MariusFauteux/EEG-PCB/README.md

# EEG acquisition PCB

Portable eight-channel EEG recorder built around the TI ADS1299, for long-term comparison of PEDOT:PSS and Ag/AgCl electrodes. It records to microSD whilst streaming over BLE to a Mac.

**Status (2026-11-09):** Rev C12: datasheet review of the signal path and REF/BIAS electrode impedance test links (JP9, JP10) added to Step 14: VBUS overvoltage protection drawn, and the 110 × 85 mm four-layer board placed with stack-up, rules, keep-outs and planes. The board is not routed (Step 15). It passes KiCad DRC apart from the expected unrouted connections and a short list of individually accepted warnings, and it matches the schematic exactly. There is no firmware and no physical test. The board is not released for fabrication or for connection to a person.

## Where to start

| If you want to… | Read |
|---|---|
| Understand the design and why it is built this way | [docs/project.md](docs/project.md) |
| See every decision, its status and what would reopen it | [docs/decision_log.md](docs/decision_log.md) |
| Check the detailed calculations and sources for one subsystem | [docs/reviews/](docs/reviews/) |
| Open the schematic or board | [hardware/EEG_RevC.kicad_pro](hardware/EEG_RevC.kicad_pro) in KiCad 10 or later, the SVGs in [hardware/preview/](hardware/preview/), or the placement plots [hardware/checks/pcb_placement_top.pdf](hardware/checks/pcb_placement_top.pdf) and [pcb_inner_planes.pdf](hardware/checks/pcb_inner_planes.pdf) |
| See the parts list and cost | [hardware/bom.csv](hardware/bom.csv), [hardware/bom_cost.csv](hardware/bom_cost.csv) and [hardware/checks/bom_cost.md](hardware/checks/bom_cost.md) |
| See the latest check results | [hardware/checks/validation.md](hardware/checks/validation.md) and [hardware/checks/pcb_report.md](hardware/checks/pcb_report.md) |

## Folder layout

```
README.md                    status, map and open items (this file)
requirements.txt             Python packages for the build and checks
docs/
  project.md                 design guide for the current revision
  decision_log.md            current register, next actions, chronological entries
  recording_format_v1.md     microSD record format specification
  reviews/                   one review per design step (historical records)
hardware/
  EEG_RevC.kicad_pro/.sch    KiCad project; all *.kicad_sch files are generated
  EEG_RevC.kicad_pcb/.kicad_dru  placed board and custom design rules (generated by scripts/pcb_place.py)
  EEG.kicad_sym, sym-lib-table   project symbol library (generated)
  EEG.pretty, fp-lib-table   project footprint library (generated from manufacturer drawings)
  bom.csv                    bill of materials with manufacturer, MPN and description (generated)
  bom_cost.csv               costed BOM for 5 prototype boards (generated)
  controller_pinmap.csv      NINA-B306 pin allocation (generated)
  rebuild.sh                 regenerate everything and run all checks
  scripts/                   schematic generator, part selection, footprint generator, sheet layout and grouping, netlist validation, footprint audit, corner review, BOM cost, input and reference, backfeed, BIAS loop, timing, power and OVP analysis, board placement and DRC summary
  baseline/                  inputs the generator imports, and earlier netlists it compares against
  checks/                    generated: netlist, ERC report, validation report, footprint audit, corner review, BOM cost, analysis output, DRC report, placement report and plots
  preview/                   generated: SVG render of every sheet
host/
  record_format.py           host-side reference codec and recovery scanner for the record format
  test_record_format.py      codec tests
  event_timing.py            EVENT schema validation, session clock fit, event-to-sample mapping
  test_event_timing.py       event timing tests
```

The schematic sheets are generated by `hardware/scripts/build.py`. Edits made by hand in the KiCad editor are overwritten on the next rebuild, so a schematic change belongs in the scripts. A final layout pass (`hardware/scripts/layout.py`) arranges every sheet into dashed frames, one per functional block, each with a title and a short purpose note, and points labels away from the parts. The groups and notes are defined in `hardware/scripts/layout_groups.py`; a new part must be added to a group there or the build fails.

## Rebuilding and checking

One-time setup from this folder:

```bash
python3 -m venv .venv && .venv/bin/pip install -r requirements.txt
```

Then regenerate the schematic, export the netlist, run ERC, render the previews, generate and check the board, and run every check:

```bash
hardware/rebuild.sh
```

The script finds `kicad-cli` on the PATH or in `/Applications/KiCad`; set `KICAD_CLI` to override. The board script needs KiCad's own Python with the `pcbnew` module; set `KICAD_PY` if it is not in the macOS application bundle. A full rebuild takes about four minutes, mostly the board DRC with its creepage check. The footprint audit uses the KiCad 10 stock footprint library (set `KICAD10_FOOTPRINT_DIR` if it is elsewhere). The current result is:

- 486 netlist assertions passing and zero ERC errors;
- the footprint audit passing for all 377 on-board parts;
- 17 of 17 OVP rules and 27 of 27 corner-review rules passing;
- all input, backfeed and power-analysis rules passing;
- 33 of 33 placement rules passing;
- board DRC with no errors, 0 schematic-parity differences, 499 unrouted connections and 30 accepted warnings;
- passing host tests. ERC reports no warnings once KiCad has a global footprint-library table. On a fresh KiCad installation without one, expect a few hundred "the current configuration does not include the footprint library …" warnings; KiCad offers to create the table on first launch of the GUI, and the warnings do not indicate a circuit fault.

## Design history

| Step | Revision | What changed | Review |
|---|---|---|---|
| 1–2 | Rev A, Rev B | Input network, ADS1299 core, battery regulators and supervision | [revB_engineering_review.md](docs/reviews/revB_engineering_review.md) |
| 1–3 (Rev C) | Architecture | Operating modes, NINA-B306 selection, USB-C charging architecture | [revC_architecture_steps1-3.md](docs/reviews/revC_architecture_steps1-3.md) |
| 4 | C1 | LT3045 analogue rail, TPS389001 supervisors, hardware reset gating | [step4_power_review.md](docs/reviews/step4_power_review.md) |
| 5 | C2 | Controller, SWD, USB-C data and CC detection, digital rail | [step5_controller_usb_review.md](docs/reviews/step5_controller_usb_review.md) |
| 6 | C3 | microSD, shutdown behaviour, recording format | [step6_storage_shutdown_review.md](docs/reviews/step6_storage_shutdown_review.md) |
| 7 | C4 | Electrode input protection and filtering | [step7_input_protection_review.md](docs/reviews/step7_input_protection_review.md) |
| 8 | C5 | BIAS loop compensation and output clamp | [step8_bias_review.md](docs/reviews/step8_bias_review.md) |
| 9 | C6 | External 2.048 MHz ADC clock, isolated trigger, photodiode front end, timestamp scheme | [step9_event_timing_review.md](docs/reviews/step9_event_timing_review.md) |
| 10 | C7 | Analogue rail 5.088 V (45.9 mV release margin), restart latch, Schmitt-input reset logic, power capacitor selection | [step10_power_review.md](docs/reviews/step10_power_review.md) |
| 11 | C8 | BQ25798 charger and power path, hardware input ceiling < 500 mA, ship FET soft-off and POWER button, pack connector with NTC, SYS hold-up | [step11_charger_review.md](docs/reviews/step11_charger_review.md) |
| 12 | C9 | OPA376 buffer for the shared REF electrode (coupling −37.3 dB → below −150 dB modelled; SRB1 rejected), self-biased clamp holding +5VA ≤ 1.3 V when off (was up to 6.9 V at 100 V between electrodes) | [step12_reference_backfeed_review.md](docs/reviews/step12_reference_backfeed_review.md) |
| 13 | C10 | Exact MPN for all 360 fitted parts (€188 per board in parts at 5 boards), five project footprints from manufacturer drawings and an automated pin-to-pad audit, shell pads fixed on USB-C and microSD, E96 values for RSET and two supervisor dividers, electrode harness connector J500, whole-netlist corner review | [step13_bom_footprint_review.md](docs/reviews/step13_bom_footprint_review.md) |
| 14 | C11 | VBUS overvoltage switch TPD1S514-1 (trips 5.90–5.99 V in 100 ns, 30 V rated) with a 5.0 V LDO for the module VBUS pad. Board 110 × 85 mm one-sided on the JLC04161H-3313 stack-up, JLCPCB rules and netclasses, antenna and 8 mm trigger keep-outs, planes. All 375 parts placed by a generated script; DRC clean apart from unrouted nets | [step14_ovp_placement_review.md](docs/reviews/step14_ovp_placement_review.md) |
| 14a | C12 | Pin-by-pin datasheet review of the ADS1299, OPA376 and TPD2E2U06 (all pass; LT3045 still unread). JP9 and JP10 let the REF and BIAS electrodes be measured by the ADS1299 lead-off sources through CH8−/CH7− | [revC12_datasheet_impedance_review.md](docs/reviews/revC12_datasheet_impedance_review.md) |
| 15 | (next) | Routing: freeze placement, 90 Ω USB pair, plane vias, converter loops, assembly outputs | |

The reviews are kept as written at each step. They refer to file names used at the time (for example `build_step7.py`, `EEG_RevC_Step7.kicad_sch` and the per-step zip packages). Those names now correspond to `build.py`, `EEG_RevC.kicad_sch` and this folder.

## Open items and release gates

Nothing below has been closed by measurement. The Rev B review findings R01–R12 remain formally open; most are now addressed in the schematic but await physical evidence.

| # | Item | Notes |
|---:|---|---|
| 1 | BIAS loop bench validation | Step 8 compensation is model-based (≥ 47° modelled margin); measure step response, mains rejection and saturation recovery with an electrode simulator. RB1/RB2 and the electrode resistors are ERJ-PB6B thick film (150 V element voltage, Step 13); ESD and surge capability still to be tested |
| 2 | Power and supervision bench validation | Step 10 closed the Step 4 review by calculation: confirm VOUT over temperature, supervisor thresholds, pack-disconnect sequence and the restart latch under battery rebound; DC-bias curves read in Step 13 (C203 + C204 26 µF worst case); capacitance over temperature still to measure |
| 3 | Charger and pack qualification | Step 11 drew the BQ25798 path; pack (2S, protected, 10k 103AT NTC) not chosen; VQFN-HR footprint drawn from TI's land pattern (Step 13, check 1:1 before release); check ship-mode leakage and charging thermals on the bench |
| 4 | Event timing bench validation | Step 9 is datasheet-based: calibrate ADC group delay (assumed 1.5 samples) and input latencies by loopback; confirm the proposed timing targets T1–T3; J600/J601 connectors chosen provisionally (Step 13); trigger isolation adequacy for participant use not assessed |
| 5 | Shared-REF channel coupling | Step 12 buffered REF (D46): modelled coupling below −150 dB. Measure crosstalk, buffer noise and REF lead-off behaviour with an electrode emulator |
| 6 | Powered-off backfeed | Step 12 clamp Q201 (D47): AVDD ≤ 1.3 V modelled up to 100 V between electrodes. Inject in ship mode and with the rail disabled; YJC footprint drawn (Step 13); re-read the LT3045 reverse-current data |
| 7 | Mechanical service interlock | Prevent USB insertion with the electrode harness attached; not designed |
| 8 | BOM and footprints | Closed at design level (Step 13, extended in Step 14): 393 references, 368 fitted with exact MPNs, 0 without footprint; 6 project footprints. Still needed: 1:1 or part comparison of the project footprints (including the 0.4 mm WCSP of U323), estimated heights, and the 4 % of the cost not yet confirmed; C324's MPN is on backorder at DigiKey (in-stock KEMET alternative named in the Step 14 review) |
| 9 | microSD shell pads in KiCad 10 | Closed (Step 13): symbol pin renamed `SH`; the same fault on the USB-C connector was found and fixed |
| 10 | Firmware | No MCU acquisition, BLE or SD firmware; host codec only. Firmware must set BIASREF_INT = 1 when enabling the BIAS amplifier (Step 8) and implement the TIMER3/GPIOTE/PPI capture scheme and EVENT records (Step 9). Restart needs a fresh RUN_REQUEST rising edge, and the last 5 samples before a supervisor stop are invalid (Step 10). Charger: raise IINDPM only after reading the TUSB320 advertisement, set charge and JEITA limits, handle the watchdog, enter ship mode for soft-off (Step 11). Fit JP 2–3 for referential channels with SRB1/SRB2 off, detect REF lead-off from all referential channels drifting together, and wait 1 s after an analogue stop before re-arming (Step 12). Impedance: AC lead-off at 7.8 or 31.2 Hz with 6 or 24 nA, excited channel removed from BIAS_SENS, series resistance subtracted (Rev C12). Run the power I²C bus at 100 kHz unless the layout keeps it below ≈ 70 pF (Step 13) |
| 11 | Routing, prototype and qualification | Board placed (Step 14); routing next (Step 15) under the rules in the Step 14 review, section 8. Then noise, leakage, ESD, endurance, power-loss and safety testing |
| 12 | VBUS overvoltage | Closed at design level (Step 14, D57): TPD1S514-1 limits USB_5V to 6.15 V worst case. Still needed: bench overvoltage and hot-plug test; WCSP assembly check; firmware keeps EN_OTG = 0 |
| 13 | Board area and pack position | Closed (Step 14, D56): 110 × 85 mm, one-sided, courtyards 51 %; pack beside the board on J401. Enclosure still to design |
