MariusFauteux/EEG-PCB/docs/decision_log.md

# EEG PCB decision log

Last updated: 2026-11-08 • Documentation revision 14 • Current schematic and board: Rev C11 (Step 14)

This is the engineering decision record: decisions, supporting rationale, tradeoffs, evidence and conditions for revisiting them. It is maintained alongside [project.md](project.md), which describes the design as it stands. The [README](../README.md) carries the current status and open release gates. Detailed calculations and sources for each step are in [reviews/](reviews/).

## How to maintain this record

At each design milestone, read this log and project.md before changing the project. Update both in the same revision as the affected schematic, firmware or analysis, and rerun `hardware/rebuild.sh`. Give every new decision the next free D number, add it to the current register below and append its detailed entry at the end of the chronological section. Preserve superseded decisions with a replacement reference rather than rewriting historical conclusions. Record measured results separately from calculations. A new component, battery architecture, channel count, safety boundary or acquisition format warrants a new decision entry.

Status meanings: **requirement** = agreed user target; **implemented** = drawn in the current schematic, not physically validated; **provisional** = working choice awaiting evidence; **planned** = selected but not drawn; **open** = undecided; **superseded** = replaced; **policy** = review or documentation rule.

## Current direction

Finish a reliable battery-operated eight-channel acquisition system for long-term electrode research. Rev C6 integrates the ADC with an external clock, protected electrode inputs, a compensated BIAS loop, isolated trigger and photodiode inputs, power and supervision, controller, USB-C, SWD and microSD at schematic level. The deferred Step 4 power review is closed at calculation level (Step 10) the BQ25798 charger, power path and soft-off are drawn (Step 11), the shared REF is buffered and the analogue rail clamped against powered-off backfeed (Step 12), every fitted part has an exact MPN and an audited footprint (Step 13), and VBUS has an overvoltage switch while the 110 × 85 mm four-layer board is placed but not routed (Step 14). Next route the board. Reliability and signal integrity take priority over size or cost.

## Current register

One line per decision, with its status in Rev C12. The detailed entry for each is in the chronological section below.

| ID | Status in Rev C12 | Decision | Superseded by / next evidence |
|---|---|---|---|
| D01 | Requirement | 8 differential channels, 24 bit, 1 kS/s, 0.1–100 Hz analysis band | Revisit only with changed experimental requirement |
| D02 | Implemented | ADS1299IPAGR as the ADC | Measured noise, offset and timing |
| D03 | Implemented, revised | Per-channel bipolar or shared-REF jumper; internal SRB switches off. Shared REF now buffered (D46) | Bench crosstalk test (D46) |
| D04 | Superseded | 2 × 47 kΩ per leg and 220 pF differential | D33 |
| D05 | Implemented | DC-coupled acquisition, digital high-pass, initial gain 12 | Measured electrode offsets and common-mode margin |
| D06 | Partly superseded | Internal 4.5 V reference and internal oscillator | Reference retained; clock replaced by D35 |
| D07 | Superseded (series resistors kept) | BIAS: 1 MΩ ∥ 1.5 nF feedback, 2 × 499 kΩ output | D34 |
| D08 | Superseded (pack kept) | Protected 2S pack, external charging | D23 onboard charging; 2S pack retained |
| D09 | Superseded | TPS7A4901 analogue LDO at 5.086 V | Step 4: LT3045 at 5.050 V |
| D10 | Implemented, revised | TPS62162 3.3 V digital buck | D28: fed from SYS; recheck around BQ25798 |
| D11 | Superseded | TPS3700 UVLO and power-good supervision | Step 4: TPS389001 supervisors |
| D12 | Refined | nRF52840 BLE plus microSD, 24 h simultaneous | D22/D24 module, D29 storage |
| D13 | Provisional | 232-byte BLE packet, 29 kB/s | Peripheral firmware and Mac throughput test |
| D14 | Implemented | Isolated trigger and photodiode timing | D36, D37 |
| D15 | Requirement, revised | 4-layer board, €500 budget, 30 mm height; size now 110 × 85 mm one-sided (D56) | Enclosure design; assembled cost |
| D16 | Requirement | Barebones software; documented binary data, BrainVision/CSV export | Host codec exists; exporters not written |
| D17 | Policy | Keep editable sources, renders, BOM, checks and rationale together | Implemented by `hardware/rebuild.sh` |
| D18 | Policy | Release gates: no fabrication or human use until gates close | See README open items |
| D19 | Implemented | SWD programming and recovery, USB updates after bootloader | Hardware via D24; firmware open |
| D20 | Superseded | Reopen charging scope | D23 |
| D21 | Implemented in part | Record on battery only; service with electrodes disconnected | Mechanical interlock not designed |
| D22 | Implemented | NINA-B306-00B; separate ADC and SD SPI | Land pattern drawn (D51); compare with a module or EVK Gerbers |
| D23 | Implemented | 5 V USB-C sink, TUSB320LAI, BQ25798, 0.5 A at 8.4 V | D42–D45; pack choice and bench charge tests |
| Step 4 | Implemented, review closed by calculation (D38–D41) | LT3045, TPS389001 supervisors, AND-gated reset | Bench validation of D38–D41 |
| D24 | Implemented | Integrate module, SWD and USB pins | Footprint audited (D51); firmware |
| D25 | Implemented | Gate ADC control outputs until power valid | Partial-power behaviour measurement |
| D26 | Implemented | USB-C connector and CC detection before charger | VBUS overvoltage switch added (D57) |
| D27 | Implemented | SERVICE_OK hardware inhibit | Not isolation; interlock unfinished |
| D28 | Superseded in part | 3.3 V from SYS kept; J400 bench input removed | D42 |
| D29 | Implemented | microSD on dedicated SPI (DM3AT socket) | Card MPN qualification; shell pads resolved (D51) |
| D30 | Implemented | Card on shared 3.3 V rail, no load switch | Standby and recovery measurement |
| D31 | Policy | Low-battery shutdown is best effort | Repeated real power cuts |
| D32 | Implemented (host side) | Recoverable 4096-byte records with CRC32 | MCU firmware; 24 h run |
| D33 | Implemented | Input protection: 94 kΩ → TPD2E2U06 → 4.7 kΩ; 220 pF C0G kept. Also used in front of the REF buffer (D46) | ERJ-PB6B parts chosen (D48); leakage, ESD and surge tests |
| D34 | Implemented, provisional | BIAS lead-lag compensation 1 MΩ ∥ (100 kΩ + 10 nF); TPD2E2U06 at RB1/RB2 midpoint; BIASREF_INT = 1 required | Bench step response and mains rejection; RB1/RB2 ERJ-PB6B (D48); rerun model for buffered REF (D46) |
| D35 | Implemented | External 2.048 MHz ±20 ppm ADC clock (SiT8008, Y340); CLKSEL low | 24 h rate log against a reference; ordering code confirmed active (Step 13) |
| D36 | Implemented, provisional | TLP2761 optically isolated trigger; TIA + comparator + I²C DAC photodiode front end | Loopback latency calibration; connector parts; isolation adequacy review |
| D37 | Requirement on firmware | One 16 MHz timer (TIMER3, extended by TIMER4) captures DRDY, trigger and photodiode via GPIOTE/PPI; EVENT schema `event/1` | Firmware implementation; group-delay calibration |
| D38 | Implemented, values revised | Analogue rail 5.088 V (RSET 50.5 kΩ + 383 Ω): 45.9 mV release margin, 47.6 mV below 5.25 V | D49: 49.9 kΩ + 1.00 kΩ, 5.090 V; VOUT over temperature |
| D39 | Implemented, provisional | Collapse: SYS_OK path resets ADC in regulation; ANALOG_OK backstop; last 5 samples invalid | SYS hold-up sized at charger step; pack-disconnect captures |
| D40 | Implemented | Persistent restart latch U226–U228; fault clears RUN_ARMED, restart needs new RUN_REQUEST edge | Rebound test with RUN_REQUEST held high |
| D41 | Implemented | Schmitt-input SN74AUP1G08 gates, 4.7 kΩ pull-ups; power capacitors selected (1210 25 V output, C0G delays) | DC-bias curves read (Step 13); node capacitance ≤ 30 pF in layout |
| D42 | Implemented | BQ25798 single-input (VBUS-only), 2S at 1.5 MHz, D+/D- unconnected, PACK_POS = charger BAT node | VQFN-HR footprint drawn (D51); bench charge cycle |
| D43 | Implemented | ILIM_HIZ hardware input ceiling 0.28–0.46 A; CE disabled unless MCU drives CHARGE_REQUEST | Input current on a 500 mA port |
| D44 | Implemented | CSD17571Q2 ship FET for soft-off; POWER button on QON with BAT54 sense to pad 37 | Ship-mode leakage, wake and 10 s reset |
| D45 | Implemented, provisional | SYS 5 × 22 µF + 100 µF OS-CON (≈ 124 µF effective est.); VBUS bulk now 2 × 10 µF behind the OVP soft start (D57) | DC bias read: 125 µF worst case (Step 13); pack-disconnect captures |
| D46 | Implemented | Buffered shared REF: REF electrode → 2 × 47 kΩ → TPD2E2U06 → 4.7 kΩ → OPA376 follower → JP pin 3; per-channel networks kept; SRB1 not used | Bench crosstalk, noise and REF lead-off tests |
| D47 | Implemented, provisional | +5VA backfeed clamp: CSD17381F4 self-biased from +5VA, 100 Ω drain, released by ANA_ENABLE; firmware waits 1 s before re-arming | YJC footprint drawn (D51); injection test in ship mode; LT3045 reverse data |
| D48 | Implemented | Exact BOM from a few series: Panasonic ERJ-3EKF/ERJ-8ENF (1 %), ERA-3ARB (0.1 %, 10 ppm/K), ERJ-PB6B (0.1 %, 150 V, electrode, REF and BIAS paths); Murata GCM and GRM 25 V; no NRND parts | Price and stock at order time; ESD and surge tests of ERJ-PB6B |
| D49 | Implemented | E96 values where E192 or non-standard values were not orderable: RSET 49.9 kΩ + 1.00 kΩ (5.090 V), ANALOG_OK 31.6 kΩ / 9.88 kΩ, PACK_OK 44.2 kΩ (6.233 V) | Same bench tests as D38 |
| D50 | Implemented | All 10 µF are 1206 25 V and all 22 µF 1210 25 V X7R; effective values from Murata DC-bias curves | Capacitance over temperature on the bench |
| D51 | Implemented | Generated project footprint library (BQ25798 RQM, TUSB320 RWB, CSD17381F4 YJC, CSD17571Q2 DQK, NINA-B306) and an automated pin-to-pad audit; shell pins renamed SH | 1:1 print or part comparison; NINA against a module |
| D52 | Implemented, provisional | Electrode harness connector J500 (keyed 2 × 10 box header, no GND or supply pins); electrode symbols off-board | Harness design; mechanical interlock (D21) |
| D53 | Implemented, provisional | J600 BNC (shell = isolated return), J301/J601 JST PH, J300 SMD SWD header, TL3342 buttons | Mechanical drawings; 8 mm isolation in layout |
| D54 | Closed by D57 | VBUS overvoltage protection: nothing but the charger stopped at > 5.5 V | D57 |
| D55 | Closed by D56 | Board area and pack position: courtyards filled 68 % of one 100 × 70 mm side; pack beside the board | D56 |
| D56 | Implemented | Board 110 × 85 mm, all parts on top, four layers JLC04161H-3313 1.6 mm (signal / GND / power / signal), ENIG, M3 holes at the corners; pack beside the board | Enclosure; 1:1 fit check |
| D57 | Implemented, provisional | VBUS OVP: TPD1S514-1 (5.90–5.99 V, 100 ns, 30 V) between J310 and USB_5V, EN tied low; VBUS_POWER feeds USB sense; TPS7A2050 5.0 V for module VBUS with BAT54 reverse bypass; second 10 µF on VBUS | Bench overvoltage and hot-plug test; WCSP assembly |
| D58 | Implemented, provisional | Floor plan: analogue left (J500 left edge), isolated trigger and microSD top edge, module centred on right edge, USB-C/charger/pack bottom right; In1 GND continuous, In2 +5VA/+3V3/SYS islands in GND | Routing (Step 15); noise and RF tests |
| D59 | Implemented | Design rules and netclasses from JLCPCB multilayer capabilities; 8 mm clearance and creepage rule for the trigger; 90 Ω USB pair (0.15/0.18 mm, estimate) | Confirm impedance with the JLCPCB calculator |
| D60 | Implemented, interim | Board generated by `pcb_place.py` from the netlist (placement, rules, zones), DRC and placement rules in `rebuild.sh`; schematic UUIDs stable | Freeze placement before routing |
| D61 | Implemented, provisional | Electrode impedance test links: JP9 puts the REF electrode on CH8−, JP10 the BIAS electrode on CH7−, each through that channel's own 94 kΩ network; normally open | Bench impedance procedure against an electrode simulator |

The Step 4 decisions were recorded without a D number and are listed by step name.

## Next actions

| Priority | Work | Evidence needed before closing |
|---:|---|---|
| 1 | Route the board (Step 15) | Placement frozen against regeneration (D60); 90 Ω width from the JLCPCB calculator; routing rules in the Step 14 review section 8; DRC with no unrouted nets; 1:1 footprint checks (D51), assembly outputs (Gerbers, drill, position, BOM) |
| 2 | Validate power, supervision and charging on the bench | VOUT over temperature, thresholds, pack-disconnect sequence, restart latch under rebound (D38–D41); charge cycle, input ceiling, ship mode (D42–D45); backfeed clamp and discharge (D47) |
| 2a | Choose the pack and connector | Protected 2S Li-ion with 10k 103AT NTC; charge temperature limits for JEITA settings |
| 3 | Design the mechanical service interlock | Prevent USB insertion with the electrode harness attached |
| 4 | Prototype | Order (`hardware/bom_cost.csv`, confirm estimated prices), assembly, bench bring-up |
| 5 | Qualify acquisition performance | Noise, offset and load tests; REF crosstalk, buffer noise and REF lead-off (D46); BIAS step response and mains rejection; event timing loopback calibration and 24 h clock log; 24 h local plus BLE endurance; power-loss recovery |

## Entry template

### Dxx: descriptive title

- Date and affected revision:
- Status and requirement addressed:
- Decision:
- Concise rationale and evidence:
- Alternatives and material tradeoffs:
- Assumptions and unresolved risks:
- Validation needed / result:
- Revisit trigger:
- Replaces / replaced by:

## Chronological entries

The entries below are preserved as written at each milestone. Where they describe the hardware as it was at that time (for example "drawn in Rev B"), the current register above takes precedence.

### Rev B decision register (D01–D17)

| ID | Status | Decision and rationale | Tradeoff / revisit condition |
|---|---|---|---|
| D01 | Requirement | Eight simultaneous differential channels, 24-bit acquisition at 1 kS/s; 0.1–100 Hz analysis band. Supports electrode comparisons and event-related recordings on a common timebase. | Data rate and energy exceed a slower, fewer-channel system. Revisit only with a changed experimental requirement. |
| D02 | Implemented | ADS1299IPAGR combines simultaneous conversion, programmable gain, reference and BIAS functions. | Integrated features still require correct routing, firmware and characterization. Revisit if measured noise, offsets or timing fail requirements. |
| D03 | Implemented | Independent physical bipolar/shared-REF selection for each negative input; internal SRB switches remain off. | Requires careful jumper configuration. This preserves mixed montages without relying on an all-channel reference switch. Revisit for electronically selectable montages. |
| D04 | Provisional | Two 47 kΩ resistors per input leg and a 220 pF differential capacitor. Provides series impedance and differential filtering. | Approximately 0.558 µV RMS resistor noise over 0.1–100 Hz; electrode impedance changes the filter. This is not finalized transient protection. Select final values after noise, leakage and fault analysis. |
| D05 | Implemented | DC-coupled acquisition; analysis high-pass performed digitally. Retains raw slow changes for research. Initial gain target 12. | Electrode DC offset can saturate the hardware before filtering. Validate offset/common-mode margins; lower gain if necessary. |
| D06 | Provisional | Internal 4.5 V ADC reference and internal oscillator for the first implementation. | Reduces parts but does not provide a calibrated sample clock. Measure drift and reference settling; consider an external clock if ERP timing requires it. |
| D07 | Provisional | BIAS feedback 1 MΩ parallel with 1.5 nF, with two 499 kΩ output resistors. | Electrode/cable loading affects loop stability. Verify on a simulator; resistor values alone do not establish participant safety. |
| D08 | Provisional, implemented | Removable protected 2S battery, external charging; analog LDO and separate digital buck converter. | This is a design assumption introduced in Rev B, not a separately confirmed battery purchase. It gives LDO headroom but adds pack size, diode loss and cutoff constraints. Revisit after energy/fit measurements. |
| D09 | Implemented | TPS7A4901 analog supply: 79.0 kΩ / 24.0 kΩ divider, approximately 5.086 V nominal. | Calculated static corners approximately 4.951–5.221 V; transient headroom still needs measurement. Revisit for overshoot, noise or monitor-threshold problems. |
| D10 | Implemented | TPS62162 fixed 3.3 V digital converter. Reserve a preliminary 500 mA peak board-load budget. | Buck switching and SD current bursts may contaminate EEG. Exact module/card load and compensation behavior remain unverified. |
| D11 | Implemented | TPS3700 supervision: UVLO with added hysteresis, early battery warning and separate analog-power-good. | Nominal thresholds are not qualified limits. Warning voltage does not guarantee enough time to commit a file. Test pack rebound and abrupt disconnects. |
| D12 | Requirement / planned | nRF52840 BLE module plus microSD; simultaneous local recording and streaming for 24 h. | Exact module, antenna clearance and SD device are open. Local recording must not depend on BLE keeping up. |
| D13 | Provisional | Packet proposal: 16-byte header plus eight 27-byte ADC frames = 232 bytes. At 1 kS/s, 29 kB/s. | Requires adequate negotiated notification size and sustained Mac throughput. Receiver parser tested; radio and matching peripheral firmware untested. |
| D14 | Requirement / planned | Isolated trigger input and photodiode timing, primarily for visual ERP. | A software stimulus timestamp does not identify actual screen onset. Barrier parts, latency calibration and event encoding remain open. |
| D15 | Requirement / planned | Four-layer KiCad board, approximate 100 × 70 × 30 mm enclosure; €500 includes VAT, assembly, enclosure and storage, excludes batteries/shipping. | Stack-up, fit, prices and full assembled BOM have not been validated. |
| D16 | Requirement | Barebones setup/test software first; documented binary data with BrainVision/CSV export. | Recording integrity, counters and recovery take precedence over a polished interface. Exporters remain unimplemented. |
| D17 | Implemented documentation policy | Preserve editable native schematics, PDF, BOM, checks and human-readable rationale together. | ERC is evidence of schematic consistency, not proof of correct electronics or safety. |

### Rev B corrections and superseded assumptions

- Rev A was an external analog network. Rev B connects it to the physical ADS1299 pins and battery regulators. Do not describe Rev B as an ADC-free circuit.
- Preliminary analog-rail arithmetic using a 1.194 V figure was replaced by the selected regulator's 1.185 V feedback value. The final divider is **79.0 kΩ / 24.0 kΩ** and nominal output **5.085625 V**. Earlier draft values are not the released Rev B BOM.
- The initial narrow-hysteresis UVLO candidate was replaced by external positive feedback. Current nominal VIN_SYS thresholds are **6.749 V on / 6.212 V off**. These are after the series diode, not battery-terminal thresholds.
- Raw divided battery monitoring at the host was replaced by a 3.3 V-pulled comparator output to avoid placing a battery-derived voltage on an unpowered host ADC input.
- Unused SRB1/2 pins are left open in Rev B, with their switches disabled. BIASIN and unused external BIASREF are grounded.

### Evidence at Rev B

Rev B reports zero KiCad 9.0.2 ERC errors/warnings without exclusions. Exported-netlist tests cover all 64 ADC pin identities and key input, BIAS, decoupling, host, regulator and supervisor connections. Assigned footprints exist; IC pad coverage was checked. The PDF was visually reviewed. BLE packet-parser tests pass.

There is no physical noise, stability, BLE throughput, power, endurance or safety measurement, and no circuit simulation. There is no PCB layout. These limits must remain visible when reporting progress.

### Next decisions at Rev B (historical; see Next actions above)

| Priority | Work | Evidence needed before closing |
|---:|---|---|
| 1 | Choose exact nRF52840 module and SD implementation | Pin allocation, antenna/layout requirements, supply peaks and supported data path |
| 2 | Exercise synthetic BLE traffic on the M2 Mac | Sustained throughput, counters, disconnect behavior; repeat with SD writes |
| 3 | Design isolated trigger and photodiode input | Barrier specification, timing path and measured/calibrated latency plan |
| 4 | Finalize electrode protection and connectors | Leakage/noise/capacitance assessment, fault paths, physical connector selection |
| 5 | Review complete schematic and procurement | Exact BOM, footprint dimensional audit, corner/transient review, cost and mechanical envelope |
| 6 | Layout and prototype | Return-current/antenna review, DRC, assembly outputs, bench bring-up results |
| 7 | Qualify acquisition performance | Noise/offset/load tests, event timing, 24h local+BLE endurance and power-loss recovery |

### Rev B change history

- 2026-11-08: Created the decision register from the delivered Rev A/Rev B design and agreed project targets. No hardware changes in this documentation update.

### Review update, 2026-11-08 (D18–D20)

The [Rev B engineering review](reviews/revB_engineering_review.md) supersedes any interpretation that ERC success establishes fabrication readiness. Hardware is unchanged. Findings R01–R12 remain open.

#### D18: Release gates after critical desk review

- Status: adopted review policy; Rev B remains a subsystem draft.
- Decision: hold fabrication pending complete system integration, analog-supply margin/reverse-discharge resolution, protection review and a complete BOM/footprint audit. Human-connected use additionally requires system safety qualification.
- Evidence: repeated ERC returned zero violations and existing netlist assertions passed; no physical validation exists. Approximate analog high corner is 5.2208 V versus the ADC's 5.25 V operating maximum. U2's OUT−IN absolute maximum is +0.3 V, not guaranteed by the generic D201 choice.
- Closure: address review R01–R12 with design evidence and measured results where required. Existing D17 remains applicable.

#### D19: Programming and USB service architecture

- Status: proposed next revision, not implemented.
- Direction: select the nRF52840 module; add SWD/reset/target-voltage access and a recovery mechanism. Initial programming uses SWD; USB updates require installed bootloader firmware. USB-C is also a candidate configuration interface.
- Rationale: native USB does not remove initial programming and recovery needs. J100 is ADC SPI/control, not USB or SWD.
- Boundary: service/USB/debug with electrodes disconnected unless a separately qualified isolation architecture is developed. Firmware acquisition disable is not galvanic isolation.

#### D20: Reopen charging scope

- Status: open; The existing external-charging baseline remains the drawn hardware.
- Direction: evaluate onboard USB-C charging for a protected 2S pack using a compatible buck-boost charger and source-current detection; PD is optional for higher-power operation. No charger IC or pack has been selected.
- Rationale: the user asked whether USB-C charging is supported. It is absent, and a 5 V connector cannot directly charge an 8.4 V pack. Add temperature sensing, charge control, power-path management and independent cell protection/balancing provisions.
- Tradeoff: more components, heat, switching noise and qualification; a 1S alternative would require redesign of the analog supply. Revisit connector, switch, enclosure, power budget and acquisition/charging operating modes together.

Change history addition: 2026-11-08 — recorded external-style review, release blockers and proposed programming/charging direction. No hardware revision or validation status was advanced.

### D21–D23: Rev C architecture selection, 2026-11-08

Status: selected for implementation; Rev B unchanged. See RevC_Architecture_Steps1-3.md and controller_pinmap.csv.

- D21: Battery recording with all conductive service cables absent; USB charging/configuration and SWD require all electrodes disconnected. Prefer a mechanical service/electrode interlock. Hardware acquisition inhibit is supplemental, not isolation.
- D22: Select NINA-B306-00B. Reserve separate ADC and SD SPI controllers, native USB, SWD recovery and hardware event capture. Manufacturer Table 7 checked for 33 unique GPIO assignments; fast clocks avoid radio-sensitive pads. This refines D12 and D19.
- D23: Select 5 V-only USB-C sink using TUSB320LAI plus BQ25798 and protected 2S pack. Initial charge target 0.5 A at 8.4 V subject to source, pack and temperature limits. No PD/OTG. SYS supplies board loads; charger remains available with recording off. This replaces D20's open architecture choice and D08's external-charging direction for future Rev C, not the existing Rev B circuit. Exact pack/connector and bootstrap/current-limit implementation remain open.
- Evidence: u-blox UBX-17052099 R15; TI SLUSDV2C and SLLSEQ8D retrieved online. Source links, power estimates and remaining implementation gates are in the architecture document.
- User requirement: confirm future component parameters using online manufacturer documentation whenever available; explicitly label unverified assumptions.
- Validation: pin allocation uniqueness checked; no new electrical test or schematic change. Review R01–R12 remains open.

### Step 4: power and supervision, 2026-11-08

A standalone C1 power/supervision replacement module is now drawn, not yet merged into Rev B. See Step4_Power_Review.md in EEG_RevC_Step4_Power.zip. Select LT3045IDD#PBF at 5.050 V and TPS389001DSET voltage supervisors, with hardware AND-gated ADC reset and analog enable. Calculated rail envelope 4.937–5.163 V; nominal pack warning 6.6125 V and analog inhibit 6.1985 V. These supersede D09/D11 for the proposed Rev C circuit, not the preserved Rev B files.

Online manufacturer limits were checked, including full-temperature accuracy and leakage. ERC and selected netlist/static checks pass. Narrow supervisor-release margin, dynamic collapse behavior, restart latching, capacitor/footprint selection, charger/MCU integration and bench testing remain open. D10 digital regulator integration must be revisited around charger SYS. BAT_WARN_OK polarity differs from the former BAT_OK_N; firmware must change. No finding is declared physically verified.

### D24–D28: Step 5 integration, 2026-11-08

Status: drawn and checked at schematic level. Earlier decisions remain historical unless superseded below. Step 4 revisions are deferred at the user's explicit request; acceptance for continuation is not electrical closure.

- **D24 — Integrate controller and debug.** Use NINA-B306-00B with VCC/VCC_IO at 3.3 V, dedicated USB pins and J300 SWD/reset access. Initial programming uses SWD; USB bootloader availability is not assumed. This implements the hardware portion of D19/D22. Manufacturer Table 7 was checked; 35 unique GPIO allocations now include SYS_OK/PACK_OK. The B306 land pattern and antenna keepout remain to be audited; EGP/EAGP are symbolic ground groups.
- **D25 — Gate outgoing ADC controls.** Five SN74LVC1G126 buffers require ANALOG_OK AND DIGITAL_OK AND ANA_ENABLE. ADC-side pulldowns establish low defaults when disabled. Series resistors are provisional damping values, not level shifting. This reduces unintended startup drive; partial-power behavior and timing still require measurement. DOUT/DRDY return directly through series resistors on the shared digital supply domain.
- **D26 — Implement USB connector and source detection before charger.** USB4105-GF-A, TUSB320LAI sink mode, 887 kΩ VBUS detection resistor, TPD2E2U06 ESD arrays and dedicated MCU USB wiring are drawn. CC sink terminations are internal; no duplicate external Rd. The arrays do not provide sustained DC overvoltage/current protection. D23 charger selection remains unchanged but unimplemented. USB VBUS has no connection to SYS or the pack.
- **D27 — Supplement the service boundary with hardware gating.** SERVICE_OK requires USB absent, compatible SWD adapter absent and interlock closed. This feeds the existing Step 4 inhibit. An unpowered USB cable or incompatible probe can escape detection, so physical electrode disconnection remains necessary. No galvanic isolation or persistent fault/restart latch is claimed. The mechanical interlock is unfinished.
- **D28 — Make the power boundary explicit.** Restore the fixed 3.3 V TPS62162 digital converter from SYS and expose a bench-only SYS/PACK-sense/GND header until BQ25798 integration. The converter is enabled from SYS; complete system shutdown is not implemented. USB alone cannot power the board VCC. This is an integration boundary, not a final battery connector or charge solution.

Evidence: KiCad 9.0.2 ERC has zero errors/warnings; 100 exported-netlist checks pass; new sheet renders inspected. The checks validate intended connections, not noise, USB compliance, firmware or safety. Online primary references and exact limitations are in Step5_Controller_USB_Review.md. No bench tests performed.

Release constraints: Step 4 static-release margin, dynamics, restart latching and capacitor qualification remain open. Complete charger/SD/event circuits, protection review, firmware and physical validation are still required. BOM has 256 references, 32 missing footprints and 224 missing exact MPNs; assigned footprints also need audit. Do not close R01–R12 solely from this milestone.

### D29–D32: Step 6 storage and shutdown, 2026-11-08

Status: schematic and requirements implemented; physical qualification and MCU firmware open. See Step6_Storage_Shutdown_Review.md and Recording_Format_v1.md. The original Step 6 scope is storage and shutdown; Step 7 remains input protection/filtering.

- **D29 — Add microSD on dedicated SPI.** Select DM3AT-SF-PEJM5 socket, four 33 Ω series resistors, five 10 kΩ CMD/DAT pull-ups, local bypassing, ESD and card detection. Verify the manufacturer's contact state visually: open absent, closed inserted. Keep the existing MCU pin allocation. Remove R305/R384–R387 placeholders so they cannot conflict with card defaults. A 16 GB Swissbit S-56u is a card qualification candidate, not an approved exact MPN.
- **D30 — Keep card and MCU on the shared digital rail.** No optional load switch in C3; SD_POWER_EN is reserved. This avoids an independently unpowered card I/O domain but costs standby current and software power-cycle capability. Card handling requires power off and electrodes disconnected. Revisit if measured standby power or recovery requirements justify adding an isolated/sequenced switch. Allocate card peak 350 mA and total digital peak 480 mA pending actual measurements/specification.
- **D31 — Treat low-battery shutdown as best effort.** Existing BAT_WARN_OK initiates capture stop and queue draining. No guaranteed minimum flush interval is available; arbitrary disconnect gives 0 ms. Shared digital power remains available after analog inhibit while its source remains valid. Do not mistake decoupling for energy reserve or POWER_HOLD for a connected power latch. Full soft-off and Step 4 hardware restart latching remain open.
- **D32 — Make records independently recoverable.** Use 4096-byte records, 148 frames per full DATA record, session UUID, sample indices, sequences and CRC32. Preallocate fixed-length 1 GiB FAT32 files before capture; recover without relying on a final END record. Reference codec/scanner and synthetic corruption tests are supplied. Filesystem/card mapping failures can still destroy earlier data, so no durability or finite loss bound is claimed. Preserve gap reports with recovered raw frames.

Evidence: online Hirose, Swissbit, TI, Espressif and FatFs author documentation checked; links and assumptions in the review. KiCad ERC zero errors/warnings, 147 assertions passed; all retained Step 5 pin-net assignments preserved. Eight format tests passed, including exhaustive byte-position corruption and record truncation checks. No physical write/current/power-cut/endurance tests or MCU firmware execution performed.

Revisit/closure: qualify exact card MPN/firmware/current and stall behavior; prove RAM scheduling with BLE; measure rail transients and EEG noise; perform repeated real power cuts and a 24 h run. Review experimental tolerance for missing data. Step 4 revisions are still deferred at the user's request. R01/R06/R09 gain implemented storage connections and explicit requirements but are not closed by this desk validation.

### D33: Step 7 input protection (Rev C4), 2026-11-08

**Decision:** retain two 47 kΩ per input leg; add TPD2E2U06DCKR after them and 4.7 kΩ between the clamp and ADC. Retain 220 pF differential capacitors, explicitly C0G 5% 50 V. Keep selectable local-negative/shared REF topology and unchanged BIAS network. Split input drawings into two four-channel sheets and a reference/BIAS sheet.

**Rationale and alternatives:** protection leakage matters at EEG amplitudes. TI specifies 10 nA maximum at 2.5 V; the considered Nexperia alternative's 1 nA headline is typical, with 100 nA maximum at a different 5 V test point. Neither should be treated as leakage-free or guaranteed at every operating bias. The extra resistor increases resistor noise by 2.47% but limits internal ADC clamp current. A 470 pF capacitor was evaluated and rejected because it worsens modeled shared-reference coupling; 220 pF remains provisional pending electrode/cable measurements.

**Evidence:** primary manufacturer datasheets linked in Step7_Input_Protection_Review.md. Reproducible linear estimates in analyze_inputs.py/input_analysis.json. Zero KiCad ERC violations; 276 exported-netlist assertions passed, including retention of other circuits and BIAS topology. Drawings inspected. No hardware tests.

**Open consequences:** leakage drift/noise, high-impedance reference coupling, powered-off backfeeding, pulse-rated resistor selection and assembled ESD qualification prevent release. REF paths sum under faults. No medical safety conformity is established. Step 8 must validate BIAS stability/protection; Step 4 remains deferred, not closed. Charger and final BOM/layout/firmware work remain open.

### Documentation and repository restructure, 2026-11-08

No hardware change. The working folder was reorganised into `docs/`, `hardware/` and `host/`; superseded top-level copies of project.md, decision_log.md and the pin map were removed (each was an earlier subset of the current file). The KiCad project was renamed from EEG_RevC_Step7 to EEG_RevC so that its name does not change with each step, and the build and validation scripts were renamed to `build.py`, `validate.py` and `validate_controller.py`. `validate_step6.py` was removed because `validate.py` contains all of its checks. `hardware/rebuild.sh` now regenerates every output; the rebuilt netlist is identical in connectivity, values and footprints to the Step 7 export, and the BOM and pin map are byte-identical. project.md was rewritten to describe Rev C4 directly rather than through dated updates appended to the Rev B text, and this log gained a current register. The Step 7 entry was numbered D33.

The validation report now states the ERC result actually produced rather than a fixed claim. Running under KiCad 10.0.8 exposed one new finding: the stock microSD footprint names its shell pads `SH`, whereas the schematic symbol uses pin 11, so the shield-to-GND connection would not transfer to a KiCad 10 layout. This is recorded as an open item and flagged by `validate.py`; the schematic is unchanged. The netlist assertion count is 275 rather than 276 because that shell-pad check is now reported as a warning.

### D34: Step 8 BIAS loop compensation and protection (Rev C5), 2026-11-08

- Date and affected revision: 2026-11-08, Rev C5 (`ref_bias` sheet).
- Status and requirement addressed: implemented at schematic level, provisional; closes the design part of D07 and Rev B finding R08, not its measurement.
- Decision: replace the 1 MΩ ∥ 1.5 nF BIAS feedback with 1 MΩ ∥ (100 kΩ + 10 nF C0G) (RFB1, RZB1, CFB1). Keep RB1/RB2 at 2 × 499 kΩ. Add D509 (TPD2E2U06DCKR) from the RB1/RB2 midpoint to GND. Keep BIASREF and BIASIN tied to AVSS and require firmware to set BIASREF_INT = 1 together with PD_BIAS = 1.
- Concise rationale and evidence: a linear model of the whole common-mode loop (`analyze_bias.py`) gives the old network ≈ 14° nominal phase margin and instability in some of 324 swept cases, because the 998 kΩ output resistance drives ≈ 340 pF of input-leg capacitance plus cable and body coupling. The selected network gives ≈ 84° nominal and ≥ 47° in every swept case, with closed-loop peaking ≤ 3.3 dB. TI marks the old values as examples only (SBAS499C Figures 33, 34, 38); §10.1.1 permits BIASREF tied to AVSS.
- Alternatives and material tradeoffs: larger C_F alone (10 nF, 22 nF) left 240–303 cases below 45°. 15 nF or 22 nF with 100 kΩ give more margin but less mains rejection. The chosen network reduces nominal 50 Hz common-mode attenuation from ≈ 32 dB to ≈ 22 dB, and to ≈ 7 dB in the worst swept case. Lowering RB1/RB2 would improve both but raise the fault current limit, so it was not adopted.
- Assumptions and unresolved risks: ADC pin capacitance 20 pF, internal summing resistance 220 or 330 kΩ, amplifier DC gain 100 dB, resistive and equal electrodes, assumed cable and body coupling. Saturation, slew and transient behaviour not modelled. Currents (5.18 µA normal, 10.36 µA one resistor short) not yet assessed against the applicable standard.
- Validation needed / result: bench step response and mains rejection with an electrode simulator; disconnect and recovery; firmware CONFIG3 sequence; ESD qualification of D509, RB1 and RB2. 287 netlist assertions pass; pin-membership comparison confirms no change outside the BIAS network.
- Revisit trigger: measured ringing or instability, inadequate mains rejection with real electrodes, a change in N, cable type or electrode count, or a safety review result.
- Replaces / replaced by: replaces the D07 feedback values.

### D35–D37: Step 9 event timing, ADC clock and event inputs (Rev C6), 2026-11-08

Status: implemented at schematic level; firmware and measurement open. Details, sources and acceptance tests are in [reviews/step9_event_timing_review.md](reviews/step9_event_timing_review.md). Proposed timing targets (to be confirmed against the protocol): T1 event-to-sample alignment ≤ 100 µs; T2 ≤ 100 µs accumulated error over a 1 s epoch at the nominal rate; T3 ≤ 10 s drift per 24 h without external synchronisation.

- **D35: external ADC clock.** Fit Y340, SiTime SIT8008BIF11-33E-2.048000 (±20 ppm including tolerance, first-year ageing and temperature), powered and enabled from +3V3_ADC, driving CLK through 33 Ω; pull CLKSEL to DGND. Rationale: the internal oscillator (±0.5 % at 25 °C, ±2.5 % over temperature, SBAS499C §7.5) gives 5–25 ms error over a 1 s epoch and fails T2 by 50–250 times; the external clock gives ≈ 20 µs and ≈ 1.7 s per 24 h. Correcting the internal clock from DRDY timestamps in every analysis was rejected as fragile. Cost: one part and a few milliamperes on the digital rail (4.5 mA maximum specified at 20 MHz; less at 2.048 MHz, not quantified). Replaces the clock part of D06; addresses Rev B finding R10 at design level.
- **D36: event input circuits.** Trigger: 3.0–5.0 V logic drives a TLP2761 optocoupler LED through 620 Ω with a reverse clamp, so the source needs no isolated supply; 5000 Vrms, 8 mm creepage and clearance, 80 ns maximum delay. Photodiode: passive sensor, TLV9061 transimpedance stage (33 kΩ ∥ 15 pF, ≈ 320 kHz), TLV7011 comparator with ≈ 33 mV hysteresis, threshold from an MCP4725 DAC on the existing power I²C bus (0x60), TIA output also to SAADC AIN2 for calibration. A digital isolator would need an isolated supply on the trigger side; an MCU COMP-based photodiode threshold was not adopted because an external comparator keeps the capture path identical to the trigger and DRDY paths. Risks: isolation adequacy for participant use not assessed, connector parts open, light levels estimated, backlight PWM can create edge bursts.
- **D37: timestamp and synchronisation scheme.** Firmware runs TIMER3 at 16 MHz from the HFXO, extended to 64 bits by TIMER4 counting wrap events through PPI, and captures DRDY, TRIGGER_ISO and PHOTO_EDGE edges through GPIOTE IN channels and PPI. The DRDY count defines the sample index. EVENT records (schema `event/1`) carry the event tick and the surrounding DRDY ticks; `clock_sync` records every 1000 samples allow a session fit of the ADC rate. Analysis maps events with x = k + (t_e − L − t_k)/T + D, where D ≈ 1.5 samples is the derived ADC group delay and L the calibrated input latency. Reference code and seven tests are in `host/event_timing.py`. Replaces the TIMER2 reservation in the Rev C architecture document, because TIMER0–2 have only four capture registers.

Evidence: 310 netlist assertions pass, including a check that no trigger input-side net touches any other net and a pin-membership comparison showing that only the 29 Step 9 parts were added and only R340 changed connection since Step 8. Zero ERC errors. Manufacturer data sheets checked online for ADS1299, SiT8008, TLP2761, BPW34, TLV9061, TLV7011, MCP4725 and NINA-B3. No firmware and no measurements.

### D38–D41: Step 10 power and supervision review closure (Rev C7), 2026-11-08

Status: implemented at schematic level and checked by calculation; nothing measured. Details, tables and sources are in [reviews/step10_power_review.md](reviews/step10_power_review.md). This closes the deferral recorded at Step 4 and repeated in Steps 5–6, but does not close any review finding by measurement.

- **D38: rebalance the analogue rail.** RSET becomes R201 50.5 kΩ + R207 383 Ω (0.1 %, ≤ 10 ppm/K), giving 5.088 V. Rationale: tolerance stacking leaves ≈ 110 mV of the ADS1299's 4.75–5.25 V window for three margins. At 5.050 V the startup margin was 8.5 mV (counting CSET leakage), the fault-detection margin 14 mV and the ceiling margin 87 mV. Equalising startup and ceiling margins gives 45.9 mV and 47.6 mV. Alternatives: a tighter supervisor or regulator (not pursued in this step; the ±2 % SET current dominates the spread); 51.1 kΩ alone (26 mV ceiling margin). Revisit if ADC load, regulator or ADC supply limits change.
- **D39: collapse handling.** The SYS_OK path is intended to remove analogue power and reset the ADC while AVDD is still regulated; this needs SYS to fall at ≤ 3.0 mV/µs, i.e. ≥ 24 µF effective at average load and ≈ 127 µF at peak digital load. The ANALOG_OK path is the backstop and can let AVDD reach 4.5–4.74 V for tens of µs before reset. Accepted with a data rule: the last 5 samples before a supervisor stop are invalid. The SYS capacitance requirement passes to the charger step.
- **D40: persistent restart latch.** U227 SN74LVC1G74 (D and PRE̅ high, CLK = RUN_REQUEST, CLR̅ = RUN_PERMIT = POWER_OK · SERVICE_OK) and U228 make ANA_ENABLE = SYS_OK · PACK_OK · SERVICE_OK · RUN_REQUEST · RUN_ARMED. Rationale: 0.6 % supervisor hysteresis (≈ 36 mV at the pack threshold) cannot ride through battery rebound, and a firmware-only latch fails if the MCU misbehaves. USB insertion or interlock opening now also needs explicit re-arming. RUN_REQUEST must be driven directly (≤ 10 ns/V edges).
- **D41: reset-logic edges and power capacitors.** New finding: 100 kΩ open-drain pull-ups gave 0.8–2.5 µs/V edges into gates specified for ≤ 10 ns/V. All 2-input gates become SN74AUP1G08 (Schmitt inputs, ≤ 200 ns/V, pin-compatible). Supervisor pull-ups and the SWD/interlock defaults become 4.7 kΩ (≤ 118 ns/V at 30 pF, costing 0.70 mA per asserted monitor). Capacitors: C203/C204 GRM32ER71E226KE15L (22 µF 25 V X7R 1210, replacing 16 V 0805), C201 GRM21BR71C475KE51L, C0G release-delay capacitors (GRM31C5C1H104JA01L, GRM1885C1H103JA01D). Effective capacitance still to be read from DC-bias curves.

Evidence: 348 netlist assertions pass, zero ERC errors. A pin-membership comparison with the Step 9 netlist shows that only the eight Step 10 parts were added and only R201 pin 2 and U221 pin 1 changed connection. `analyze_power.py` passes all five rules. The LT3045 limits are those recorded at Step 4; the data sheet could not be re-downloaded during this step.

### Schematic readability pass, 2026-11-08

No circuit change. A layout pass (`hardware/scripts/layout.py`, groups in `layout_groups.py`) now runs at the end of every build. It places each sheet's parts in dashed frames, one per functional block, each with a title and a purpose note; replaces the free-floating sheet texts with a curated heading and a "Sheet notes" frame, removing statements made stale by Step 10; points labels away from parts so they no longer overlap pins or bodies; and moves capacitor values beside their symbols instead of across them. The root sheet groups the 15 sub-sheets into acquisition, power and controller columns. Parts move only as rigid connected units on the 1.27 mm grid. The exported netlist was compared before and after the pass: all 230 nets have identical pin membership and names. The ADC core and both input sheets use A2 paper; all other sheets stay on A3.

### D42–D45: Step 11 charger, power path and soft-off (Rev C8), 2026-11-08

Status: implemented at schematic level and checked by calculation; nothing measured. Details and sources are in [reviews/step11_charger_review.md](reviews/step11_charger_review.md). Implements D23 and retires the J400 bench input from D28.

- **D42: charger configuration.** BQ25798RQMR in the TI "VBUS input only" configuration (VAC1/VAC2 to VBUS, ACDRV1/2 to GND), PROG 6.04 kΩ (2S, 1.5 MHz, 1.0 µH), D+/D- unconnected because USB data belongs to the MCU, I²C on the power bus at 0x6B, INT to CHARGER_INT_N, STAT to a charge LED powered from REGN. SYS feeds the existing regulators; PACK_POS is now the charger BAT node behind the ship FET. Rationale: on battery the converter is idle and the pack reaches SYS through the 11 mΩ battery FET, so charger switching coincides only with USB service, when electrodes are already disconnected (D21). Alternatives: 750 kHz/2.2 µH (more efficient; not needed for 0.5 A charging).
- **D43: safe defaults without firmware.** ILIM_HIZ = REGN × 10/37 gives an input ceiling of 0.37 A nominal, 0.28–0.46 A over REGN and resistor corners, below the 500 mA USB default; firmware lifts it (EN_EXTILIM = 0) only after reading the TUSB320 advertisement, and any register reset restores it. CE is pulled to REGN and pulled low only by Q401 while the MCU drives CHARGE_REQUEST. Rationale: without D+/D- the charger's own detection could select 3 A; the architecture requires charging to stay off until checks pass.
- **D44: soft-off.** CSD17571Q2 ship FET between BAT and the pack, source on the charger side, gate on SDRV; firmware enters ship mode (SDRV_CTRL = 10). POWER button on QON (1 s wake, 10 s system reset), sensed by the MCU through a BAT54 on pad 37 (POWER_HOLD repurposed as POWER_BUTTON_N; R381 removed). Pack drain in ship mode ≤ 17 µA; supervisor dividers are behind the FET. Rationale: D28 recorded that complete shutdown was not implemented; ship mode provides it with two parts.
- **D45: capacitance.** SYS: 5 × 22 µF 25 V X7R 1210 + 100 µF 16 V OS-CON + 100 nF, about 124 µF effective (assumed 40 % ceramic retention), meeting D39's average-load requirement five times over and ≈ 98 % of the peak-load target. VBUS: one 10 µF + 100 nF instead of TI's two, so total VBUS bulk with C321 stays near the USB Type-C 10 µF sink limit (TI minimum 2 µF effective). PMID 3 × 10 µF, BAT 2 × 10 µF per TI.

Evidence: 387 netlist assertions pass, zero ERC errors or warnings. A pin-membership comparison with the Step 10 netlist shows that only the 35 charger, pack and button parts were added, only J400 and R381 were removed, and every other connection is unchanged. `analyze_power.py` passes all nine rules, including four new charger rules. Assumptions to replace with data: ceramic DC-bias retention, OS-CON leakage, Q400 gate enhancement from the 100 nA SDRV pump, BQ25798 footprint, pack and connector.

### D46–D47: Step 12 reference distribution and powered-off backfeed (Rev C9), 2026-11-08

Status: implemented at schematic level and checked by calculation; nothing measured. Details, tables and sources are in [reviews/step12_reference_backfeed_review.md](reviews/step12_reference_backfeed_review.md). Closes README open items 5 and 6 at design level.

- **D46: buffered shared REF.** The REF electrode drives only U500, an OPA376 unity follower on +5VA, through its own 2 × 47 kΩ, TPD2E2U06 (D510) and 4.7 kΩ. The output REF_BUF feeds pin 3 of JP1–JP8, and each channel keeps its own 94 kΩ / clamp / 4.7 kΩ after the jumper. Rationale: with a passive shared REF, eight channels on a 100 kΩ electrode couple at −37.3 dB at 100 Hz (−20.7 dB at 1 MΩ), which biases cross-channel comparisons between electrode types and grows with the REF impedance being studied. The buffer removes the shared impedance (modelled −157 dB, limited by assumed copper resistance), cuts the DC current through the REF electrode from up to 82 nA to 10 nA, and lowers 50 Hz common-mode conversion by about 17 dB with eight channels on REF. Cost: 0.44 µV rms more common noise on a 100 kΩ REF (mostly the protection resistors), about 0.95 mA maximum and the loss of ADC lead-off detection on REF, which firmware must replace. Alternatives: the ADS1299 SRB1 route (−31.5 dB, worse than passive, and all channels switch together); bipolar only (kept as a per-channel option, but loses the referential montage); removing C_diff (rejected: depends on an unvalidated pin model and removes the RF filter); OPA388 zero-drift (rejected: 35× the bias current, 50× the current noise, chopper artefacts). Revises D03.
- **D47: +5VA backfeed clamp.** Q201 (CSD17381F4) sinks +5VA through R208 100 Ω; its gate is pulled to +5VA by R209 1 MΩ and grounded by Q202 while ANA_ENABLE is high. Rationale: with the rail off, half-cell potentials, offsets and current-limited instruments raise AVDD by at most 0.14 V, but a stimulator-class source of 30 V between electrodes lifts it to 4.4 V in Rev C8, and 100 V to 6.9 V, beyond the ADS1299's 5.5 V absolute maximum. With the clamp, AVDD stays ≤ 1.31 V in every modelled case, and IC pin currents stay ≤ 0.54 mA. The clamp needs no supply, so it works in ship mode, and it also discharges +5VA to 0.3 V in 0.33 s after a stop. Cost: 5 µA while running, four parts and a FemtoFET footprint to draw. Alternatives: a lower bleeder (5 mA continuous), series diodes (leakage and noise in every leg), a Zener on the rail (does not stop partial powering), a load switch with discharge (inactive when unpowered). The isolated trigger has no galvanic path to +5VA (0.4 pF, ≥ 10¹² Ω). Firmware must wait 1 s after a stop before re-arming.

Evidence: 408 netlist assertions pass, zero ERC errors or warnings. A pin-membership comparison with the Step 11 netlist shows that only the 11 Step 12 parts were added, nothing was removed and only JP1–JP8 pin 3 and JREF1 changed connection. `analyze_inputs.py` (six rules) and the new `analyze_backfeed.py` (six rules) pass. Assumptions to replace with data: LT3045 reverse behaviour (data sheet not re-read), input clamp-diode characteristics (not specified), OPA376 open-loop output resistance, CSD17381F4 subthreshold slope and cold threshold, and the illustrative stimulator and instrument source values.

### D48–D55: Step 13 pre-layout review, exact BOM and footprint audit (Rev C10), 2026-11-08

Status: implemented at schematic level and checked by script; nothing built or measured. Details, findings F01–F20 and sources are in [reviews/step13_bom_footprint_review.md](reviews/step13_bom_footprint_review.md). Closes README open items 8 and 9 and the footprint parts of items 3 and 6 at design level.

- **D48: part families.** Every fitted part has a manufacturer, MPN and description in `hardware/bom.csv`, set by `scripts/bom_parts.py`. Resistors: Panasonic ERJ-3EKF (0603, 1 %), ERJ-8ENF (1206), ERA-3ARB (0603, 0.1 %, ±10 ppm/K, E24/E96 1 k–100 k), ERJ-PB6B (0805, 0.1 %, thick film, 150 V element voltage) for every electrode, REF and BIAS series resistor and the BIAS feedback. Capacitors: Murata GCM for the small parts and GRM 1206/1210 25 V for bulk. Rationale: few lines and shared price breaks; thick film for pulse-exposed resistors where thin film has a lower element voltage; Murata marks several previous GRM choices as "to be discontinued" or NRND. Price for 5 boards: €937.64 parts only (88 % from prices read for the exact MPN). TLV7011IDCKR (not orderable) became TLV7011DCKR; XFL4020 codes became -MEC.
- **D49: orderable precision values.** 50.5 kΩ and 32.0 kΩ are E192 and 43.9 kΩ is in no series; ERA-3ARB offers E192 only on request. RSET becomes 49.9 kΩ + 1.00 kΩ (5.090 V), ANALOG_OK 31.6 kΩ / 9.88 kΩ, PACK_OK 44.2 kΩ. Release margin 49.6 mV (was 45.9), ceiling margin 45.8 mV (47.6), ANALOG_OK assertion 12.2 mV above 4.75 V (14.0); all `analyze_power.py` rules pass. Alternative: series pairs for exact values (more parts, new nets); special-order E192 (minimum orders far above 5 boards). Revises the D38 values, not its rationale.
- **D50: bulk capacitors.** C202, C240, C300 (10 µF) and C241, C420 (22 µF) join the 1206 and 1210 25 V parts already used on SYS and +5VA. Murata curves give C203 + C204 26 µF worst case at 5.25 V (≥ 10 µF needed), C121 14 µF at 4.5 V, SYS 125 µF worst case (Step 11 estimate 124 µF on an assumed 40 % retention; measured curve 53 %), VBUS bulk 8.7 µF (≤ 10 µF). Generic 100 nF move from 0805 to 0603.
- **D51: footprints.** `scripts/footprints.py` generates `hardware/EEG.pretty` from the manufacturer drawings; `scripts/check_footprints.py` requires every symbol pin to have a pad and every numbered pad a pin, for all 367 on-board parts. This found two further shell-pad mismatches (USB-C `S1`/`SH`, microSD `11`/`SH`) and the stock DQK footprint leaving Q400's exposed drain and source unconnected. Shell pins are now named `SH`; Q400 uses a project footprint with the exposed pads numbered 1 and 4. KiCad 10 or later is required.
- **D52: electrode connector.** One keyed 2 × 10 box header (Würth 61202021621): pins 1–16 CH1+ to CH8−, 17 REF, 18 BIAS, 19–20 unconnected. The electrode symbols remain as off-board leads, so no existing connection changed. Rationale: 18 touch-proof sockets do not fit a 100 mm edge, and a single harness plug suits the mechanical interlock (D21). Provisional until the harness and enclosure are designed.
- **D53: remaining connectors and switches.** J600 Amphenol 031-6575 with a 4-pin symbol so all shell pads join the isolated return; J301 and J601 JST S2B-PH-K-S; J300 CNC Tech 3220-10-0300-00 (SMD); SW300–SW302 TL3342F160QG as SW400. Provisional.
- **D54: VBUS overvoltage (open).** The BQ25798 stops at 26 V by default, but D312 (breakdown 6.5–8.5 V), the USB-sense inverter (absolute maximum reached at 7.15 V) and the module VBUS pad see the source directly. Add an OVP switch at J310 before layout.
- **D55: mechanical fit (open).** Courtyards sum to 4743 mm², 68 % of one side; with routing, isolation and antenna margins one side of 100 × 70 mm is not enough. Options: passives on the bottom side or ≈ 110 × 85 mm. Tallest parts ≈ 12.5 mm (BNC, estimated); a cylindrical 2S pack must sit beside the board to stay within 30 mm.

Evidence: 441 netlist assertions pass (408 at Step 12), zero ERC errors or warnings. A pin-membership comparison with the Step 12 netlist shows that only J500 was added and only J600 pins 3–4 are new; the shell pins compare unchanged under their new names; all 1082 retained pin connections are unchanged. The footprint audit and 26 corner rules pass. Assumptions to replace with data: estimated heights and prices, LT3045 footprint against a current ADI drawing, ERJ-PB6B pulse capability, capacitance over temperature.

### D56–D60: Step 14 VBUS overvoltage protection, floor plan and placement (Rev C11), 2026-11-08

Status: drawn, placed and checked by script; not routed, built or measured. Details, calculations and sources are in [reviews/step14_ovp_placement_review.md](reviews/step14_ovp_placement_review.md). Closes D54 and D55; revises D15.

- **D56: board size and stack-up.** At the user's decision the board grows to 110 × 85 mm with every part on the top side; courtyards fill 51 % of one side (68 % of 100 × 70 at Step 13), leaving room for the 8 mm trigger barrier, the antenna clearance and routing. The pack sits beside the board on J401 (bottom edge). Stack-up JLCPCB JLC04161H-3313, 1.6 mm: F.Cu, 0.0994 mm 3313 prepreg, In1 GND, 1.265 mm core, In2 power, 0.0994 mm prepreg, B.Cu; ENIG because the WCSP lands are 0.225 mm. The thin prepreg keeps return loops short and makes a 90 Ω pair 0.15/0.18 mm. Alternatives: passives on the bottom of 100 × 70 mm (two-sided assembly, harder rework and probing); 7628 prepreg (wider USB pair, looser coupling). D15's four layers, €500 budget and 30 mm height stand; its 100 × 70 mm is superseded.
- **D57: VBUS overvoltage protection.** TPD1S514-1 between the USB-C VBUS contacts (new net VBUS_CON) and USB_5V: trip 5.90–5.99 V, off within 100 ns, 30 V DC and 100 V surge on the connector side, 39/50 mΩ, 20 ms delay and 3.5 ms soft start at plug-in, EN tied low. USB_5V peaks at 6.15 V in the worst modelled step (L ≥ 100 nH assumed), under every downstream limit. The USB-sense divider now runs from the TPD1S514 VBUS_POWER output, so USB_ABSENT falls even while the switch blocks a faulty source; the TUSB320 detect resistor moves to the connector side. Because the nRF52840 VBUS pin is rated 5.5 V (5.8 V absolute) and the OVP ceiling is 5.99 V, module pad 31 gets its own TPS7A2050 (5.0 V ±1.5 %), with a BAT54 carrying its reverse discharge after unplug. With the bulk behind the soft start, VBUS gets TI's recommended 2 × 10 µF (C401 added); the source sees only C324 (1 µF) at attach, and inrush is 69 mA. The TPD4S014 was rejected (6.45 V maximum trip, 11 µs typical response). Firmware: keep EN_OTG = 0, optionally VAC_OVP = 7 V, cap IINDPM at the 1.5 A level.
- **D58: floor plan.** Analogue zone on the left: J500 on the left edge, eight channel bands in CH1-at-bottom order matching J500 and the ADS1299 pins, JP pin 3 as a vertical REF_BUF bus, REF buffer and BIAS above, LT3045 below the ADC facing the power zone. Isolated trigger BNC on the top edge with an 8 mm U-shaped barrier rule area and a 1.2 mm slot under U600; photodiode top-left. Digital logic, microSD and buttons on the top half; module centred on the right edge with its antenna outwards (u-blox 3.3.3); USB-C, OVP, charger, SYS hold-up and pack bottom right, with the charger hot loop ≥ 15 mm from the ADC and the BQ25798 rotated so its switch-node row faces L400. In1 is continuous GND; In2 carries +5VA, +3V3 and SYS islands in a GND fill.
- **D59: rules.** Netclasses Power (0.8 mm), Supply (0.4 mm), USB_90R, Analog_in (0.3 mm to other classes) and Trigger_iso (8 mm clearance and creepage to every other net); minima from JLCPCB's multilayer capabilities (0.10 mm track and space, 0.25/0.5 mm vias, 0.3 mm to edges). Two land-pattern exceptions are written as named rules: 0.09 mm pad spacing inside footprints and 0.19 mm peg clearance on the GCT USB-C pattern. Designators sit on F.Fab; the silkscreen carries outlines and connector labels.
- **D60: generated board.** `scripts/pcb_place.py` builds the board from the netlist under KiCad's Python, with footprint paths from the schematic so "Update PCB from Schematic" matches every part; schematic sheet and symbol UUIDs are now derived from names so the paths are stable. `rebuild.sh` runs placement, DRC (zones refilled with the project rules) and `check_pcb.py`, and plots the top side and the inner planes. Interim: before routing, the script must stop overwriting the board.

Evidence: 477 netlist assertions (441 at Step 13); the Step 13 comparison shows only the eight new parts added and eight pins moved off USB_5V, with 1096 other pin connections unchanged. ERC 0/0; footprint audit pass (375 parts); 17 OVP rules, 27 corner rules and 33 placement rules pass; KiCad DRC has no errors, 499 unrouted connections and 30 individually accepted warnings (isolated In2/plane copper before vias, silk at edge connectors and the isolation slot). Assumptions to replace with data: OVP threshold drift and hot on-resistance, soft-start minimum, cable inductance, 90 Ω width, BNC body position.

### D61: Rev C12 datasheet review and electrode impedance test links, 2026-11-09

Status: drawn, placed and checked by script; nothing measured. Details, the pin-by-pin datasheet tables and the measurement procedure are in [reviews/revC12_datasheet_impedance_review.md](reviews/revC12_datasheet_impedance_review.md).

- **Review.** The ADS1299 (TI SBAS499C), OPA376 (SBOS406G) and TPD2E2U06 (SLLSEG9C) connections were checked pin by pin: every pin and every bypass value meets the data sheets. The LT3045 data sheet could not be downloaded again; its DFN-10 pinout remains to be confirmed. The series protection resistors set the board's own noise floor (≈ 0.57 µV rms against ≈ 0.2 µV for the ADC over 0.1–100 Hz); kept as the fault-current trade.
- **D61: impedance test links.** The ADS1299 lead-off sources act only on INxP/INxN, so the REF electrode (on the OPA376 only) and the BIAS electrode (on RB2 only) could not be measured. JP9 (REF_RAW to E8N) and JP10 (BIAS_ELEC to E7N) are normally open 1 × 2 headers on the electrode side of JP8/JP7: with the channel jumper at 1–2 and no CH− electrode fitted, the REF or BIAS electrode is measured through that channel's own 94 kΩ / clamp / 4.7 kΩ. No shunt combination joins REF_RAW to REF_BUF or bypasses a 94 kΩ network. BIASIN was considered and rejected: it can be digitised but not excited. Rationale: REF and BIAS contact quality affects every channel and the electrode comparison, and the cost is two headers.

Evidence: 486 netlist assertions (477 at Step 14), including a Step 14 netlist comparison showing only JP9 and JP10 added and every existing net unchanged apart from the four link pins; ERC 0/0; footprint audit pass (377 parts); DRC parity 0 differences, 0 items not accepted, 33 of 33 placement rules.
