MariusFauteux/EEG-PCB/hardware/bom.csv

Ref | Value | Footprint | Manufacturer | MPN | Description | DNP | Population
C1 | 220p C0G 5% 50V | Capacitor_SMD:C_0603_1608Metric | Murata | GCM1885C1H221JA16D | Capacitor 220 pF 5 % 50 V C0G 0603 | no | FIT
C2 | 220p C0G 5% 50V | Capacitor_SMD:C_0603_1608Metric | Murata | GCM1885C1H221JA16D | Capacitor 220 pF 5 % 50 V C0G 0603 | no | FIT
C3 | 220p C0G 5% 50V | Capacitor_SMD:C_0603_1608Metric | Murata | GCM1885C1H221JA16D | Capacitor 220 pF 5 % 50 V C0G 0603 | no | FIT
C4 | 220p C0G 5% 50V | Capacitor_SMD:C_0603_1608Metric | Murata | GCM1885C1H221JA16D | Capacitor 220 pF 5 % 50 V C0G 0603 | no | FIT
C5 | 220p C0G 5% 50V | Capacitor_SMD:C_0603_1608Metric | Murata | GCM1885C1H221JA16D | Capacitor 220 pF 5 % 50 V C0G 0603 | no | FIT
C6 | 220p C0G 5% 50V | Capacitor_SMD:C_0603_1608Metric | Murata | GCM1885C1H221JA16D | Capacitor 220 pF 5 % 50 V C0G 0603 | no | FIT
C7 | 220p C0G 5% 50V | Capacitor_SMD:C_0603_1608Metric | Murata | GCM1885C1H221JA16D | Capacitor 220 pF 5 % 50 V C0G 0603 | no | FIT
C8 | 220p C0G 5% 50V | Capacitor_SMD:C_0603_1608Metric | Murata | GCM1885C1H221JA16D | Capacitor 220 pF 5 % 50 V C0G 0603 | no | FIT
C100 | 1u 10V X7R | Capacitor_SMD:C_0805_2012Metric | Murata | GCM21BR71E105KA56L | Capacitor 1 uF 10 % 25 V X7R 0805 | no | FIT
C101 | 100n 16V X7R | Capacitor_SMD:C_0603_1608Metric | Murata | GCM188R71H104KA57D | Capacitor 100 nF 10 % 50 V X7R 0603 | no | FIT
C102 | 1u 10V X7R | Capacitor_SMD:C_0805_2012Metric | Murata | GCM21BR71E105KA56L | Capacitor 1 uF 10 % 25 V X7R 0805 | no | FIT
C103 | 100n 16V X7R | Capacitor_SMD:C_0603_1608Metric | Murata | GCM188R71H104KA57D | Capacitor 100 nF 10 % 50 V X7R 0603 | no | FIT
C104 | 1u 10V X7R | Capacitor_SMD:C_0805_2012Metric | Murata | GCM21BR71E105KA56L | Capacitor 1 uF 10 % 25 V X7R 0805 | no | FIT
C105 | 100n 16V X7R | Capacitor_SMD:C_0603_1608Metric | Murata | GCM188R71H104KA57D | Capacitor 100 nF 10 % 50 V X7R 0603 | no | FIT
C106 | 1u 10V X7R | Capacitor_SMD:C_0805_2012Metric | Murata | GCM21BR71E105KA56L | Capacitor 1 uF 10 % 25 V X7R 0805 | no | FIT
C107 | 100n 16V X7R | Capacitor_SMD:C_0603_1608Metric | Murata | GCM188R71H104KA57D | Capacitor 100 nF 10 % 50 V X7R 0603 | no | FIT
C108 | 1u 10V X7R | Capacitor_SMD:C_0805_2012Metric | Murata | GCM21BR71E105KA56L | Capacitor 1 uF 10 % 25 V X7R 0805 | no | FIT
C109 | 100n 16V X7R | Capacitor_SMD:C_0603_1608Metric | Murata | GCM188R71H104KA57D | Capacitor 100 nF 10 % 50 V X7R 0603 | no | FIT
C110 | 1u 10V X7R | Capacitor_SMD:C_0805_2012Metric | Murata | GCM21BR71E105KA56L | Capacitor 1 uF 10 % 25 V X7R 0805 | no | FIT
C111 | 100n 16V X7R | Capacitor_SMD:C_0603_1608Metric | Murata | GCM188R71H104KA57D | Capacitor 100 nF 10 % 50 V X7R 0603 | no | FIT
C112 | 1u 10V X7R | Capacitor_SMD:C_0805_2012Metric | Murata | GCM21BR71E105KA56L | Capacitor 1 uF 10 % 25 V X7R 0805 | no | FIT
C113 | 100n 16V X7R | Capacitor_SMD:C_0603_1608Metric | Murata | GCM188R71H104KA57D | Capacitor 100 nF 10 % 50 V X7R 0603 | no | FIT
C114 | 1u 10V X7R | Capacitor_SMD:C_0805_2012Metric | Murata | GCM21BR71E105KA56L | Capacitor 1 uF 10 % 25 V X7R 0805 | no | FIT
C115 | 100n 16V X7R | Capacitor_SMD:C_0603_1608Metric | Murata | GCM188R71H104KA57D | Capacitor 100 nF 10 % 50 V X7R 0603 | no | FIT
C116 | 100u 10V tantalum | Capacitor_Tantalum_SMD:CP_EIA-7343-31_Kemet-D | KEMET | T491D107K010AT | Capacitor tantalum 100 uF 10 V 10 % case D 7343-31 | no | FIT
C117 | 1u 10V X7R | Capacitor_SMD:C_0805_2012Metric | Murata | GCM21BR71E105KA56L | Capacitor 1 uF 10 % 25 V X7R 0805 | no | FIT
C118 | 1u 10V X7R | Capacitor_SMD:C_0805_2012Metric | Murata | GCM21BR71E105KA56L | Capacitor 1 uF 10 % 25 V X7R 0805 | no | FIT
C119 | 100n 16V | Capacitor_SMD:C_0603_1608Metric | Murata | GCM188R71H104KA57D | Capacitor 100 nF 10 % 50 V X7R 0603 | no | FIT
C120 | 1u 10V X7R | Capacitor_SMD:C_0805_2012Metric | Murata | GCM21BR71E105KA56L | Capacitor 1 uF 10 % 25 V X7R 0805 | no | FIT
C121 | 22u 10V X7R | Capacitor_SMD:C_1210_3225Metric | Murata | GRM32ER71E226KE15L | Capacitor 22 uF 10 % 25 V X7R 1210 | no | FIT
C122 | 100n 16V | Capacitor_SMD:C_0603_1608Metric | Murata | GCM188R71H104KA57D | Capacitor 100 nF 10 % 50 V X7R 0603 | no | FIT
C123 | 10u 10V X7R | Capacitor_SMD:C_1206_3216Metric | Murata | GRM31CR71E106KA12L | Capacitor 10 uF 10 % 25 V X7R 1206 | no | FIT
C124 | 10u 10V X7R | Capacitor_SMD:C_1206_3216Metric | Murata | GRM31CR71E106KA12L | Capacitor 10 uF 10 % 25 V X7R 1206 | no | FIT
C125 | 10u 10V X7R | Capacitor_SMD:C_1206_3216Metric | Murata | GRM31CR71E106KA12L | Capacitor 10 uF 10 % 25 V X7R 1206 | no | FIT
C201 | 4.7u 16V X7R 0805 (CSET) | Capacitor_SMD:C_0805_2012Metric | Murata | GRM21BR71C475KE51L | Capacitor 4.7 uF 10 % 16 V X7R 0805 | no | FIT
C202 | 10u 25V X7R 1206 (SYS) | Capacitor_SMD:C_1206_3216Metric | Murata | GRM31CR71E106KA12L | Capacitor 10 uF 10 % 25 V X7R 1206 | no | FIT
C203 | 22u 25V X7R 1210 | Capacitor_SMD:C_1210_3225Metric | Murata | GRM32ER71E226KE15L | Capacitor 22 uF 10 % 25 V X7R 1210 | no | FIT
C204 | 22u 25V X7R 1210 | Capacitor_SMD:C_1210_3225Metric | Murata | GRM32ER71E226KE15L | Capacitor 22 uF 10 % 25 V X7R 1210 | no | FIT
C210 | 100n bypass | Capacitor_SMD:C_0603_1608Metric | Murata | GCM188R71H104KA57D | Capacitor 100 nF 10 % 50 V X7R 0603 | no | FIT
C211 | 100n C0G 5% 50V delay | Capacitor_SMD:C_1206_3216Metric | Murata | GRM31C5C1H104JA01L | Capacitor 100 nF 5 % 50 V C0G 1206 | no | FIT
C212 | 100n bypass | Capacitor_SMD:C_0603_1608Metric | Murata | GCM188R71H104KA57D | Capacitor 100 nF 10 % 50 V X7R 0603 | no | FIT
C213 | 100n C0G 5% 50V delay | Capacitor_SMD:C_1206_3216Metric | Murata | GRM31C5C1H104JA01L | Capacitor 100 nF 5 % 50 V C0G 1206 | no | FIT
C214 | 100n bypass | Capacitor_SMD:C_0603_1608Metric | Murata | GCM188R71H104KA57D | Capacitor 100 nF 10 % 50 V X7R 0603 | no | FIT
C215 | 10n C0G 5% 50V delay | Capacitor_SMD:C_0603_1608Metric | Murata | GCM1885C1H103JA16D | Capacitor 10 nF 5 % 50 V C0G 0603 | no | FIT
C216 | 100n bypass | Capacitor_SMD:C_0603_1608Metric | Murata | GCM188R71H104KA57D | Capacitor 100 nF 10 % 50 V X7R 0603 | no | FIT
C217 | 10n C0G 5% 50V delay | Capacitor_SMD:C_0603_1608Metric | Murata | GCM1885C1H103JA16D | Capacitor 10 nF 5 % 50 V C0G 0603 | no | FIT
C218 | 100n bypass | Capacitor_SMD:C_0603_1608Metric | Murata | GCM188R71H104KA57D | Capacitor 100 nF 10 % 50 V X7R 0603 | no | FIT
C219 | 10n C0G 5% 50V delay | Capacitor_SMD:C_0603_1608Metric | Murata | GCM1885C1H103JA16D | Capacitor 10 nF 5 % 50 V C0G 0603 | no | FIT
C226 | 100n | Capacitor_SMD:C_0603_1608Metric | Murata | GCM188R71H104KA57D | Capacitor 100 nF 10 % 50 V X7R 0603 | no | FIT
C227 | 100n | Capacitor_SMD:C_0603_1608Metric | Murata | GCM188R71H104KA57D | Capacitor 100 nF 10 % 50 V X7R 0603 | no | FIT
C228 | 100n | Capacitor_SMD:C_0603_1608Metric | Murata | GCM188R71H104KA57D | Capacitor 100 nF 10 % 50 V X7R 0603 | no | FIT
C230 | 100n | Capacitor_SMD:C_0603_1608Metric | Murata | GCM188R71H104KA57D | Capacitor 100 nF 10 % 50 V X7R 0603 | no | FIT
C231 | 100n | Capacitor_SMD:C_0603_1608Metric | Murata | GCM188R71H104KA57D | Capacitor 100 nF 10 % 50 V X7R 0603 | no | FIT
C232 | 100n | Capacitor_SMD:C_0603_1608Metric | Murata | GCM188R71H104KA57D | Capacitor 100 nF 10 % 50 V X7R 0603 | no | FIT
C233 | 100n | Capacitor_SMD:C_0603_1608Metric | Murata | GCM188R71H104KA57D | Capacitor 100 nF 10 % 50 V X7R 0603 | no | FIT
C234 | 100n | Capacitor_SMD:C_0603_1608Metric | Murata | GCM188R71H104KA57D | Capacitor 100 nF 10 % 50 V X7R 0603 | no | FIT
C235 | 100n | Capacitor_SMD:C_0603_1608Metric | Murata | GCM188R71H104KA57D | Capacitor 100 nF 10 % 50 V X7R 0603 | no | FIT
C240 | 10u 25V X7R 1206 (SYS) | Capacitor_SMD:C_1206_3216Metric | Murata | GRM31CR71E106KA12L | Capacitor 10 uF 10 % 25 V X7R 1206 | no | FIT
C241 | 22u 25V X7R 1210 | Capacitor_SMD:C_1210_3225Metric | Murata | GRM32ER71E226KE15L | Capacitor 22 uF 10 % 25 V X7R 1210 | no | FIT
C242 | 100n | Capacitor_SMD:C_0603_1608Metric | Murata | GCM188R71H104KA57D | Capacitor 100 nF 10 % 50 V X7R 0603 | no | FIT
C300 | 10u 25V X7R 1206 | Capacitor_SMD:C_1206_3216Metric | Murata | GRM31CR71E106KA12L | Capacitor 10 uF 10 % 25 V X7R 1206 | no | FIT
C301 | 100n | Capacitor_SMD:C_0603_1608Metric | Murata | GCM188R71H104KA57D | Capacitor 100 nF 10 % 50 V X7R 0603 | no | FIT
C302 | 100n | Capacitor_SMD:C_0603_1608Metric | Murata | GCM188R71H104KA57D | Capacitor 100 nF 10 % 50 V X7R 0603 | no | FIT
C303 | 100n 10V | Capacitor_SMD:C_0603_1608Metric | Murata | GCM188R71H104KA57D | Capacitor 100 nF 10 % 50 V X7R 0603 | no | FIT
C310 | 100n | Capacitor_SMD:C_0603_1608Metric | Murata | GCM188R71H104KA57D | Capacitor 100 nF 10 % 50 V X7R 0603 | no | FIT
C311 | 100n | Capacitor_SMD:C_0603_1608Metric | Murata | GCM188R71H104KA57D | Capacitor 100 nF 10 % 50 V X7R 0603 | no | FIT
C312 | 100n | Capacitor_SMD:C_0603_1608Metric | Murata | GCM188R71H104KA57D | Capacitor 100 nF 10 % 50 V X7R 0603 | no | FIT
C313 | 100n | Capacitor_SMD:C_0603_1608Metric | Murata | GCM188R71H104KA57D | Capacitor 100 nF 10 % 50 V X7R 0603 | no | FIT
C314 | 100n | Capacitor_SMD:C_0603_1608Metric | Murata | GCM188R71H104KA57D | Capacitor 100 nF 10 % 50 V X7R 0603 | no | FIT
C320 | 100n | Capacitor_SMD:C_0603_1608Metric | Murata | GCM188R71H104KA57D | Capacitor 100 nF 10 % 50 V X7R 0603 | no | FIT
C321 | 1u 10V X7R | Capacitor_SMD:C_0805_2012Metric | Murata | GCM21BR71E105KA56L | Capacitor 1 uF 10 % 25 V X7R 0805 | no | FIT
C322 | 100n | Capacitor_SMD:C_0603_1608Metric | Murata | GCM188R71H104KA57D | Capacitor 100 nF 10 % 50 V X7R 0603 | no | FIT
C323 | 100n | Capacitor_SMD:C_0603_1608Metric | Murata | GCM188R71H104KA57D | Capacitor 100 nF 10 % 50 V X7R 0603 | no | FIT
C324 | 1u 50V X7R 0805 (VBUS_CON, at U323) | Capacitor_SMD:C_0805_2012Metric | Murata | GCM21BR71H105KA03L | Capacitor 1 uF 10 % 50 V X7R 0805 | no | FIT
C325 | 1u 25V X7R 0805 (VBUS_POWER LDO) | Capacitor_SMD:C_0805_2012Metric | Murata | GCM21BR71E105KA56L | Capacitor 1 uF 10 % 25 V X7R 0805 | no | FIT
C326 | 1u 25V X7R 0805 (LDO IN) | Capacitor_SMD:C_0805_2012Metric | Murata | GCM21BR71E105KA56L | Capacitor 1 uF 10 % 25 V X7R 0805 | no | FIT
C327 | 1u 25V X7R 0805 (LDO OUT, module VBUS) | Capacitor_SMD:C_0805_2012Metric | Murata | GCM21BR71E105KA56L | Capacitor 1 uF 10 % 25 V X7R 0805 | no | FIT
C330 | 100n | Capacitor_SMD:C_0603_1608Metric | Murata | GCM188R71H104KA57D | Capacitor 100 nF 10 % 50 V X7R 0603 | no | FIT
C331 | 100n | Capacitor_SMD:C_0603_1608Metric | Murata | GCM188R71H104KA57D | Capacitor 100 nF 10 % 50 V X7R 0603 | no | FIT
C332 | 100n | Capacitor_SMD:C_0603_1608Metric | Murata | GCM188R71H104KA57D | Capacitor 100 nF 10 % 50 V X7R 0603 | no | FIT
C333 | 100n | Capacitor_SMD:C_0603_1608Metric | Murata | GCM188R71H104KA57D | Capacitor 100 nF 10 % 50 V X7R 0603 | no | FIT
C340 | 100n 10V X7R | Capacitor_SMD:C_0603_1608Metric | Murata | GCM188R71H104KA57D | Capacitor 100 nF 10 % 50 V X7R 0603 | no | FIT
C400 | 10u 25V X7R 1206 (VBUS) | Capacitor_SMD:C_1206_3216Metric | Murata | GRM31CR71E106KA12L | Capacitor 10 uF 10 % 25 V X7R 1206 | no | FIT
C401 | 10u 25V X7R 1206 (VBUS, behind OVP soft start) | Capacitor_SMD:C_1206_3216Metric | Murata | GRM31CR71E106KA12L | Capacitor 10 uF 10 % 25 V X7R 1206 | no | FIT
C402 | 100n 50V X7R (VBUS, at pin) | Capacitor_SMD:C_0603_1608Metric | Murata | GCM188R71H104KA57D | Capacitor 100 nF 10 % 50 V X7R 0603 | no | FIT
C403 | 10u 25V X7R 1206 (PMID) | Capacitor_SMD:C_1206_3216Metric | Murata | GRM31CR71E106KA12L | Capacitor 10 uF 10 % 25 V X7R 1206 | no | FIT
C404 | 10u 25V X7R 1206 (PMID) | Capacitor_SMD:C_1206_3216Metric | Murata | GRM31CR71E106KA12L | Capacitor 10 uF 10 % 25 V X7R 1206 | no | FIT
C405 | 10u 25V X7R 1206 (PMID) | Capacitor_SMD:C_1206_3216Metric | Murata | GRM31CR71E106KA12L | Capacitor 10 uF 10 % 25 V X7R 1206 | no | FIT
C406 | 100n 50V X7R (PMID, at pin) | Capacitor_SMD:C_0603_1608Metric | Murata | GCM188R71H104KA57D | Capacitor 100 nF 10 % 50 V X7R 0603 | no | FIT
C407 | 47n 25V X7R (BTST1) | Capacitor_SMD:C_0603_1608Metric | Murata | GCM188R71H473KA55D | Capacitor 47 nF 10 % 50 V X7R 0603 | no | FIT
C408 | 47n 25V X7R (BTST2) | Capacitor_SMD:C_0603_1608Metric | Murata | GCM188R71H473KA55D | Capacitor 47 nF 10 % 50 V X7R 0603 | no | FIT
C409 | 4.7u 10V X7R (REGN) | Capacitor_SMD:C_0805_2012Metric | Murata | GRM21BR71C475KE51L | Capacitor 4.7 uF 10 % 16 V X7R 0805 | no | FIT
C410 | 22u 25V X7R 1210 (SYS) | Capacitor_SMD:C_1210_3225Metric | Murata | GRM32ER71E226KE15L | Capacitor 22 uF 10 % 25 V X7R 1210 | no | FIT
C411 | 22u 25V X7R 1210 (SYS) | Capacitor_SMD:C_1210_3225Metric | Murata | GRM32ER71E226KE15L | Capacitor 22 uF 10 % 25 V X7R 1210 | no | FIT
C412 | 22u 25V X7R 1210 (SYS) | Capacitor_SMD:C_1210_3225Metric | Murata | GRM32ER71E226KE15L | Capacitor 22 uF 10 % 25 V X7R 1210 | no | FIT
C413 | 22u 25V X7R 1210 (SYS) | Capacitor_SMD:C_1210_3225Metric | Murata | GRM32ER71E226KE15L | Capacitor 22 uF 10 % 25 V X7R 1210 | no | FIT
C414 | 22u 25V X7R 1210 (SYS) | Capacitor_SMD:C_1210_3225Metric | Murata | GRM32ER71E226KE15L | Capacitor 22 uF 10 % 25 V X7R 1210 | no | FIT
C415 | 100n 50V X7R (SYS, at pin) | Capacitor_SMD:C_0603_1608Metric | Murata | GCM188R71H104KA57D | Capacitor 100 nF 10 % 50 V X7R 0603 | no | FIT
C416 | 100u 16V OS-CON polymer (SYS hold-up) | Capacitor_SMD:CP_Elec_10x7.9 | Panasonic | 16SVP100M | Capacitor aluminium polymer OS-CON 100 uF 16 V | no | FIT
C417 | 10u 25V X7R 1206 (BAT) | Capacitor_SMD:C_1206_3216Metric | Murata | GRM31CR71E106KA12L | Capacitor 10 uF 10 % 25 V X7R 1206 | no | FIT
C418 | 10u 25V X7R 1206 (BAT) | Capacitor_SMD:C_1206_3216Metric | Murata | GRM31CR71E106KA12L | Capacitor 10 uF 10 % 25 V X7R 1206 | no | FIT
C420 | 22u 25V X7R 1210 | Capacitor_SMD:C_1210_3225Metric | Murata | GRM32ER71E226KE15L | Capacitor 22 uF 10 % 25 V X7R 1210 | no | FIT
C421 | 100n 10V X7R | Capacitor_SMD:C_0603_1608Metric | Murata | GCM188R71H104KA57D | Capacitor 100 nF 10 % 50 V X7R 0603 | no | FIT
C422 | 10n | Capacitor_SMD:C_0603_1608Metric | Murata | GCM1885C1H103JA16D | Capacitor 10 nF 5 % 50 V C0G 0603 | no | FIT
C500 | 100n 16V X7R (at U500 V+) | Capacitor_SMD:C_0603_1608Metric | Murata | GCM188R71H104KA57D | Capacitor 100 nF 10 % 50 V X7R 0603 | no | FIT
C501 | 1u 10V X7R | Capacitor_SMD:C_0805_2012Metric | Murata | GCM21BR71E105KA56L | Capacitor 1 uF 10 % 25 V X7R 0805 | no | FIT
C600 | 100n 10V X7R (within 1 cm of U600 pins 4/6) | Capacitor_SMD:C_0603_1608Metric | Murata | GCM188R71H104KA57D | Capacitor 100 nF 10 % 50 V X7R 0603 | no | FIT
C610 | 15p C0G 5% 50V 0402 | Capacitor_SMD:C_0402_1005Metric | Murata | GCM1555C1H150JA16D | Capacitor 15 pF 5 % 50 V C0G 0402 | no | FIT
C611 | 100n | Capacitor_SMD:C_0603_1608Metric | Murata | GCM188R71H104KA57D | Capacitor 100 nF 10 % 50 V X7R 0603 | no | FIT
C612 | 100n 10V X7R | Capacitor_SMD:C_0603_1608Metric | Murata | GCM188R71H104KA57D | Capacitor 100 nF 10 % 50 V X7R 0603 | no | FIT
C613 | 100n 10V X7R | Capacitor_SMD:C_0603_1608Metric | Murata | GCM188R71H104KA57D | Capacitor 100 nF 10 % 50 V X7R 0603 | no | FIT
C614 | 100n | Capacitor_SMD:C_0603_1608Metric | Murata | GCM188R71H104KA57D | Capacitor 100 nF 10 % 50 V X7R 0603 | no | FIT
C615 | 100n 10V X7R | Capacitor_SMD:C_0603_1608Metric | Murata | GCM188R71H104KA57D | Capacitor 100 nF 10 % 50 V X7R 0603 | no | FIT
CFB1 | 10n C0G 5% 50V | Capacitor_SMD:C_0603_1608Metric | Murata | GCM1885C1H103JA16D | Capacitor 10 nF 5 % 50 V C0G 0603 | no | FIT
D310 | TPD2E2U06DCKR | Package_TO_SOT_SMD:SOT-323_SC-70 | Texas Instruments | TPD2E2U06DCKR | ESD array 2-ch 5.5 V SC-70 | no | FIT
D311 | TPD2E2U06DCKR | Package_TO_SOT_SMD:SOT-323_SC-70 | Texas Instruments | TPD2E2U06DCKR | ESD array 2-ch 5.5 V SC-70 | no | FIT
D312 | TPD2E2U06DCKR | Package_TO_SOT_SMD:SOT-323_SC-70 | Texas Instruments | TPD2E2U06DCKR | ESD array 2-ch 5.5 V SC-70 | no | FIT
D324 | BAT54 (U324 reverse-current bypass) | Package_TO_SOT_SMD:SOT-23 | Nexperia | BAT54,215 | Diode Schottky 30 V 0.2 A SOT-23 | no | FIT
D401 | CHARGE LED green (LTST-C190GKT) | LED_SMD:LED_0603_1608Metric | Lite-On | LTST-C190GKT | LED green 0603 | no | FIT
D402 | BAT54 (button sense, blocks QON back-feed) | Package_TO_SOT_SMD:SOT-23 | Nexperia | BAT54,215 | Diode Schottky 30 V 0.2 A SOT-23 | no | FIT
D420 | TPD2E2U06DCKR | Package_TO_SOT_SMD:SOT-323_SC-70 | Texas Instruments | TPD2E2U06DCKR | ESD array 2-ch 5.5 V SC-70 | no | FIT
D421 | TPD2E2U06DCKR | Package_TO_SOT_SMD:SOT-323_SC-70 | Texas Instruments | TPD2E2U06DCKR | ESD array 2-ch 5.5 V SC-70 | no | FIT
D422 | TPD2E2U06DCKR | Package_TO_SOT_SMD:SOT-323_SC-70 | Texas Instruments | TPD2E2U06DCKR | ESD array 2-ch 5.5 V SC-70 | no | FIT
D423 | TPD2E2U06DCKR | Package_TO_SOT_SMD:SOT-323_SC-70 | Texas Instruments | TPD2E2U06DCKR | ESD array 2-ch 5.5 V SC-70 | no | FIT
D501 | TPD2E2U06DCKR | Package_TO_SOT_SMD:SOT-323_SC-70 | Texas Instruments | TPD2E2U06DCKR | ESD array 2-ch 5.5 V SC-70 | no | FIT
D502 | TPD2E2U06DCKR | Package_TO_SOT_SMD:SOT-323_SC-70 | Texas Instruments | TPD2E2U06DCKR | ESD array 2-ch 5.5 V SC-70 | no | FIT
D503 | TPD2E2U06DCKR | Package_TO_SOT_SMD:SOT-323_SC-70 | Texas Instruments | TPD2E2U06DCKR | ESD array 2-ch 5.5 V SC-70 | no | FIT
D504 | TPD2E2U06DCKR | Package_TO_SOT_SMD:SOT-323_SC-70 | Texas Instruments | TPD2E2U06DCKR | ESD array 2-ch 5.5 V SC-70 | no | FIT
D505 | TPD2E2U06DCKR | Package_TO_SOT_SMD:SOT-323_SC-70 | Texas Instruments | TPD2E2U06DCKR | ESD array 2-ch 5.5 V SC-70 | no | FIT
D506 | TPD2E2U06DCKR | Package_TO_SOT_SMD:SOT-323_SC-70 | Texas Instruments | TPD2E2U06DCKR | ESD array 2-ch 5.5 V SC-70 | no | FIT
D507 | TPD2E2U06DCKR | Package_TO_SOT_SMD:SOT-323_SC-70 | Texas Instruments | TPD2E2U06DCKR | ESD array 2-ch 5.5 V SC-70 | no | FIT
D508 | TPD2E2U06DCKR | Package_TO_SOT_SMD:SOT-323_SC-70 | Texas Instruments | TPD2E2U06DCKR | ESD array 2-ch 5.5 V SC-70 | no | FIT
D509 | TPD2E2U06DCKR | Package_TO_SOT_SMD:SOT-323_SC-70 | Texas Instruments | TPD2E2U06DCKR | ESD array 2-ch 5.5 V SC-70 | no | FIT
D510 | TPD2E2U06DCKR | Package_TO_SOT_SMD:SOT-323_SC-70 | Texas Instruments | TPD2E2U06DCKR | ESD array 2-ch 5.5 V SC-70 | no | FIT
D600 | 1N4148WS (LED reverse clamp) | Diode_SMD:D_SOD-323 | Diodes Inc. | 1N4148WS-7-F | Diode switching 75 V 150 mA SOD-323 | no | FIT
D601 | TPD2E2U06DCKR | Package_TO_SOT_SMD:SOT-323_SC-70 | Texas Instruments | TPD2E2U06DCKR | ESD array 2-ch 5.5 V SC-70 | no | FIT
J1 | CH1+ |  |  |  | Electrode lead (off board; reaches the PCB through J500) | yes | OFF-BOARD
J2 | CH1- |  |  |  | Electrode lead (off board; reaches the PCB through J500) | yes | OFF-BOARD
J3 | CH2+ |  |  |  | Electrode lead (off board; reaches the PCB through J500) | yes | OFF-BOARD
J4 | CH2- |  |  |  | Electrode lead (off board; reaches the PCB through J500) | yes | OFF-BOARD
J5 | CH3+ |  |  |  | Electrode lead (off board; reaches the PCB through J500) | yes | OFF-BOARD
J6 | CH3- |  |  |  | Electrode lead (off board; reaches the PCB through J500) | yes | OFF-BOARD
J7 | CH4+ |  |  |  | Electrode lead (off board; reaches the PCB through J500) | yes | OFF-BOARD
J8 | CH4- |  |  |  | Electrode lead (off board; reaches the PCB through J500) | yes | OFF-BOARD
J9 | CH5+ |  |  |  | Electrode lead (off board; reaches the PCB through J500) | yes | OFF-BOARD
J10 | CH5- |  |  |  | Electrode lead (off board; reaches the PCB through J500) | yes | OFF-BOARD
J11 | CH6+ |  |  |  | Electrode lead (off board; reaches the PCB through J500) | yes | OFF-BOARD
J12 | CH6- |  |  |  | Electrode lead (off board; reaches the PCB through J500) | yes | OFF-BOARD
J13 | CH7+ |  |  |  | Electrode lead (off board; reaches the PCB through J500) | yes | OFF-BOARD
J14 | CH7- |  |  |  | Electrode lead (off board; reaches the PCB through J500) | yes | OFF-BOARD
J15 | CH8+ |  |  |  | Electrode lead (off board; reaches the PCB through J500) | yes | OFF-BOARD
J16 | CH8- |  |  |  | Electrode lead (off board; reaches the PCB through J500) | yes | OFF-BOARD
J300 | Cortex SWD 2x5 1.27mm | Connector_PinHeader_1.27mm:PinHeader_2x05_P1.27mm_Vertical_SMD | CNC Tech | 3220-10-0300-00 | Connector header 2x5 1.27 mm shrouded SWD | no | FIT
J301 | INTERLOCK: closed only in recording position | Connector_JST:JST_PH_S2B-PH-K_1x02_P2.00mm_Horizontal | JST | S2B-PH-K-S | Connector JST PH 2-pin right-angle | no | FIT
J310 | USB4105-GF-A | Connector_USB:USB_C_Receptacle_GCT_USB4105-xx-A_16P_TopMnt_Horizontal | GCT | USB4105-GF-A | Connector USB-C receptacle 16-pin USB 2.0 | no | FIT
J401 | PACK: + / - / NTC 103AT (JST PH, keyed) | Connector_JST:JST_PH_S3B-PH-K_1x03_P2.00mm_Horizontal | JST | S3B-PH-K-S | Connector JST PH 3-pin right-angle | no | FIT
J420 | DM3AT-SF-PEJM5 | Connector_Card:microSD_HC_Hirose_DM3AT-SF-PEJM5 | Hirose | DM3AT-SF-PEJM5 | Connector microSD push-pull right-angle | no | FIT
J500 | ELECTRODE HARNESS 2x10 (keyed box header) | Connector_IDC:IDC-Header_2x10_P2.54mm_Vertical | Wurth Elektronik | 61202021621 | Connector box header 2x10 2.54 mm vertical THT (electrode harness) | no | FIT
J600 | TRIGGER IN (BNC, shell = isolated return) | Connector_Coaxial:BNC_Amphenol_031-6575_Horizontal | Amphenol RF | 031-6575 | Connector BNC jack right-angle PCB (isolated trigger) | no | FIT
J601 | PHOTODIODE (K, A; part TBD) | Connector_JST:JST_PH_S2B-PH-K_1x02_P2.00mm_Horizontal | JST | S2B-PH-K-S | Connector JST PH 2-pin right-angle | no | FIT
JBIAS1 | BIAS electrode |  |  |  | Electrode lead (off board; reaches the PCB through J500) | yes | OFF-BOARD
JP1 | 1-2 bipolar / 2-3 REF | Connector_PinHeader_2.54mm:PinHeader_1x03_P2.54mm_Vertical | Wurth Elektronik | 61300311121 | Connector header 1x3 2.54 mm vertical THT | no | FIT
JP2 | 1-2 bipolar / 2-3 REF | Connector_PinHeader_2.54mm:PinHeader_1x03_P2.54mm_Vertical | Wurth Elektronik | 61300311121 | Connector header 1x3 2.54 mm vertical THT | no | FIT
JP3 | 1-2 bipolar / 2-3 REF | Connector_PinHeader_2.54mm:PinHeader_1x03_P2.54mm_Vertical | Wurth Elektronik | 61300311121 | Connector header 1x3 2.54 mm vertical THT | no | FIT
JP4 | 1-2 bipolar / 2-3 REF | Connector_PinHeader_2.54mm:PinHeader_1x03_P2.54mm_Vertical | Wurth Elektronik | 61300311121 | Connector header 1x3 2.54 mm vertical THT | no | FIT
JP5 | 1-2 bipolar / 2-3 REF | Connector_PinHeader_2.54mm:PinHeader_1x03_P2.54mm_Vertical | Wurth Elektronik | 61300311121 | Connector header 1x3 2.54 mm vertical THT | no | FIT
JP6 | 1-2 bipolar / 2-3 REF | Connector_PinHeader_2.54mm:PinHeader_1x03_P2.54mm_Vertical | Wurth Elektronik | 61300311121 | Connector header 1x3 2.54 mm vertical THT | no | FIT
JP7 | 1-2 bipolar / 2-3 REF | Connector_PinHeader_2.54mm:PinHeader_1x03_P2.54mm_Vertical | Wurth Elektronik | 61300311121 | Connector header 1x3 2.54 mm vertical THT | no | FIT
JP8 | 1-2 bipolar / 2-3 REF | Connector_PinHeader_2.54mm:PinHeader_1x03_P2.54mm_Vertical | Wurth Elektronik | 61300311121 | Connector header 1x3 2.54 mm vertical THT | no | FIT
JP9 | REF test: REF electrode -> CH8- (JP8 1-2) | Connector_PinHeader_2.54mm:PinHeader_1x02_P2.54mm_Vertical | Wurth Elektronik | 61300211121 | Connector header 1x2 2.54 mm vertical THT (impedance test link) | no | FIT
JP10 | BIAS test: BIAS electrode -> CH7- (JP7 1-2) | Connector_PinHeader_2.54mm:PinHeader_1x02_P2.54mm_Vertical | Wurth Elektronik | 61300211121 | Connector header 1x2 2.54 mm vertical THT (impedance test link) | no | FIT
JREF1 | REF electrode |  |  |  | Electrode lead (off board; reaches the PCB through J500) | yes | OFF-BOARD
L240 | 2.2uH XFL4020-222MEC | Inductor_SMD:L_Coilcraft_XxL4020 | Coilcraft | XFL4020-222MEC | Inductor 2.2 uH 20 % Isat 3.1 A 4x4x2.1 mm | no | FIT
L400 | 1.0uH XFL4020-102ME (Isat >= 3 A) | Inductor_SMD:L_Coilcraft_XxL4020 | Coilcraft | XFL4020-102MEC | Inductor 1.0 uH 20 % Isat 4.5 A 4x4x2.1 mm | no | FIT
Q201 | CSD17381F4 (AVDD backfeed clamp) | EEG:Texas_YJC0003A_FemtoFET-3_1.0x0.6mm | Texas Instruments | CSD17381F4 | MOSFET N 30 V 3.1 A FemtoFET 1.0x0.6 | no | FIT
Q202 | CSD17381F4 (clamp release) | EEG:Texas_YJC0003A_FemtoFET-3_1.0x0.6mm | Texas Instruments | CSD17381F4 | MOSFET N 30 V 3.1 A FemtoFET 1.0x0.6 | no | FIT
Q400 | CSD17571Q2 (ship FET) | EEG:Texas_DQK_SON-6_2x2mm_CSD17571Q2 | Texas Instruments | CSD17571Q2 | MOSFET N 30 V 22 A SON 2x2 | no | FIT
Q401 | BSS138 (CE pull-down) | Package_TO_SOT_SMD:SOT-23 | onsemi | BSS138 | MOSFET N 50 V 0.2 A SOT-23 | no | FIT
R11 | 47k 0.1% | Resistor_SMD:R_0805_2012Metric | Panasonic | ERJ-PB6B4702V | Resistor 47k 0.1 % 50 ppm/K 0.25 W 150 V 0805 thick film | no | FIT
R12 | 47k 0.1% | Resistor_SMD:R_0805_2012Metric | Panasonic | ERJ-PB6B4702V | Resistor 47k 0.1 % 50 ppm/K 0.25 W 150 V 0805 thick film | no | FIT
R13 | 47k 0.1% | Resistor_SMD:R_0805_2012Metric | Panasonic | ERJ-PB6B4702V | Resistor 47k 0.1 % 50 ppm/K 0.25 W 150 V 0805 thick film | no | FIT
R14 | 47k 0.1% | Resistor_SMD:R_0805_2012Metric | Panasonic | ERJ-PB6B4702V | Resistor 47k 0.1 % 50 ppm/K 0.25 W 150 V 0805 thick film | no | FIT
R21 | 47k 0.1% | Resistor_SMD:R_0805_2012Metric | Panasonic | ERJ-PB6B4702V | Resistor 47k 0.1 % 50 ppm/K 0.25 W 150 V 0805 thick film | no | FIT
R22 | 47k 0.1% | Resistor_SMD:R_0805_2012Metric | Panasonic | ERJ-PB6B4702V | Resistor 47k 0.1 % 50 ppm/K 0.25 W 150 V 0805 thick film | no | FIT
R23 | 47k 0.1% | Resistor_SMD:R_0805_2012Metric | Panasonic | ERJ-PB6B4702V | Resistor 47k 0.1 % 50 ppm/K 0.25 W 150 V 0805 thick film | no | FIT
R24 | 47k 0.1% | Resistor_SMD:R_0805_2012Metric | Panasonic | ERJ-PB6B4702V | Resistor 47k 0.1 % 50 ppm/K 0.25 W 150 V 0805 thick film | no | FIT
R31 | 47k 0.1% | Resistor_SMD:R_0805_2012Metric | Panasonic | ERJ-PB6B4702V | Resistor 47k 0.1 % 50 ppm/K 0.25 W 150 V 0805 thick film | no | FIT
R32 | 47k 0.1% | Resistor_SMD:R_0805_2012Metric | Panasonic | ERJ-PB6B4702V | Resistor 47k 0.1 % 50 ppm/K 0.25 W 150 V 0805 thick film | no | FIT
R33 | 47k 0.1% | Resistor_SMD:R_0805_2012Metric | Panasonic | ERJ-PB6B4702V | Resistor 47k 0.1 % 50 ppm/K 0.25 W 150 V 0805 thick film | no | FIT
R34 | 47k 0.1% | Resistor_SMD:R_0805_2012Metric | Panasonic | ERJ-PB6B4702V | Resistor 47k 0.1 % 50 ppm/K 0.25 W 150 V 0805 thick film | no | FIT
R41 | 47k 0.1% | Resistor_SMD:R_0805_2012Metric | Panasonic | ERJ-PB6B4702V | Resistor 47k 0.1 % 50 ppm/K 0.25 W 150 V 0805 thick film | no | FIT
R42 | 47k 0.1% | Resistor_SMD:R_0805_2012Metric | Panasonic | ERJ-PB6B4702V | Resistor 47k 0.1 % 50 ppm/K 0.25 W 150 V 0805 thick film | no | FIT
R43 | 47k 0.1% | Resistor_SMD:R_0805_2012Metric | Panasonic | ERJ-PB6B4702V | Resistor 47k 0.1 % 50 ppm/K 0.25 W 150 V 0805 thick film | no | FIT
R44 | 47k 0.1% | Resistor_SMD:R_0805_2012Metric | Panasonic | ERJ-PB6B4702V | Resistor 47k 0.1 % 50 ppm/K 0.25 W 150 V 0805 thick film | no | FIT
R51 | 47k 0.1% | Resistor_SMD:R_0805_2012Metric | Panasonic | ERJ-PB6B4702V | Resistor 47k 0.1 % 50 ppm/K 0.25 W 150 V 0805 thick film | no | FIT
R52 | 47k 0.1% | Resistor_SMD:R_0805_2012Metric | Panasonic | ERJ-PB6B4702V | Resistor 47k 0.1 % 50 ppm/K 0.25 W 150 V 0805 thick film | no | FIT
R53 | 47k 0.1% | Resistor_SMD:R_0805_2012Metric | Panasonic | ERJ-PB6B4702V | Resistor 47k 0.1 % 50 ppm/K 0.25 W 150 V 0805 thick film | no | FIT
R54 | 47k 0.1% | Resistor_SMD:R_0805_2012Metric | Panasonic | ERJ-PB6B4702V | Resistor 47k 0.1 % 50 ppm/K 0.25 W 150 V 0805 thick film | no | FIT
R61 | 47k 0.1% | Resistor_SMD:R_0805_2012Metric | Panasonic | ERJ-PB6B4702V | Resistor 47k 0.1 % 50 ppm/K 0.25 W 150 V 0805 thick film | no | FIT
R62 | 47k 0.1% | Resistor_SMD:R_0805_2012Metric | Panasonic | ERJ-PB6B4702V | Resistor 47k 0.1 % 50 ppm/K 0.25 W 150 V 0805 thick film | no | FIT
R63 | 47k 0.1% | Resistor_SMD:R_0805_2012Metric | Panasonic | ERJ-PB6B4702V | Resistor 47k 0.1 % 50 ppm/K 0.25 W 150 V 0805 thick film | no | FIT
R64 | 47k 0.1% | Resistor_SMD:R_0805_2012Metric | Panasonic | ERJ-PB6B4702V | Resistor 47k 0.1 % 50 ppm/K 0.25 W 150 V 0805 thick film | no | FIT
R71 | 47k 0.1% | Resistor_SMD:R_0805_2012Metric | Panasonic | ERJ-PB6B4702V | Resistor 47k 0.1 % 50 ppm/K 0.25 W 150 V 0805 thick film | no | FIT
R72 | 47k 0.1% | Resistor_SMD:R_0805_2012Metric | Panasonic | ERJ-PB6B4702V | Resistor 47k 0.1 % 50 ppm/K 0.25 W 150 V 0805 thick film | no | FIT
R73 | 47k 0.1% | Resistor_SMD:R_0805_2012Metric | Panasonic | ERJ-PB6B4702V | Resistor 47k 0.1 % 50 ppm/K 0.25 W 150 V 0805 thick film | no | FIT
R74 | 47k 0.1% | Resistor_SMD:R_0805_2012Metric | Panasonic | ERJ-PB6B4702V | Resistor 47k 0.1 % 50 ppm/K 0.25 W 150 V 0805 thick film | no | FIT
R81 | 47k 0.1% | Resistor_SMD:R_0805_2012Metric | Panasonic | ERJ-PB6B4702V | Resistor 47k 0.1 % 50 ppm/K 0.25 W 150 V 0805 thick film | no | FIT
R82 | 47k 0.1% | Resistor_SMD:R_0805_2012Metric | Panasonic | ERJ-PB6B4702V | Resistor 47k 0.1 % 50 ppm/K 0.25 W 150 V 0805 thick film | no | FIT
R83 | 47k 0.1% | Resistor_SMD:R_0805_2012Metric | Panasonic | ERJ-PB6B4702V | Resistor 47k 0.1 % 50 ppm/K 0.25 W 150 V 0805 thick film | no | FIT
R84 | 47k 0.1% | Resistor_SMD:R_0805_2012Metric | Panasonic | ERJ-PB6B4702V | Resistor 47k 0.1 % 50 ppm/K 0.25 W 150 V 0805 thick film | no | FIT
R100 | 0R / AVDD1 star feed | Resistor_SMD:R_0603_1608Metric | Panasonic | ERJ-3GEY0R00V | Resistor 0 ohm jumper 0603 | no | FIT
R101 | 0R / DVDD feed | Resistor_SMD:R_0603_1608Metric | Panasonic | ERJ-3GEY0R00V | Resistor 0 ohm jumper 0603 | no | FIT
R201 | 49.9k 0.1% <=10ppm/K (RSET, + R207) | Resistor_SMD:R_0603_1608Metric | Panasonic | ERA-3ARB4992V | Resistor 49.9k 0.1 % 10 ppm/K 0.1 W 0603 thin film | no | FIT
R202 | 1.50k 1% | Resistor_SMD:R_0603_1608Metric | Panasonic | ERJ-3EKF1501V | Resistor 1.50k 1 % 100 ppm/K 0.1 W 0603 | no | FIT
R203 | 140k 0.1% | Resistor_SMD:R_0603_1608Metric | Panasonic | ERA-3AEB1403V | Resistor 140k 0.1 % 25 ppm/K 0.1 W 0603 thin film | no | FIT
R204 | 10k 0.1% | Resistor_SMD:R_0603_1608Metric | Panasonic | ERA-3ARB103V | Resistor 10k 0.1 % 10 ppm/K 0.1 W 0603 thin film | no | FIT
R205 | 4.7k bleeder >=1mA | Resistor_SMD:R_0603_1608Metric | Panasonic | ERJ-3EKF4701V | Resistor 4.7k 1 % 100 ppm/K 0.1 W 0603 | no | FIT
R206 | 100k | Resistor_SMD:R_0603_1608Metric | Panasonic | ERJ-3EKF1003V | Resistor 100k 1 % 100 ppm/K 0.1 W 0603 | no | FIT
R207 | 1.00k 0.1% <=10ppm/K (RSET trim) | Resistor_SMD:R_0603_1608Metric | Panasonic | ERA-3ARB102V | Resistor 1.00k 0.1 % 10 ppm/K 0.1 W 0603 thin film | no | FIT
R208 | 100R 1% 0.25W (clamp drain) | Resistor_SMD:R_1206_3216Metric | Panasonic | ERJ-8ENF1000V | Resistor 100R 1 % 100 ppm/K 0.25 W 1206 | no | FIT
R209 | 1M (clamp gate from +5VA) | Resistor_SMD:R_0603_1608Metric | Panasonic | ERJ-3EKF1004V | Resistor 1M 1 % 100 ppm/K 0.1 W 0603 | no | FIT
R210 | 31.6k 0.1% <=10ppm/K | Resistor_SMD:R_0603_1608Metric | Panasonic | ERA-3ARB3162V | Resistor 31.6k 0.1 % 10 ppm/K 0.1 W 0603 thin film | no | FIT
R211 | 9.88k 0.1% <=10ppm/K | Resistor_SMD:R_0603_1608Metric | Panasonic | ERA-3ARB9881V | Resistor 9.88k 0.1 % 10 ppm/K 0.1 W 0603 thin film | no | FIT
R212 | 4.7k | Resistor_SMD:R_0603_1608Metric | Panasonic | ERJ-3EKF4701V | Resistor 4.7k 1 % 100 ppm/K 0.1 W 0603 | no | FIT
R213 | 17.4k 0.1% <=10ppm/K | Resistor_SMD:R_0603_1608Metric | Panasonic | ERA-3ARB1742V | Resistor 17.4k 0.1 % 10 ppm/K 0.1 W 0603 thin film | no | FIT
R214 | 10k 0.1% <=10ppm/K | Resistor_SMD:R_0603_1608Metric | Panasonic | ERA-3ARB103V | Resistor 10k 0.1 % 10 ppm/K 0.1 W 0603 thin film | no | FIT
R215 | 4.7k | Resistor_SMD:R_0603_1608Metric | Panasonic | ERJ-3EKF4701V | Resistor 4.7k 1 % 100 ppm/K 0.1 W 0603 | no | FIT
R216 | 40.2k 0.1% <=10ppm/K | Resistor_SMD:R_0603_1608Metric | Panasonic | ERA-3ARB4022V | Resistor 40.2k 0.1 % 10 ppm/K 0.1 W 0603 thin film | no | FIT
R217 | 10k 0.1% <=10ppm/K | Resistor_SMD:R_0603_1608Metric | Panasonic | ERA-3ARB103V | Resistor 10k 0.1 % 10 ppm/K 0.1 W 0603 thin film | no | FIT
R218 | 4.7k | Resistor_SMD:R_0603_1608Metric | Panasonic | ERJ-3EKF4701V | Resistor 4.7k 1 % 100 ppm/K 0.1 W 0603 | no | FIT
R219 | 44.2k 0.1% <=10ppm/K | Resistor_SMD:R_0603_1608Metric | Panasonic | ERA-3ARB4422V | Resistor 44.2k 0.1 % 10 ppm/K 0.1 W 0603 thin film | no | FIT
R220 | 10k 0.1% <=10ppm/K | Resistor_SMD:R_0603_1608Metric | Panasonic | ERA-3ARB103V | Resistor 10k 0.1 % 10 ppm/K 0.1 W 0603 thin film | no | FIT
R221 | 4.7k | Resistor_SMD:R_0603_1608Metric | Panasonic | ERJ-3EKF4701V | Resistor 4.7k 1 % 100 ppm/K 0.1 W 0603 | no | FIT
R222 | 47.5k 0.1% <=10ppm/K | Resistor_SMD:R_0603_1608Metric | Panasonic | ERA-3ARB4752V | Resistor 47.5k 0.1 % 10 ppm/K 0.1 W 0603 thin film | no | FIT
R223 | 10k 0.1% <=10ppm/K | Resistor_SMD:R_0603_1608Metric | Panasonic | ERA-3ARB103V | Resistor 10k 0.1 % 10 ppm/K 0.1 W 0603 thin film | no | FIT
R224 | 4.7k | Resistor_SMD:R_0603_1608Metric | Panasonic | ERJ-3EKF4701V | Resistor 4.7k 1 % 100 ppm/K 0.1 W 0603 | no | FIT
R230 | 100k | Resistor_SMD:R_0603_1608Metric | Panasonic | ERJ-3EKF1003V | Resistor 100k 1 % 100 ppm/K 0.1 W 0603 | no | FIT
R231 | 100k | Resistor_SMD:R_0603_1608Metric | Panasonic | ERJ-3EKF1003V | Resistor 100k 1 % 100 ppm/K 0.1 W 0603 | no | FIT
R232 | 100k | Resistor_SMD:R_0603_1608Metric | Panasonic | ERJ-3EKF1003V | Resistor 100k 1 % 100 ppm/K 0.1 W 0603 | no | FIT
R233 | 100k | Resistor_SMD:R_0603_1608Metric | Panasonic | ERJ-3EKF1003V | Resistor 100k 1 % 100 ppm/K 0.1 W 0603 | no | FIT
R240 | 100k | Resistor_SMD:R_0603_1608Metric | Panasonic | ERJ-3EKF1003V | Resistor 100k 1 % 100 ppm/K 0.1 W 0603 | no | FIT
R300 | 4.7k | Resistor_SMD:R_0603_1608Metric | Panasonic | ERJ-3EKF4701V | Resistor 4.7k 1 % 100 ppm/K 0.1 W 0603 | no | FIT
R301 | 4.7k | Resistor_SMD:R_0603_1608Metric | Panasonic | ERJ-3EKF4701V | Resistor 4.7k 1 % 100 ppm/K 0.1 W 0603 | no | FIT
R302 | 100k provisional | Resistor_SMD:R_0603_1608Metric | Panasonic | ERJ-3EKF1003V | Resistor 100k 1 % 100 ppm/K 0.1 W 0603 | no | FIT
R303 | 100k provisional | Resistor_SMD:R_0603_1608Metric | Panasonic | ERJ-3EKF1003V | Resistor 100k 1 % 100 ppm/K 0.1 W 0603 | no | FIT
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
R353 | 100R | Resistor_SMD:R_0603_1608Metric | Panasonic | ERJ-3EKF1000V | Resistor 100R 1 % 100 ppm/K 0.1 W 0603 | no | FIT
R354 | 4.7k | Resistor_SMD:R_0603_1608Metric | Panasonic | ERJ-3EKF4701V | Resistor 4.7k 1 % 100 ppm/K 0.1 W 0603 | no | FIT
R356 | 10k | Resistor_SMD:R_0603_1608Metric | Panasonic | ERJ-3EKF1002V | Resistor 10k 1 % 100 ppm/K 0.1 W 0603 | no | FIT
R357 | 10k | Resistor_SMD:R_0603_1608Metric | Panasonic | ERJ-3EKF1002V | Resistor 10k 1 % 100 ppm/K 0.1 W 0603 | no | FIT
R358 | 4.7k | Resistor_SMD:R_0603_1608Metric | Panasonic | ERJ-3EKF4701V | Resistor 4.7k 1 % 100 ppm/K 0.1 W 0603 | no | FIT
R360 | 887k 1% | Resistor_SMD:R_0603_1608Metric | Panasonic | ERJ-3EKF8873V | Resistor 887k 1 % 100 ppm/K 0.1 W 0603 | no | FIT
R361 | 10k | Resistor_SMD:R_0603_1608Metric | Panasonic | ERJ-3EKF1002V | Resistor 10k 1 % 100 ppm/K 0.1 W 0603 | no | FIT
R362 | 10k 1% | Resistor_SMD:R_0603_1608Metric | Panasonic | ERJ-3EKF1002V | Resistor 10k 1 % 100 ppm/K 0.1 W 0603 | no | FIT
R363 | 100k 1% | Resistor_SMD:R_0603_1608Metric | Panasonic | ERJ-3EKF1003V | Resistor 100k 1 % 100 ppm/K 0.1 W 0603 | no | FIT
R380 | 100k reserved default | Resistor_SMD:R_0603_1608Metric | Panasonic | ERJ-3EKF1003V | Resistor 100k 1 % 100 ppm/K 0.1 W 0603 | no | FIT
R382 | 100k reserved default | Resistor_SMD:R_0603_1608Metric | Panasonic | ERJ-3EKF1003V | Resistor 100k 1 % 100 ppm/K 0.1 W 0603 | no | FIT
R383 | 100k reserved default | Resistor_SMD:R_0603_1608Metric | Panasonic | ERJ-3EKF1003V | Resistor 100k 1 % 100 ppm/K 0.1 W 0603 | no | FIT
R400 | 100R 1% (BATP sense) | Resistor_SMD:R_0603_1608Metric | Panasonic | ERJ-3EKF1000V | Resistor 100R 1 % 100 ppm/K 0.1 W 0603 | no | FIT
R401 | 6.04k 1% (PROG: 2S, 1.5 MHz) | Resistor_SMD:R_0603_1608Metric | Panasonic | ERJ-3EKF6041V | Resistor 6.04k 1 % 100 ppm/K 0.1 W 0603 | no | FIT
R402 | 27.0k 1% | Resistor_SMD:R_0603_1608Metric | Panasonic | ERJ-3EKF2702V | Resistor 27.0k 1 % 100 ppm/K 0.1 W 0603 | no | FIT
R403 | 10.0k 1% | Resistor_SMD:R_0603_1608Metric | Panasonic | ERJ-3EKF1002V | Resistor 10.0k 1 % 100 ppm/K 0.1 W 0603 | no | FIT
R404 | 5.23k 1% | Resistor_SMD:R_0603_1608Metric | Panasonic | ERJ-3EKF5231V | Resistor 5.23k 1 % 100 ppm/K 0.1 W 0603 | no | FIT
R405 | 30.1k 1% | Resistor_SMD:R_0603_1608Metric | Panasonic | ERJ-3EKF3012V | Resistor 30.1k 1 % 100 ppm/K 0.1 W 0603 | no | FIT
R406 | 100k | Resistor_SMD:R_0603_1608Metric | Panasonic | ERJ-3EKF1003V | Resistor 100k 1 % 100 ppm/K 0.1 W 0603 | no | FIT
R407 | 2.2k | Resistor_SMD:R_0603_1608Metric | Panasonic | ERJ-3EKF2201V | Resistor 2.2k 1 % 100 ppm/K 0.1 W 0603 | no | FIT
R408 | 10k | Resistor_SMD:R_0603_1608Metric | Panasonic | ERJ-3EKF1002V | Resistor 10k 1 % 100 ppm/K 0.1 W 0603 | no | FIT
R420 | 33R | Resistor_SMD:R_0603_1608Metric | Panasonic | ERJ-3EKF33R0V | Resistor 33R 1 % 100 ppm/K 0.1 W 0603 | no | FIT
R421 | 33R | Resistor_SMD:R_0603_1608Metric | Panasonic | ERJ-3EKF33R0V | Resistor 33R 1 % 100 ppm/K 0.1 W 0603 | no | FIT
R422 | 33R | Resistor_SMD:R_0603_1608Metric | Panasonic | ERJ-3EKF33R0V | Resistor 33R 1 % 100 ppm/K 0.1 W 0603 | no | FIT
R423 | 33R | Resistor_SMD:R_0603_1608Metric | Panasonic | ERJ-3EKF33R0V | Resistor 33R 1 % 100 ppm/K 0.1 W 0603 | no | FIT
R424 | 10k 1% | Resistor_SMD:R_0603_1608Metric | Panasonic | ERJ-3EKF1002V | Resistor 10k 1 % 100 ppm/K 0.1 W 0603 | no | FIT
R425 | 10k 1% | Resistor_SMD:R_0603_1608Metric | Panasonic | ERJ-3EKF1002V | Resistor 10k 1 % 100 ppm/K 0.1 W 0603 | no | FIT
R426 | 10k 1% | Resistor_SMD:R_0603_1608Metric | Panasonic | ERJ-3EKF1002V | Resistor 10k 1 % 100 ppm/K 0.1 W 0603 | no | FIT
R427 | 10k 1% | Resistor_SMD:R_0603_1608Metric | Panasonic | ERJ-3EKF1002V | Resistor 10k 1 % 100 ppm/K 0.1 W 0603 | no | FIT
R428 | 10k 1% | Resistor_SMD:R_0603_1608Metric | Panasonic | ERJ-3EKF1002V | Resistor 10k 1 % 100 ppm/K 0.1 W 0603 | no | FIT
R429 | 100k | Resistor_SMD:R_0603_1608Metric | Panasonic | ERJ-3EKF1003V | Resistor 100k 1 % 100 ppm/K 0.1 W 0603 | no | FIT
R430 | 10k 1% | Resistor_SMD:R_0603_1608Metric | Panasonic | ERJ-3EKF1002V | Resistor 10k 1 % 100 ppm/K 0.1 W 0603 | no | FIT
R431 | 100R | Resistor_SMD:R_0603_1608Metric | Panasonic | ERJ-3EKF1000V | Resistor 100R 1 % 100 ppm/K 0.1 W 0603 | no | FIT
R501 | 4.7k 0.1% | Resistor_SMD:R_0805_2012Metric | Panasonic | ERJ-PB6B4701V | Resistor 4.7k 0.1 % 50 ppm/K 0.25 W 150 V 0805 thick film | no | FIT
R502 | 4.7k 0.1% | Resistor_SMD:R_0805_2012Metric | Panasonic | ERJ-PB6B4701V | Resistor 4.7k 0.1 % 50 ppm/K 0.25 W 150 V 0805 thick film | no | FIT
R503 | 4.7k 0.1% | Resistor_SMD:R_0805_2012Metric | Panasonic | ERJ-PB6B4701V | Resistor 4.7k 0.1 % 50 ppm/K 0.25 W 150 V 0805 thick film | no | FIT
R504 | 4.7k 0.1% | Resistor_SMD:R_0805_2012Metric | Panasonic | ERJ-PB6B4701V | Resistor 4.7k 0.1 % 50 ppm/K 0.25 W 150 V 0805 thick film | no | FIT
R505 | 4.7k 0.1% | Resistor_SMD:R_0805_2012Metric | Panasonic | ERJ-PB6B4701V | Resistor 4.7k 0.1 % 50 ppm/K 0.25 W 150 V 0805 thick film | no | FIT
R506 | 4.7k 0.1% | Resistor_SMD:R_0805_2012Metric | Panasonic | ERJ-PB6B4701V | Resistor 4.7k 0.1 % 50 ppm/K 0.25 W 150 V 0805 thick film | no | FIT
R507 | 4.7k 0.1% | Resistor_SMD:R_0805_2012Metric | Panasonic | ERJ-PB6B4701V | Resistor 4.7k 0.1 % 50 ppm/K 0.25 W 150 V 0805 thick film | no | FIT
R508 | 4.7k 0.1% | Resistor_SMD:R_0805_2012Metric | Panasonic | ERJ-PB6B4701V | Resistor 4.7k 0.1 % 50 ppm/K 0.25 W 150 V 0805 thick film | no | FIT
R509 | 4.7k 0.1% | Resistor_SMD:R_0805_2012Metric | Panasonic | ERJ-PB6B4701V | Resistor 4.7k 0.1 % 50 ppm/K 0.25 W 150 V 0805 thick film | no | FIT
R510 | 4.7k 0.1% | Resistor_SMD:R_0805_2012Metric | Panasonic | ERJ-PB6B4701V | Resistor 4.7k 0.1 % 50 ppm/K 0.25 W 150 V 0805 thick film | no | FIT
R511 | 4.7k 0.1% | Resistor_SMD:R_0805_2012Metric | Panasonic | ERJ-PB6B4701V | Resistor 4.7k 0.1 % 50 ppm/K 0.25 W 150 V 0805 thick film | no | FIT
R512 | 4.7k 0.1% | Resistor_SMD:R_0805_2012Metric | Panasonic | ERJ-PB6B4701V | Resistor 4.7k 0.1 % 50 ppm/K 0.25 W 150 V 0805 thick film | no | FIT
R513 | 4.7k 0.1% | Resistor_SMD:R_0805_2012Metric | Panasonic | ERJ-PB6B4701V | Resistor 4.7k 0.1 % 50 ppm/K 0.25 W 150 V 0805 thick film | no | FIT
R514 | 4.7k 0.1% | Resistor_SMD:R_0805_2012Metric | Panasonic | ERJ-PB6B4701V | Resistor 4.7k 0.1 % 50 ppm/K 0.25 W 150 V 0805 thick film | no | FIT
R515 | 4.7k 0.1% | Resistor_SMD:R_0805_2012Metric | Panasonic | ERJ-PB6B4701V | Resistor 4.7k 0.1 % 50 ppm/K 0.25 W 150 V 0805 thick film | no | FIT
R516 | 4.7k 0.1% | Resistor_SMD:R_0805_2012Metric | Panasonic | ERJ-PB6B4701V | Resistor 4.7k 0.1 % 50 ppm/K 0.25 W 150 V 0805 thick film | no | FIT
R517 | 47k 0.1% | Resistor_SMD:R_0805_2012Metric | Panasonic | ERJ-PB6B4702V | Resistor 47k 0.1 % 50 ppm/K 0.25 W 150 V 0805 thick film | no | FIT
R518 | 47k 0.1% | Resistor_SMD:R_0805_2012Metric | Panasonic | ERJ-PB6B4702V | Resistor 47k 0.1 % 50 ppm/K 0.25 W 150 V 0805 thick film | no | FIT
R519 | 4.7k 0.1% | Resistor_SMD:R_0805_2012Metric | Panasonic | ERJ-PB6B4701V | Resistor 4.7k 0.1 % 50 ppm/K 0.25 W 150 V 0805 thick film | no | FIT
R600 | 620R 1% 0.25W | Resistor_SMD:R_1206_3216Metric | Panasonic | ERJ-8ENF6200V | Resistor 620R 1 % 100 ppm/K 0.25 W 1206 | no | FIT
R601 | 100R | Resistor_SMD:R_0603_1608Metric | Panasonic | ERJ-3EKF1000V | Resistor 100R 1 % 100 ppm/K 0.1 W 0603 | no | FIT
R610 | 1k | Resistor_SMD:R_0603_1608Metric | Panasonic | ERJ-3EKF1001V | Resistor 1k 1 % 100 ppm/K 0.1 W 0603 | no | FIT
R611 | 33k 0.1% | Resistor_SMD:R_0603_1608Metric | Panasonic | ERA-3ARB333V | Resistor 33k 0.1 % 10 ppm/K 0.1 W 0603 thin film | no | FIT
R612 | 64.9k 1% | Resistor_SMD:R_0603_1608Metric | Panasonic | ERJ-3EKF6492V | Resistor 64.9k 1 % 100 ppm/K 0.1 W 0603 | no | FIT
R613 | 1k 1% | Resistor_SMD:R_0603_1608Metric | Panasonic | ERJ-3EKF1001V | Resistor 1k 1 % 100 ppm/K 0.1 W 0603 | no | FIT
R614 | 10k | Resistor_SMD:R_0603_1608Metric | Panasonic | ERJ-3EKF1002V | Resistor 10k 1 % 100 ppm/K 0.1 W 0603 | no | FIT
R615 | 1M | Resistor_SMD:R_0603_1608Metric | Panasonic | ERJ-3EKF1004V | Resistor 1M 1 % 100 ppm/K 0.1 W 0603 | no | FIT
R616 | 100R | Resistor_SMD:R_0603_1608Metric | Panasonic | ERJ-3EKF1000V | Resistor 100R 1 % 100 ppm/K 0.1 W 0603 | no | FIT
R617 | 1k | Resistor_SMD:R_0603_1608Metric | Panasonic | ERJ-3EKF1001V | Resistor 1k 1 % 100 ppm/K 0.1 W 0603 | no | FIT
RB1 | 499k 0.1% | Resistor_SMD:R_0805_2012Metric | Panasonic | ERJ-PB6B4993V | Resistor 499k 0.1 % 50 ppm/K 0.25 W 150 V 0805 thick film | no | FIT
RB2 | 499k 0.1% | Resistor_SMD:R_0805_2012Metric | Panasonic | ERJ-PB6B4993V | Resistor 499k 0.1 % 50 ppm/K 0.25 W 150 V 0805 thick film | no | FIT
RFB1 | 1M | Resistor_SMD:R_0805_2012Metric | Panasonic | ERJ-PB6B1004V | Resistor 1M 0.1 % 50 ppm/K 0.25 W 150 V 0805 thick film | no | FIT
RZB1 | 100k 0.1% | Resistor_SMD:R_0805_2012Metric | Panasonic | ERJ-PB6B1003V | Resistor 100k 0.1 % 50 ppm/K 0.25 W 150 V 0805 thick film | no | FIT
SW300 | RESET | Button_Switch_SMD:SW_SPST_TL3342 | E-Switch | TL3342F160QG | Switch tactile SPST 6.2x5.2 mm SMD | no | FIT
SW301 | RECOVERY | Button_Switch_SMD:SW_SPST_TL3342 | E-Switch | TL3342F160QG | Switch tactile SPST 6.2x5.2 mm SMD | no | FIT
SW302 | RECORD | Button_Switch_SMD:SW_SPST_TL3342 | E-Switch | TL3342F160QG | Switch tactile SPST 6.2x5.2 mm SMD | no | FIT
SW400 | POWER (hold 1 s: on; 10 s: system reset) | Button_Switch_SMD:SW_SPST_TL3342 | E-Switch | TL3342F160QG | Switch tactile SPST 6.2x5.2 mm SMD | no | FIT
TP230 | RUN_ARMED | TestPoint:TestPoint_Pad_D1.0mm |  |  | Test pad (copper only, no part) | yes | PAD
TP420 | +3V3 | TestPoint:TestPoint_Pad_D1.0mm |  |  | Test pad (copper only, no part) | yes | PAD
TP421 | GND | TestPoint:TestPoint_Pad_D1.0mm |  |  | Test pad (copper only, no part) | yes | PAD
TP422 | BAT_WARN_OK | TestPoint:TestPoint_Pad_D1.0mm |  |  | Test pad (copper only, no part) | yes | PAD
TP423 | SYS_OK | TestPoint:TestPoint_Pad_D1.0mm |  |  | Test pad (copper only, no part) | yes | PAD
TP424 | PACK_OK | TestPoint:TestPoint_Pad_D1.0mm |  |  | Test pad (copper only, no part) | yes | PAD
TP425 | DIGITAL_OK | TestPoint:TestPoint_Pad_D1.0mm |  |  | Test pad (copper only, no part) | yes | PAD
U1 | ADS1299IPAGR | Package_QFP:TQFP-64_10x10mm_P0.5mm | Texas Instruments | ADS1299IPAGR | IC ADC 24-bit 8-ch biopotential AFE TQFP-64 | no | FIT
U201 | LT3045IDD#PBF | Package_DFN_QFN:DFN-10-1EP_3x3mm_P0.5mm_EP1.65x2.38mm | Analog Devices | LT3045IDD#PBF | IC LDO 500 mA ultralow noise DFN-10 3x3 | no | FIT
U210 | TPS389001DSET | Package_SON:WSON-6_1.5x1.5mm_P0.5mm | Texas Instruments | TPS389001DSET | IC voltage supervisor adj., open drain, WSON-6 1.5x1.5 | no | FIT
U211 | TPS389001DSET | Package_SON:WSON-6_1.5x1.5mm_P0.5mm | Texas Instruments | TPS389001DSET | IC voltage supervisor adj., open drain, WSON-6 1.5x1.5 | no | FIT
U212 | TPS389001DSET | Package_SON:WSON-6_1.5x1.5mm_P0.5mm | Texas Instruments | TPS389001DSET | IC voltage supervisor adj., open drain, WSON-6 1.5x1.5 | no | FIT
U213 | TPS389001DSET | Package_SON:WSON-6_1.5x1.5mm_P0.5mm | Texas Instruments | TPS389001DSET | IC voltage supervisor adj., open drain, WSON-6 1.5x1.5 | no | FIT
U214 | TPS389001DSET | Package_SON:WSON-6_1.5x1.5mm_P0.5mm | Texas Instruments | TPS389001DSET | IC voltage supervisor adj., open drain, WSON-6 1.5x1.5 | no | FIT
U220 | SN74AUP1G08DBVR | Package_TO_SOT_SMD:SOT-23-5 | Texas Instruments | SN74AUP1G08DBVR | IC AND gate 1-ch Schmitt SOT-23-5 | no | FIT
U221 | SN74AUP1G08DBVR | Package_TO_SOT_SMD:SOT-23-5 | Texas Instruments | SN74AUP1G08DBVR | IC AND gate 1-ch Schmitt SOT-23-5 | no | FIT
U222 | SN74AUP1G08DBVR | Package_TO_SOT_SMD:SOT-23-5 | Texas Instruments | SN74AUP1G08DBVR | IC AND gate 1-ch Schmitt SOT-23-5 | no | FIT
U223 | SN74AUP1G08DBVR | Package_TO_SOT_SMD:SOT-23-5 | Texas Instruments | SN74AUP1G08DBVR | IC AND gate 1-ch Schmitt SOT-23-5 | no | FIT
U224 | SN74AUP1G08DBVR | Package_TO_SOT_SMD:SOT-23-5 | Texas Instruments | SN74AUP1G08DBVR | IC AND gate 1-ch Schmitt SOT-23-5 | no | FIT
U225 | SN74AUP1G08DBVR | Package_TO_SOT_SMD:SOT-23-5 | Texas Instruments | SN74AUP1G08DBVR | IC AND gate 1-ch Schmitt SOT-23-5 | no | FIT
U226 | SN74AUP1G08DBVR | Package_TO_SOT_SMD:SOT-23-5 | Texas Instruments | SN74AUP1G08DBVR | IC AND gate 1-ch Schmitt SOT-23-5 | no | FIT
U227 | SN74LVC1G74DCUR | Package_SO:VSSOP-8_2.3x2mm_P0.5mm | Texas Instruments | SN74LVC1G74DCUR | IC D flip-flop VSSOP-8 | no | FIT
U228 | SN74AUP1G08DBVR | Package_TO_SOT_SMD:SOT-23-5 | Texas Instruments | SN74AUP1G08DBVR | IC AND gate 1-ch Schmitt SOT-23-5 | no | FIT
U240 | TPS62162DSGR | Package_SON:Texas_DSG0008A_WSON-8-1EP_2x2mm_P0.5mm_EP0.9x1.6mm | Texas Instruments | TPS62162DSGR | IC buck 3.3 V 1 A WSON-8 2x2 | no | FIT
U300 | NINA-B306-00B | EEG:u-blox_NINA-B306 | u-blox | NINA-B306-00B | Module BLE 5 nRF52840 internal antenna | no | FIT
U310 | SN74LVC1G126DBVR | Package_TO_SOT_SMD:SOT-23-5 | Texas Instruments | SN74LVC1G126DBVR | IC buffer 3-state SOT-23-5 | no | FIT
U311 | SN74LVC1G126DBVR | Package_TO_SOT_SMD:SOT-23-5 | Texas Instruments | SN74LVC1G126DBVR | IC buffer 3-state SOT-23-5 | no | FIT
U312 | SN74LVC1G126DBVR | Package_TO_SOT_SMD:SOT-23-5 | Texas Instruments | SN74LVC1G126DBVR | IC buffer 3-state SOT-23-5 | no | FIT
U313 | SN74LVC1G126DBVR | Package_TO_SOT_SMD:SOT-23-5 | Texas Instruments | SN74LVC1G126DBVR | IC buffer 3-state SOT-23-5 | no | FIT
U314 | SN74LVC1G126DBVR | Package_TO_SOT_SMD:SOT-23-5 | Texas Instruments | SN74LVC1G126DBVR | IC buffer 3-state SOT-23-5 | no | FIT
U320 | TUSB320LAIRWBR | EEG:Texas_RWB0012A_X2QFN-12_1.6x1.6mm_P0.4mm | Texas Instruments | TUSB320LAIRWBR | IC USB-C CC controller X2QFN-12 | no | FIT
U321 | SN74LVC1G14DBVR | Package_TO_SOT_SMD:SOT-23-5 | Texas Instruments | SN74LVC1G14DBVR | IC inverter Schmitt SOT-23-5 | no | FIT
U322 | SN74LVC1G14DBVR | Package_TO_SOT_SMD:SOT-23-5 | Texas Instruments | SN74LVC1G14DBVR | IC inverter Schmitt SOT-23-5 | no | FIT
U323 | TPD1S514-1YZR (VBUS OVP 5.9-5.99 V) | EEG:Texas_YZ0012_DSBGA-12_P0.4mm | Texas Instruments | TPD1S514-1YZR | IC USB VBUS overvoltage switch 30 V, OVP 5.95 V, 39 mOhm, WCSP-12 | no | FIT
U324 | TPS7A2050PDBVR (module VBUS 5.0 V) | Package_TO_SOT_SMD:SOT-23-5 | Texas Instruments | TPS7A2050PDBVR | IC LDO 5.0 V 300 mA low noise SOT-23-5 | no | FIT
U330 | SN74AUP1G08DBVR | Package_TO_SOT_SMD:SOT-23-5 | Texas Instruments | SN74AUP1G08DBVR | IC AND gate 1-ch Schmitt SOT-23-5 | no | FIT
U331 | SN74AUP1G08DBVR | Package_TO_SOT_SMD:SOT-23-5 | Texas Instruments | SN74AUP1G08DBVR | IC AND gate 1-ch Schmitt SOT-23-5 | no | FIT
U332 | SN74AUP1G08DBVR | Package_TO_SOT_SMD:SOT-23-5 | Texas Instruments | SN74AUP1G08DBVR | IC AND gate 1-ch Schmitt SOT-23-5 | no | FIT
U333 | SN74AUP1G08DBVR | Package_TO_SOT_SMD:SOT-23-5 | Texas Instruments | SN74AUP1G08DBVR | IC AND gate 1-ch Schmitt SOT-23-5 | no | FIT
U400 | BQ25798RQMR (I2C 0x6B) | EEG:Texas_RQM0029A_VQFN-HR-29_4x4mm | Texas Instruments | BQ25798RQMR | IC buck-boost charger 1-4S VQFN-HR-29 | no | FIT
U500 | OPA376AIDBVR | Package_TO_SOT_SMD:SOT-23-5 | Texas Instruments | OPA376AIDBVR | IC op-amp low noise RRIO SOT-23-5 | no | FIT
U600 | TLP2761(TP,E) | Package_SO:SO-6L_10x3.84mm_P1.27mm | Toshiba | TLP2761(TP,E) | Optocoupler logic out 5 kVrms SO6L | no | FIT
U610 | TLV9061IDBVR | Package_TO_SOT_SMD:SOT-23-5 | Texas Instruments | TLV9061IDBVR | IC op-amp 10 MHz RRIO SOT-23-5 | no | FIT
U611 | TLV7011DCKR | Package_TO_SOT_SMD:SOT-353_SC-70-5 | Texas Instruments | TLV7011DCKR | IC comparator push-pull SC-70-5 | no | FIT
U612 | MCP4725A0T-E/CH (I2C 0x60) | Package_TO_SOT_SMD:SOT-23-6 | Microchip | MCP4725A0T-E/CH | IC DAC 12-bit I2C SOT-23-6 | no | FIT
Y340 | SiT8008BIF11-33E-2.048000 (2.048 MHz +/-20 ppm) | Oscillator:Oscillator_SMD_SiT_PQFN-4Pin_2.5x2.0mm | SiTime | SIT8008BIF11-33E-2.048000 | Oscillator 2.048 MHz +/-20 ppm 3.3 V 2.5x2.0 | no | FIT
