MariusFauteux/EEG-PCB/hardware/checks/bom_cost.md

# Costed BOM, 5 prototype boards (Rev C12)

Parts only, EUR excluding VAT, prices read on 2026-11-08. 86 lines, 1900 parts.

- Total for 5 boards: **€952.39** (≈ €190.48 per board; with 19 % VAT ≈ €226.67)
- confirmed: €834.76 (87.6 %)
- family: €76.62 (8.0 %)
- estimate: €41.00 (4.3 %)

Not included: PCB fabrication, assembly, enclosure, microSD card, battery pack, harness and cables, shipping.

| MPN | Manufacturer | Per board | Qty | Unit € | Total € | Status |
|---|---|---:|---:|---:|---:|---|
| ADS1299IPAGR | Texas Instruments | 1 | 5 | 78.630 | 393.15 | confirmed |
| 031-6575 | Amphenol RF | 1 | 5 | 11.180 | 55.90 | confirmed |
| LT3045IDD#PBF | Analog Devices | 1 | 5 | 10.090 | 50.45 | confirmed |
| NINA-B306-00B | u-blox | 1 | 5 | 8.810 | 44.05 | confirmed |
| TPS389001DSET | Texas Instruments | 5 | 25 | 1.330 | 33.26 | confirmed |
| BQ25798RQMR | Texas Instruments | 1 | 5 | 5.240 | 26.20 | confirmed |
| TPD2E2U06DCKR | Texas Instruments | 18 | 90 | 0.264 | 23.80 | confirmed |
| SN74AUP1G08DBVR | Texas Instruments | 12 | 60 | 0.330 | 19.80 | confirmed |
| GRM32ER71E226KE15L | Murata | 10 | 50 | 0.339 | 16.96 | confirmed |
| GCM188R71H104KA57D | Murata | 52 | 260 | 0.063 | 16.38 | confirmed |
| DM3AT-SF-PEJM5 | Hirose | 1 | 5 | 3.150 | 15.75 | confirmed |
| ERJ-PB6B4702V | Panasonic | 34 | 170 | 0.087 | 14.76 | confirmed |
| GRM31CR71E106KA12L | Murata | 13 | 65 | 0.220 | 14.30 | estimate |
| SIT8008BIF11-33E-2.048000 | SiTime | 1 | 5 | 2.260 | 11.30 | confirmed |
| XFL4020-222MEC | Coilcraft | 1 | 5 | 2.200 | 11.00 | family |
| XFL4020-102MEC | Coilcraft | 1 | 5 | 2.200 | 11.00 | family |
| OPA376AIDBVR | Texas Instruments | 1 | 5 | 1.800 | 9.00 | confirmed |
| TL3342F160QG | E-Switch | 4 | 20 | 0.449 | 8.98 | confirmed |
| TPS62162DSGR | Texas Instruments | 1 | 5 | 1.770 | 8.85 | confirmed |
| ERJ-PB6B4701V | Panasonic | 17 | 85 | 0.099 | 8.43 | family |
| 16SVP100M | Panasonic | 1 | 5 | 1.680 | 8.40 | confirmed |
| TUSB320LAIRWBR | Texas Instruments | 1 | 5 | 1.620 | 8.10 | confirmed |
| GCM21BR71E105KA56L | Murata | 16 | 80 | 0.100 | 8.00 | estimate |
| 60900213421 | Wurth Elektronik | 10 | 50 | 0.150 | 7.50 | estimate |
| ERA-3ARB103V | Panasonic | 5 | 25 | 0.295 | 7.38 | family |
| T491D107K010AT | KEMET | 1 | 5 | 1.460 | 7.30 | confirmed |
| TPD1S514-1YZR | Texas Instruments | 1 | 5 | 1.290 | 6.45 | confirmed |
| TLP2761(TP,E) | Toshiba | 1 | 5 | 1.190 | 5.95 | confirmed |
| MCP4725A0T-E/CH | Microchip | 1 | 5 | 1.130 | 5.65 | confirmed |
| GRM31C5C1H104JA01L | Murata | 2 | 10 | 0.450 | 4.50 | estimate |
| CSD17381F4 | Texas Instruments | 2 | 10 | 0.420 | 4.20 | confirmed |
| GCM1885C1H221JA16D | Murata | 8 | 40 | 0.101 | 4.04 | family |
| 61202021621 | Wurth Elektronik | 1 | 5 | 0.800 | 4.00 | confirmed |
| USB4105-GF-A | GCT | 1 | 5 | 0.710 | 3.55 | confirmed |
| 3220-10-0300-00 | CNC Tech | 1 | 5 | 0.670 | 3.35 | confirmed |
| CSD17571Q2 | Texas Instruments | 1 | 5 | 0.670 | 3.35 | confirmed |
| 61300311121 | Wurth Elektronik | 8 | 40 | 0.079 | 3.17 | confirmed |
| TLV9061IDBVR | Texas Instruments | 1 | 5 | 0.630 | 3.15 | confirmed |
| SN74LVC1G126DBVR | Texas Instruments | 5 | 25 | 0.120 | 3.00 | confirmed |
| TLV7011DCKR | Texas Instruments | 1 | 5 | 0.600 | 3.00 | estimate |
| SN74LVC1G74DCUR | Texas Instruments | 1 | 5 | 0.560 | 2.80 | confirmed |
| GCM1885C1H103JA16D | Murata | 5 | 25 | 0.101 | 2.53 | family |
| ERJ-3EKF1002V | Panasonic | 25 | 125 | 0.017 | 2.16 | confirmed |
| ERJ-3EKF1003V | Panasonic | 24 | 120 | 0.017 | 2.08 | family |
| ERA-3ARB4992V | Panasonic | 1 | 5 | 0.360 | 1.80 | confirmed |
| ERA-3AEB1403V | Panasonic | 1 | 5 | 0.360 | 1.80 | family |
| ERA-3ARB102V | Panasonic | 1 | 5 | 0.360 | 1.80 | family |
| ERA-3ARB3162V | Panasonic | 1 | 5 | 0.360 | 1.80 | family |
| ERA-3ARB9881V | Panasonic | 1 | 5 | 0.360 | 1.80 | family |
| ERA-3ARB1742V | Panasonic | 1 | 5 | 0.360 | 1.80 | family |
| ERA-3ARB4022V | Panasonic | 1 | 5 | 0.360 | 1.80 | family |
| ERA-3ARB4422V | Panasonic | 1 | 5 | 0.360 | 1.80 | family |
| ERA-3ARB4752V | Panasonic | 1 | 5 | 0.360 | 1.80 | family |
| ERA-3ARB333V | Panasonic | 1 | 5 | 0.360 | 1.80 | family |
| TPS7A2050PDBVR | Texas Instruments | 1 | 5 | 0.350 | 1.75 | confirmed |
| GRM21BR71C475KE51L | Murata | 2 | 10 | 0.160 | 1.60 | estimate |
| BSS138 | onsemi | 1 | 5 | 0.290 | 1.45 | confirmed |
| ERJ-PB6B4993V | Panasonic | 2 | 10 | 0.143 | 1.43 | family |
| ERJ-PB6B1004V | Panasonic | 1 | 5 | 0.270 | 1.35 | family |
| ERJ-PB6B1003V | Panasonic | 1 | 5 | 0.270 | 1.35 | family |
| ERJ-3EKF33R0V | Panasonic | 12 | 60 | 0.021 | 1.26 | family |
| BAT54,215 | Nexperia | 2 | 10 | 0.120 | 1.20 | confirmed |
| SN74LVC1G14DBVR | Texas Instruments | 2 | 10 | 0.120 | 1.20 | confirmed |
| ERJ-3EKF1000V | Panasonic | 9 | 45 | 0.026 | 1.15 | family |
| S2B-PH-K-S | JST | 2 | 10 | 0.110 | 1.10 | confirmed |
| GCM21BR71H105KA03L | Murata | 1 | 5 | 0.210 | 1.05 | confirmed |
| ERJ-3EKF4701V | Panasonic | 10 | 50 | 0.021 | 1.05 | family |
| GCM188R71H473KA55D | Murata | 2 | 10 | 0.101 | 1.01 | family |
| GCM1555C1H150JA16D | Murata | 1 | 5 | 0.180 | 0.90 | family |
| 1N4148WS-7-F | Diodes Inc. | 1 | 5 | 0.160 | 0.80 | confirmed |
| 61300211121 | Wurth Elektronik | 2 | 10 | 0.080 | 0.80 | estimate |
| S3B-PH-K-S | JST | 1 | 5 | 0.130 | 0.65 | confirmed |
| LTST-C190GKT | Lite-On | 1 | 5 | 0.120 | 0.60 | confirmed |
| ERJ-3EKF1001V | Panasonic | 3 | 15 | 0.035 | 0.53 | family |
| ERJ-8ENF1000V | Panasonic | 1 | 5 | 0.100 | 0.50 | estimate |
| ERJ-8ENF6200V | Panasonic | 1 | 5 | 0.100 | 0.50 | estimate |
| ERJ-3EKF1501V | Panasonic | 1 | 5 | 0.090 | 0.45 | family |
| ERJ-3EKF8873V | Panasonic | 1 | 5 | 0.090 | 0.45 | family |
| ERJ-3EKF6041V | Panasonic | 1 | 5 | 0.090 | 0.45 | family |
| ERJ-3EKF2702V | Panasonic | 1 | 5 | 0.090 | 0.45 | family |
| ERJ-3EKF5231V | Panasonic | 1 | 5 | 0.090 | 0.45 | family |
| ERJ-3EKF3012V | Panasonic | 1 | 5 | 0.090 | 0.45 | family |
| ERJ-3EKF2201V | Panasonic | 1 | 5 | 0.090 | 0.45 | family |
| ERJ-3EKF6492V | Panasonic | 1 | 5 | 0.090 | 0.45 | family |
| ERJ-3EKF1004V | Panasonic | 2 | 10 | 0.035 | 0.35 | family |
| ERJ-3GEY0R00V | Panasonic | 2 | 10 | 0.030 | 0.30 | estimate |
