MariusFauteux/EEG-PCB/hardware/checks/validation.md

# Rev C validation (C12, Step 14)

486 netlist assertions passed. KiCad ERC: 0 errors, 0 warnings. Linear calculations are estimates; no physical testing performed. Visual sheet inspection is a separate manual step.

- PASS: Module pad 1: MCU_SCLK
- PASS: Module pad 2: MCU_MOSI
- PASS: Module pad 3: HOST_MISO
- PASS: Module pad 4: MCU_CS_N
- PASS: Module pad 5: HOST_DRDY_N
- PASS: Module pad 7: MCU_START
- PASS: Module pad 32: TRIGGER_ISO
- PASS: Module pad 33: PHOTO_EDGE
- PASS: Module pad 34: ADC_RESET_REQUEST
- PASS: Module pad 42: POWER_SDA
- PASS: Module pad 44: POWER_SCL
- PASS: Module pad 43: USB_CC_INT_N
- PASS: Module pad 45: CHARGER_INT_N
- PASS: Module pad 46: RECOVERY_BUTTON
- PASS: Module pad 52: SD_SCLK
- PASS: Module pad 50: SD_MOSI
- PASS: Module pad 48: SD_MISO
- PASS: Module pad 51: SD_CS_N
- PASS: Module pad 47: SD_DETECT_N
- PASS: Module pad 49: SD_POWER_EN
- PASS: Module pad 16: MCU_PWDN_N
- PASS: Module pad 17: ANALOG_OK
- PASS: Module pad 18: DIGITAL_OK
- PASS: Module pad 20: BAT_WARN_OK
- PASS: Module pad 21: CHARGE_REQUEST
- PASS: Module pad 22: RUN_REQUEST
- PASS: Module pad 23: STATUS_LED
- PASS: Module pad 24: RECORD_BUTTON
- PASS: Module pad 25: PHOTO_MONITOR
- PASS: Module pad 27: PACK_MONITOR
- PASS: Module pad 35: USB_PRESENT
- PASS: Module pad 36: INTERLOCK_CLOSED
- PASS: Module pad 37: POWER_BUTTON_N
- PASS: Module pad 38: SYS_OK
- PASS: Module pad 39: PACK_OK
- PASS: Module pad 6: GND
- PASS: Module pad 9: +3V3
- PASS: Module pad 10: +3V3
- PASS: Module pad 11: SWCLK_MCU
- PASS: Module pad 12: GND
- PASS: Module pad 13: NC
- PASS: Module pad 14: GND
- PASS: Module pad 15: SWDIO_MCU
- PASS: Module pad 19: DIGITAL_OK
- PASS: Module pad 26: GND
- PASS: Module pad 28: NC
- PASS: Module pad 29: NC
- PASS: Module pad 30: GND
- PASS: Module pad 31: MCU_VBUS
- PASS: Module pad 53: GND
- PASS: Module pad 54: USB_DP
- PASS: Module pad 55: USB_DM
- PASS: Module pad 8: SWO_MCU
- PASS: Module pad 40: NC
- PASS: Module pad 41: NC
- PASS: Module pad EGP: GND
- PASS: Module pad EAGP: GND
- PASS: 35 distinct module GPIO allocations
- PASS: U310 input from correct MCU pad
- PASS: U310 buffered series path to ADC pin 40
- PASS: U310 startup pulldown and enable
- PASS: U311 input from correct MCU pad
- PASS: U311 buffered series path to ADC pin 34
- PASS: U311 startup pulldown and enable
- PASS: U312 input from correct MCU pad
- PASS: U312 buffered series path to ADC pin 39
- PASS: U312 startup pulldown and enable
- PASS: U313 input from correct MCU pad
- PASS: U313 buffered series path to ADC pin 38
- PASS: U313 startup pulldown and enable
- PASS: U314 input from correct MCU pad
- PASS: U314 buffered series path to ADC pin 35
- PASS: U314 startup pulldown and enable
- PASS: ADC DOUT return path
- PASS: ADC DRDY return path
- PASS: ADC reset uses hardware-gated reset through series resistor
- PASS: U330 hardware gate connections
- PASS: U331 hardware gate connections
- PASS: U332 hardware gate connections
- PASS: U333 hardware gate connections
- PASS: Service gates cascaded
- PASS: USB-C A6: USB_DP
- PASS: USB-C B6: USB_DP
- PASS: USB-C A7: USB_DM
- PASS: USB-C B7: USB_DM
- PASS: USB-C A5: CC1
- PASS: USB-C B5: CC2
- PASS: CC controller sink mode / I2C address strap
- PASS: VBUS detector through 887k resistor
- PASS: D310 DCK ESD pin mapping
- PASS: D311 DCK ESD pin mapping
- PASS: D312 DCK ESD pin mapping
- PASS: VBUS / 3V3 / SYS / PACK_POS / PACK_IN / GND are distinct nets
- PASS: Supervisor, reset button and SWD reset converge on MCU reset
- PASS: SWD presence input and default pullup
- PASS: SWDIO access
- PASS: SWCLK access
- PASS: Obsolete host header, regulator and reset stage removed
- PASS: All 64 ADC pads represented, including explicit NCs
- PASS: KiCad ERC: zero errors; no warnings other than local footprint-library configuration
- PASS: microSD pad 1 = CARD_DAT2
- PASS: microSD pad 2 = CARD_CS_N
- PASS: microSD pad 3 = CARD_DI
- PASS: microSD pad 5 = CARD_CLK
- PASS: microSD pad 7 = CARD_DO
- PASS: microSD pad 8 = CARD_DAT1
- PASS: microSD supply/shield pad 4
- PASS: microSD supply/shield pad 6
- PASS: microSD supply/shield pad 10
- PASS: microSD supply/shield pad SH
- PASS: R420: correct host-to-card series path
- PASS: R421: correct host-to-card series path
- PASS: R422: correct host-to-card series path
- PASS: R423: correct host-to-card series path
- PASS: R424: required CMD/DAT pullup
- PASS: R425: required CMD/DAT pullup
- PASS: R426: required CMD/DAT pullup
- PASS: R427: required CMD/DAT pullup
- PASS: R428: required CMD/DAT pullup
- PASS: Card detect contact reaches MCU through RC network
- PASS: Card detect default absent high
- PASS: D420: ESD I/O and ground mapping
- PASS: D421: ESD I/O and ground mapping
- PASS: D422: ESD I/O and ground mapping
- PASS: D423 card detect / VDD ESD mapping
- PASS: C420: local card bypass
- PASS: C421: local card bypass
- PASS: Test access: +3V3
- PASS: Test access: GND
- PASS: Test access: BAT_WARN_OK
- PASS: Test access: SYS_OK
- PASS: Test access: PACK_OK
- PASS: Test access: DIGITAL_OK
- PASS: Superseded SD placeholder resistors removed
- PASS: SD_POWER_EN reserved only, no switched card domain
- PASS: microSD footprint: pads 1-10 plus four SH shell pads, all reached by symbol pin SH on GND
- PASS: R424 value 10k 1%
- PASS: R425 value 10k 1%
- PASS: R426 value 10k 1%
- PASS: R427 value 10k 1%
- PASS: R428 value 10k 1%
- PASS: R420 value 33R
- PASS: R421 value 33R
- PASS: R422 value 33R
- PASS: R423 value 33R
- PASS: 1P: two 47k series resistors
- PASS: 1P: clamp between 94k and 4.7k
- PASS: 1P: post-clamp resistor to ADC
- PASS: R11 value
- PASS: R12 value
- PASS: R501 value
- PASS: 1N: two 47k series resistors
- PASS: 1N: clamp between 94k and 4.7k
- PASS: 1N: post-clamp resistor to ADC
- PASS: R13 value
- PASS: R14 value
- PASS: R502 value
- PASS: CH1 TVS ground
- PASS: CH1 capacitor value
- PASS: CH1 differential capacitor
- PASS: CH1 reference selection (JP pin 3 on buffered REF_BUF)
- PASS: 2P: two 47k series resistors
- PASS: 2P: clamp between 94k and 4.7k
- PASS: 2P: post-clamp resistor to ADC
- PASS: R21 value
- PASS: R22 value
- PASS: R503 value
- PASS: 2N: two 47k series resistors
- PASS: 2N: clamp between 94k and 4.7k
- PASS: 2N: post-clamp resistor to ADC
- PASS: R23 value
- PASS: R24 value
- PASS: R504 value
- PASS: CH2 TVS ground
- PASS: CH2 capacitor value
- PASS: CH2 differential capacitor
- PASS: CH2 reference selection (JP pin 3 on buffered REF_BUF)
- PASS: 3P: two 47k series resistors
- PASS: 3P: clamp between 94k and 4.7k
- PASS: 3P: post-clamp resistor to ADC
- PASS: R31 value
- PASS: R32 value
- PASS: R505 value
- PASS: 3N: two 47k series resistors
- PASS: 3N: clamp between 94k and 4.7k
- PASS: 3N: post-clamp resistor to ADC
- PASS: R33 value
- PASS: R34 value
- PASS: R506 value
- PASS: CH3 TVS ground
- PASS: CH3 capacitor value
- PASS: CH3 differential capacitor
- PASS: CH3 reference selection (JP pin 3 on buffered REF_BUF)
- PASS: 4P: two 47k series resistors
- PASS: 4P: clamp between 94k and 4.7k
- PASS: 4P: post-clamp resistor to ADC
- PASS: R41 value
- PASS: R42 value
- PASS: R507 value
- PASS: 4N: two 47k series resistors
- PASS: 4N: clamp between 94k and 4.7k
- PASS: 4N: post-clamp resistor to ADC
- PASS: R43 value
- PASS: R44 value
- PASS: R508 value
- PASS: CH4 TVS ground
- PASS: CH4 capacitor value
- PASS: CH4 differential capacitor
- PASS: CH4 reference selection (JP pin 3 on buffered REF_BUF)
- PASS: 5P: two 47k series resistors
- PASS: 5P: clamp between 94k and 4.7k
- PASS: 5P: post-clamp resistor to ADC
- PASS: R51 value
- PASS: R52 value
- PASS: R509 value
- PASS: 5N: two 47k series resistors
- PASS: 5N: clamp between 94k and 4.7k
- PASS: 5N: post-clamp resistor to ADC
- PASS: R53 value
- PASS: R54 value
- PASS: R510 value
- PASS: CH5 TVS ground
- PASS: CH5 capacitor value
- PASS: CH5 differential capacitor
- PASS: CH5 reference selection (JP pin 3 on buffered REF_BUF)
- PASS: 6P: two 47k series resistors
- PASS: 6P: clamp between 94k and 4.7k
- PASS: 6P: post-clamp resistor to ADC
- PASS: R61 value
- PASS: R62 value
- PASS: R511 value
- PASS: 6N: two 47k series resistors
- PASS: 6N: clamp between 94k and 4.7k
- PASS: 6N: post-clamp resistor to ADC
- PASS: R63 value
- PASS: R64 value
- PASS: R512 value
- PASS: CH6 TVS ground
- PASS: CH6 capacitor value
- PASS: CH6 differential capacitor
- PASS: CH6 reference selection (JP pin 3 on buffered REF_BUF)
- PASS: 7P: two 47k series resistors
- PASS: 7P: clamp between 94k and 4.7k
- PASS: 7P: post-clamp resistor to ADC
- PASS: R71 value
- PASS: R72 value
- PASS: R513 value
- PASS: 7N: two 47k series resistors
- PASS: 7N: clamp between 94k and 4.7k
- PASS: 7N: post-clamp resistor to ADC
- PASS: R73 value
- PASS: R74 value
- PASS: R514 value
- PASS: CH7 TVS ground
- PASS: CH7 capacitor value
- PASS: CH7 differential capacitor
- PASS: CH7 reference selection (JP pin 3 on buffered REF_BUF)
- PASS: 8P: two 47k series resistors
- PASS: 8P: clamp between 94k and 4.7k
- PASS: 8P: post-clamp resistor to ADC
- PASS: R81 value
- PASS: R82 value
- PASS: R515 value
- PASS: 8N: two 47k series resistors
- PASS: 8N: clamp between 94k and 4.7k
- PASS: 8N: post-clamp resistor to ADC
- PASS: R83 value
- PASS: R84 value
- PASS: R516 value
- PASS: CH8 TVS ground
- PASS: CH8 capacitor value
- PASS: CH8 differential capacitor
- PASS: CH8 reference selection (JP pin 3 on buffered REF_BUF)
- PASS: RFB1 value 1M
- PASS: CFB1 value 10n C0G 5% 50V
- PASS: RZB1 value 100k 0.1%
- PASS: RB1 value 499k 0.1%
- PASS: RB2 value 499k 0.1%
- PASS: BIASOUT drives RFB1, CFB1 and RB1
- PASS: BIASINV joins RFB1 and RZB1
- PASS: CFB1-RZB1 series node has no other connection
- PASS: D509 clamps the RB1/RB2 midpoint to GND
- PASS: BIAS electrode (J500 pin 18) reached only through RB2 and the normally open test link JP10
- PASS: BIASREF and BIASIN tied to AVSS (firmware must set BIASREF_INT=1)
- PASS: CLKSEL pulled to DGND through R340: external clock selected
- PASS: Y340 output reaches ADC CLK through R349; R341 default pulldown
- PASS: Y340 powered from ADC DVDD rail
- PASS: Y340 OE pulled up (output enabled)
- PASS: R341 value 100k
- PASS: R349 value 33R near Y340
- PASS: Trigger isolated side (J600, R600, D600, U600 pins 1/3) has no connection to any other net
- PASS: Trigger: R600 to LED anode; D600 reverse clamp across LED
- PASS: TLP2761 output to TRIGGER_ISO (pad 32) through R601
- PASS: Trigger part values
- PASS: Photodiode cathode clamped and fed through R610; anode GND
- PASS: TIA feedback 33k || 15p; output to PHOTO_MONITOR (pad 25, AIN2)
- PASS: TIA reference divider
- PASS: Comparator with hysteresis drives PHOTO_EDGE (pad 33)
- PASS: DAC threshold filtered into comparator IN-
- PASS: DAC on POWER I2C bus, A0 low (address 0x60)
- PASS: R611 value 33k 0.1%
- PASS: C610 value 15p C0G 5% 50V 0402
- PASS: R615 value 1M
- PASS: R614 value 10k
- PASS: U610 supply
- PASS: U611 supply
- PASS: U612 supply
- PASS: RSET = R201 + R207 in series from SET to GND
- PASS: RSET midpoint has no other connection
- PASS: R201 value 49.9k 0.1% <=10ppm/K (RSET, + R207)
- PASS: R207 value 1.00k 0.1% <=10ppm/K (RSET trim)
- PASS: RUN_PERMIT = POWER_OK . SERVICE_OK drives latch CLR
- PASS: POWER_OK (SYS_OK . PACK_OK) shared by ANA_ENABLE gate and latch permit
- PASS: U227 clocked by RUN_REQUEST, D and PRE high
- PASS: U227 Q-bar unused
- PASS: RUN_ARMED and RUN_REQUEST gate RUN_LATCHED
- PASS: RUN_LATCHED replaces RUN_REQUEST in the ANA_ENABLE chain
- PASS: RUN_REQUEST default pulldown and MCU pad 22 retained
- PASS: U220: Schmitt-input SN74AUP1G08 on +3V3
- PASS: U221: Schmitt-input SN74AUP1G08 on +3V3
- PASS: U222: Schmitt-input SN74AUP1G08 on +3V3
- PASS: U223: Schmitt-input SN74AUP1G08 on +3V3
- PASS: U224: Schmitt-input SN74AUP1G08 on +3V3
- PASS: U225: Schmitt-input SN74AUP1G08 on +3V3
- PASS: U226: Schmitt-input SN74AUP1G08 on +3V3
- PASS: U228: Schmitt-input SN74AUP1G08 on +3V3
- PASS: U330: Schmitt-input SN74AUP1G08 on +3V3
- PASS: U331: Schmitt-input SN74AUP1G08 on +3V3
- PASS: U332: Schmitt-input SN74AUP1G08 on +3V3
- PASS: U333: Schmitt-input SN74AUP1G08 on +3V3
- PASS: R212: 4.7k pull-up on ANALOG_OK
- PASS: R215: 4.7k pull-up on DIGITAL_OK
- PASS: R218: 4.7k pull-up on SYS_OK
- PASS: R221: 4.7k pull-up on PACK_OK
- PASS: R224: 4.7k pull-up on BAT_WARN_OK
- PASS: SWD_ABSENT and INTERLOCK_CLOSED defaults 4.7k
- PASS: C203 MPN GRM32ER71E226KE15L
- PASS: C204 MPN GRM32ER71E226KE15L
- PASS: C201 MPN GRM21BR71C475KE51L
- PASS: C211 MPN GRM31C5C1H104JA01L
- PASS: C213 MPN GRM31C5C1H104JA01L
- PASS: C215 MPN GCM1885C1H103JA16D
- PASS: C217 MPN GCM1885C1H103JA16D
- PASS: C219 MPN GCM1885C1H103JA16D
- PASS: Output capacitors on +5VA at OUT/OUTS
- PASS: U400 pin 2 on USB_5V
- PASS: U400 pin 3 on USB_5V
- PASS: U400 pin 9 on USB_5V
- PASS: U400 pin 8 on USB_5V
- PASS: U400 pin 11 on GND
- PASS: U400 pin 10 on GND
- PASS: U400 pin 25 on SYS
- PASS: U400 pin 22 on PACK_POS
- PASS: U400 pin 23 on PACK_POS
- PASS: U400 pin 27 on GND
- PASS: U400 pin 14 on POWER_SCL
- PASS: U400 pin 15 on POWER_SDA
- PASS: U400 pin 21 on CHARGER_INT_N
- PASS: BQ25798 D+/D- left unconnected (USB data stays with the MCU)
- PASS: Inductor between SW1 and SW2; bootstrap capacitors SW1-BTST1 and SW2-BTST2
- PASS: REGN decoupled and biases ILIM_HIZ, TS, CE pull-up and charge LED only
- PASS: PROG 6.04k to GND: 2S, 1.5 MHz
- PASS: ILIM_HIZ divider from REGN
- PASS: TS divider with pack NTC on J401 pin 3
- PASS: Ship FET: gate on SDRV, source on BAT (PACK_POS), drain on pack +
- PASS: BATP senses the pack side of the ship FET through 100R
- PASS: CE pulled high from REGN; Q401 enables charging only on CHARGE_REQUEST
- PASS: CHARGE_REQUEST default low keeps charging disabled
- PASS: STAT drives the charge LED cathode
- PASS: POWER button pulls QON low
- PASS: BAT54 anode on POWER_BUTTON_N (module pad 37) with 10k pull-up
- PASS: PMID has its own 3 x 10 uF + 100 nF
- PASS: Seven SYS hold-up capacitors on SYS
- PASS: Connector-side VBUS bulk is C324 alone (USB Type-C sink limit; Step 14 moved the charger bulk behind the OVP soft start)
- PASS: BAT capacitors on the charger side of the ship FET
- PASS: R216 monitor divider fed from SYS
- PASS: R219 monitor divider fed from PACK_POS
- PASS: R222 monitor divider fed from PACK_POS
- PASS: Pack monitors behind the ship FET: no divider drain in ship mode
- PASS: U400 MPN BQ25798RQMR
- PASS: Q400 MPN CSD17571Q2
- PASS: Q401 MPN BSS138
- PASS: C416 MPN 16SVP100M
- PASS: D402 MPN BAT54,215
- PASS: REF electrode (J500 pin 17) reaches only R517 and the normally open test link JP9 (no direct path to REF_BUF or any ADC pin)
- PASS: JP9 links the REF electrode to the CH8- harness net (JP8 pin 1)
- PASS: JP10 links the BIAS electrode to the CH7- harness net (JP7 pin 1)
- PASS: Test links touch no REF_BUF, buffer input or ADC pin net
- PASS: JP9 is a 1x2 2.54 mm header (Wurth 61300211121)
- PASS: JP10 is a 1x2 2.54 mm header (Wurth 61300211121)
- PASS: REF front end: two 47k in series
- PASS: D510 clamps the REF node between the 94k and the 4.7k
- PASS: 4.7k from the REF clamp node to OPA376 +IN only
- PASS: U500 wired as a unity follower driving REF_BUF
- PASS: REF_BUF reaches only the follower and pin 3 of JP1-JP8
- PASS: U500 powered from +5VA and AVSS/GND, so it is off whenever the analogue rail is off
- PASS: U500 supply decoupling
- PASS: R517 value 47k 0.1%
- PASS: R518 value 47k 0.1%
- PASS: R519 value 4.7k 0.1%
- PASS: Q201 drain sinks +5VA through R208 100R; source on GND
- PASS: Q201 gate pulled to +5VA by R209 and released only by Q202
- PASS: Q202 grounds the clamp gate while ANA_ENABLE is high
- PASS: R208 value
- PASS: R209 value
- PASS: U500 MPN OPA376AIDBVR
- PASS: D510 MPN TPD2E2U06DCKR
- PASS: Q201 MPN CSD17381F4
- PASS: Q202 MPN CSD17381F4
- PASS: Added since Step 13: U323 TPD1S514-1, U324 TPS7A2050, D324 BAT54, C324-C327 and C401 only
- PASS: No parts removed since Step 13
- PASS: No pins added to or removed from existing parts
- PASS: Changed: J310 pin A4 moved from USB_5V to VBUS_CON
- PASS: Changed: J310 pin A9 moved from USB_5V to VBUS_CON
- PASS: Changed: J310 pin B4 moved from USB_5V to VBUS_CON
- PASS: Changed: J310 pin B9 moved from USB_5V to VBUS_CON
- PASS: Changed: R360 pin 1 moved from USB_5V to VBUS_CON
- PASS: Changed: R362 pin 1 moved from USB_5V to USB_VPWR
- PASS: Changed: U300 pin 31 moved from USB_5V to MCU_VBUS
- PASS: Changed: C303 pin 1 moved from USB_5V to MCU_VBUS
- PASS: Retained: 1096 pin connections keep the same net partners as in Step 13
- PASS: Retained: no value changed on an existing part
- PASS: U323 ball B3 on VBUS_CON
- PASS: U323 ball C2 on VBUS_CON
- PASS: U323 ball C3 on VBUS_CON
- PASS: U323 ball A2 on USB_5V
- PASS: U323 ball A3 on USB_5V
- PASS: U323 ball B2 on USB_5V
- PASS: U323 ball B1 on USB_VPWR
- PASS: U323 ball A1 on GND
- PASS: U323 ball A4 on GND
- PASS: U323 ball B4 on GND
- PASS: U323 ball C1 on GND
- PASS: U323 ball C4 on GND
- PASS: VBUS_CON reaches only the J310 VBUS contacts, U323, C324 and the TUSB320 detect resistor R360
- PASS: C324 1 uF 50 V on VBUS_CON (connector side may see 30 V)
- PASS: No USB-C contact on USB_5V: every USB_5V load sits behind U323
- PASS: USB_VPWR (U323 VBUS_POWER) carries only its 1 uF and the USB-sense divider
- PASS: USB-sense divider from USB_VPWR into U321, so USB_ABSENT also falls while U323 blocks
- PASS: U324 IN and EN on USB_5V, NC pin open
- PASS: MCU_VBUS: U324 OUT to module pad 31 with C303, C327 and the D324 anode only
- PASS: D324 BAT54 cathode on USB_5V: LDO reverse-current bypass
- PASS: U324 input and output capacitors to GND
- PASS: USB_5V bulk behind the soft start: C400 + C401 (TI 2 x 10 uF), C321, C326, C402
- PASS: C401 on the charger VBUS pin net
- PASS: U323 MPN TPD1S514-1YZR
- PASS: U324 MPN TPS7A2050PDBVR
- PASS: C324 MPN GCM21BR71H105KA03L
- PASS: C401 MPN GRM31CR71E106KA12L
- PASS: U323 on project footprint Texas_YZ0012_DSBGA-12_P0.4mm (TI land pattern 4221703/A)
- PASS: J600 shell pins 2-4 all on the isolated return TRIG_ISO_RTN
- PASS: J500 pins 1/2 carry CH1+ and CH1-
- PASS: J500 pins 3/4 carry CH2+ and CH2-
- PASS: J500 pins 5/6 carry CH3+ and CH3-
- PASS: J500 pins 7/8 carry CH4+ and CH4-
- PASS: J500 pins 9/10 carry CH5+ and CH5-
- PASS: J500 pins 11/12 carry CH6+ and CH6-
- PASS: J500 pins 13/14 carry CH7+ and CH7-
- PASS: J500 pins 15/16 carry CH8+ and CH8-
- PASS: J500 pins 19-20 unused: no GND or supply on the electrode connector
- PASS: Only the 18 electrode leads are excluded from the board
- PASS: Only the seven bare test pads are on the board but not in the BOM
- PASS: Every on-board part has a footprint
- PASS: Every fitted part (370) has manufacturer, MPN and description
- PASS: R210 value 31.6k 0.1% <=10ppm/K
- PASS: R211 value 9.88k 0.1% <=10ppm/K
- PASS: R219 value 44.2k 0.1% <=10ppm/K
- PASS: R201 MPN ERA-3ARB4992V
- PASS: R207 MPN ERA-3ARB102V
- PASS: R210 MPN ERA-3ARB3162V
- PASS: R211 MPN ERA-3ARB9881V
- PASS: R219 MPN ERA-3ARB4422V
- PASS: L400 MPN XFL4020-102MEC
- PASS: L240 MPN XFL4020-222MEC
- PASS: All electrode, REF and BIAS series resistors are ERJ-PB6B (0.1 %, 150 V element voltage, thick film)
- PASS: No Murata part marked NRND or to be discontinued
- PASS: U300 on project footprint u-blox_NINA-B306
- PASS: U400 on project footprint Texas_RQM0029A_VQFN-HR-29_4x4mm
- PASS: U320 on project footprint Texas_RWB0012A_X2QFN-12_1.6x1.6mm_P0.4mm
- PASS: Q400 on project footprint Texas_DQK_SON-6_2x2mm_CSD17571Q2
- PASS: Q201 on project footprint Texas_YJC0003A_FemtoFET-3_1.0x0.6mm
- PASS: Q202 on project footprint Texas_YJC0003A_FemtoFET-3_1.0x0.6mm
- PASS: Added since Step 14: JP9 and JP10 only; nothing removed
- PASS: No pins added to or removed from Step 14 parts
- PASS: Every Step 14 net keeps exactly its members; only the JP9/JP10 pins join REF_RAW, E8N, BIAS_ELEC and E7N
- PASS: The test links join no other net
