MariusFauteux/EEG-PCB/hardware/checks/pcb_inner_planes.pdf

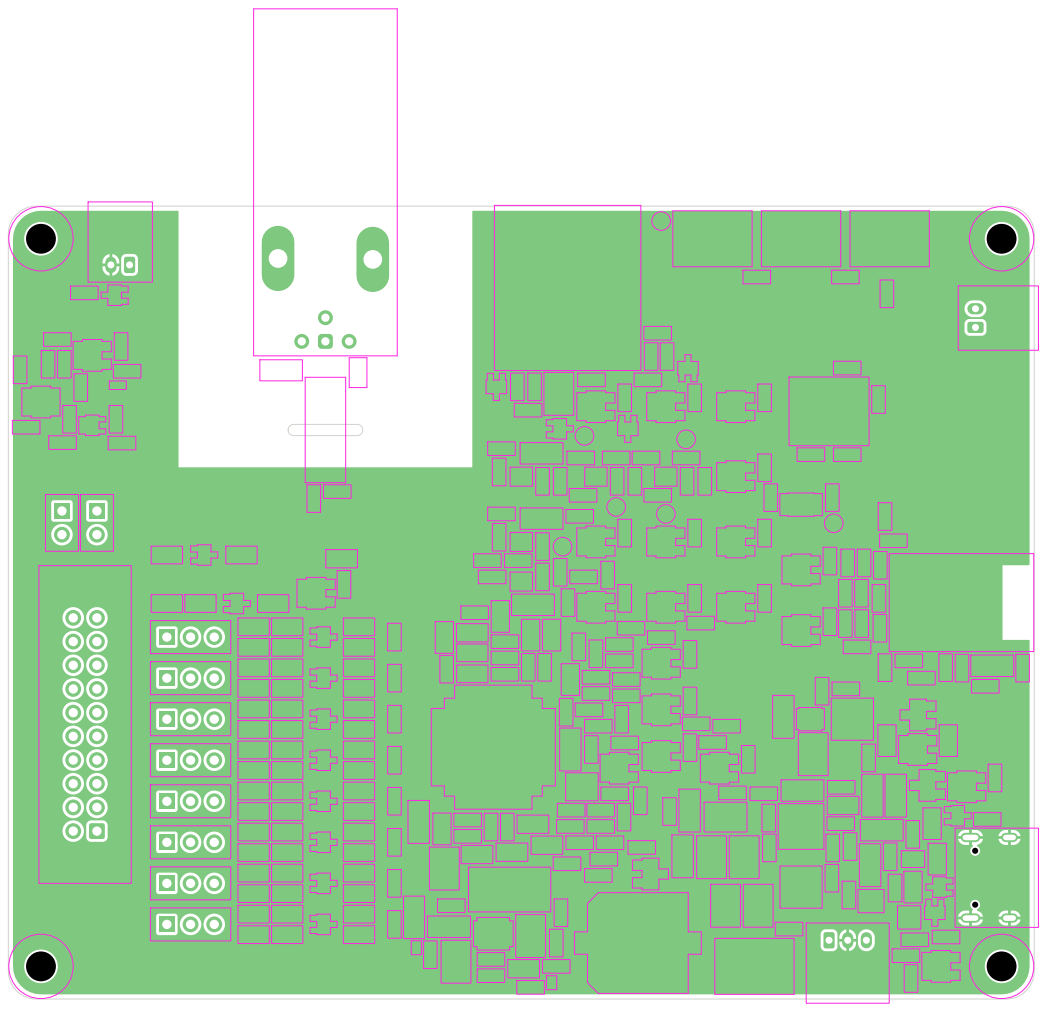
[picture p1: page 1]

Placed, not routed. Generated by scripts/pcb_place.py.
8-channel ADS1299, NINA-B306, microSD, USB-C charging. Bench draft, no human connection.

Sheet:
File: EEG_RevC.kicad_pcb
Title: EEG recorder Rev C12 - placement (Step 14)

Size: A4 | Rev: C12
KiCad E.D.A. 10.0.8 | Id: 1/2

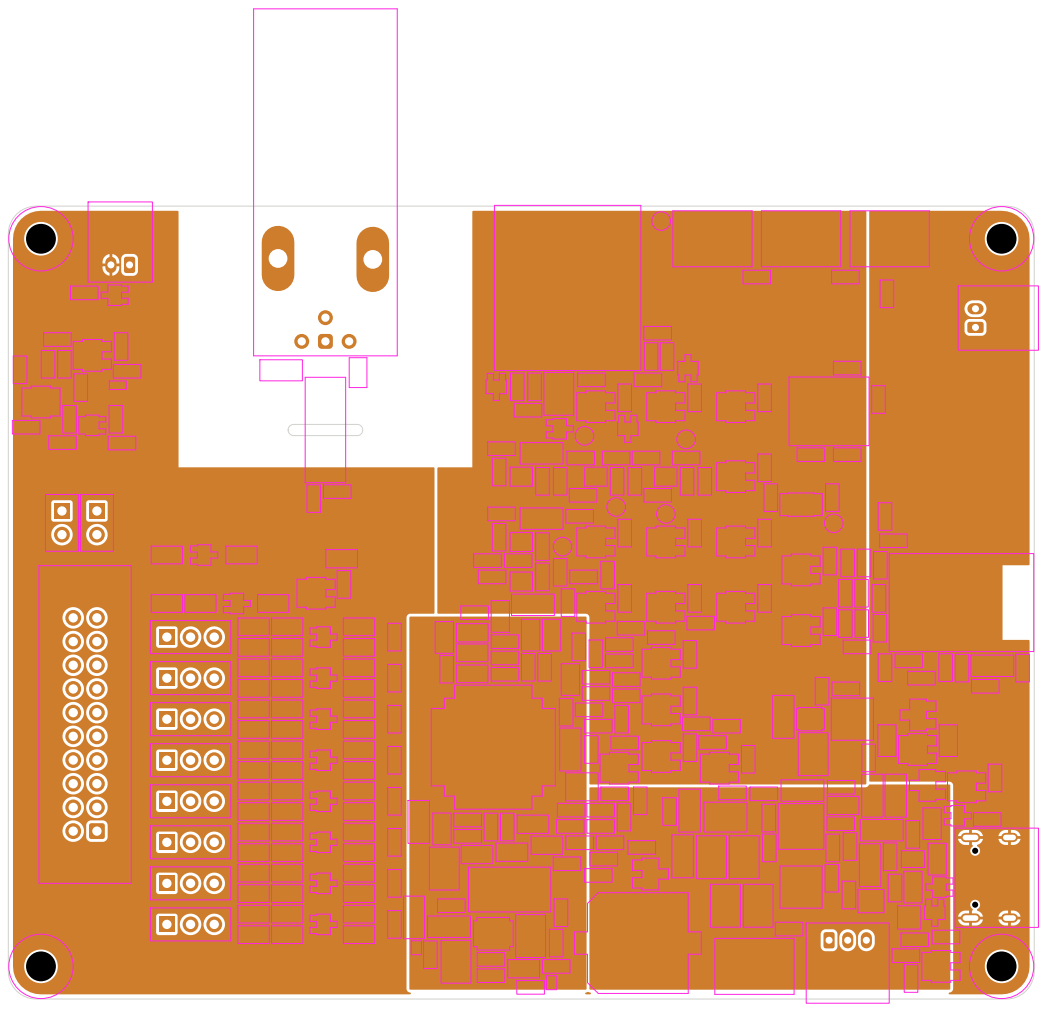
[picture p2: page 2]
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

Sheet:
File: EEG_RevC.kicad_pcb
Title: EEG recorder Rev C12 - placement (Step 14)

Size: A4 | Rev: C12
KiCad E.D.A. 10.0.8 | Id: 2/2
