MariusFauteux/EEG-PCB/hardware/EEG_RevC.kicad_pcb

## KiCad design hardware/EEG_RevC.kicad_pcb (2026-11-09)

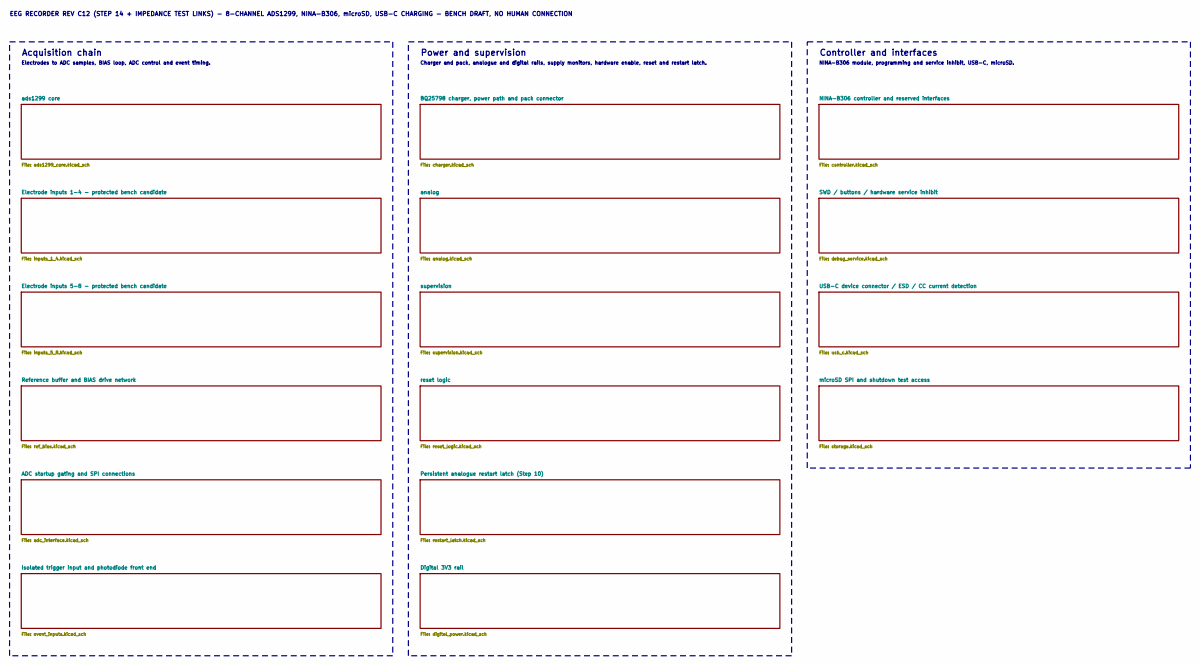
[picture p3: schematic EEG_RevC.kicad_sch]

Notes on the sheet:
Acquisition chain
Electrodes to ADC samples, BIAS loop, ADC control and event timing.
Power and supervision
Charger and pack, analogue and digital rails, supply monitors, hardware enable, reset and restart latch.
Controller and interfaces
NINA-B306 module, programming and service inhibit, USB-C, microSD.
EEG RECORDER REV C12 (STEP 14 + IMPEDANCE TEST LINKS) - 8-CHANNEL ADS1299, NINA-B306, microSD, USB-C CHARGING - BENCH DRAFT, NO HUMAN CONNECTION

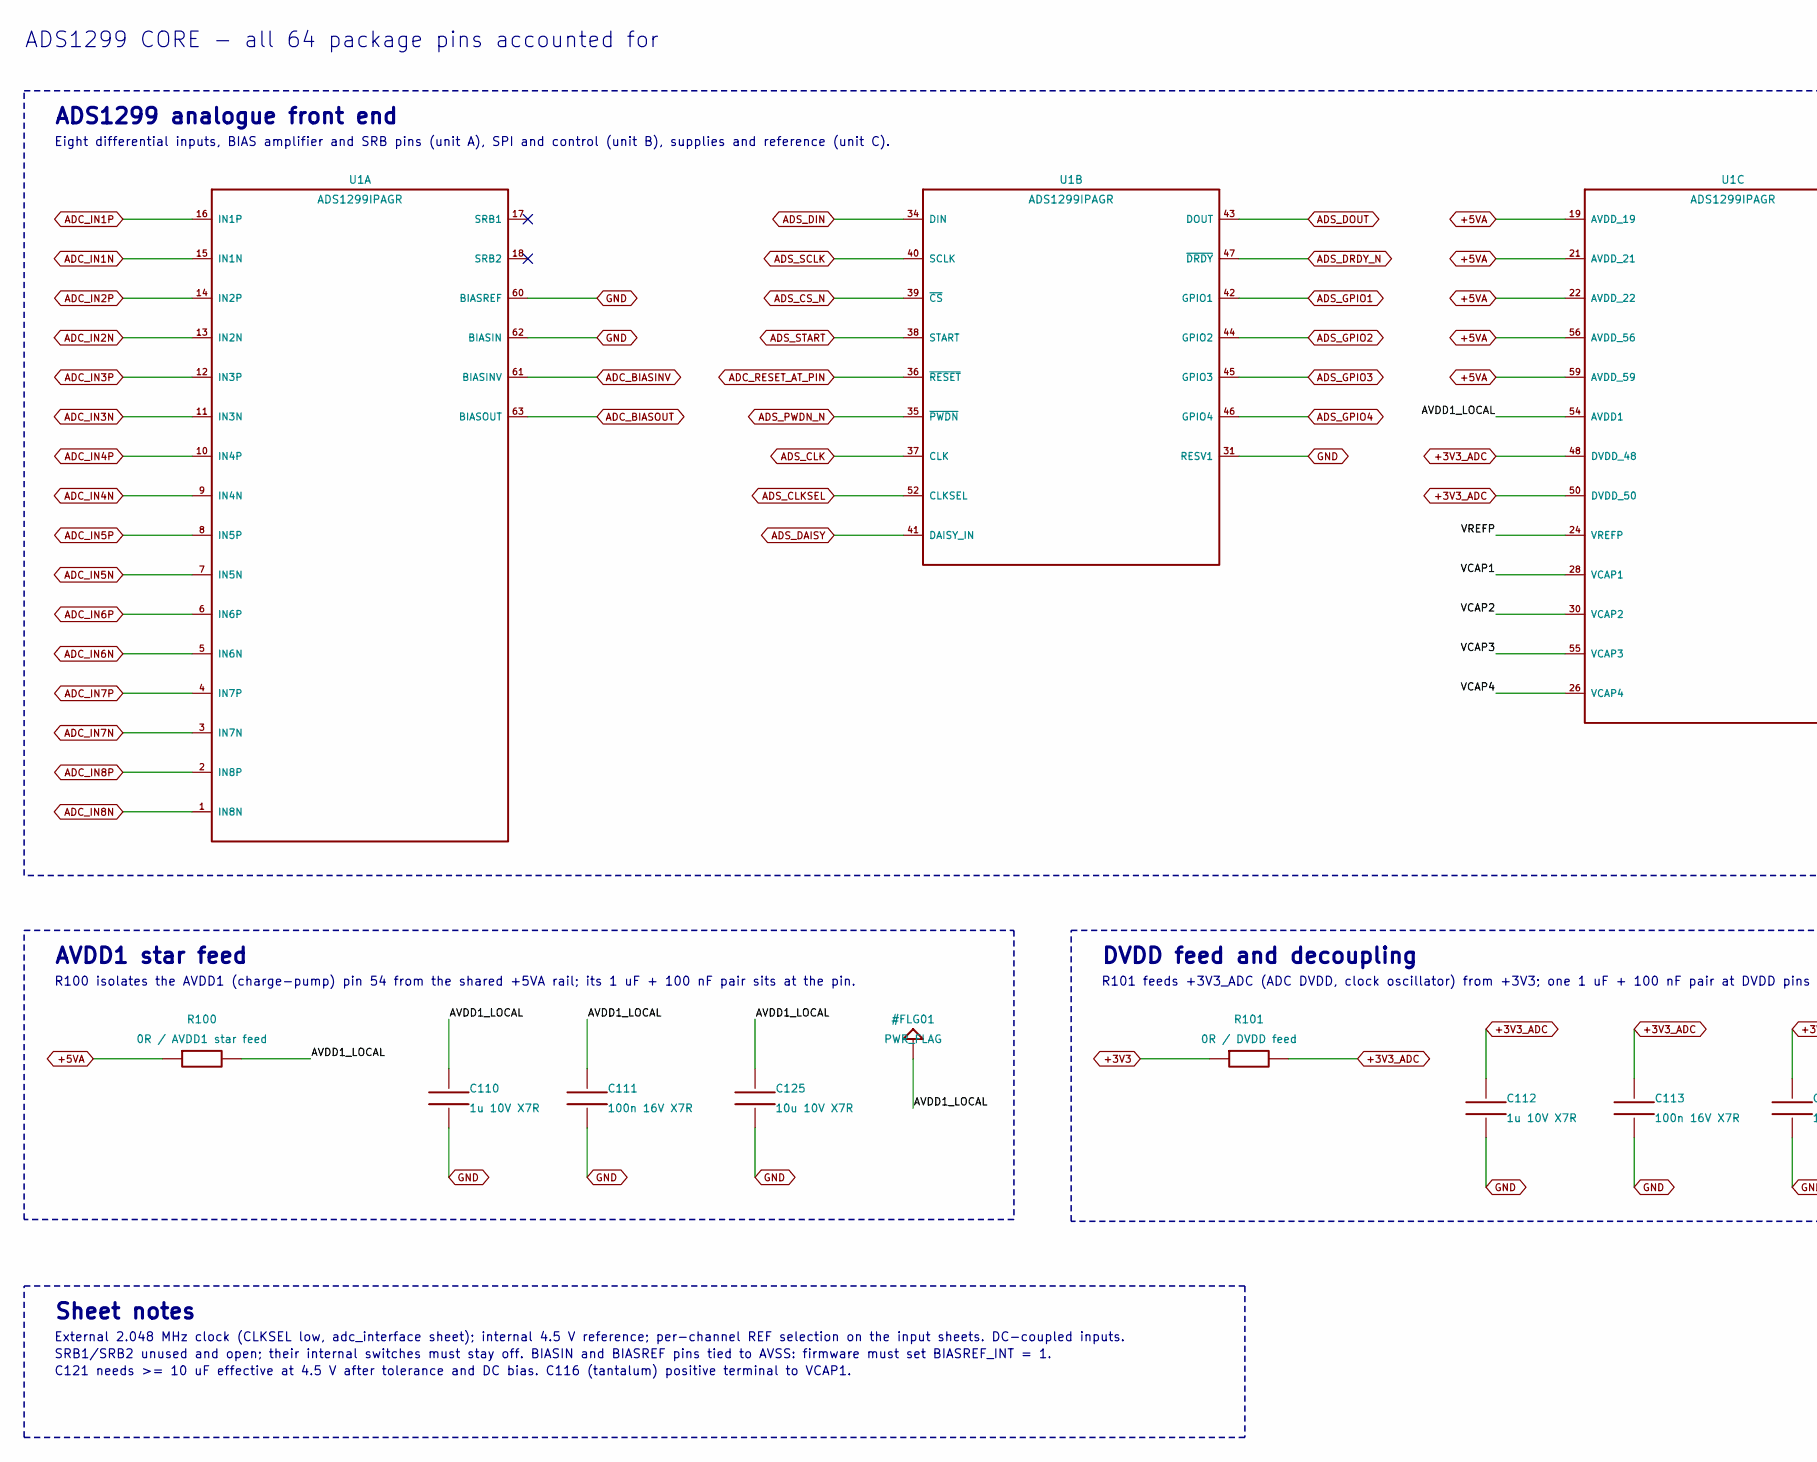
[picture p4: schematic ads1299_core.kicad_sch, ADS1299 core, reference and decoupling, part in row 1, column 1]

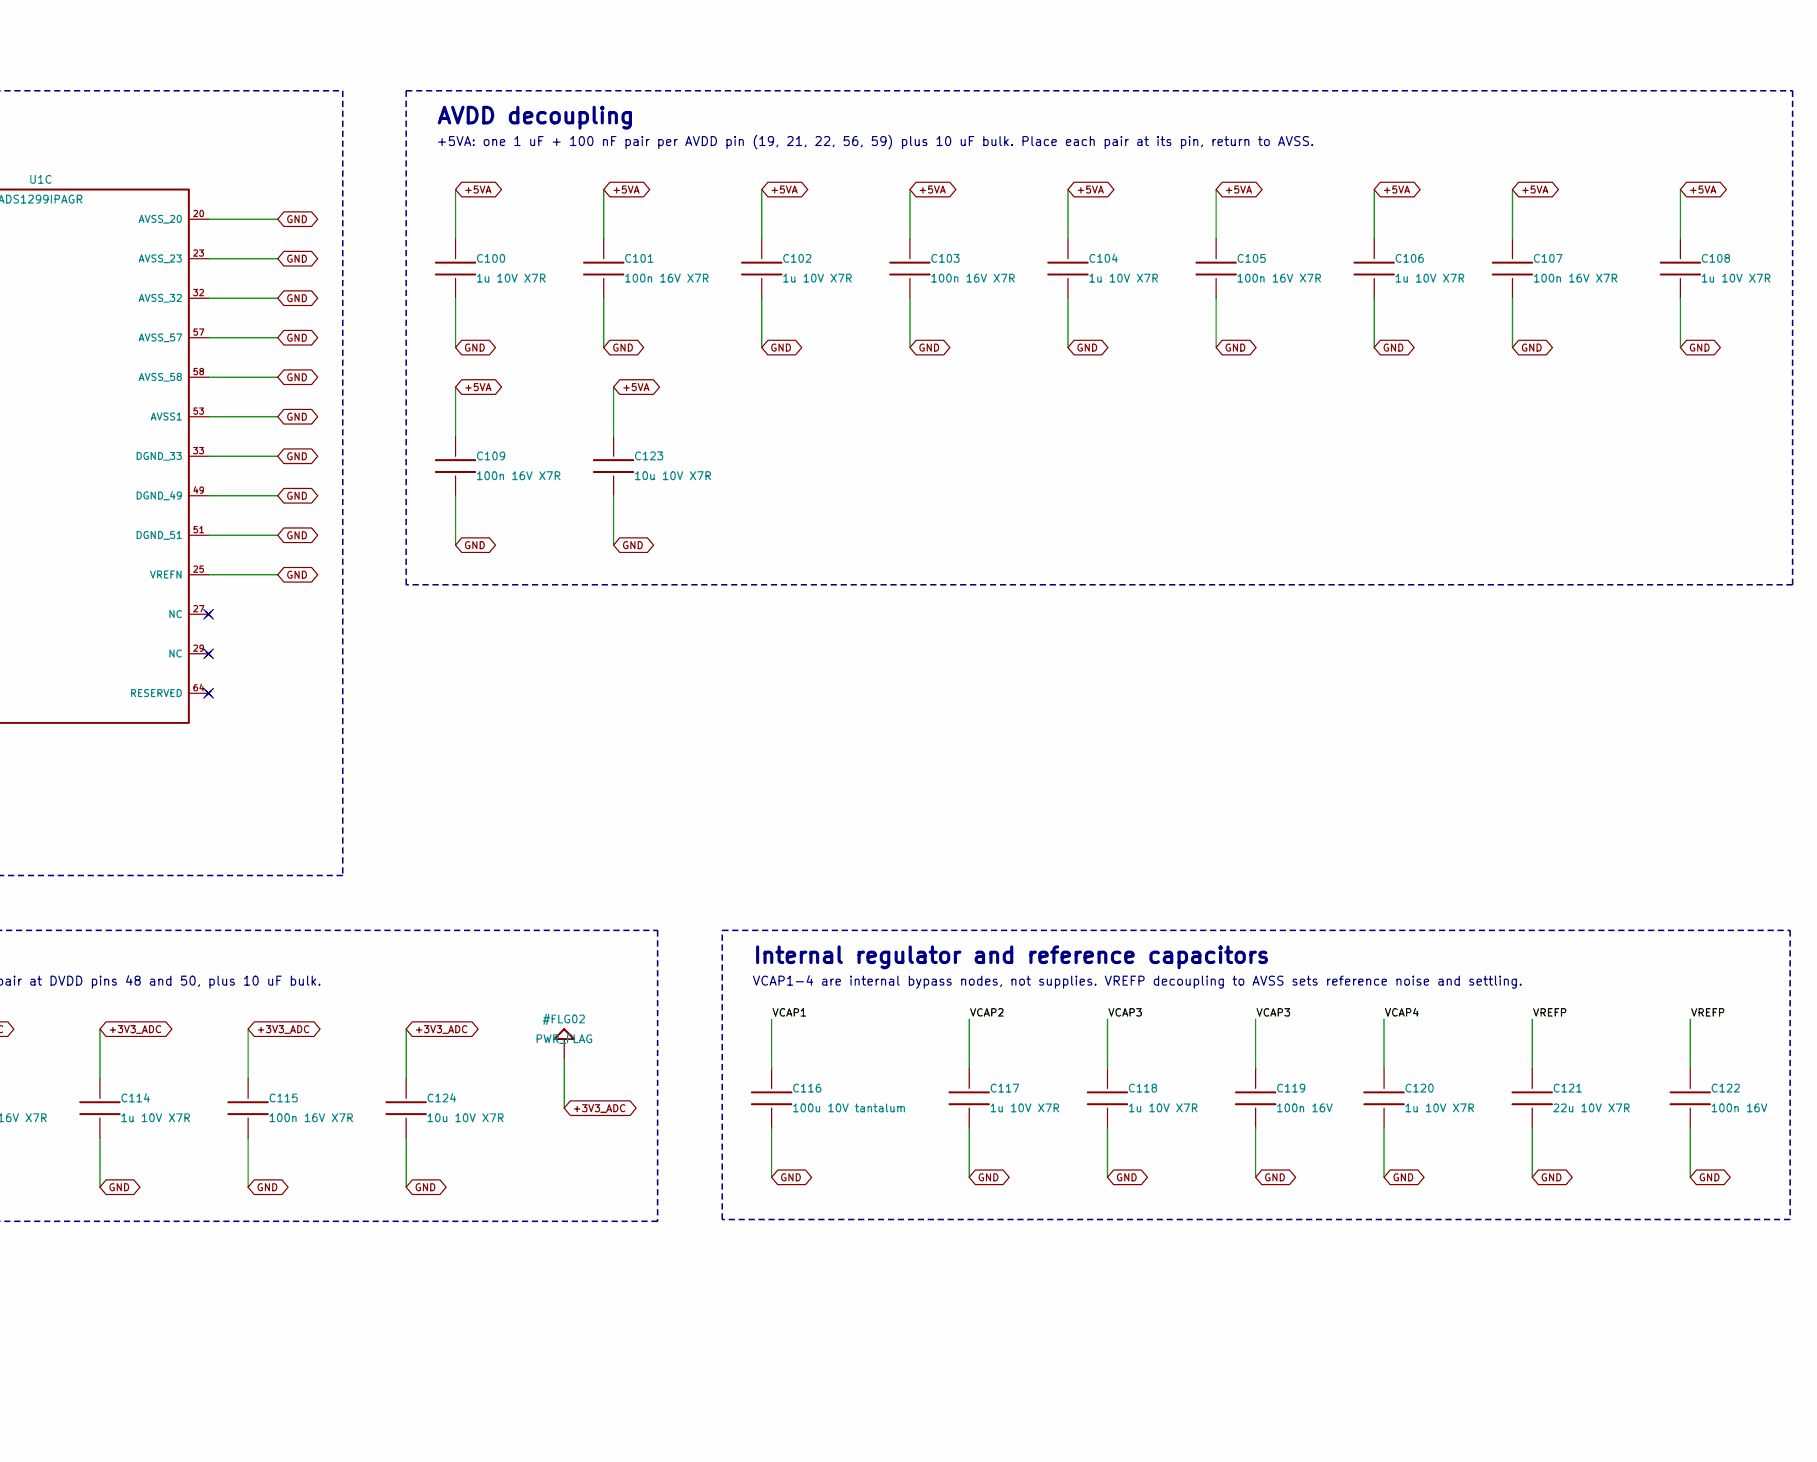
[picture p5: schematic ads1299_core.kicad_sch, ADS1299 core, reference and decoupling, part in row 1, column 2]

Parts:
C100, C102, C104, C106, C108, C110, C112, C114, C117, C118, C120: 1u 10V X7R; C_0805_2012Metric; MPN GCM21BR71E105KA56L
C101, C103, C105, C107, C109, C111, C113, C115: 100n 16V X7R; C_0603_1608Metric; MPN GCM188R71H104KA57D
C116: 100u 10V tantalum; CP_EIA-7343-31_Kemet-D; MPN T491D107K010AT
C119, C122: 100n 16V; C_0603_1608Metric; MPN GCM188R71H104KA57D
C121: 22u 10V X7R; C_1210_3225Metric; MPN GRM32ER71E226KE15L
C123, C124, C125: 10u 10V X7R; C_1206_3216Metric; MPN GRM31CR71E106KA12L
R100: 0R / AVDD1 star feed; R_0603_1608Metric; MPN ERJ-3GEY0R00V
R101: 0R / DVDD feed; R_0603_1608Metric; MPN ERJ-3GEY0R00V
U1: ADS1299IPAGR; TQFP-64_10x10mm_P0.5mm; MPN ADS1299IPAGR

Connections:
+3V3: R101.1; also elsewhere on the board
+3V3_ADC: C112.1, C113.1, C114.1, C115.1, C124.1, R101.2, U1.48 (DVDD_48), U1.50 (DVDD_50); also elsewhere on the board
+5VA: C100.1, C101.1, C102.1, C103.1, C104.1, C105.1, C106.1, C107.1, C108.1, C109.1, C123.1, R100.1, U1.19 (AVDD_19), U1.21 (AVDD_21), U1.22 (AVDD_22), U1.56 (AVDD_56), U1.59 (AVDD_59); also elsewhere on the board
/ads1299 core/AVDD1_LOCAL: C110.1, C111.1, C125.1, R100.2, U1.54 (AVDD1)
/ads1299 core/VCAP1: C116.1, U1.28 (VCAP1)
/ads1299 core/VCAP2: C117.1, U1.30 (VCAP2)
/ads1299 core/VCAP3: C118.1, C119.1, U1.55 (VCAP3)
/ads1299 core/VCAP4: C120.1, U1.26 (VCAP4)
/ads1299 core/VREFP: C121.1, C122.1, U1.24 (VREFP)
ADC_BIASINV: U1.61 (BIASINV); also elsewhere on the board
ADC_BIASOUT: U1.63 (BIASOUT); also elsewhere on the board
ADC_IN1N: U1.15 (IN1N); also elsewhere on the board
ADC_IN1P: U1.16 (IN1P); also elsewhere on the board
ADC_IN2N: U1.13 (IN2N); also elsewhere on the board
ADC_IN2P: U1.14 (IN2P); also elsewhere on the board
ADC_IN3N: U1.11 (IN3N); also elsewhere on the board
ADC_IN3P: U1.12 (IN3P); also elsewhere on the board
ADC_IN4N: U1.9 (IN4N); also elsewhere on the board
ADC_IN4P: U1.10 (IN4P); also elsewhere on the board
ADC_IN5N: U1.7 (IN5N); also elsewhere on the board
ADC_IN5P: U1.8 (IN5P); also elsewhere on the board
ADC_IN6N: U1.5 (IN6N); also elsewhere on the board
ADC_IN6P: U1.6 (IN6P); also elsewhere on the board
ADC_IN7N: U1.3 (IN7N); also elsewhere on the board
ADC_IN7P: U1.4 (IN7P); also elsewhere on the board
ADC_IN8N: U1.1 (IN8N); also elsewhere on the board
ADC_IN8P: U1.2 (IN8P); also elsewhere on the board
ADC_RESET_AT_PIN: U1.36 (~RESET); also elsewhere on the board
ADS_CLK: U1.37 (CLK); also elsewhere on the board
ADS_CLKSEL: U1.52 (CLKSEL); also elsewhere on the board
ADS_CS_N: U1.39 (~CS); also elsewhere on the board
ADS_DAISY: U1.41 (DAISY_IN); also elsewhere on the board
ADS_DIN: U1.34 (DIN); also elsewhere on the board
ADS_DOUT: U1.43 (DOUT); also elsewhere on the board
ADS_DRDY_N: U1.47 (~DRDY); also elsewhere on the board
ADS_GPIO1: U1.42 (GPIO1); also elsewhere on the board
ADS_GPIO2: U1.44 (GPIO2); also elsewhere on the board
ADS_GPIO3: U1.45 (GPIO3); also elsewhere on the board
ADS_GPIO4: U1.46 (GPIO4); also elsewhere on the board
ADS_PWDN_N: U1.35 (~PWDN); also elsewhere on the board
ADS_SCLK: U1.40 (SCLK); also elsewhere on the board
ADS_START: U1.38 (START); also elsewhere on the board
GND: C100.2, C101.2, C102.2, C103.2, C104.2, C105.2, C106.2, C107.2, C108.2, C109.2, C110.2, C111.2, C112.2, C113.2, C114.2, C115.2, C116.2, C117.2, C118.2, C119.2, C120.2, C121.2, C122.2, C123.2, C124.2, C125.2, U1.20 (AVSS_20), U1.23 (AVSS_23), U1.25 (VREFN), U1.31 (RESV1), U1.32 (AVSS_32), U1.33 (DGND_33), U1.49 (DGND_49), U1.51 (DGND_51), U1.53 (AVSS1), U1.57 (AVSS_57), U1.58 (AVSS_58), U1.60 (BIASREF), U1.62 (BIASIN); also elsewhere on the board

Notes on the sheet:
ADS1299 CORE - all 64 package pins accounted for
ADS1299 analogue front end
Eight differential inputs, BIAS amplifier and SRB pins (unit A), SPI and control (unit B), supplies and reference (unit C).
AVDD decoupling
+5VA: one 1 uF + 100 nF pair per AVDD pin (19, 21, 22, 56, 59) plus 10 uF bulk. Place each pair at its pin, return to AVSS.
AVDD1 star feed
R100 isolates the AVDD1 (charge-pump) pin 54 from the shared +5VA rail; its 1 uF + 100 nF pair sits at the pin.
DVDD feed and decoupling
R101 feeds +3V3_ADC (ADC DVDD, clock oscillator) from +3V3; one 1 uF + 100 nF pair at DVDD pins 48 and 50, plus 10 uF bulk.
Internal regulator and reference capacitors
VCAP1-4 are internal bypass nodes, not supplies. VREFP decoupling to AVSS sets reference noise and settling.
Sheet notes
External 2.048 MHz clock (CLKSEL low, adc_interface sheet); internal 4.5 V reference; per-channel REF selection on the input sheets. DC-coupled inputs.
SRB1/SRB2 unused and open; their internal switches must stay off. BIASIN and BIASREF pins tied to AVSS: firmware must set BIASREF_INT = 1.
C121 needs >= 10 uF effective at 4.5 V after tolerance and DC bias. C116 (tantalum) positive terminal to VCAP1.

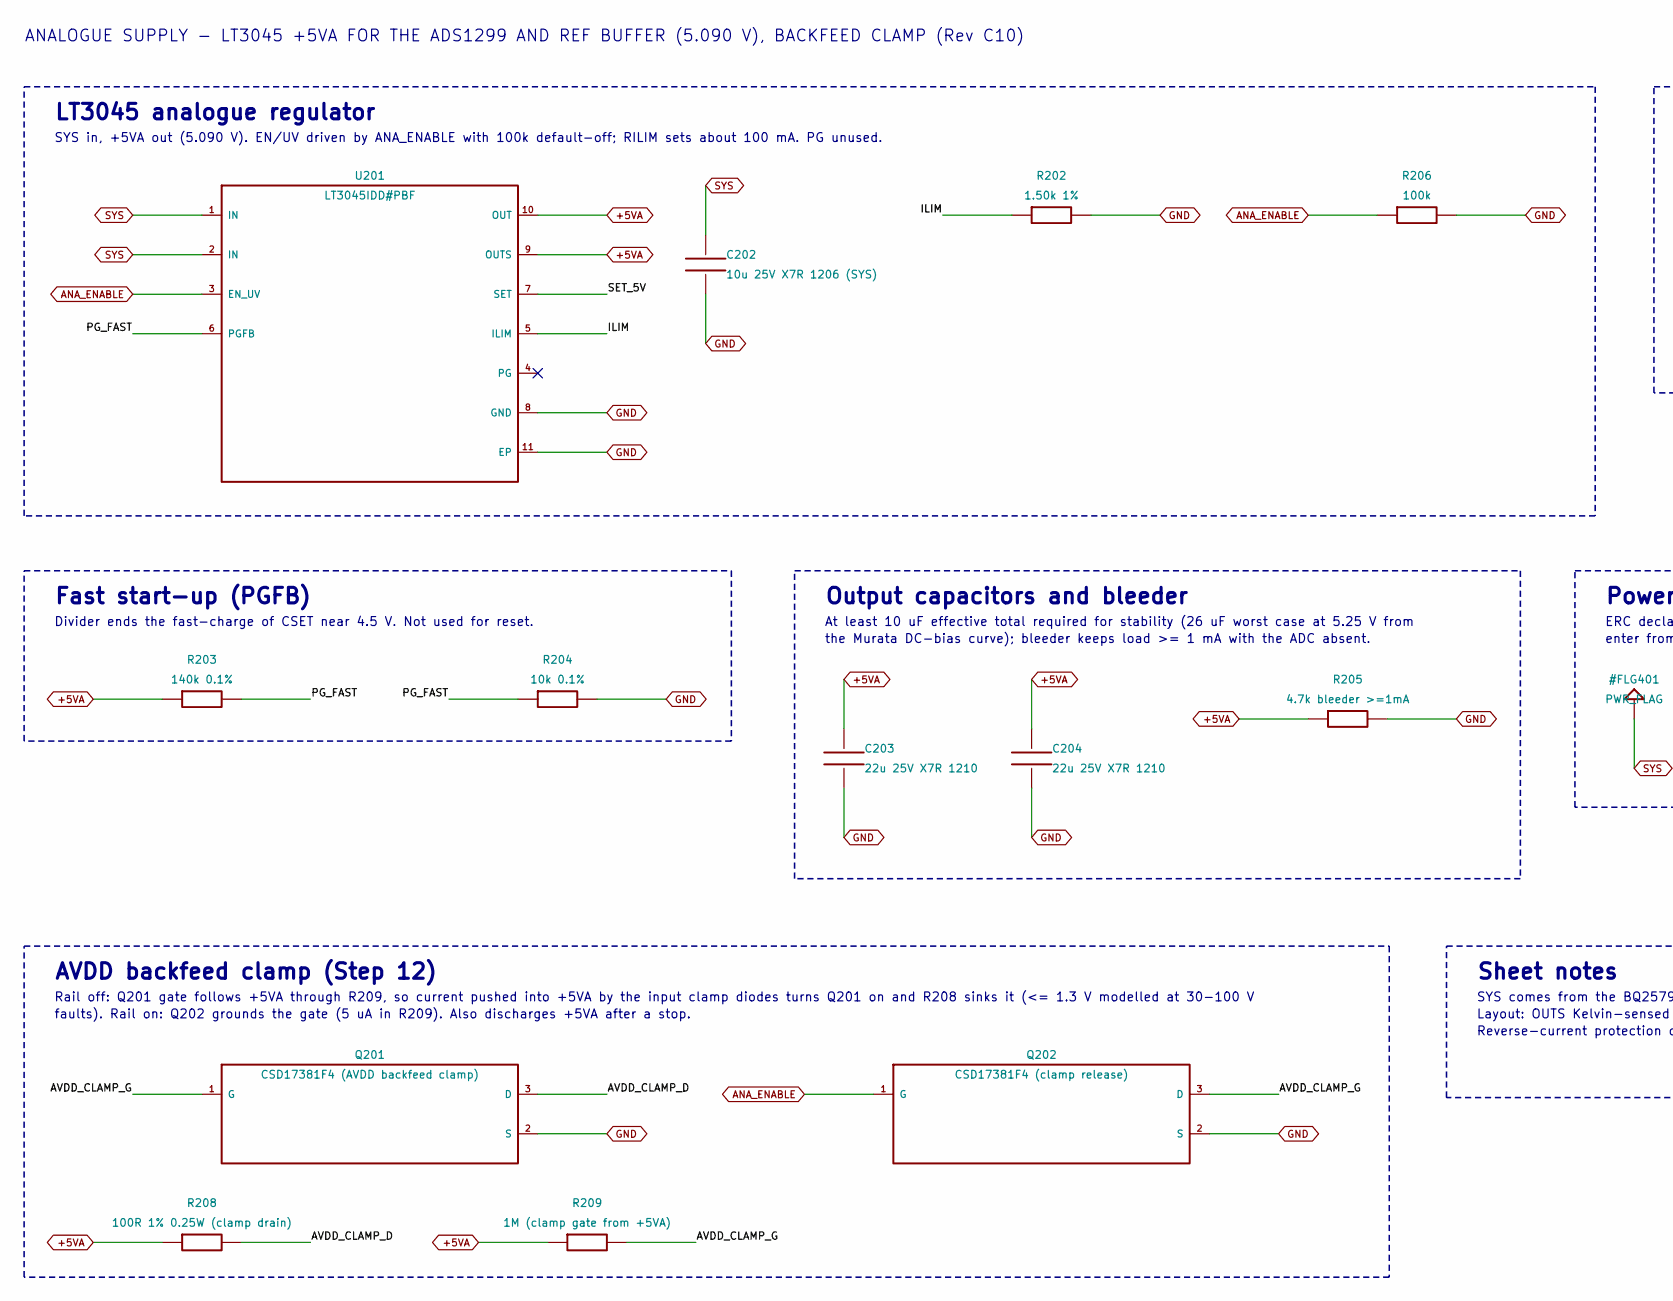
[picture p6: schematic analog.kicad_sch, Rev C step 4 - analog regulator, part in row 1, column 1]

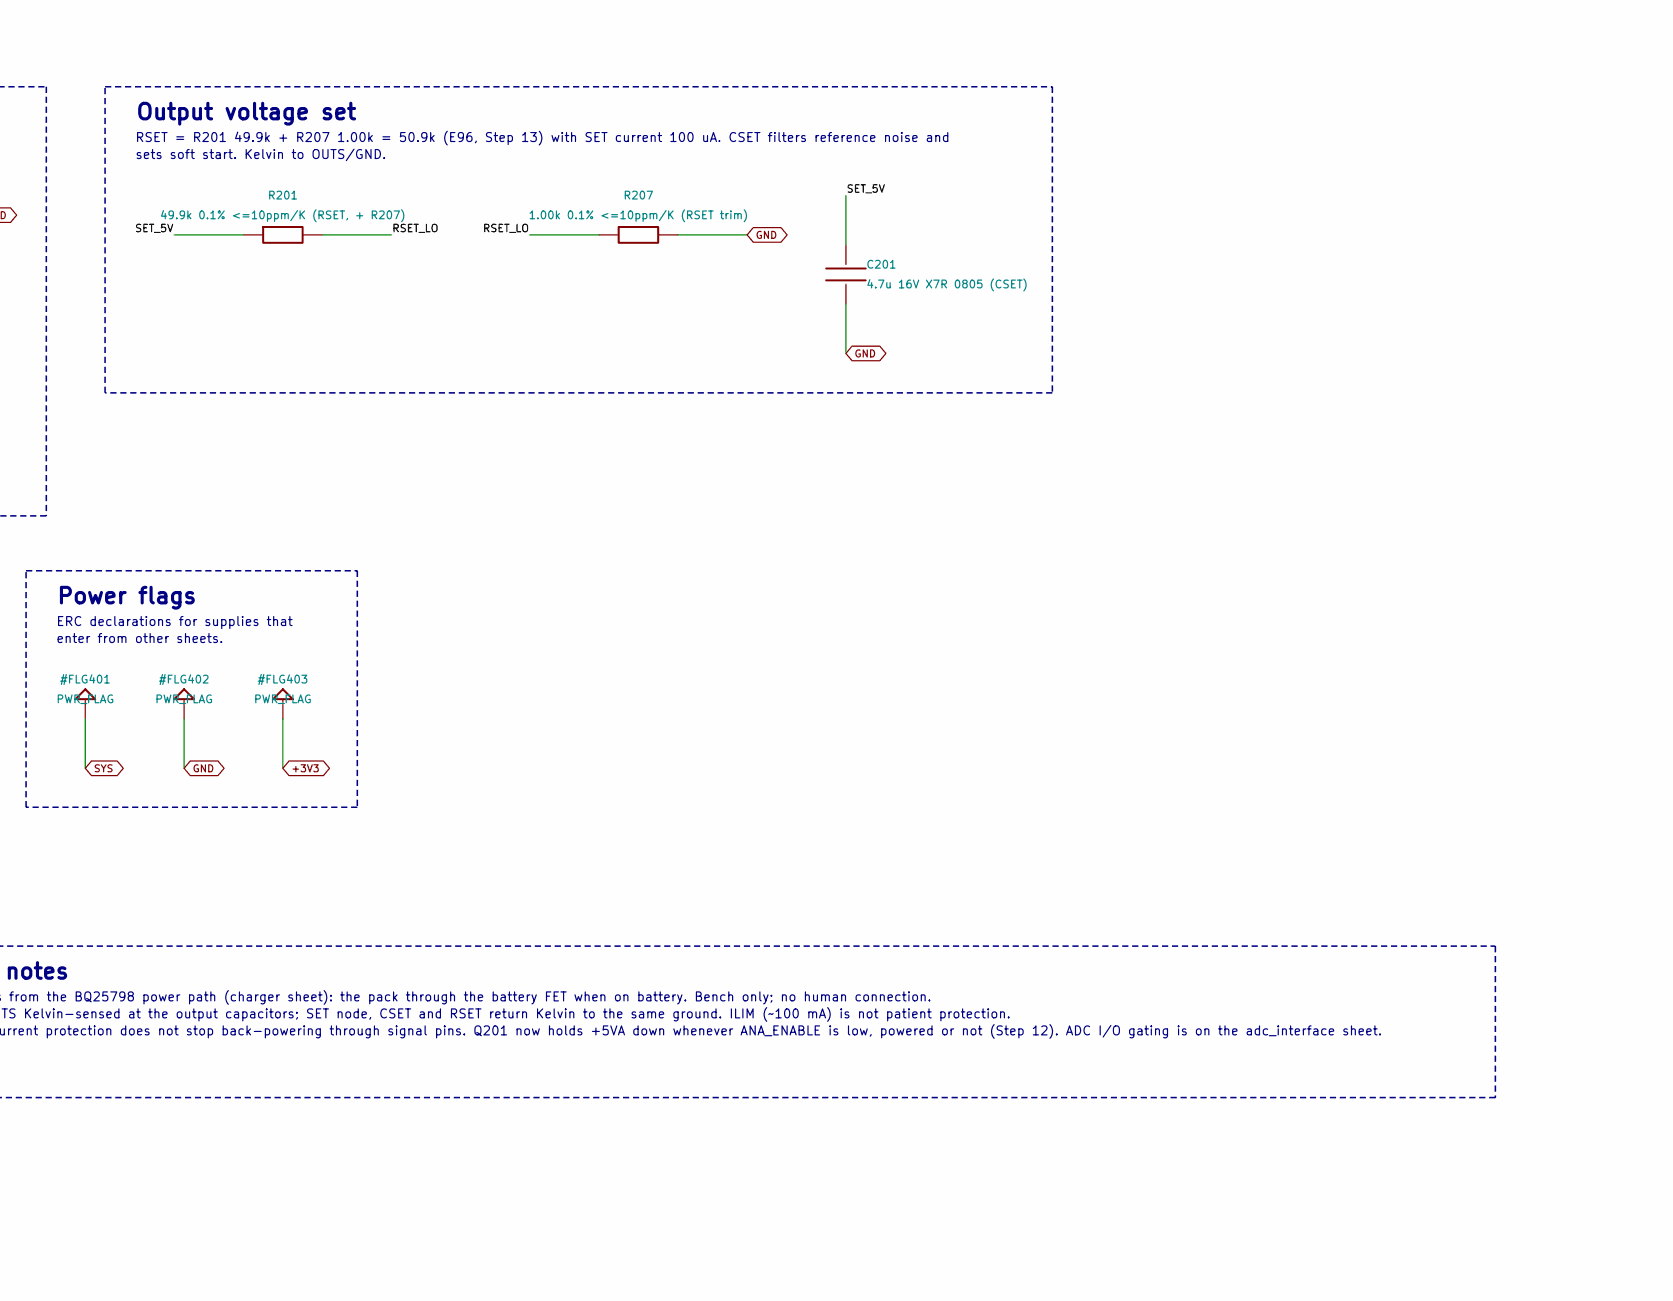
[picture p7: schematic analog.kicad_sch, Rev C step 4 - analog regulator, part in row 1, column 2]

Parts:
C201: 4.7u 16V X7R 0805 (CSET); C_0805_2012Metric; MPN GRM21BR71C475KE51L
C202: 10u 25V X7R 1206 (SYS); C_1206_3216Metric; MPN GRM31CR71E106KA12L
C203, C204: 22u 25V X7R 1210; C_1210_3225Metric; MPN GRM32ER71E226KE15L
Q201: CSD17381F4 (AVDD backfeed clamp); Texas_YJC0003A_FemtoFET-3_1.0x0.6mm; MPN CSD17381F4
Q202: CSD17381F4 (clamp release); Texas_YJC0003A_FemtoFET-3_1.0x0.6mm; MPN CSD17381F4
R201: 49.9k 0.1% <=10ppm/K (RSET, + R207); R_0603_1608Metric; MPN ERA-3ARB4992V
R202: 1.50k 1%; R_0603_1608Metric; MPN ERJ-3EKF1501V
R203: 140k 0.1%; R_0603_1608Metric; MPN ERA-3AEB1403V
R204: 10k 0.1%; R_0603_1608Metric; MPN ERA-3ARB103V
R205: 4.7k bleeder >=1mA; R_0603_1608Metric; MPN ERJ-3EKF4701V
R206: 100k; R_0603_1608Metric; MPN ERJ-3EKF1003V
R207: 1.00k 0.1% <=10ppm/K (RSET trim); R_0603_1608Metric; MPN ERA-3ARB102V
R208: 100R 1% 0.25W (clamp drain); R_1206_3216Metric; MPN ERJ-8ENF1000V
R209: 1M (clamp gate from +5VA); R_0603_1608Metric; MPN ERJ-3EKF1004V
U201: LT3045IDD#PBF; DFN-10-1EP_3x3mm_P0.5mm_EP1.65x2.38mm; MPN LT3045IDD#PBF

Connections:
+5VA: C203.1, C204.1, R203.1, R205.1, R208.1, R209.1, U201.9 (OUTS), U201.10 (OUT); also elsewhere on the board
/analog/AVDD_CLAMP_D: Q201.3 (D), R208.2
/analog/AVDD_CLAMP_G: Q201.1 (G), Q202.3 (D), R209.2
/analog/ILIM: R202.1, U201.5 (ILIM)
/analog/PG_FAST: R203.2, R204.1, U201.6 (PGFB)
/analog/RSET_LO: R201.2, R207.1
/analog/SET_5V: C201.1, R201.1, U201.7 (SET)
ANA_ENABLE: Q202.1 (G), R206.1, U201.3 (EN_UV); also elsewhere on the board
GND: C201.2, C202.2, C203.2, C204.2, Q201.2 (S), Q202.2 (S), R202.2, R204.2, R205.2, R206.2, R207.2, U201.8 (GND), U201.11 (EP); also elsewhere on the board
SYS: C202.1, U201.1 (IN), U201.2 (IN); also elsewhere on the board

Notes on the sheet:
ANALOGUE SUPPLY - LT3045 +5VA FOR THE ADS1299 AND REF BUFFER (5.090 V), BACKFEED CLAMP (Rev C10)
LT3045 analogue regulator
SYS in, +5VA out (5.090 V). EN/UV driven by ANA_ENABLE with 100k default-off; RILIM sets about 100 mA. PG unused.
Output voltage set
RSET = R201 49.9k + R207 1.00k = 50.9k (E96, Step 13) with SET current 100 uA. CSET filters reference noise and
sets soft start. Kelvin to OUTS/GND.
Fast start-up (PGFB)
Divider ends the fast-charge of CSET near 4.5 V. Not used for reset.
Output capacitors and bleeder
At least 10 uF effective total required for stability (26 uF worst case at 5.25 V from
the Murata DC-bias curve); bleeder keeps load >= 1 mA with the ADC absent.
Power flags
ERC declarations for supplies that
enter from other sheets.
AVDD backfeed clamp (Step 12)
Rail off: Q201 gate follows +5VA through R209, so current pushed into +5VA by the input clamp diodes turns Q201 on and R208 sinks it (<= 1.3 V modelled at 30-100 V
faults). Rail on: Q202 grounds the gate (5 uA in R209). Also discharges +5VA after a stop.
Sheet notes
SYS comes from the BQ25798 power path (charger sheet): the pack through the battery FET when on battery. Bench only; no human connection.
Layout: OUTS Kelvin-sensed at the output capacitors; SET node, CSET and RSET return Kelvin to the same ground. ILIM (~100 mA) is not patient protection.
Reverse-current protection does not stop back-powering through signal pins. Q201 now holds +5VA down whenever ANA_ENABLE is low, powered or not (Step 12). ADC I/O gating is on the adc_interface sheet.

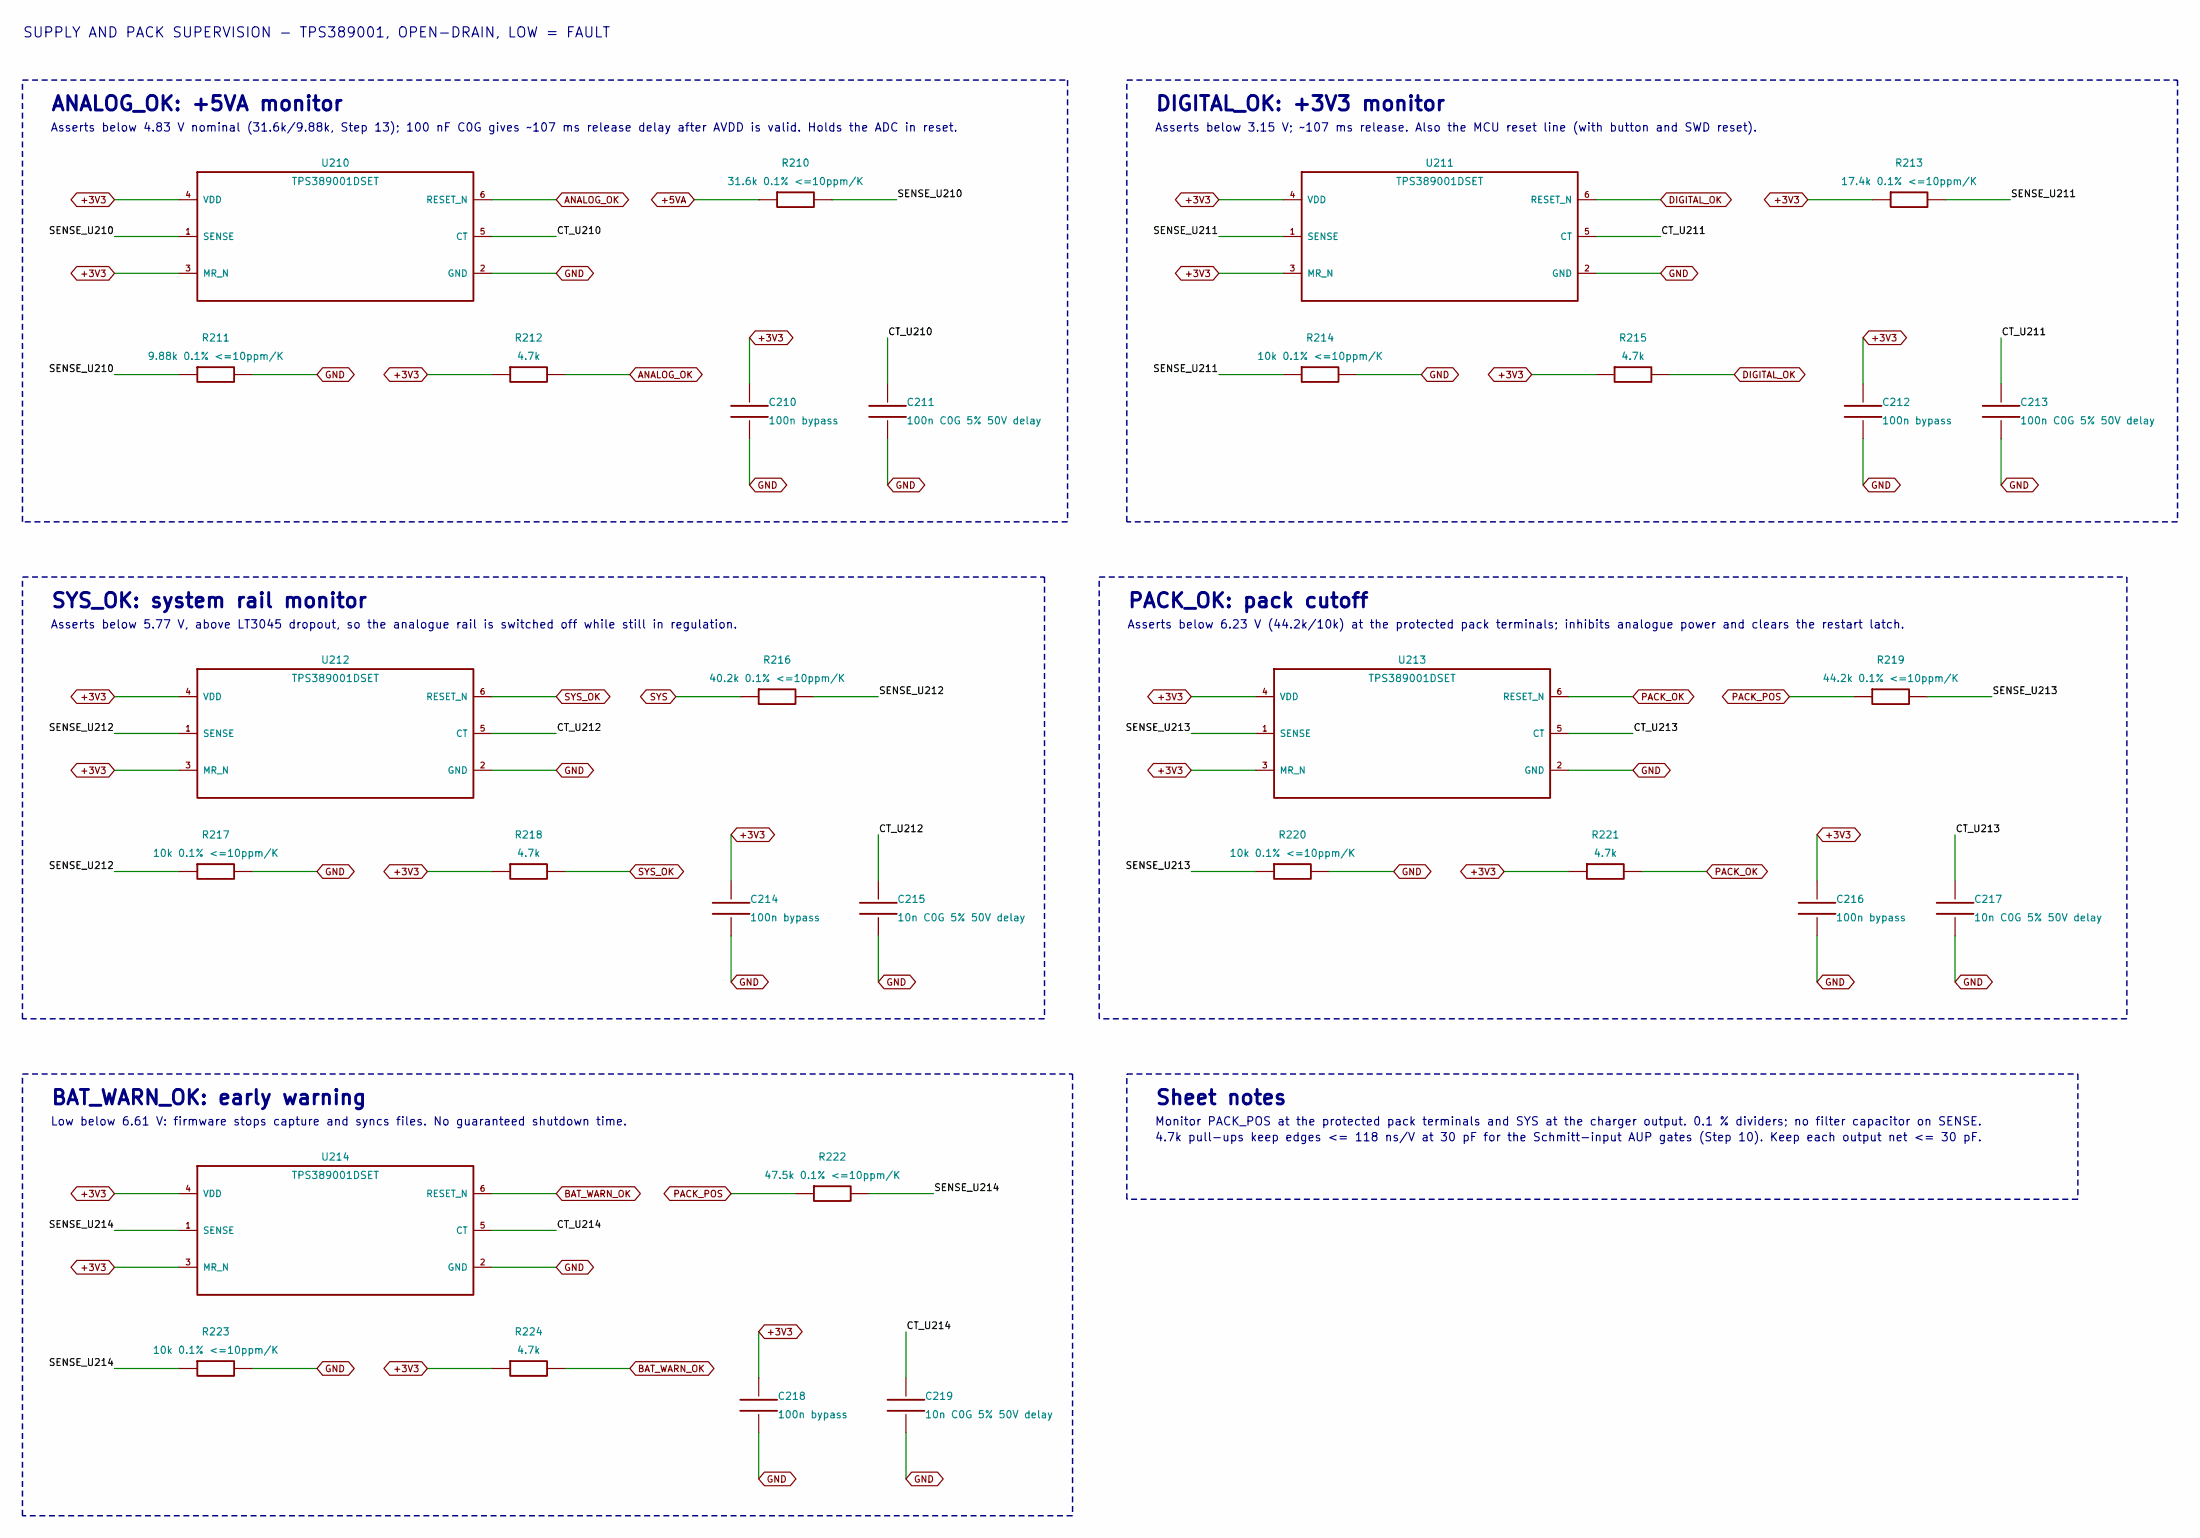
[picture p8: schematic supervision.kicad_sch, Rev C step 4 - precision supply and pack monitoring]

Parts:
C210, C212, C214, C216, C218: 100n bypass; C_0603_1608Metric; MPN GCM188R71H104KA57D
C211, C213: 100n C0G 5% 50V delay; C_1206_3216Metric; MPN GRM31C5C1H104JA01L
C215, C217, C219: 10n C0G 5% 50V delay; C_0603_1608Metric; MPN GCM1885C1H103JA16D
R210: 31.6k 0.1% <=10ppm/K; R_0603_1608Metric; MPN ERA-3ARB3162V
R211: 9.88k 0.1% <=10ppm/K; R_0603_1608Metric; MPN ERA-3ARB9881V
R212, R215, R218, R221, R224: 4.7k; R_0603_1608Metric; MPN ERJ-3EKF4701V
R213: 17.4k 0.1% <=10ppm/K; R_0603_1608Metric; MPN ERA-3ARB1742V
R214, R217, R220, R223: 10k 0.1% <=10ppm/K; R_0603_1608Metric; MPN ERA-3ARB103V
R216: 40.2k 0.1% <=10ppm/K; R_0603_1608Metric; MPN ERA-3ARB4022V
R219: 44.2k 0.1% <=10ppm/K; R_0603_1608Metric; MPN ERA-3ARB4422V
R222: 47.5k 0.1% <=10ppm/K; R_0603_1608Metric; MPN ERA-3ARB4752V
U210, U211, U212, U213, U214: TPS389001DSET; WSON-6_1.5x1.5mm_P0.5mm; MPN TPS389001DSET

Connections:
+3V3: C210.1, C212.1, C214.1, C216.1, C218.1, R212.1, R213.1, R215.1, R218.1, R221.1, R224.1, U210.3 (MR_N), U210.4 (VDD), U211.3 (MR_N), U211.4 (VDD), U212.3 (MR_N), U212.4 (VDD), U213.3 (MR_N), U213.4 (VDD), U214.3 (MR_N), U214.4 (VDD); also elsewhere on the board
+5VA: R210.1; also elsewhere on the board
/supervision/CT_U210: C211.1, U210.5 (CT)
/supervision/CT_U211: C213.1, U211.5 (CT)
/supervision/CT_U212: C215.1, U212.5 (CT)
/supervision/CT_U213: C217.1, U213.5 (CT)
/supervision/CT_U214: C219.1, U214.5 (CT)
/supervision/SENSE_U210: R210.2, R211.1, U210.1 (SENSE)
/supervision/SENSE_U211: R213.2, R214.1, U211.1 (SENSE)
/supervision/SENSE_U212: R216.2, R217.1, U212.1 (SENSE)
/supervision/SENSE_U213: R219.2, R220.1, U213.1 (SENSE)
/supervision/SENSE_U214: R222.2, R223.1, U214.1 (SENSE)
ANALOG_OK: R212.2, U210.6 (RESET_N); also elsewhere on the board
BAT_WARN_OK: R224.2, U214.6 (RESET_N); also elsewhere on the board
DIGITAL_OK: R215.2, U211.6 (RESET_N); also elsewhere on the board
GND: C210.2, C211.2, C212.2, C213.2, C214.2, C215.2, C216.2, C217.2, C218.2, C219.2, R211.2, R214.2, R217.2, R220.2, R223.2, U210.2 (GND), U211.2 (GND), U212.2 (GND), U213.2 (GND), U214.2 (GND); also elsewhere on the board
PACK_OK: R221.2, U213.6 (RESET_N); also elsewhere on the board
PACK_POS: R219.1, R222.1; also elsewhere on the board
SYS: R216.1; also elsewhere on the board
SYS_OK: R218.2, U212.6 (RESET_N); also elsewhere on the board

Notes on the sheet:
SUPPLY AND PACK SUPERVISION - TPS389001, OPEN-DRAIN, LOW = FAULT
ANALOG_OK: +5VA monitor
Asserts below 4.83 V nominal (31.6k/9.88k, Step 13); 100 nF C0G gives ~107 ms release delay after AVDD is valid. Holds the ADC in reset.
DIGITAL_OK: +3V3 monitor
Asserts below 3.15 V; ~107 ms release. Also the MCU reset line (with button and SWD reset).
SYS_OK: system rail monitor
Asserts below 5.77 V, above LT3045 dropout, so the analogue rail is switched off while still in regulation.
PACK_OK: pack cutoff
Asserts below 6.23 V (44.2k/10k) at the protected pack terminals; inhibits analogue power and clears the restart latch.
BAT_WARN_OK: early warning
Low below 6.61 V: firmware stops capture and syncs files. No guaranteed shutdown time.
Sheet notes
Monitor PACK_POS at the protected pack terminals and SYS at the charger output. 0.1 % dividers; no filter capacitor on SENSE.
4.7k pull-ups keep edges <= 118 ns/V at 30 pF for the Schmitt-input AUP gates (Step 10). Keep each output net <= 30 pF.
