MariusFauteux/EEG-PCB/hardware/EEG_RevC.kicad_pcb

## KiCad design hardware/EEG_RevC.kicad_pcb (continued)

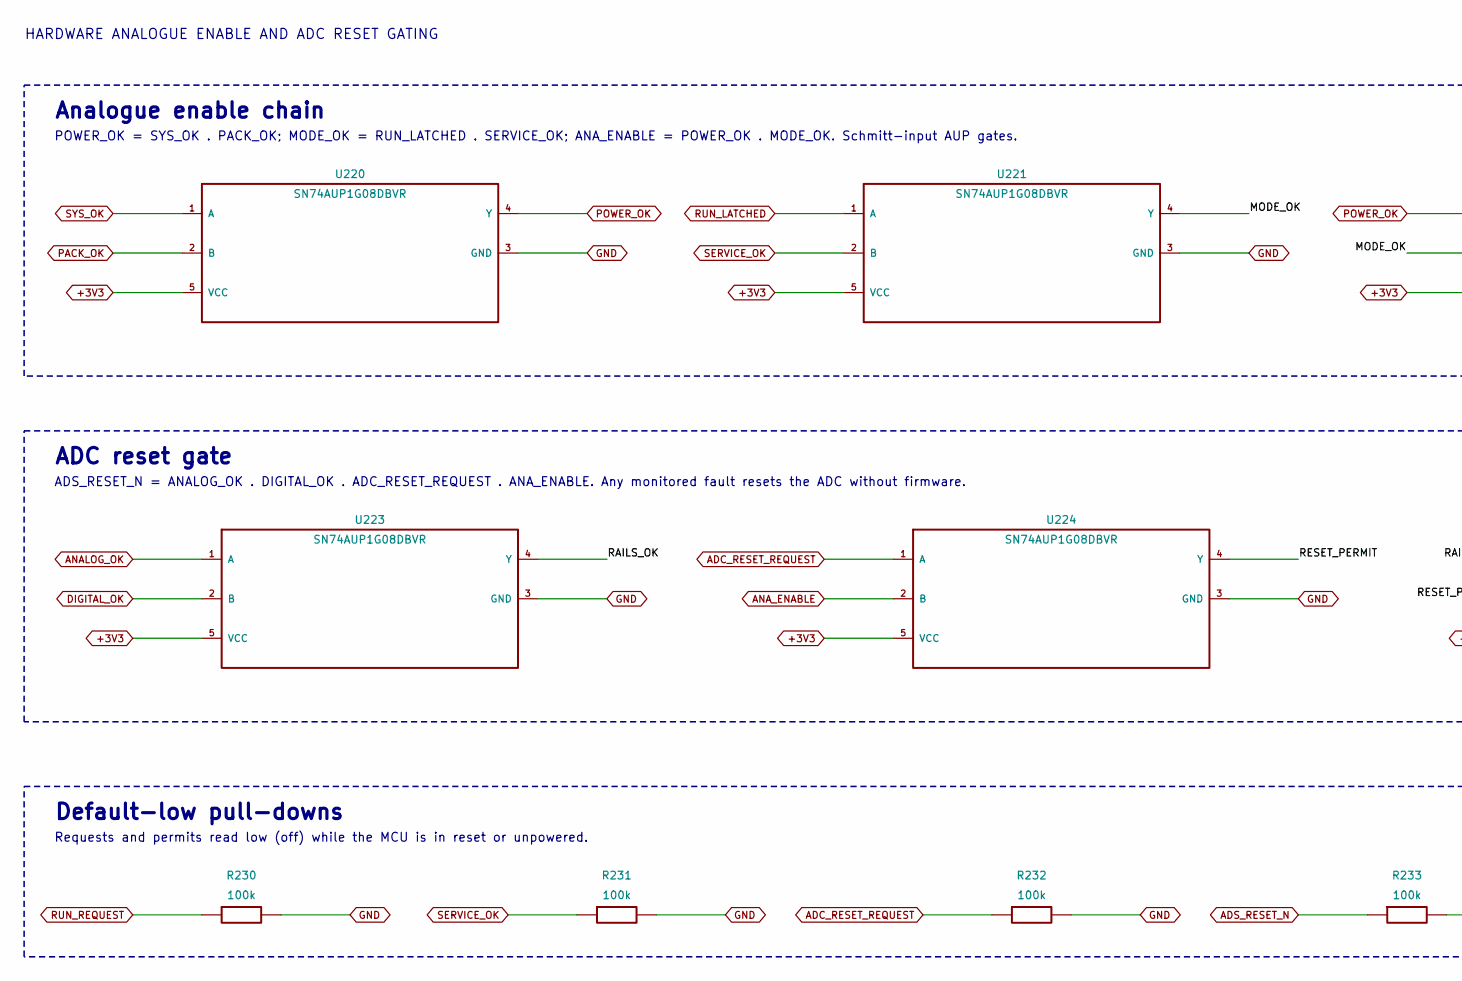
[picture p9: schematic reset_logic.kicad_sch, Rev C step 4 - hardware enable and reset gating, part in row 1, column 1]

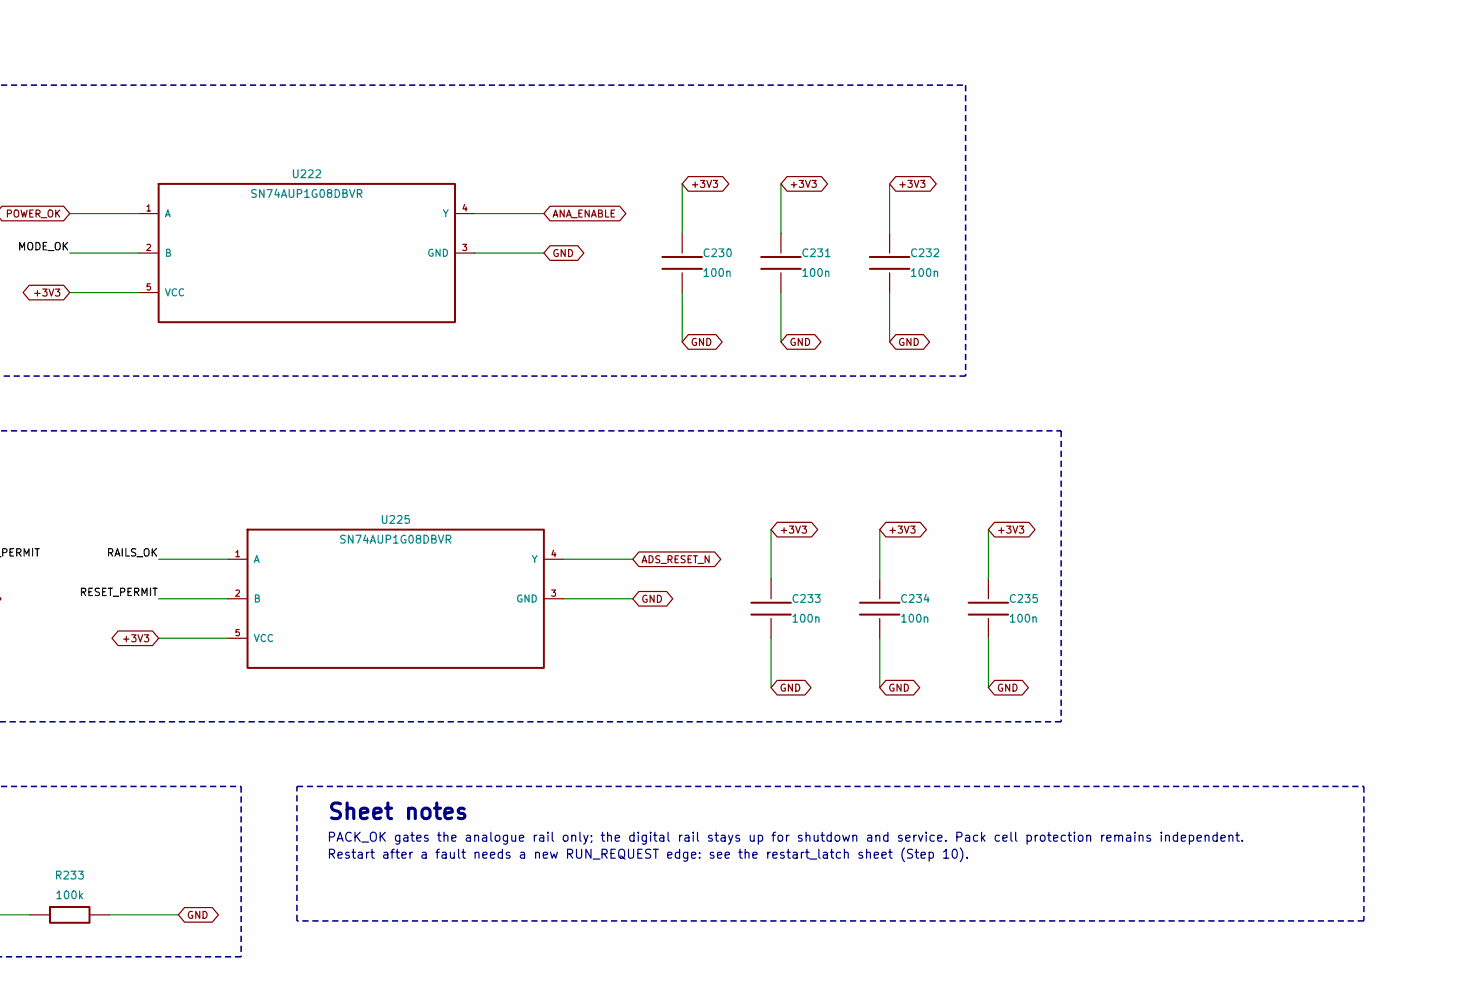
[picture p10: schematic reset_logic.kicad_sch, Rev C step 4 - hardware enable and reset gating, part in row 1, column 2]

Parts:
C230, C231, C232, C233, C234, C235: 100n; C_0603_1608Metric; MPN GCM188R71H104KA57D
R230, R231, R232, R233: 100k; R_0603_1608Metric; MPN ERJ-3EKF1003V
U220, U221, U222, U223, U224, U225: SN74AUP1G08DBVR; SOT-23-5; MPN SN74AUP1G08DBVR

Connections:
+3V3: C230.1, C231.1, C232.1, C233.1, C234.1, C235.1, U220.5 (VCC), U221.5 (VCC), U222.5 (VCC), U223.5 (VCC), U224.5 (VCC), U225.5 (VCC); also elsewhere on the board
/reset logic/MODE_OK: U221.4 (Y), U222.2 (B)
/reset logic/RAILS_OK: U223.4 (Y), U225.1 (A)
/reset logic/RESET_PERMIT: U224.4 (Y), U225.2 (B)
ADC_RESET_REQUEST: R232.1, U224.1 (A); also elsewhere on the board
ADS_RESET_N: R233.1, U225.4 (Y); also elsewhere on the board
ANALOG_OK: U223.1 (A); also elsewhere on the board
ANA_ENABLE: U222.4 (Y), U224.2 (B); also elsewhere on the board
DIGITAL_OK: U223.2 (B); also elsewhere on the board
GND: C230.2, C231.2, C232.2, C233.2, C234.2, C235.2, R230.2, R231.2, R232.2, R233.2, U220.3 (GND), U221.3 (GND), U222.3 (GND), U223.3 (GND), U224.3 (GND), U225.3 (GND); also elsewhere on the board
PACK_OK: U220.2 (B); also elsewhere on the board
POWER_OK: U220.4 (Y), U222.1 (A); also elsewhere on the board
RUN_LATCHED: U221.1 (A); also elsewhere on the board
RUN_REQUEST: R230.1; also elsewhere on the board
SERVICE_OK: R231.1, U221.2 (B); also elsewhere on the board
SYS_OK: U220.1 (A); also elsewhere on the board

Notes on the sheet:
HARDWARE ANALOGUE ENABLE AND ADC RESET GATING
Analogue enable chain
POWER_OK = SYS_OK . PACK_OK; MODE_OK = RUN_LATCHED . SERVICE_OK; ANA_ENABLE = POWER_OK . MODE_OK. Schmitt-input AUP gates.
ADC reset gate
ADS_RESET_N = ANALOG_OK . DIGITAL_OK . ADC_RESET_REQUEST . ANA_ENABLE. Any monitored fault resets the ADC without firmware.
Default-low pull-downs
Requests and permits read low (off) while the MCU is in reset or unpowered.
Sheet notes
PACK_OK gates the analogue rail only; the digital rail stays up for shutdown and service. Pack cell protection remains independent.
Restart after a fault needs a new RUN_REQUEST edge: see the restart_latch sheet (Step 10).

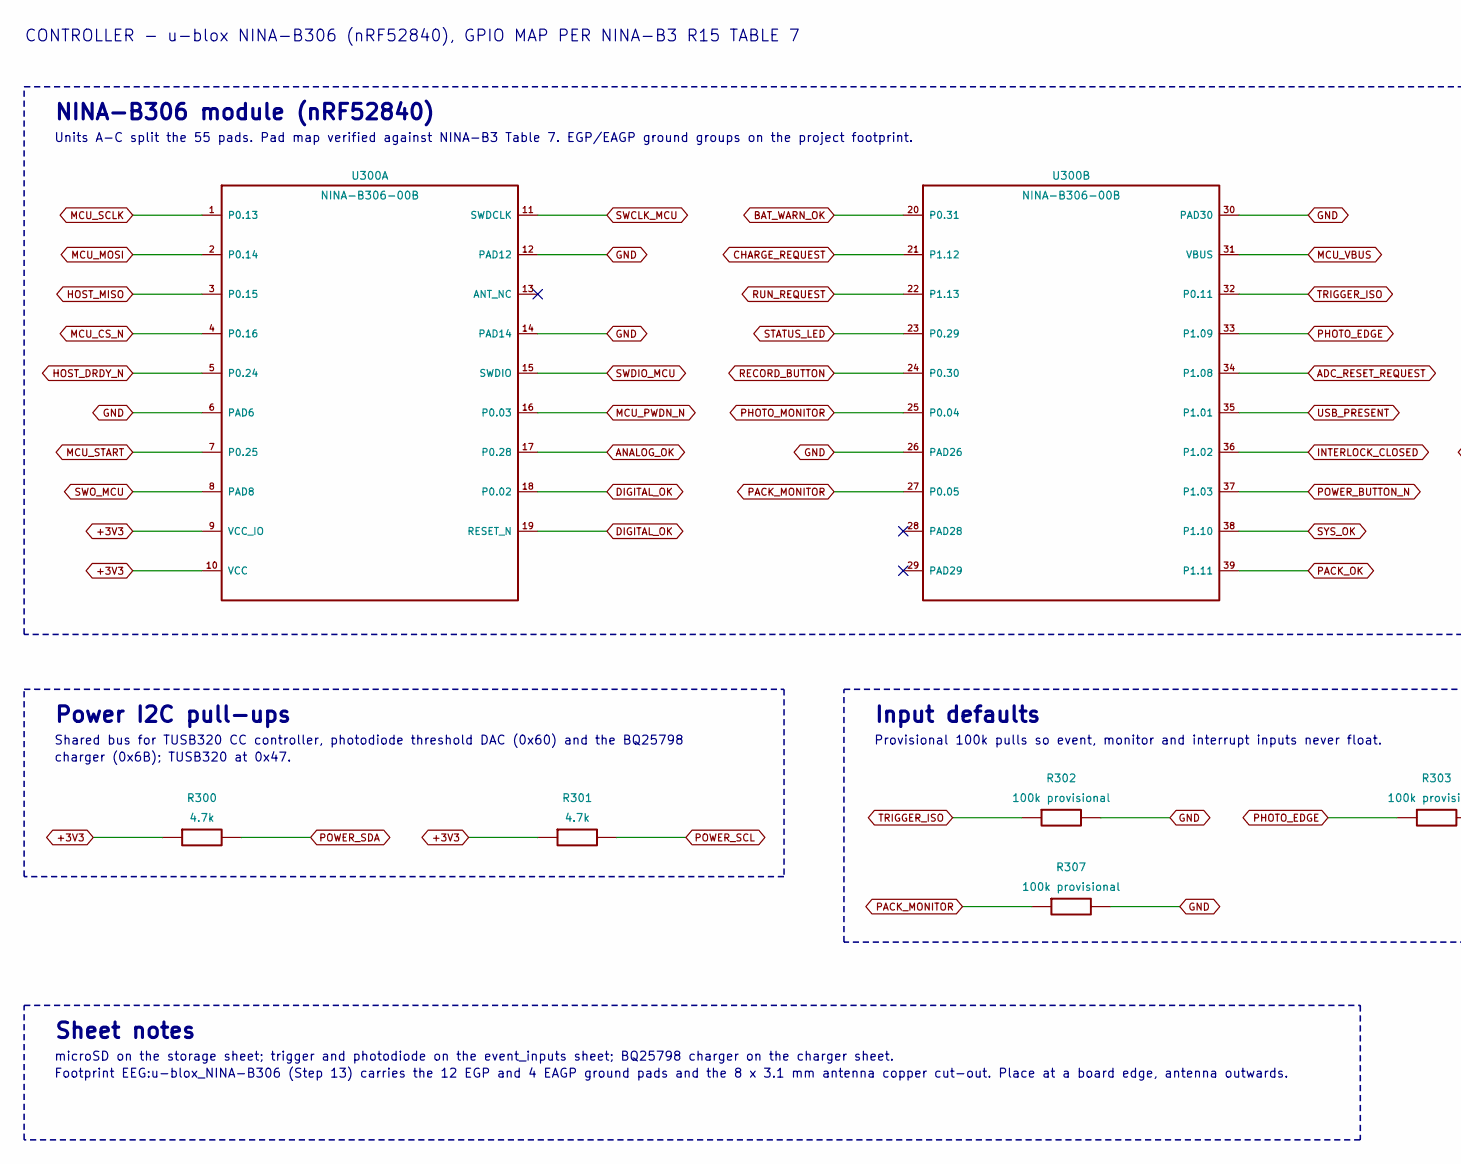
[picture p11: schematic controller.kicad_sch, NINA-B306 controller and reserved interfaces, part in row 1, column 1]

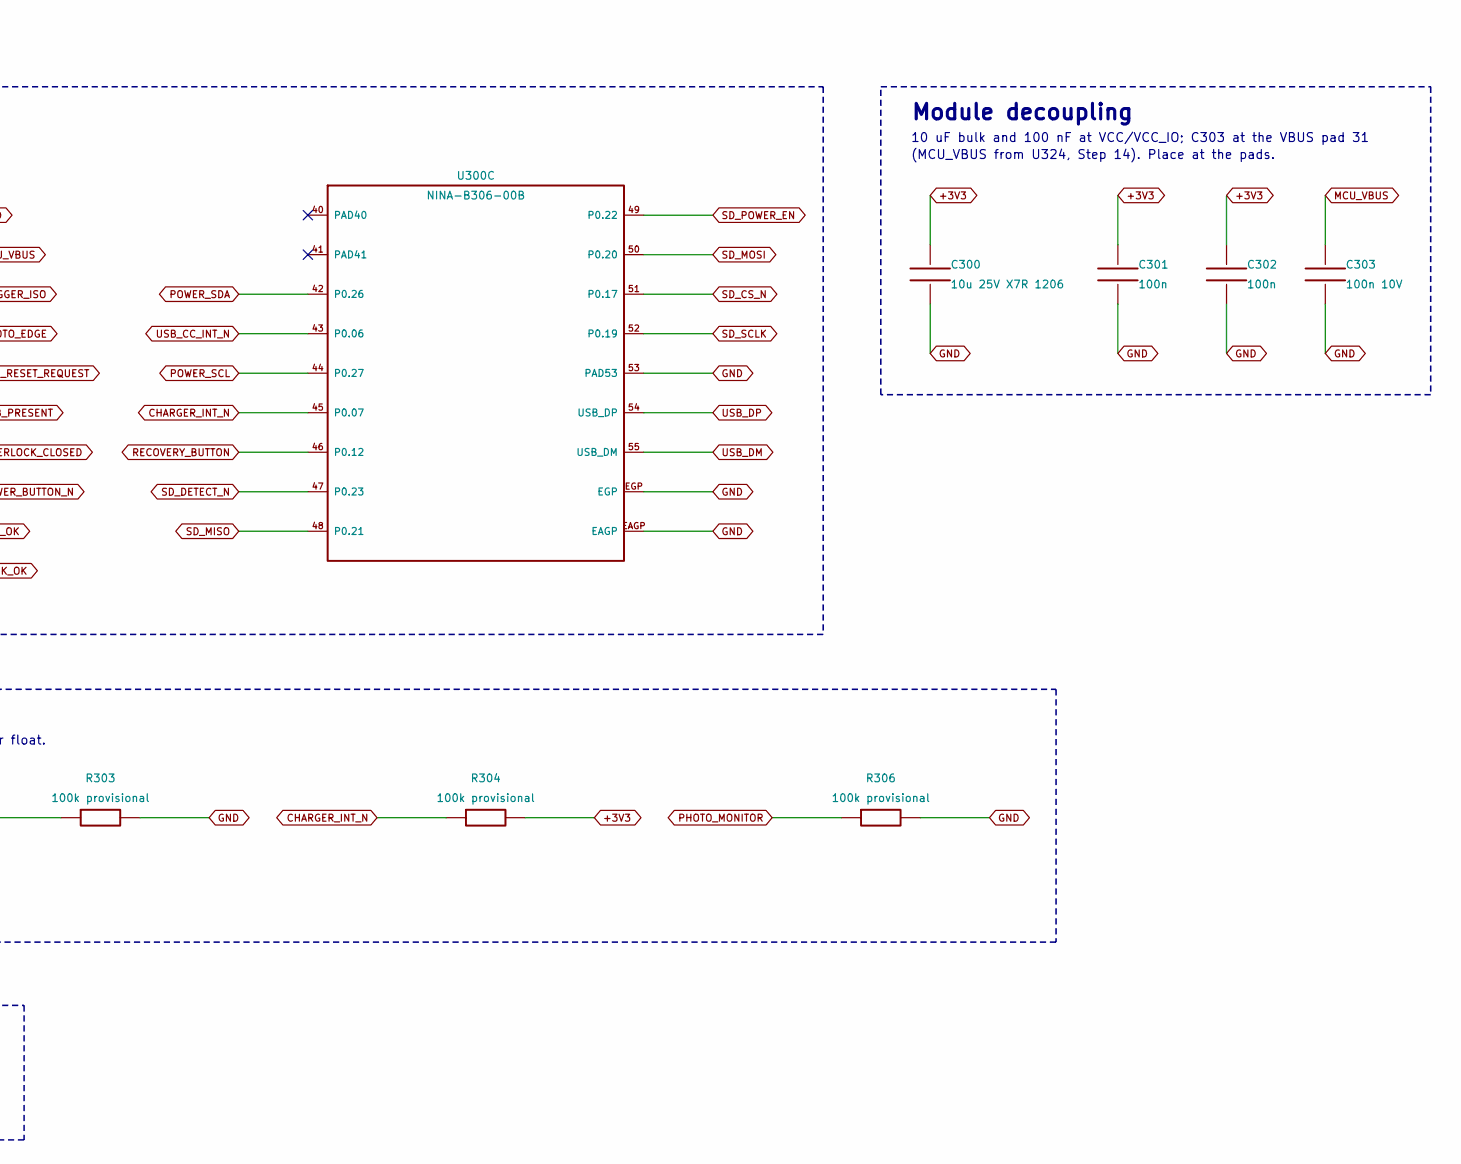
[picture p12: schematic controller.kicad_sch, NINA-B306 controller and reserved interfaces, part in row 1, column 2]

Parts:
C300: 10u 25V X7R 1206; C_1206_3216Metric; MPN GRM31CR71E106KA12L
C301, C302: 100n; C_0603_1608Metric; MPN GCM188R71H104KA57D
C303: 100n 10V; C_0603_1608Metric; MPN GCM188R71H104KA57D
R300, R301: 4.7k; R_0603_1608Metric; MPN ERJ-3EKF4701V
R302, R303, R304, R306, R307: 100k provisional; R_0603_1608Metric; MPN ERJ-3EKF1003V
U300: NINA-B306-00B; u-blox_NINA-B306; MPN NINA-B306-00B

Connections:
+3V3: C300.1, C301.1, C302.1, R300.1, R301.1, R304.2, U300.9 (VCC_IO), U300.10 (VCC); also elsewhere on the board
ADC_RESET_REQUEST: U300.34 (P1.08); also elsewhere on the board
ANALOG_OK: U300.17 (P0.28); also elsewhere on the board
BAT_WARN_OK: U300.20 (P0.31); also elsewhere on the board
CHARGER_INT_N: R304.1, U300.45 (P0.07); also elsewhere on the board
CHARGE_REQUEST: U300.21 (P1.12); also elsewhere on the board
DIGITAL_OK: U300.18 (P0.02), U300.19 (RESET_N); also elsewhere on the board
GND: C300.2, C301.2, C302.2, C303.2, R302.2, R303.2, R306.2, R307.2, U300.6, U300.12, U300.14, U300.26, U300.30, U300.53, U300.EAGP, U300.EGP; also elsewhere on the board
HOST_DRDY_N: U300.5 (P0.24); also elsewhere on the board
HOST_MISO: U300.3 (P0.15); also elsewhere on the board
INTERLOCK_CLOSED: U300.36 (P1.02); also elsewhere on the board
MCU_CS_N: U300.4 (P0.16); also elsewhere on the board
MCU_MOSI: U300.2 (P0.14); also elsewhere on the board
MCU_PWDN_N: U300.16 (P0.03); also elsewhere on the board
MCU_SCLK: U300.1 (P0.13); also elsewhere on the board
MCU_START: U300.7 (P0.25); also elsewhere on the board
MCU_VBUS: C303.1, U300.31 (VBUS); also elsewhere on the board
PACK_MONITOR: R307.1, U300.27 (P0.05)
PACK_OK: U300.39 (P1.11); also elsewhere on the board
PHOTO_EDGE: R303.1, U300.33 (P1.09); also elsewhere on the board
PHOTO_MONITOR: R306.1, U300.25 (P0.04); also elsewhere on the board
POWER_BUTTON_N: U300.37 (P1.03); also elsewhere on the board
POWER_SCL: R301.2, U300.44 (P0.27); also elsewhere on the board
POWER_SDA: R300.2, U300.42 (P0.26); also elsewhere on the board
RECORD_BUTTON: U300.24 (P0.30); also elsewhere on the board
RECOVERY_BUTTON: U300.46 (P0.12); also elsewhere on the board
RUN_REQUEST: U300.22 (P1.13); also elsewhere on the board
SD_CS_N: U300.51 (P0.17); also elsewhere on the board
SD_DETECT_N: U300.47 (P0.23); also elsewhere on the board
SD_MISO: U300.48 (P0.21); also elsewhere on the board
SD_MOSI: U300.50 (P0.20); also elsewhere on the board
SD_POWER_EN: U300.49 (P0.22); also elsewhere on the board
SD_SCLK: U300.52 (P0.19); also elsewhere on the board
STATUS_LED: U300.23 (P0.29); also elsewhere on the board
SWCLK_MCU: U300.11 (SWDCLK); also elsewhere on the board
SWDIO_MCU: U300.15 (SWDIO); also elsewhere on the board
SWO_MCU: U300.8; also elsewhere on the board
SYS_OK: U300.38 (P1.10); also elsewhere on the board
TRIGGER_ISO: R302.1, U300.32 (P0.11); also elsewhere on the board
USB_CC_INT_N: U300.43 (P0.06); also elsewhere on the board
USB_DM: U300.55 (USB_DM); also elsewhere on the board
USB_DP: U300.54 (USB_DP); also elsewhere on the board
USB_PRESENT: U300.35 (P1.01); also elsewhere on the board

Notes on the sheet:
CONTROLLER - u-blox NINA-B306 (nRF52840), GPIO MAP PER NINA-B3 R15 TABLE 7
NINA-B306 module (nRF52840)
Units A-C split the 55 pads. Pad map verified against NINA-B3 Table 7. EGP/EAGP ground groups on the project footprint.
Module decoupling
10 uF bulk and 100 nF at VCC/VCC_IO; C303 at the VBUS pad 31
(MCU_VBUS from U324, Step 14). Place at the pads.
Power I2C pull-ups
Shared bus for TUSB320 CC controller, photodiode threshold DAC (0x60) and the BQ25798
charger (0x6B); TUSB320 at 0x47.
Input defaults
Provisional 100k pulls so event, monitor and interrupt inputs never float.
Sheet notes
microSD on the storage sheet; trigger and photodiode on the event_inputs sheet; BQ25798 charger on the charger sheet.
Footprint EEG:u-blox_NINA-B306 (Step 13) carries the 12 EGP and 4 EAGP ground pads and the 8 x 3.1 mm antenna copper cut-out. Place at a board edge, antenna outwards.

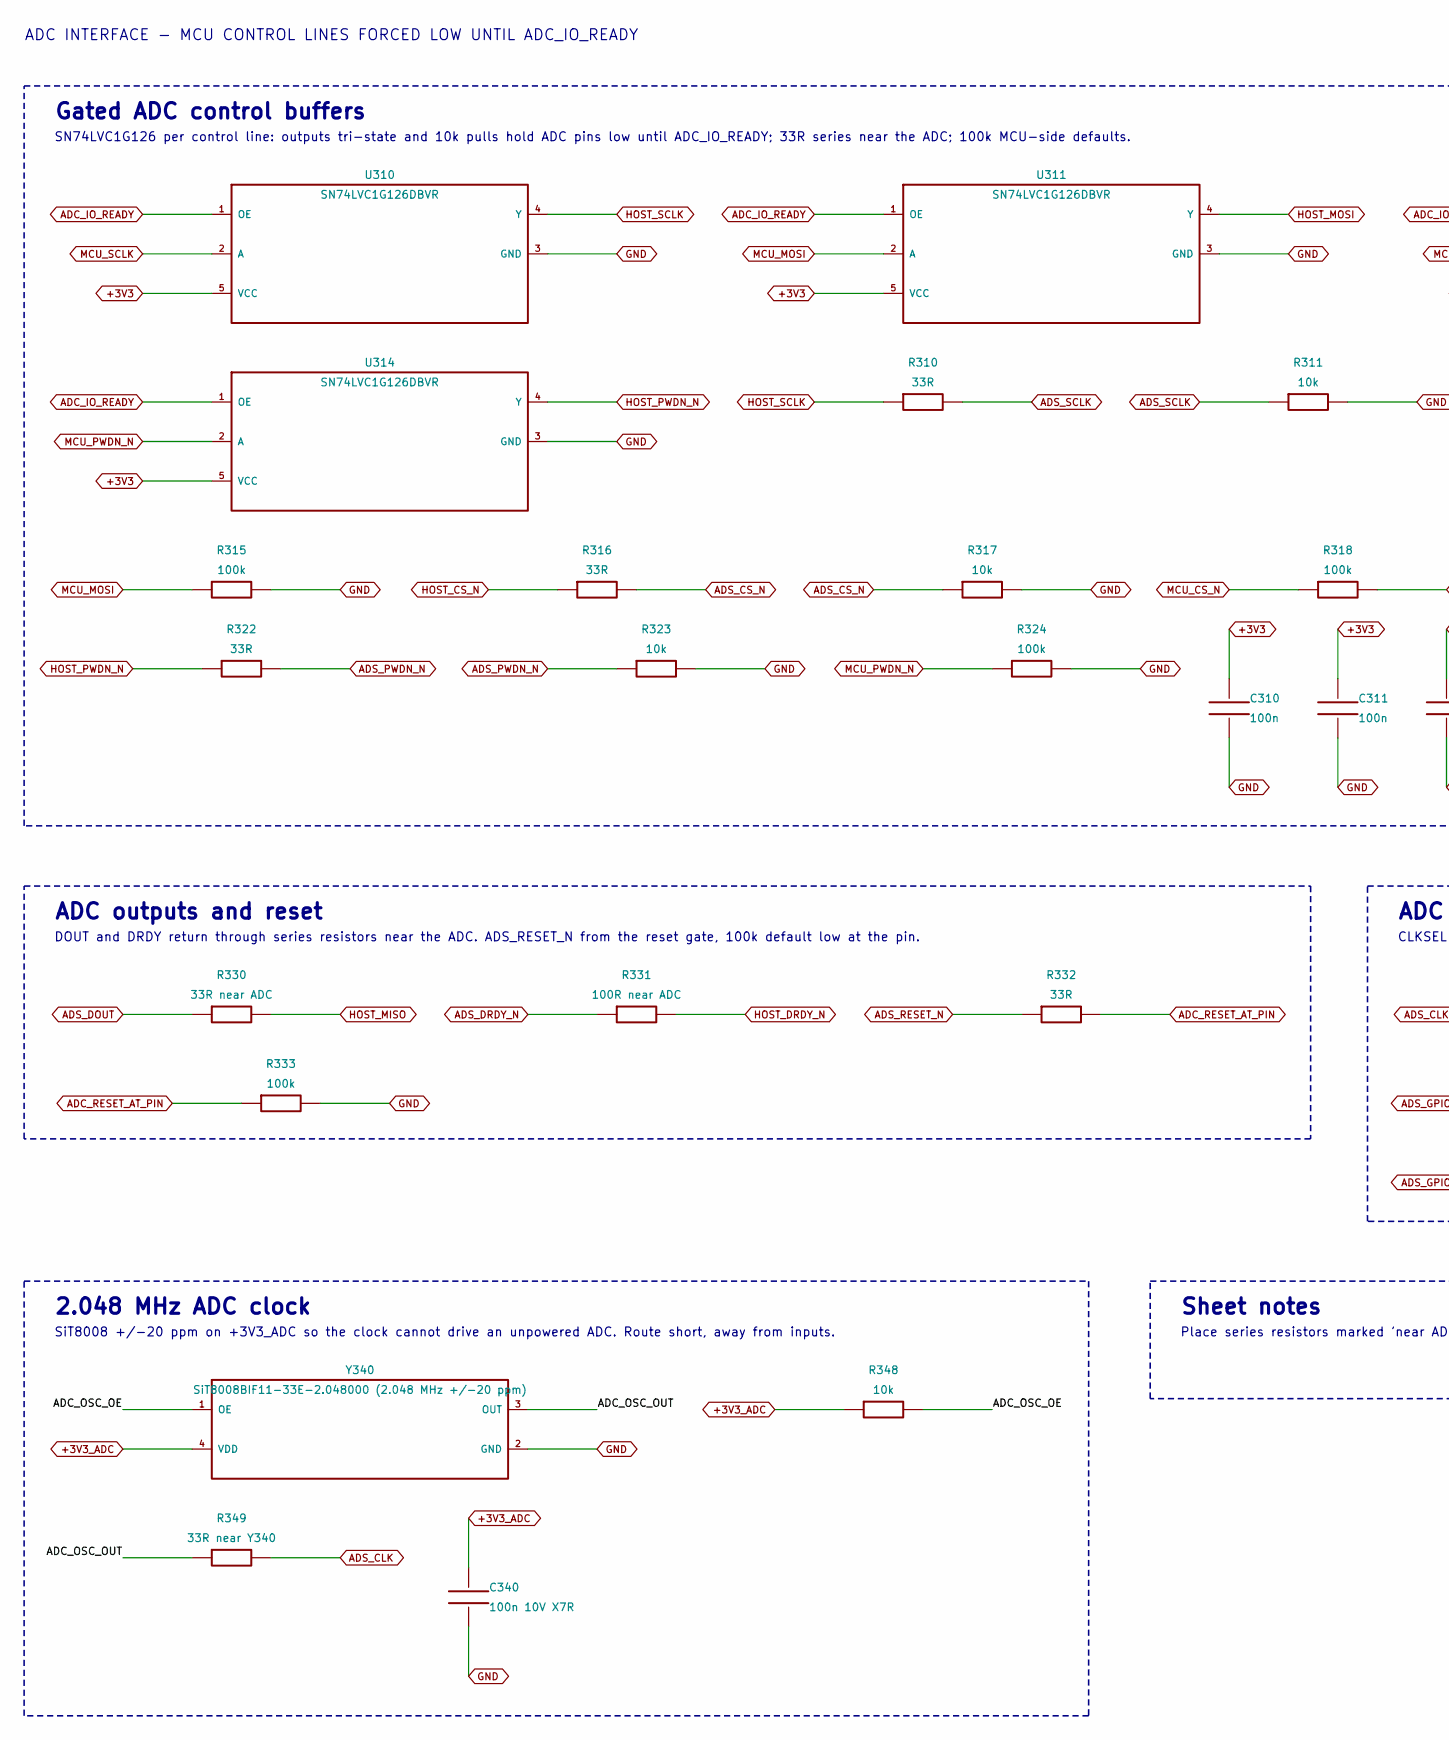
[picture p13: schematic adc_interface.kicad_sch, ADC startup gating and SPI connections, part in row 1, column 1]

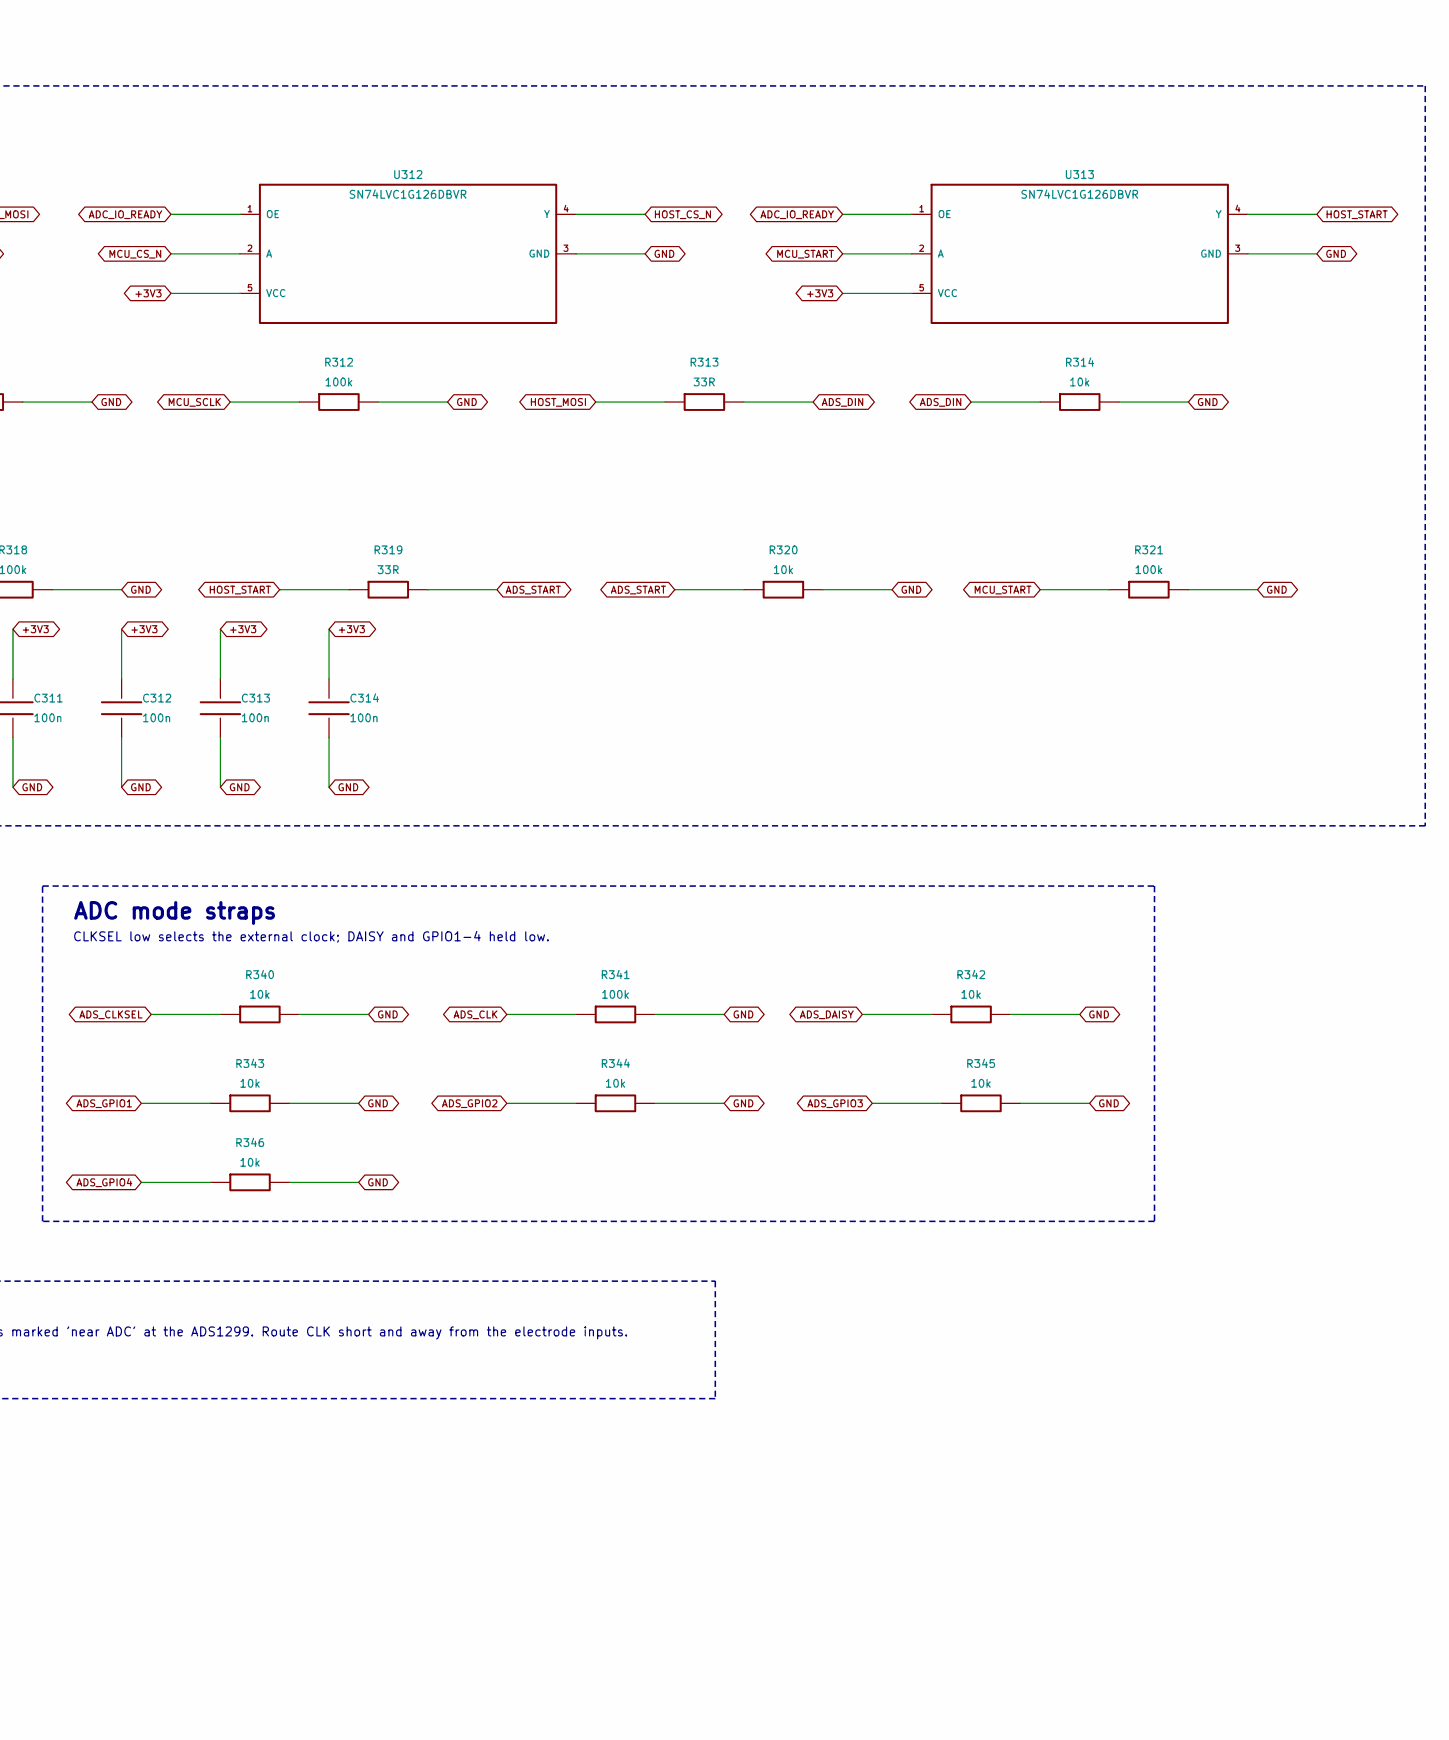
[picture p14: schematic adc_interface.kicad_sch, ADC startup gating and SPI connections, part in row 1, column 2]

Parts:
C310, C311, C312, C313, C314: 100n; C_0603_1608Metric; MPN GCM188R71H104KA57D
C340: 100n 10V X7R; C_0603_1608Metric; MPN GCM188R71H104KA57D
R310, R313, R316, R319, R322, R332: 33R; R_0603_1608Metric; MPN ERJ-3EKF33R0V
R311, R314, R317, R320, R323, R340, R342, R343, R344, R345, R346, R348: 10k; R_0603_1608Metric; MPN ERJ-3EKF1002V
R312, R315, R318, R321, R324, R333, R341: 100k; R_0603_1608Metric; MPN ERJ-3EKF1003V
R330: 33R near ADC; R_0603_1608Metric; MPN ERJ-3EKF33R0V
R331: 100R near ADC; R_0603_1608Metric; MPN ERJ-3EKF1000V
R349: 33R near Y340; R_0603_1608Metric; MPN ERJ-3EKF33R0V
U310, U311, U312, U313, U314: SN74LVC1G126DBVR; SOT-23-5; MPN SN74LVC1G126DBVR
Y340: SiT8008BIF11-33E-2.048000 (2.048 MHz +/-20 ppm); Oscillator_SMD_SiT_PQFN-4Pin_2.5x2.0mm; MPN SIT8008BIF11-33E-2.048000

Connections:
+3V3: C310.1, C311.1, C312.1, C313.1, C314.1, U310.5 (VCC), U311.5 (VCC), U312.5 (VCC), U313.5 (VCC), U314.5 (VCC); also elsewhere on the board
+3V3_ADC: C340.1, R348.1, Y340.4 (VDD); also elsewhere on the board
/ADC startup gating and SPI connections/ADC_OSC_OE: R348.2, Y340.1 (OE)
/ADC startup gating and SPI connections/ADC_OSC_OUT: R349.1, Y340.3 (OUT)
ADC_IO_READY: U310.1 (OE), U311.1 (OE), U312.1 (OE), U313.1 (OE), U314.1 (OE); also elsewhere on the board
ADC_RESET_AT_PIN: R332.2, R333.1; also elsewhere on the board
ADS_CLK: R341.1, R349.2; also elsewhere on the board
ADS_CLKSEL: R340.1; also elsewhere on the board
ADS_CS_N: R316.2, R317.1; also elsewhere on the board
ADS_DAISY: R342.1; also elsewhere on the board
ADS_DIN: R313.2, R314.1; also elsewhere on the board
ADS_DOUT: R330.1; also elsewhere on the board
ADS_DRDY_N: R331.1; also elsewhere on the board
ADS_GPIO1: R343.1; also elsewhere on the board
ADS_GPIO2: R344.1; also elsewhere on the board
ADS_GPIO3: R345.1; also elsewhere on the board
ADS_GPIO4: R346.1; also elsewhere on the board
ADS_PWDN_N: R322.2, R323.1; also elsewhere on the board
ADS_RESET_N: R332.1; also elsewhere on the board
ADS_SCLK: R310.2, R311.1; also elsewhere on the board
ADS_START: R319.2, R320.1; also elsewhere on the board
GND: C310.2, C311.2, C312.2, C313.2, C314.2, C340.2, R311.2, R312.2, R314.2, R315.2, R317.2, R318.2, R320.2, R321.2, R323.2, R324.2, R333.2, R340.2, R341.2, R342.2, R343.2, R344.2, R345.2, R346.2, U310.3 (GND), U311.3 (GND), U312.3 (GND), U313.3 (GND), U314.3 (GND), Y340.2 (GND); also elsewhere on the board
HOST_CS_N: R316.1, U312.4 (Y)
HOST_DRDY_N: R331.2; also elsewhere on the board
HOST_MISO: R330.2; also elsewhere on the board
HOST_MOSI: R313.1, U311.4 (Y)
HOST_PWDN_N: R322.1, U314.4 (Y)
HOST_SCLK: R310.1, U310.4 (Y)
HOST_START: R319.1, U313.4 (Y)
MCU_CS_N: R318.1, U312.2 (A); also elsewhere on the board
MCU_MOSI: R315.1, U311.2 (A); also elsewhere on the board
MCU_PWDN_N: R324.1, U314.2 (A); also elsewhere on the board
MCU_SCLK: R312.1, U310.2 (A); also elsewhere on the board
MCU_START: R321.1, U313.2 (A); also elsewhere on the board

Notes on the sheet:
ADC INTERFACE - MCU CONTROL LINES FORCED LOW UNTIL ADC_IO_READY
Gated ADC control buffers
SN74LVC1G126 per control line: outputs tri-state and 10k pulls hold ADC pins low until ADC_IO_READY; 33R series near the ADC; 100k MCU-side defaults.
ADC outputs and reset
DOUT and DRDY return through series resistors near the ADC. ADS_RESET_N from the reset gate, 100k default low at the pin.
ADC mode straps
CLKSEL low selects the external clock; DAISY and GPIO1-4 held low.
2.048 MHz ADC clock
SiT8008 +/-20 ppm on +3V3_ADC so the clock cannot drive an unpowered ADC. Route short, away from inputs.
Sheet notes
Place series resistors marked 'near ADC' at the ADS1299. Route CLK short and away from the electrode inputs.

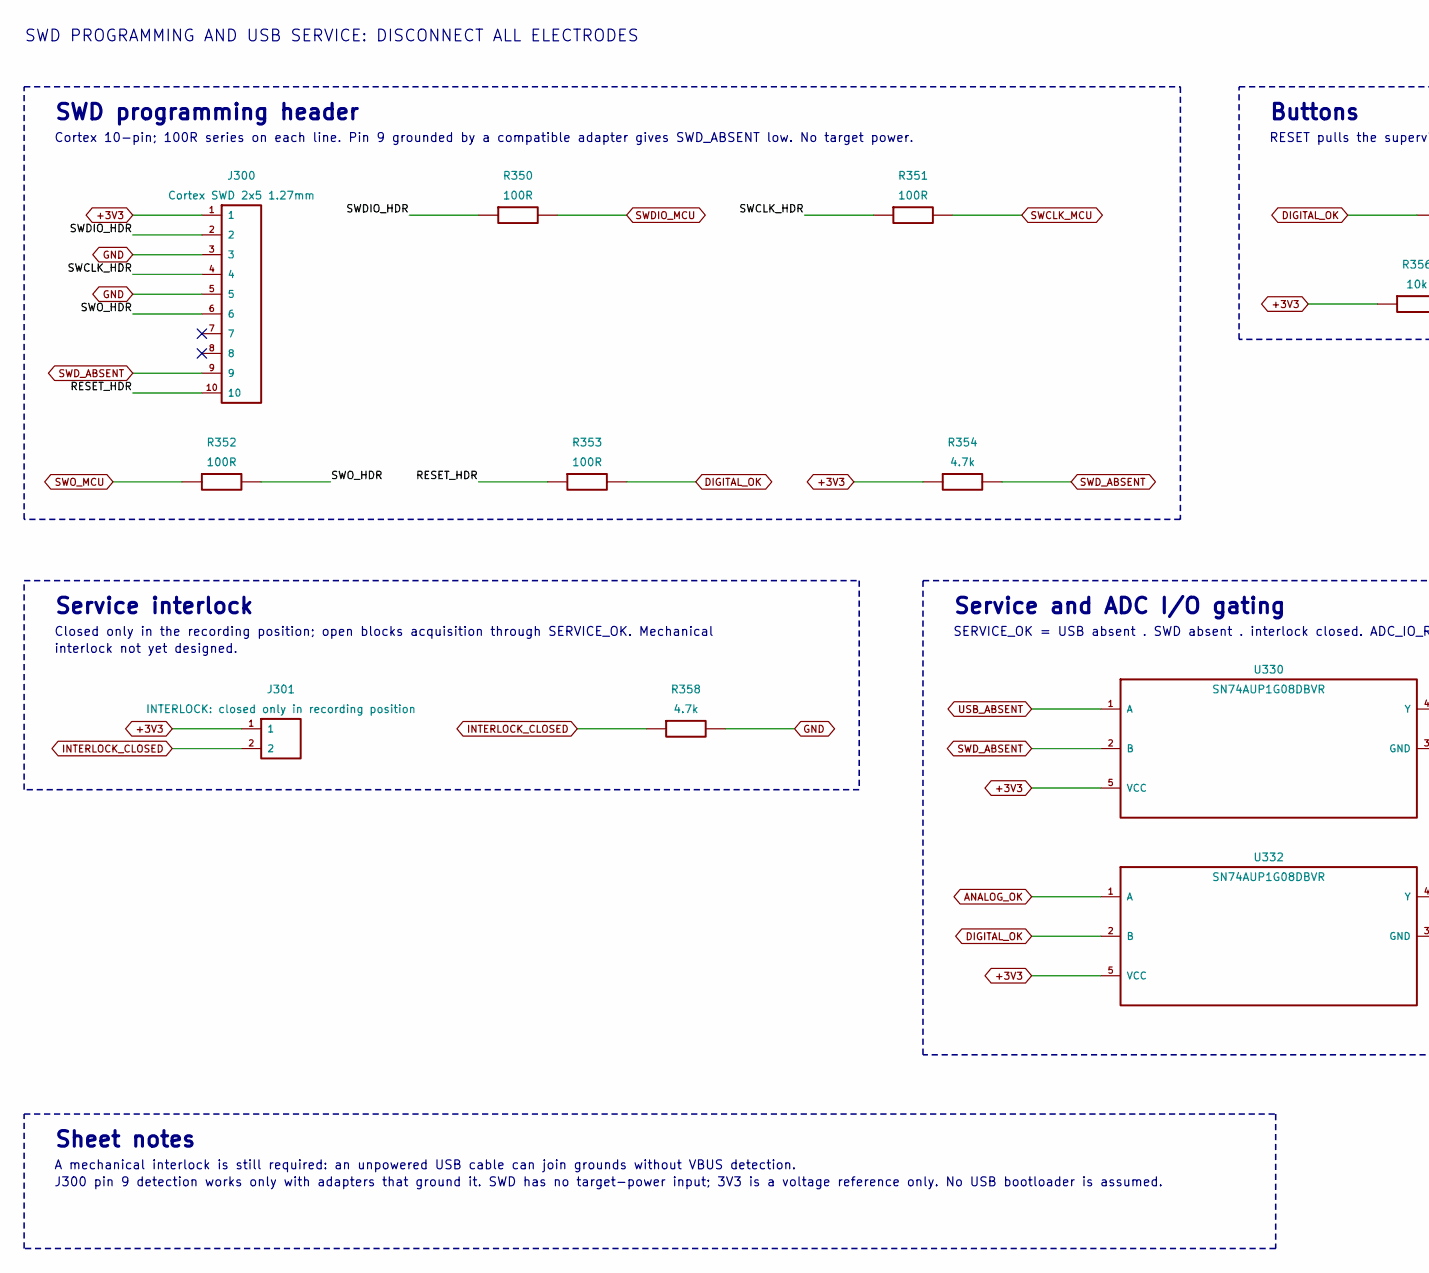
[picture p15: schematic debug_service.kicad_sch, SWD / buttons / hardware service inhibit, part in row 1, column 1]

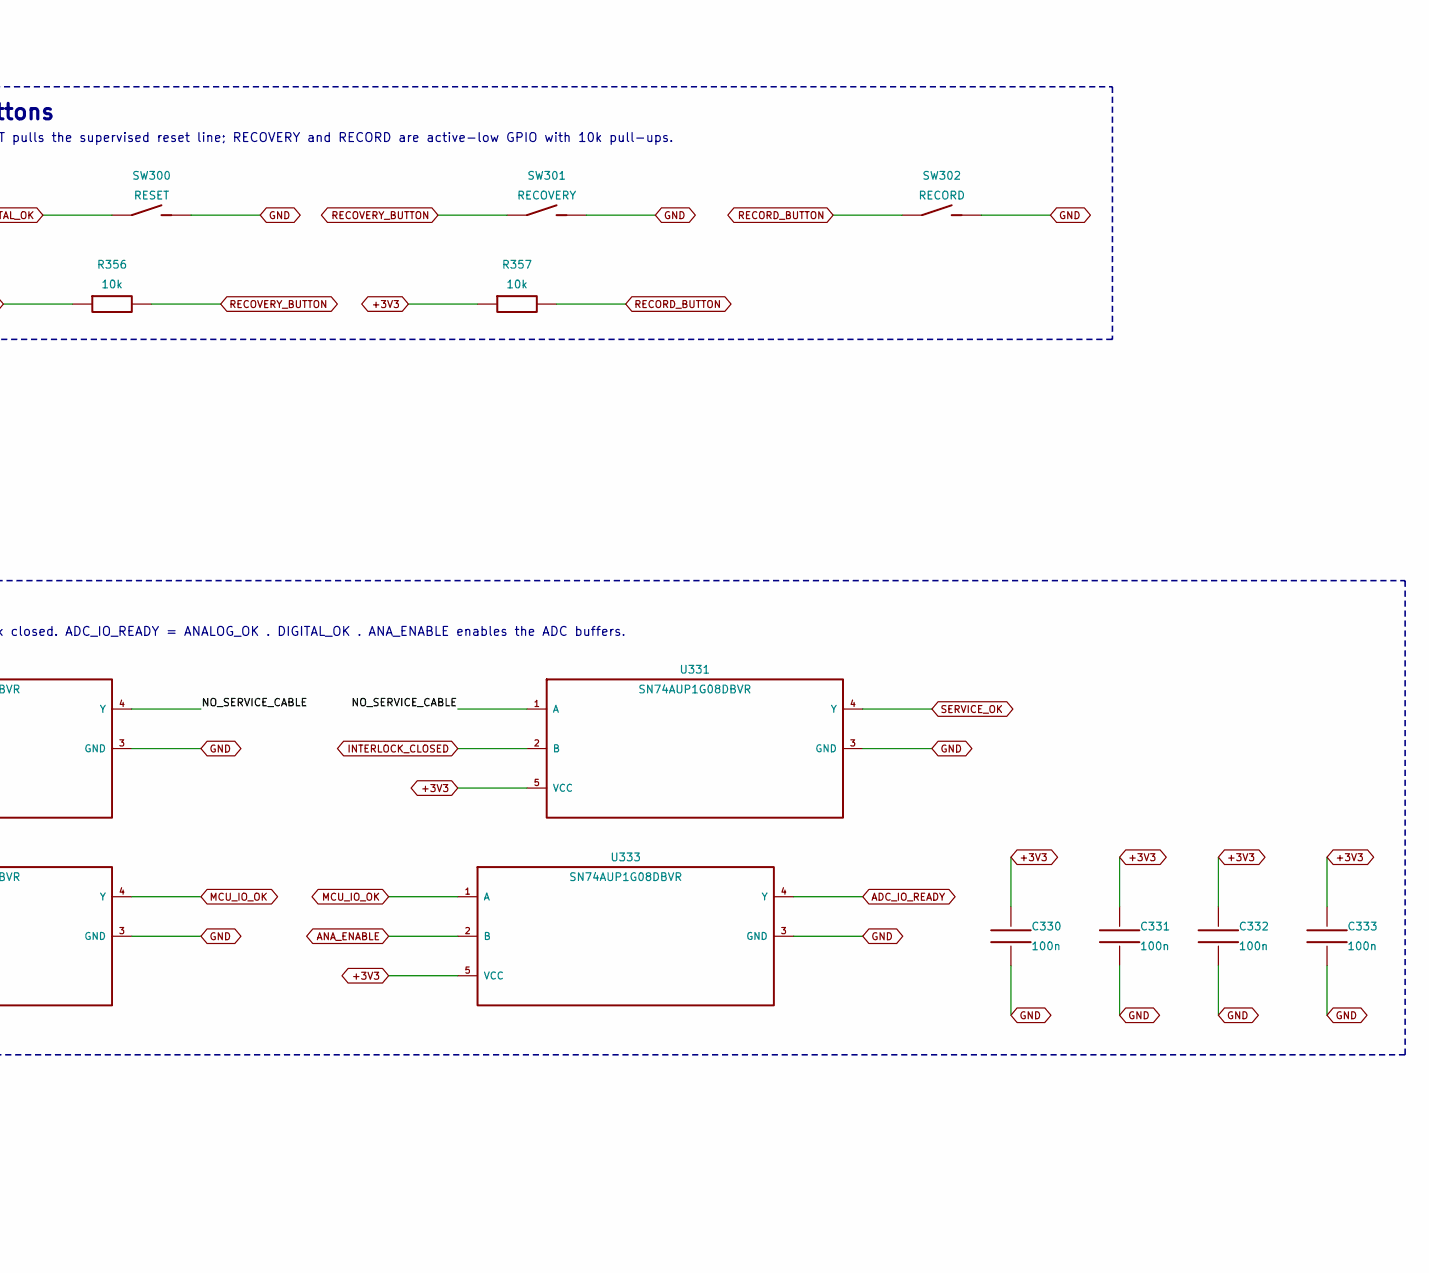
[picture p16: schematic debug_service.kicad_sch, SWD / buttons / hardware service inhibit, part in row 1, column 2]

Parts:
C330, C331, C332, C333: 100n; C_0603_1608Metric; MPN GCM188R71H104KA57D
J300: Cortex SWD 2x5 1.27mm; PinHeader_2x05_P1.27mm_Vertical_SMD; MPN 3220-10-0300-00
J301: INTERLOCK: closed only in recording position; JST_PH_S2B-PH-K_1x02_P2.00mm_Horizontal; MPN S2B-PH-K-S
R350, R351, R352, R353: 100R; R_0603_1608Metric; MPN ERJ-3EKF1000V
R354, R358: 4.7k; R_0603_1608Metric; MPN ERJ-3EKF4701V
R356, R357: 10k; R_0603_1608Metric; MPN ERJ-3EKF1002V
SW300: RESET; SW_SPST_TL3342; MPN TL3342F160QG
SW301: RECOVERY; SW_SPST_TL3342; MPN TL3342F160QG
SW302: RECORD; SW_SPST_TL3342; MPN TL3342F160QG
U330, U331, U332, U333: SN74AUP1G08DBVR; SOT-23-5; MPN SN74AUP1G08DBVR

Connections:
+3V3: C330.1, C331.1, C332.1, C333.1, J300.1, J301.1, R354.1, R356.1, R357.1, U330.5 (VCC), U331.5 (VCC), U332.5 (VCC), U333.5 (VCC); also elsewhere on the board
/SWD / buttons / hardware service inhibit/NO_SERVICE_CABLE: U330.4 (Y), U331.1 (A)
/SWD / buttons / hardware service inhibit/RESET_HDR: J300.10, R353.1
/SWD / buttons / hardware service inhibit/SWCLK_HDR: J300.4, R351.1
/SWD / buttons / hardware service inhibit/SWDIO_HDR: J300.2, R350.1
/SWD / buttons / hardware service inhibit/SWO_HDR: J300.6, R352.2
ADC_IO_READY: U333.4 (Y); also elsewhere on the board
ANALOG_OK: U332.1 (A); also elsewhere on the board
ANA_ENABLE: U333.2 (B); also elsewhere on the board
DIGITAL_OK: R353.2, SW300.1, U332.2 (B); also elsewhere on the board
GND: C330.2, C331.2, C332.2, C333.2, J300.3, J300.5, R358.2, SW300.2, SW301.2, SW302.2, U330.3 (GND), U331.3 (GND), U332.3 (GND), U333.3 (GND); also elsewhere on the board
INTERLOCK_CLOSED: J301.2, R358.1, U331.2 (B); also elsewhere on the board
MCU_IO_OK: U332.4 (Y), U333.1 (A)
RECORD_BUTTON: R357.2, SW302.1; also elsewhere on the board
RECOVERY_BUTTON: R356.2, SW301.1; also elsewhere on the board
SERVICE_OK: U331.4 (Y); also elsewhere on the board
SWCLK_MCU: R351.2; also elsewhere on the board
SWDIO_MCU: R350.2; also elsewhere on the board
SWD_ABSENT: J300.9, R354.2, U330.2 (B)
SWO_MCU: R352.1; also elsewhere on the board
USB_ABSENT: U330.1 (A); also elsewhere on the board

Notes on the sheet:
SWD PROGRAMMING AND USB SERVICE: DISCONNECT ALL ELECTRODES
SWD programming header
Cortex 10-pin; 100R series on each line. Pin 9 grounded by a compatible adapter gives SWD_ABSENT low. No target power.
Buttons
RESET pulls the supervised reset line; RECOVERY and RECORD are active-low GPIO with 10k pull-ups.
Service interlock
Closed only in the recording position; open blocks acquisition through SERVICE_OK. Mechanical
interlock not yet designed.
Service and ADC I/O gating
SERVICE_OK = USB absent . SWD absent . interlock closed. ADC_IO_READY = ANALOG_OK . DIGITAL_OK . ANA_ENABLE enables the ADC buffers.
Sheet notes
A mechanical interlock is still required: an unpowered USB cable can join grounds without VBUS detection.
J300 pin 9 detection works only with adapters that ground it. SWD has no target-power input; 3V3 is a voltage reference only. No USB bootloader is assumed.
