MariusFauteux/EEG-PCB/hardware/EEG_RevC.kicad_pcb

## KiCad design hardware/EEG_RevC.kicad_pcb (continued)

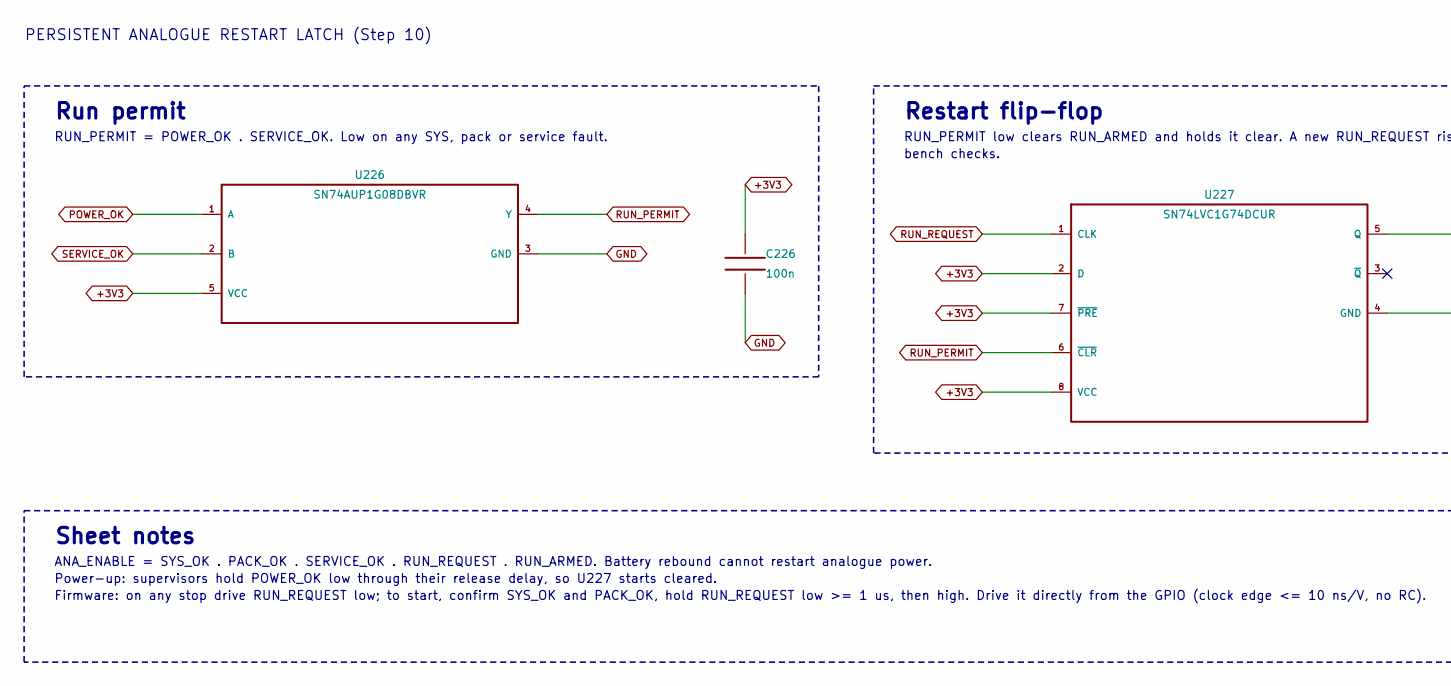
[picture p17: schematic restart_latch.kicad_sch, Persistent analogue restart latch (Step 10), part in row 1, column 1]

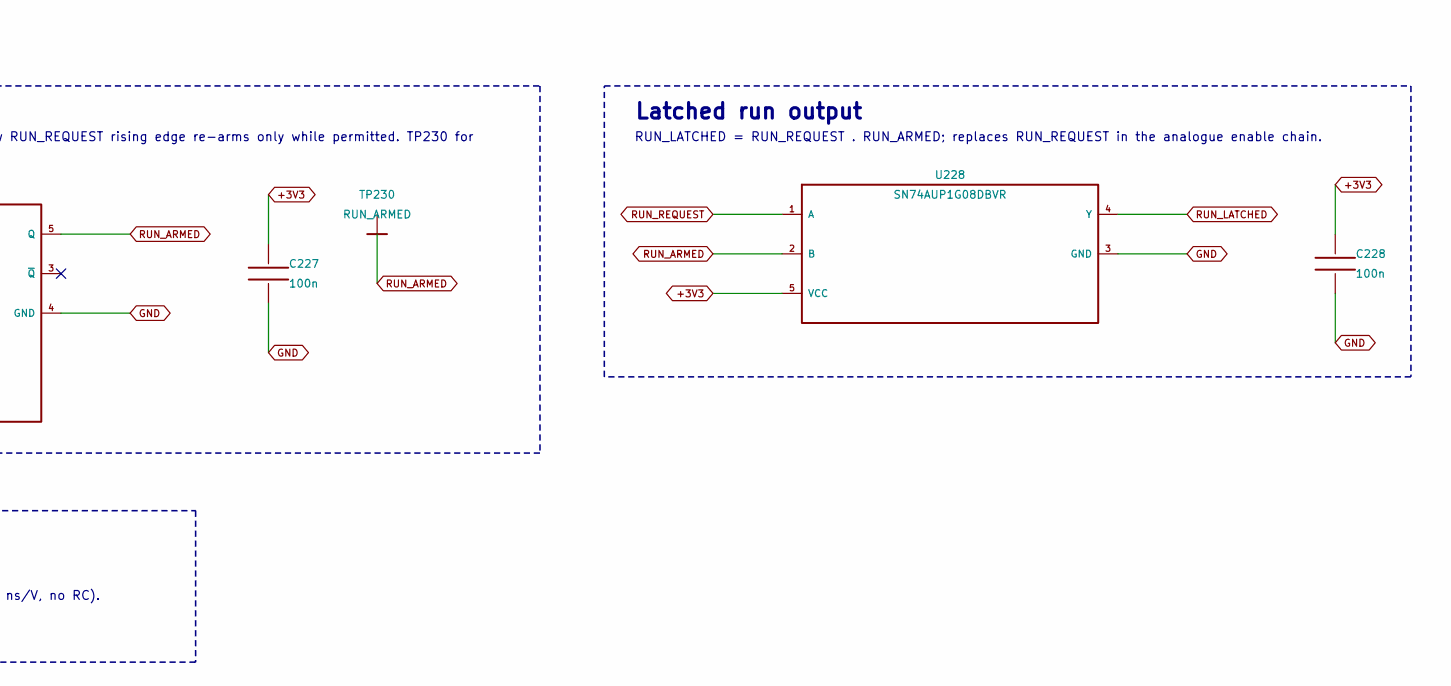
[picture p18: schematic restart_latch.kicad_sch, Persistent analogue restart latch (Step 10), part in row 1, column 2]

Parts:
C226, C227, C228: 100n; C_0603_1608Metric; MPN GCM188R71H104KA57D
TP230: RUN_ARMED; TestPoint_Pad_D1.0mm
U226, U228: SN74AUP1G08DBVR; SOT-23-5; MPN SN74AUP1G08DBVR
U227: SN74LVC1G74DCUR; VSSOP-8_2.3x2mm_P0.5mm; MPN SN74LVC1G74DCUR

Connections:
+3V3: C226.1, C227.1, C228.1, U226.5 (VCC), U227.2 (D), U227.7 (~PRE), U227.8 (VCC), U228.5 (VCC); also elsewhere on the board
GND: C226.2, C227.2, C228.2, U226.3 (GND), U227.4 (GND), U228.3 (GND); also elsewhere on the board
POWER_OK: U226.1 (A); also elsewhere on the board
RUN_ARMED: TP230.1, U227.5 (Q), U228.2 (B)
RUN_LATCHED: U228.4 (Y); also elsewhere on the board
RUN_PERMIT: U226.4 (Y), U227.6 (~CLR)
RUN_REQUEST: U227.1 (CLK), U228.1 (A); also elsewhere on the board
SERVICE_OK: U226.2 (B); also elsewhere on the board

Notes on the sheet:
PERSISTENT ANALOGUE RESTART LATCH (Step 10)
Run permit
RUN_PERMIT = POWER_OK . SERVICE_OK. Low on any SYS, pack or service fault.
Restart flip-flop
RUN_PERMIT low clears RUN_ARMED and holds it clear. A new RUN_REQUEST rising edge re-arms only while permitted. TP230 for
bench checks.
Latched run output
RUN_LATCHED = RUN_REQUEST . RUN_ARMED; replaces RUN_REQUEST in the analogue enable chain.
Sheet notes
ANA_ENABLE = SYS_OK . PACK_OK . SERVICE_OK . RUN_REQUEST . RUN_ARMED. Battery rebound cannot restart analogue power.
Power-up: supervisors hold POWER_OK low through their release delay, so U227 starts cleared.
Firmware: on any stop drive RUN_REQUEST low; to start, confirm SYS_OK and PACK_OK, hold RUN_REQUEST low >= 1 us, then high. Drive it directly from the GPIO (clock edge <= 10 ns/V, no RC).

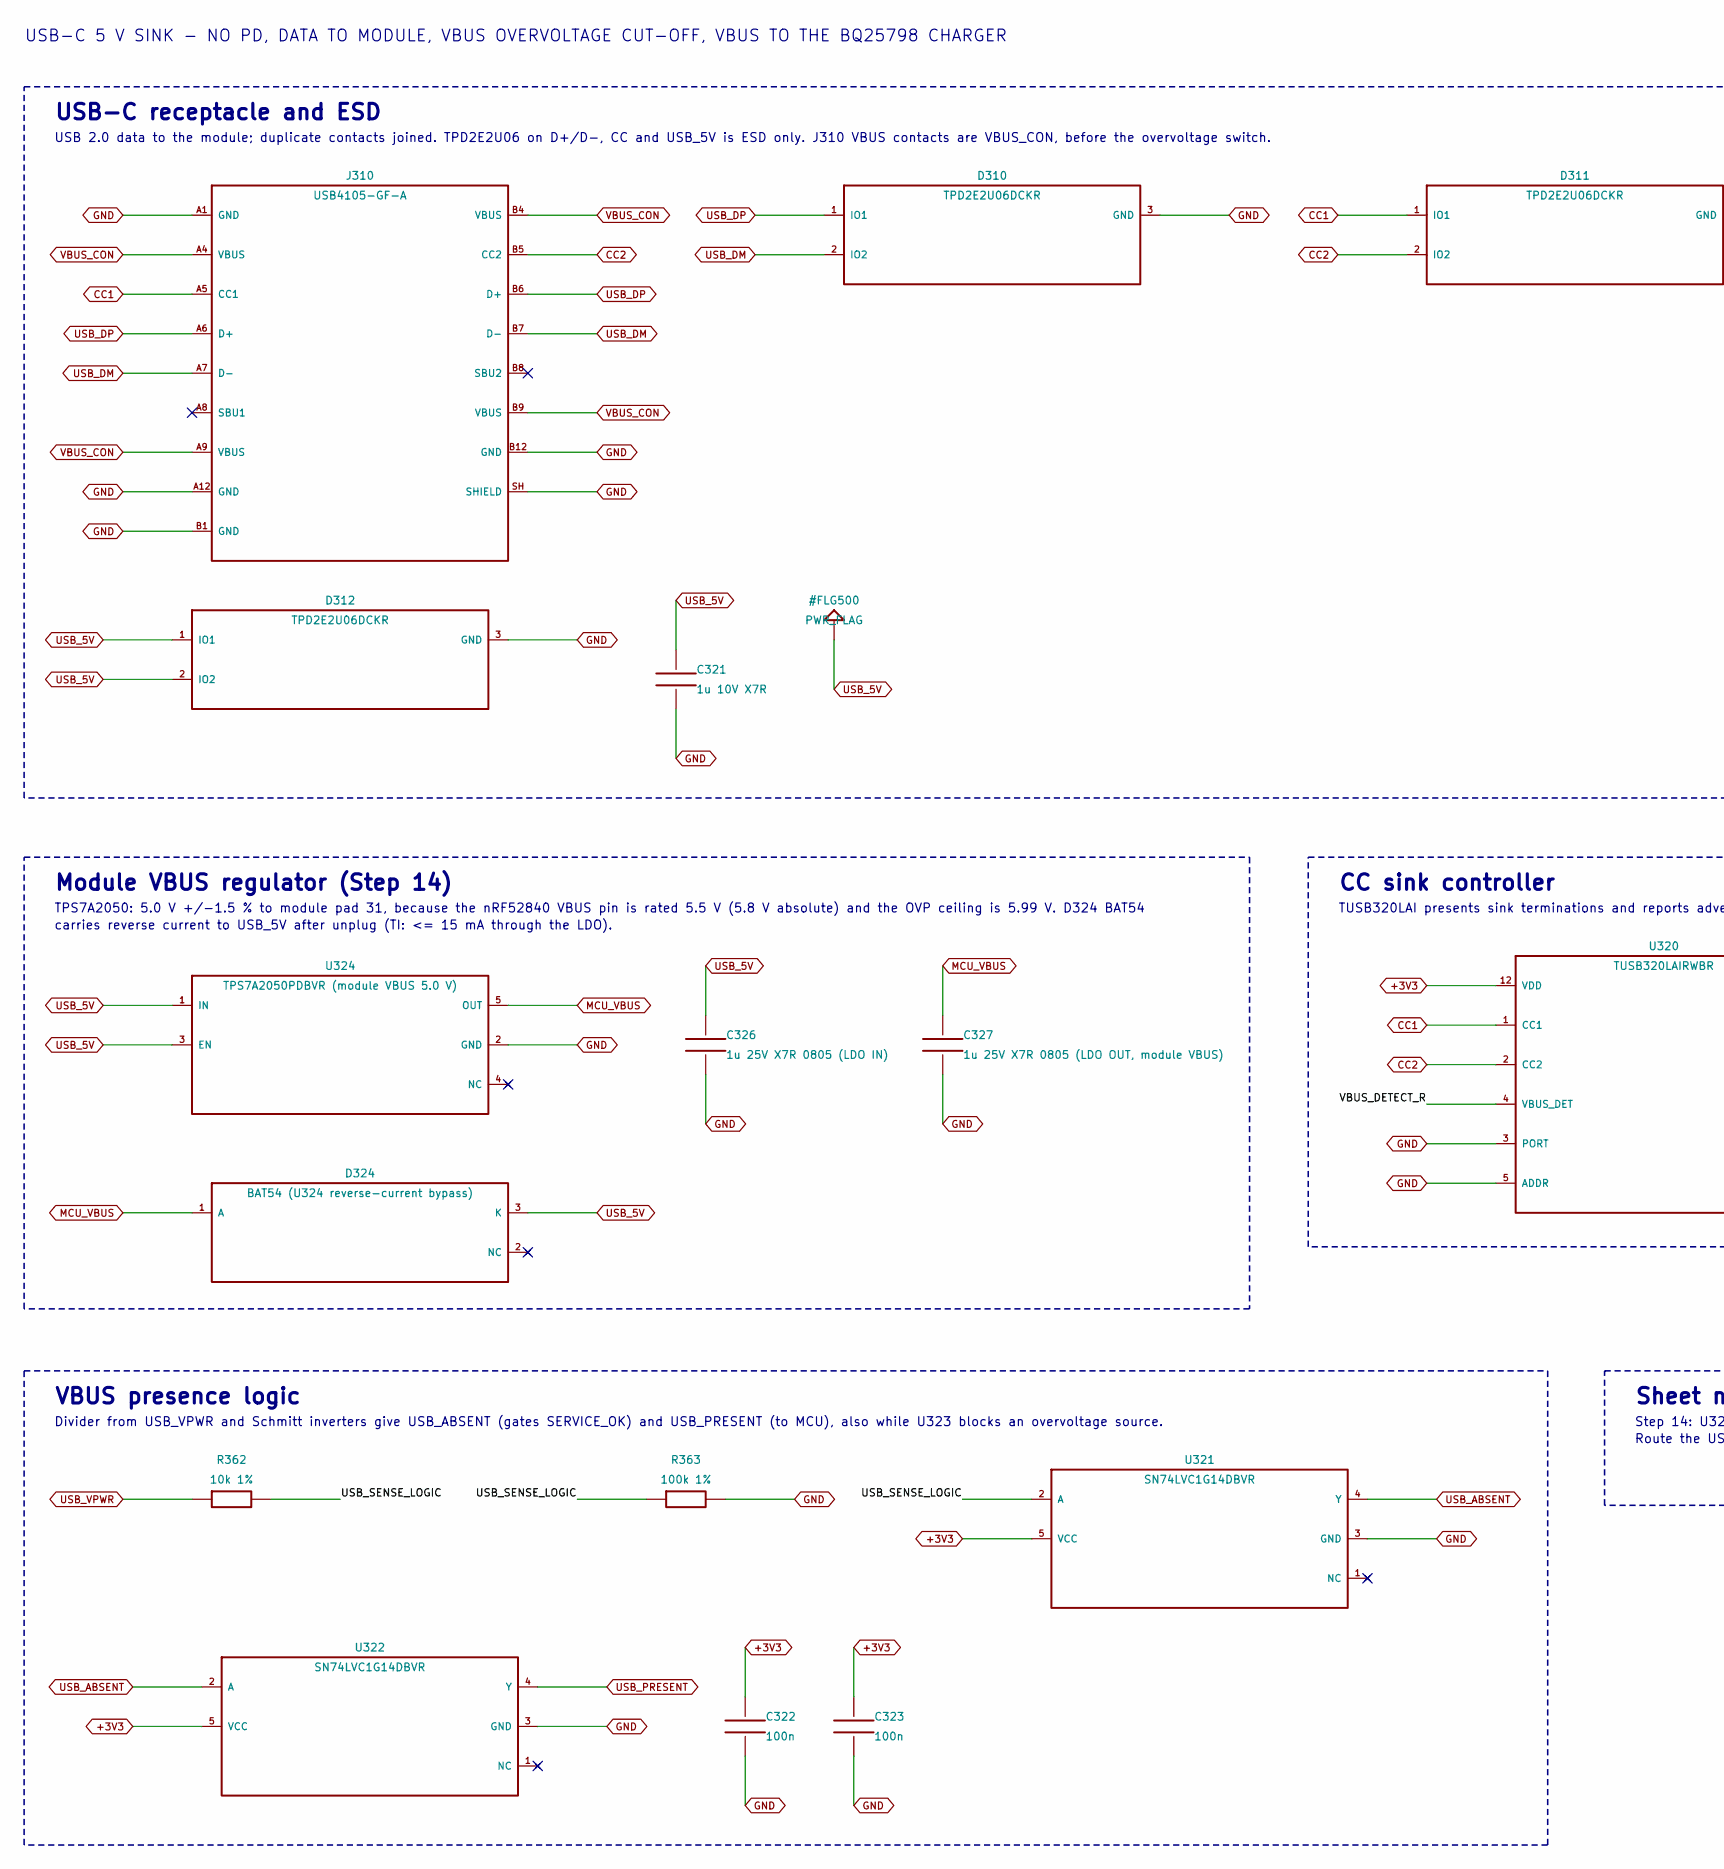
[picture p19: schematic usb_c.kicad_sch, USB-C device connector / ESD / CC current detection, part in row 1, column 1]

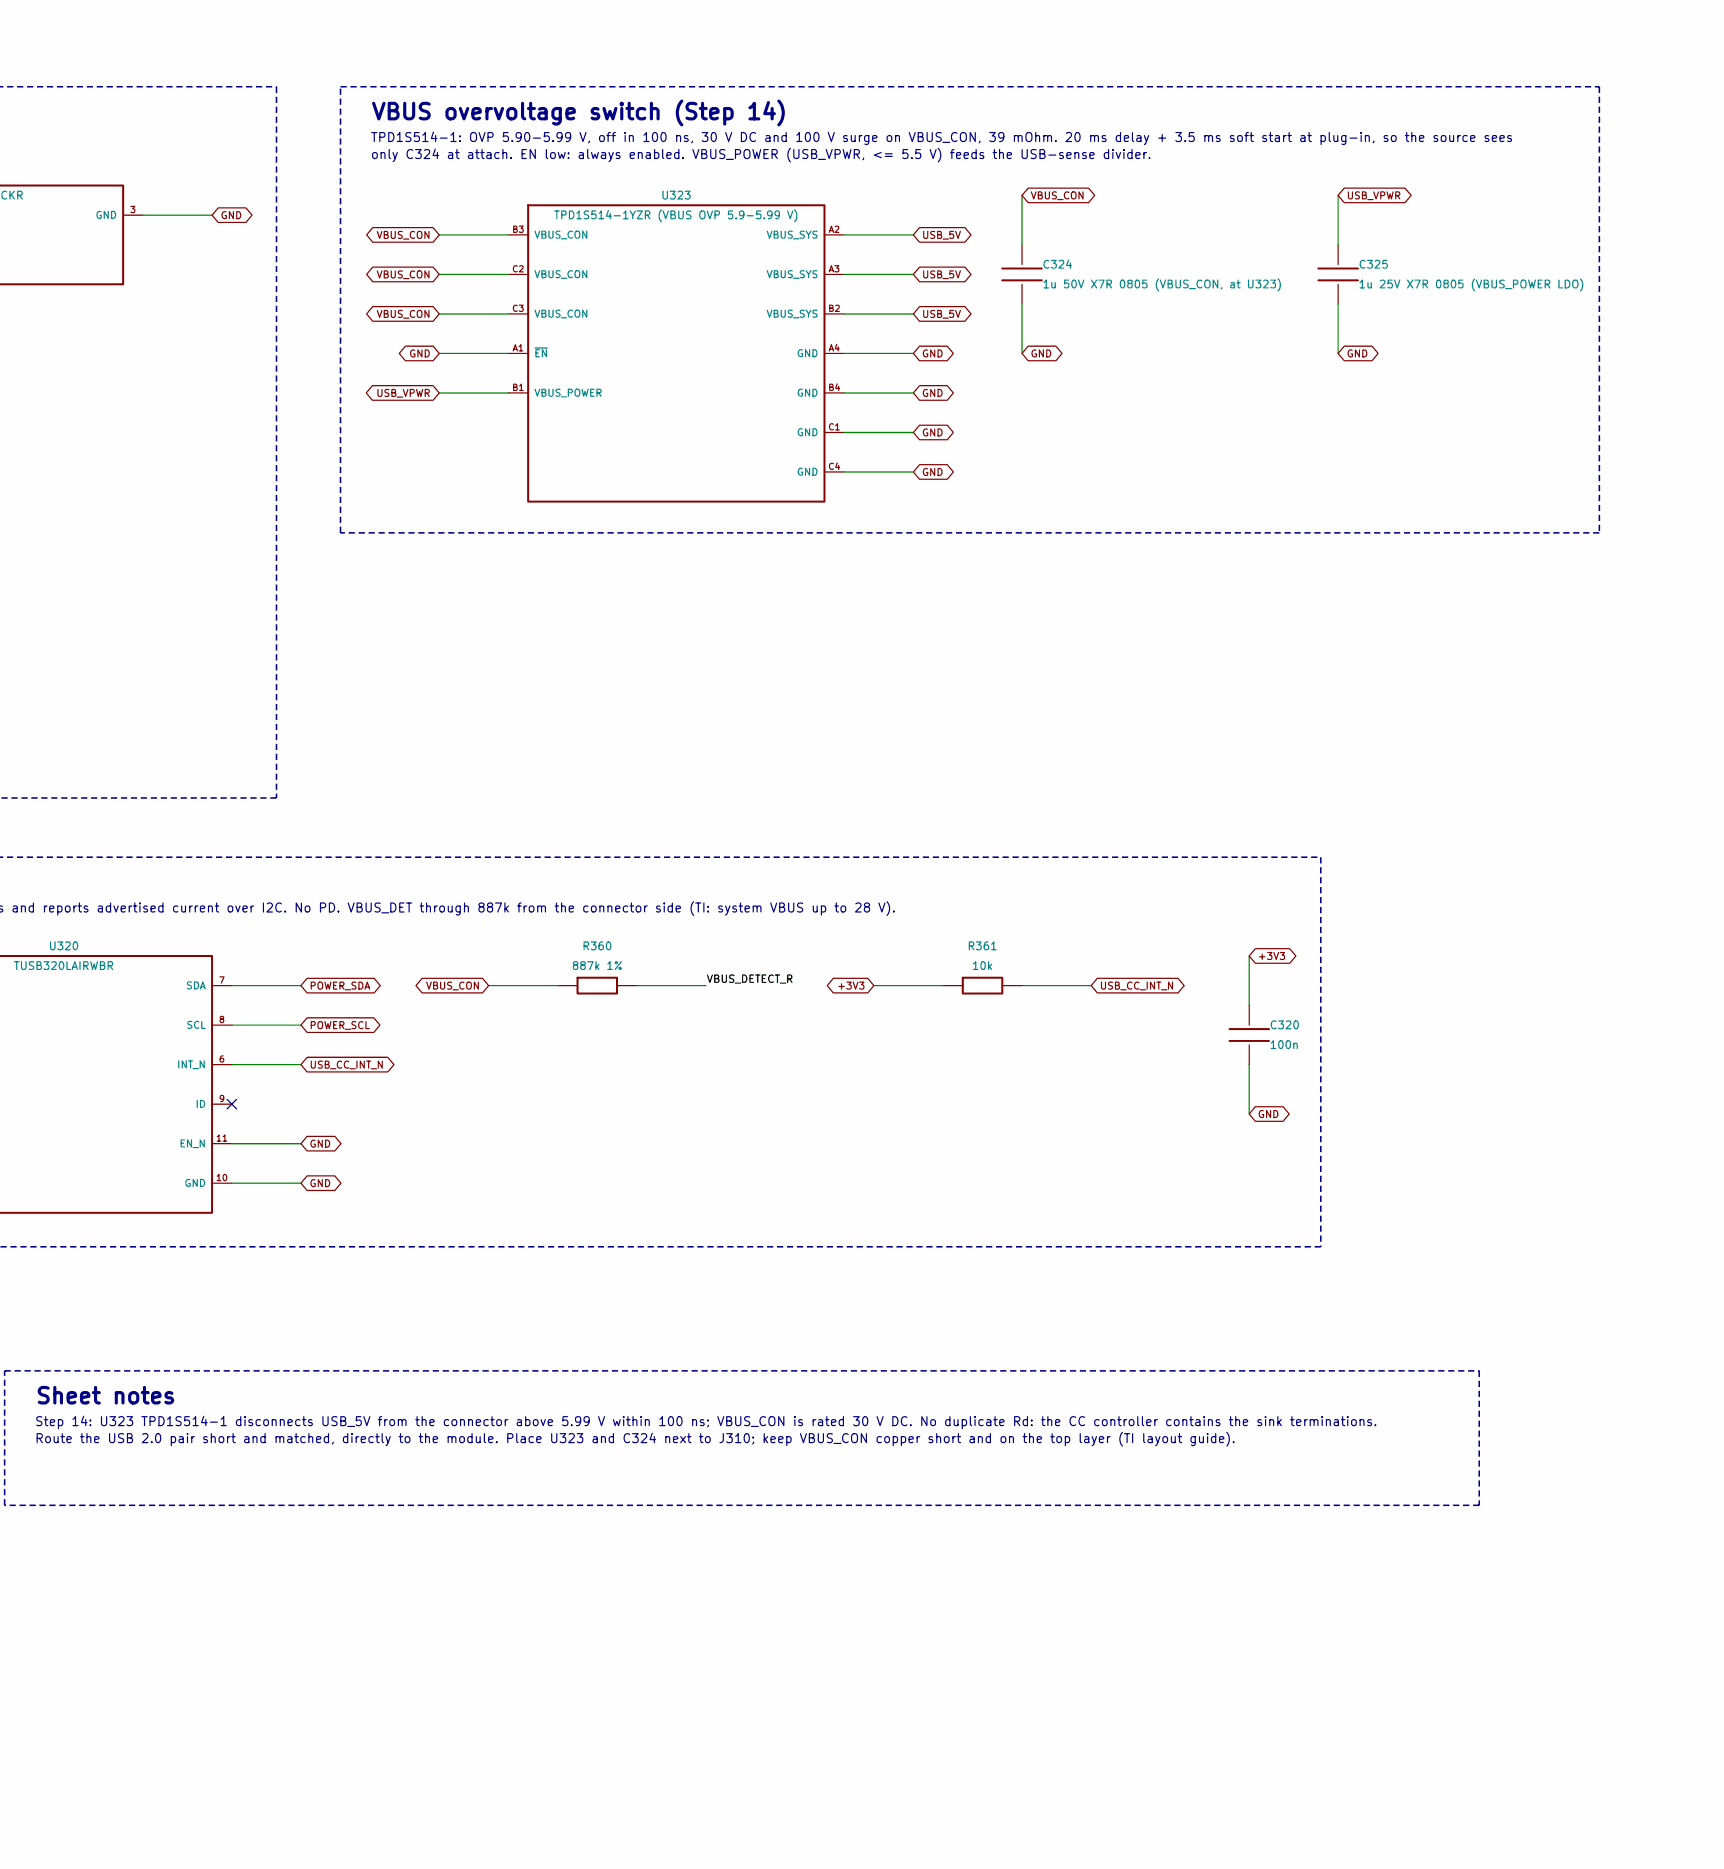
[picture p20: schematic usb_c.kicad_sch, USB-C device connector / ESD / CC current detection, part in row 1, column 2]

Parts:
C320, C322, C323: 100n; C_0603_1608Metric; MPN GCM188R71H104KA57D
C321: 1u 10V X7R; C_0805_2012Metric; MPN GCM21BR71E105KA56L
C324: 1u 50V X7R 0805 (VBUS_CON, at U323); C_0805_2012Metric; MPN GCM21BR71H105KA03L
C325: 1u 25V X7R 0805 (VBUS_POWER LDO); C_0805_2012Metric; MPN GCM21BR71E105KA56L
C326: 1u 25V X7R 0805 (LDO IN); C_0805_2012Metric; MPN GCM21BR71E105KA56L
C327: 1u 25V X7R 0805 (LDO OUT, module VBUS); C_0805_2012Metric; MPN GCM21BR71E105KA56L
D310, D311, D312: TPD2E2U06DCKR; SOT-323_SC-70; MPN TPD2E2U06DCKR
D324: BAT54 (U324 reverse-current bypass); SOT-23; MPN BAT54,215
J310: USB4105-GF-A; USB_C_Receptacle_GCT_USB4105-xx-A_16P_TopMnt_Horizontal; MPN USB4105-GF-A
R360: 887k 1%; R_0603_1608Metric; MPN ERJ-3EKF8873V
R361: 10k; R_0603_1608Metric; MPN ERJ-3EKF1002V
R362: 10k 1%; R_0603_1608Metric; MPN ERJ-3EKF1002V
R363: 100k 1%; R_0603_1608Metric; MPN ERJ-3EKF1003V
U320: TUSB320LAIRWBR; Texas_RWB0012A_X2QFN-12_1.6x1.6mm_P0.4mm; MPN TUSB320LAIRWBR
U321, U322: SN74LVC1G14DBVR; SOT-23-5; MPN SN74LVC1G14DBVR
U323: TPD1S514-1YZR (VBUS OVP 5.9-5.99 V); Texas_YZ0012_DSBGA-12_P0.4mm; MPN TPD1S514-1YZR
U324: TPS7A2050PDBVR (module VBUS 5.0 V); SOT-23-5; MPN TPS7A2050PDBVR

Connections:
+3V3: C320.1, C322.1, C323.1, R361.1, U320.12 (VDD), U321.5 (VCC), U322.5 (VCC); also elsewhere on the board
/USB-C device connector / ESD / CC current detection/USB_SENSE_LOGIC: R362.2, R363.1, U321.2 (A)
/USB-C device connector / ESD / CC current detection/VBUS_DETECT_R: R360.2, U320.4 (VBUS_DET)
CC1: D311.1 (IO1), J310.A5 (CC1), U320.1 (CC1)
CC2: D311.2 (IO2), J310.B5 (CC2), U320.2 (CC2)
GND: C320.2, C321.2, C322.2, C323.2, C324.2, C325.2, C326.2, C327.2, D310.3 (GND), D311.3 (GND), D312.3 (GND), J310.A1 (GND), J310.A12 (GND), J310.B1 (GND), J310.B12 (GND), J310.SH (SHIELD), R363.2, U320.3 (PORT), U320.5 (ADDR), U320.10 (GND), U320.11 (EN_N), U321.3 (GND), U322.3 (GND), U323.A1 (~EN), U323.A4 (GND), U323.B4 (GND), U323.C1 (GND), U323.C4 (GND), U324.2 (GND); also elsewhere on the board
MCU_VBUS: C327.1, D324.1 (A), U324.5 (OUT); also elsewhere on the board
POWER_SCL: U320.8 (SCL); also elsewhere on the board
POWER_SDA: U320.7 (SDA); also elsewhere on the board
USB_5V: C321.1, C326.1, D312.1 (IO1), D312.2 (IO2), D324.3 (K), U323.A2 (VBUS_SYS), U323.A3 (VBUS_SYS), U323.B2 (VBUS_SYS), U324.1 (IN), U324.3 (EN); also elsewhere on the board
USB_ABSENT: U321.4 (Y), U322.2 (A); also elsewhere on the board
USB_CC_INT_N: R361.2, U320.6 (INT_N); also elsewhere on the board
USB_DM: D310.2 (IO2), J310.A7 (D-), J310.B7 (D-); also elsewhere on the board
USB_DP: D310.1 (IO1), J310.A6 (D+), J310.B6 (D+); also elsewhere on the board
USB_PRESENT: U322.4 (Y); also elsewhere on the board
USB_VPWR: C325.1, R362.1, U323.B1 (VBUS_POWER)
VBUS_CON: C324.1, J310.A4 (VBUS), J310.A9 (VBUS), J310.B4 (VBUS), J310.B9 (VBUS), R360.1, U323.B3 (VBUS_CON), U323.C2 (VBUS_CON), U323.C3 (VBUS_CON)

Notes on the sheet:
USB-C 5 V SINK - NO PD, DATA TO MODULE, VBUS OVERVOLTAGE CUT-OFF, VBUS TO THE BQ25798 CHARGER
USB-C receptacle and ESD
USB 2.0 data to the module; duplicate contacts joined. TPD2E2U06 on D+/D-, CC and USB_5V is ESD only. J310 VBUS contacts are VBUS_CON, before the overvoltage switch.
VBUS overvoltage switch (Step 14)
TPD1S514-1: OVP 5.90-5.99 V, off in 100 ns, 30 V DC and 100 V surge on VBUS_CON, 39 mOhm. 20 ms delay + 3.5 ms soft start at plug-in, so the source sees
only C324 at attach. EN low: always enabled. VBUS_POWER (USB_VPWR, <= 5.5 V) feeds the USB-sense divider.
Module VBUS regulator (Step 14)
TPS7A2050: 5.0 V +/-1.5 % to module pad 31, because the nRF52840 VBUS pin is rated 5.5 V (5.8 V absolute) and the OVP ceiling is 5.99 V. D324 BAT54
carries reverse current to USB_5V after unplug (TI: <= 15 mA through the LDO).
CC sink controller
TUSB320LAI presents sink terminations and reports advertised current over I2C. No PD. VBUS_DET through 887k from the connector side (TI: system VBUS up to 28 V).
VBUS presence logic
Divider from USB_VPWR and Schmitt inverters give USB_ABSENT (gates SERVICE_OK) and USB_PRESENT (to MCU), also while U323 blocks an overvoltage source.
Sheet notes
Step 14: U323 TPD1S514-1 disconnects USB_5V from the connector above 5.99 V within 100 ns; VBUS_CON is rated 30 V DC. No duplicate Rd: the CC controller contains the sink terminations.
Route the USB 2.0 pair short and matched, directly to the module. Place U323 and C324 next to J310; keep VBUS_CON copper short and on the top layer (TI layout guide).

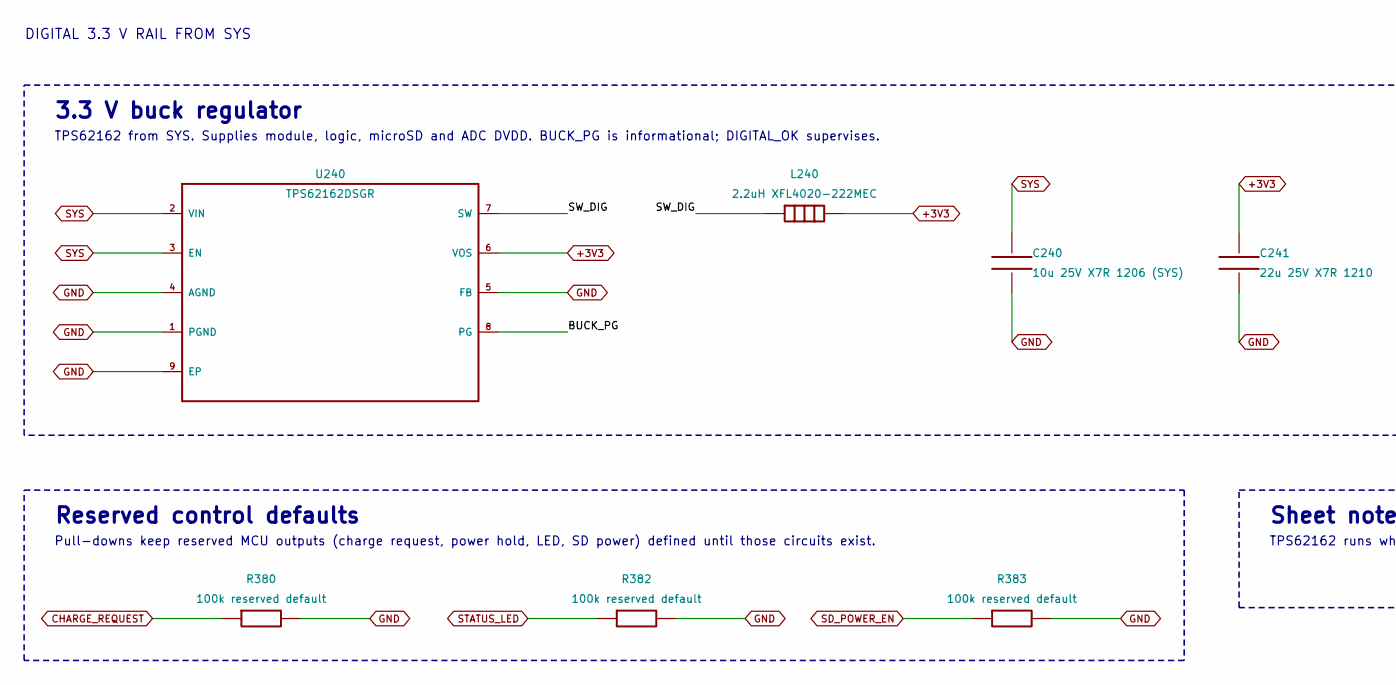
[picture p21: schematic digital_power.kicad_sch, Digital 3V3 rail, part in row 1, column 1]

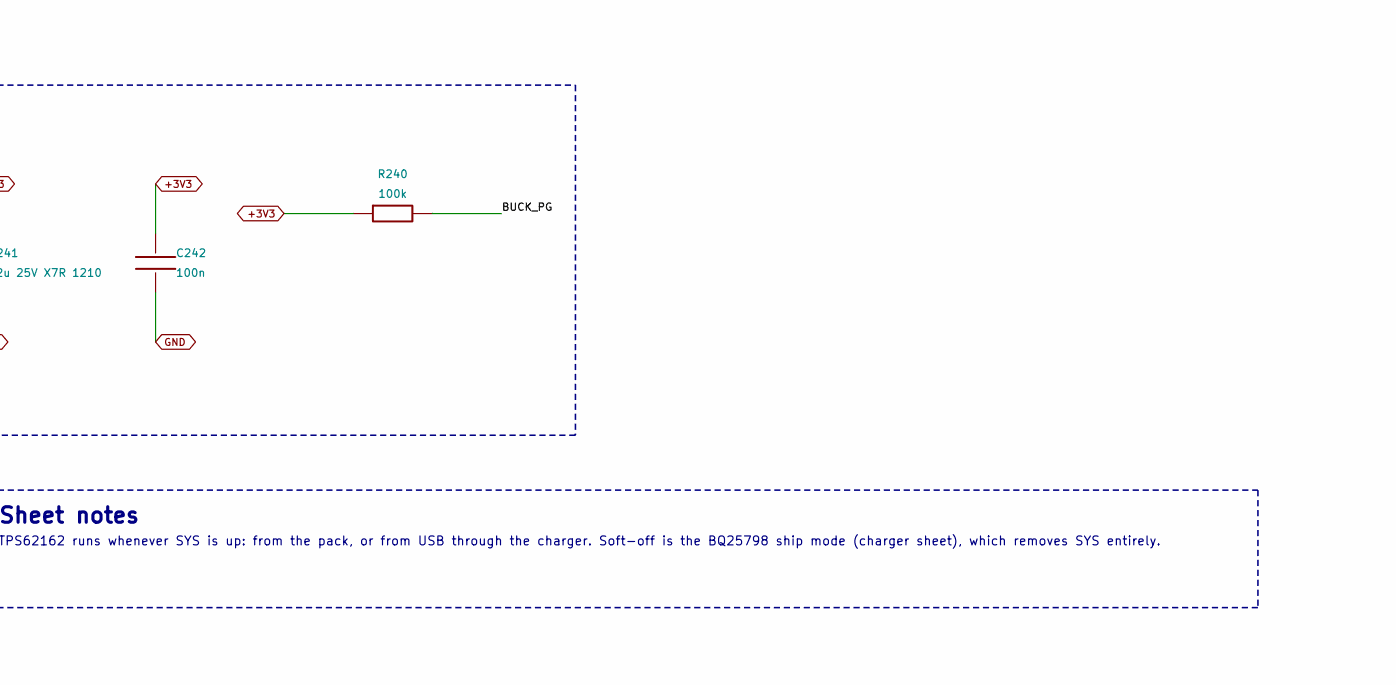
[picture p22: schematic digital_power.kicad_sch, Digital 3V3 rail, part in row 1, column 2]

Parts:
C240: 10u 25V X7R 1206 (SYS); C_1206_3216Metric; MPN GRM31CR71E106KA12L
C241: 22u 25V X7R 1210; C_1210_3225Metric; MPN GRM32ER71E226KE15L
C242: 100n; C_0603_1608Metric; MPN GCM188R71H104KA57D
L240: 2.2uH XFL4020-222MEC; L_Coilcraft_XxL4020; MPN XFL4020-222MEC
R240: 100k; R_0603_1608Metric; MPN ERJ-3EKF1003V
R380, R382, R383: 100k reserved default; R_0603_1608Metric; MPN ERJ-3EKF1003V
U240: TPS62162DSGR; Texas_DSG0008A_WSON-8-1EP_2x2mm_P0.5mm_EP0.9x1.6mm; MPN TPS62162DSGR

Connections:
+3V3: C241.1, C242.1, L240.2, R240.1, U240.6 (VOS); also elsewhere on the board
/Digital 3V3 rail/BUCK_PG: R240.2, U240.8 (PG)
/Digital 3V3 rail/SW_DIG: L240.1, U240.7 (SW)
CHARGE_REQUEST: R380.1; also elsewhere on the board
GND: C240.2, C241.2, C242.2, R380.2, R382.2, R383.2, U240.1 (PGND), U240.4 (AGND), U240.5 (FB), U240.9 (EP); also elsewhere on the board
SD_POWER_EN: R383.1; also elsewhere on the board
STATUS_LED: R382.1; also elsewhere on the board
SYS: C240.1, U240.2 (VIN), U240.3 (EN); also elsewhere on the board

Notes on the sheet:
DIGITAL 3.3 V RAIL FROM SYS
3.3 V buck regulator
TPS62162 from SYS. Supplies module, logic, microSD and ADC DVDD. BUCK_PG is informational; DIGITAL_OK supervises.
Reserved control defaults
Pull-downs keep reserved MCU outputs (charge request, power hold, LED, SD power) defined until those circuits exist.
Sheet notes
TPS62162 runs whenever SYS is up: from the pack, or from USB through the charger. Soft-off is the BQ25798 ship mode (charger sheet), which removes SYS entirely.

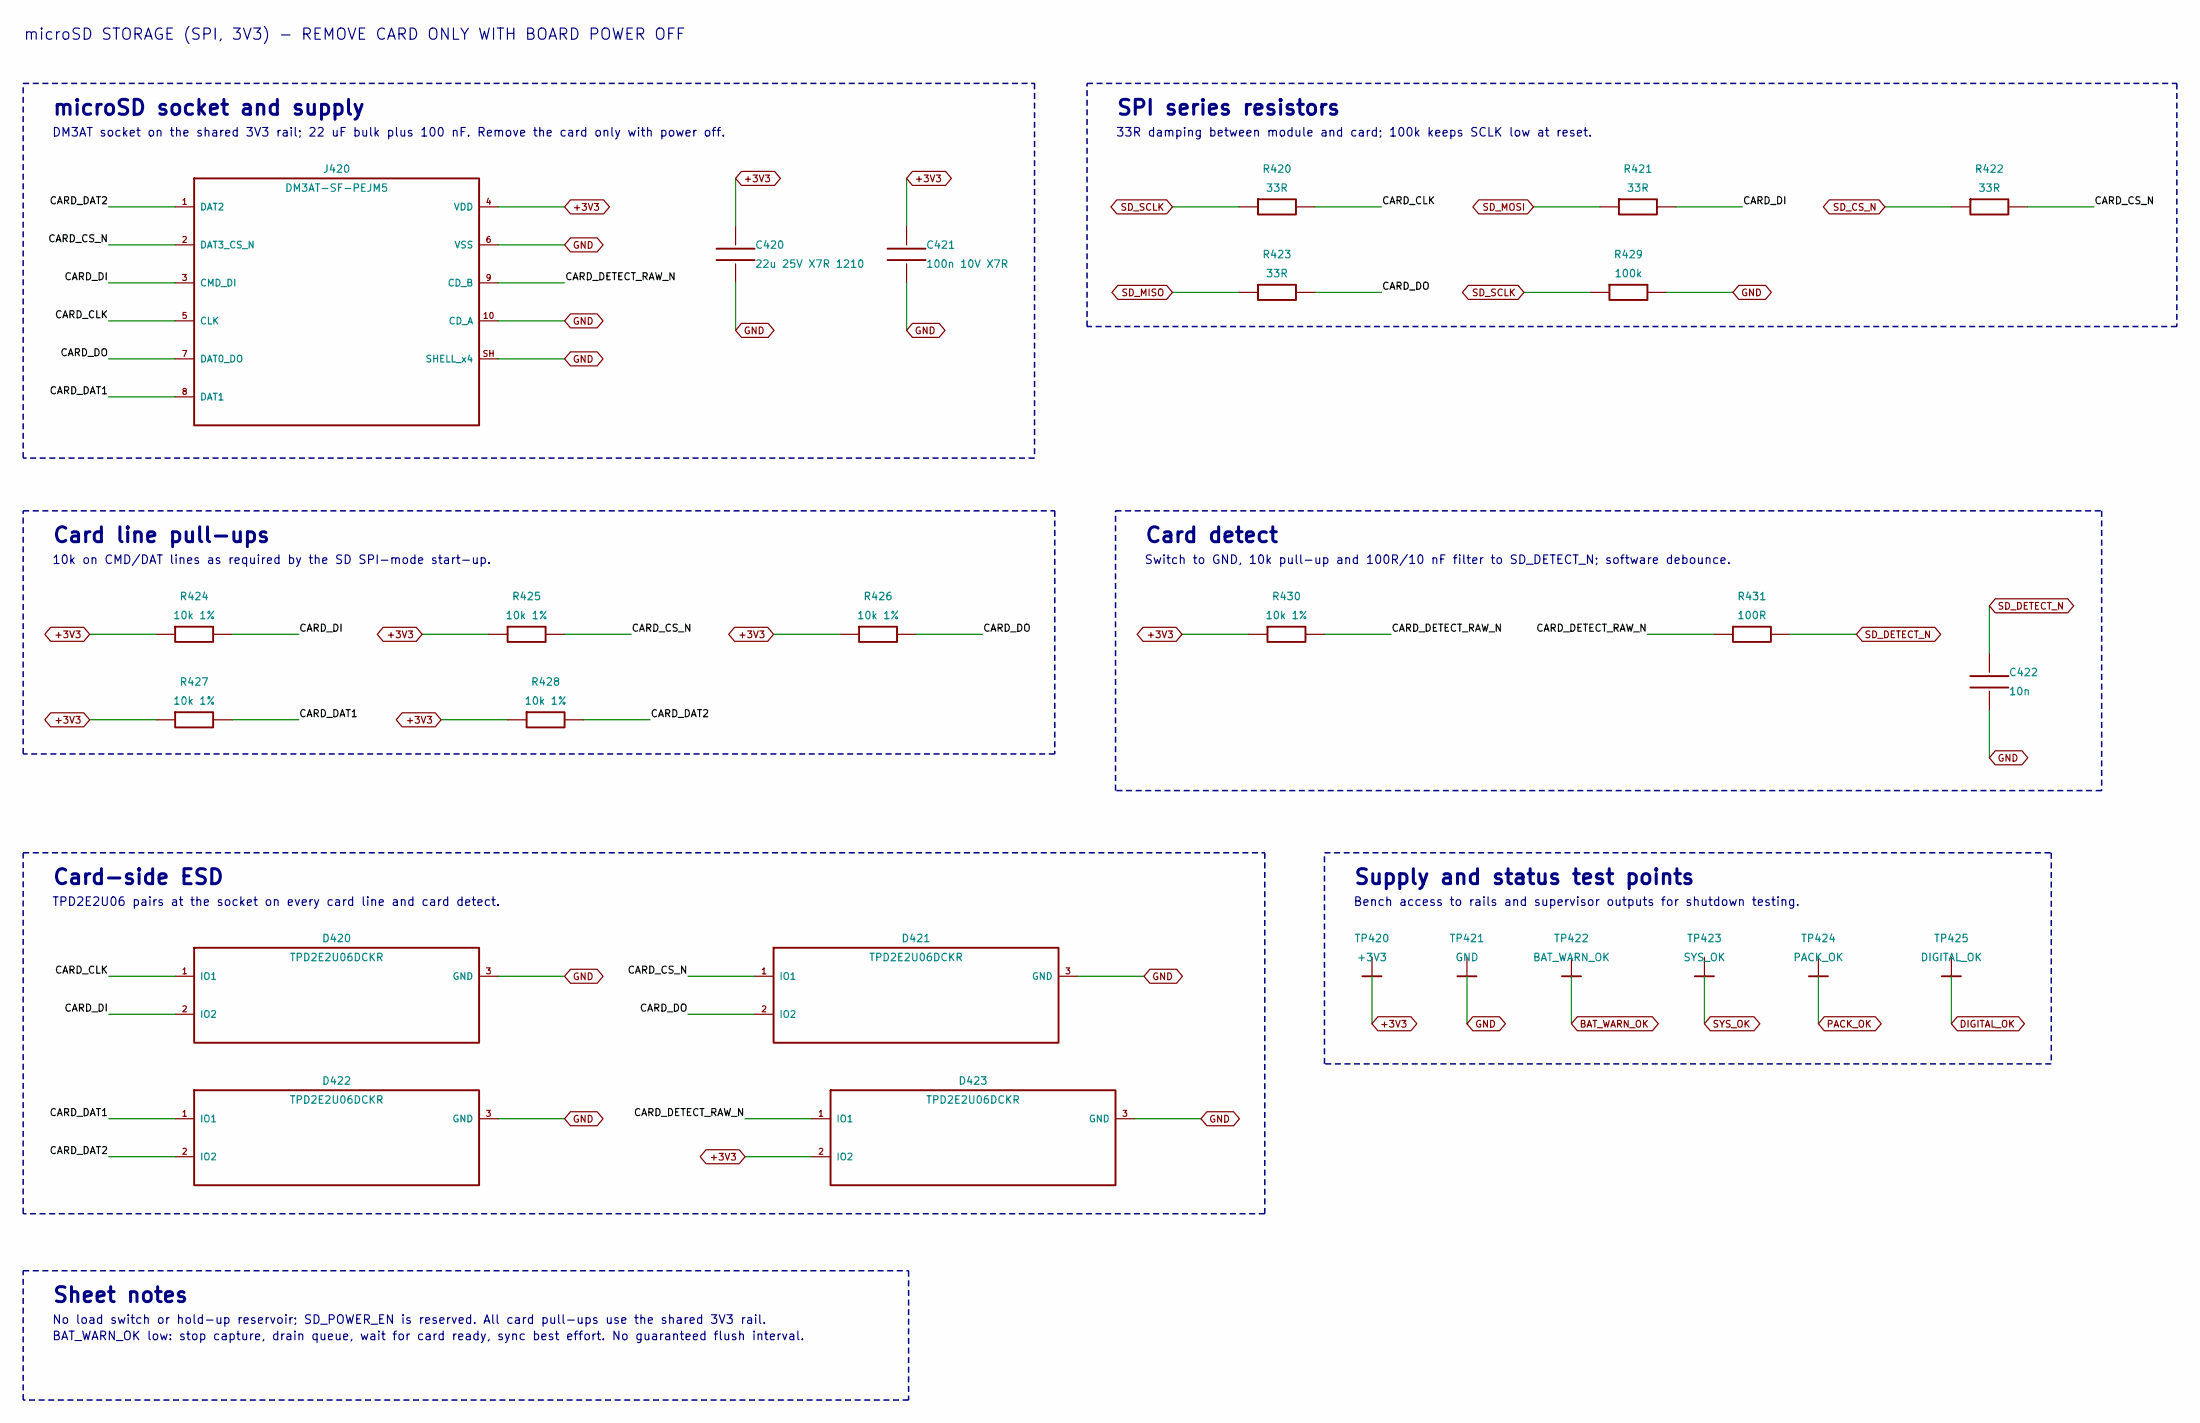
[picture p23: schematic storage.kicad_sch, microSD SPI and shutdown test access]

Parts:
C420: 22u 25V X7R 1210; C_1210_3225Metric; MPN GRM32ER71E226KE15L
C421: 100n 10V X7R; C_0603_1608Metric; MPN GCM188R71H104KA57D
C422: 10n; C_0603_1608Metric; MPN GCM1885C1H103JA16D
D420, D421, D422, D423: TPD2E2U06DCKR; SOT-323_SC-70; MPN TPD2E2U06DCKR
J420: DM3AT-SF-PEJM5; microSD_HC_Hirose_DM3AT-SF-PEJM5; MPN DM3AT-SF-PEJM5
R420, R421, R422, R423: 33R; R_0603_1608Metric; MPN ERJ-3EKF33R0V
R424, R425, R426, R427, R428, R430: 10k 1%; R_0603_1608Metric; MPN ERJ-3EKF1002V
R429: 100k; R_0603_1608Metric; MPN ERJ-3EKF1003V
R431: 100R; R_0603_1608Metric; MPN ERJ-3EKF1000V
TP420: +3V3; TestPoint_Pad_D1.0mm
TP421: GND; TestPoint_Pad_D1.0mm
TP422: BAT_WARN_OK; TestPoint_Pad_D1.0mm
TP423: SYS_OK; TestPoint_Pad_D1.0mm
TP424: PACK_OK; TestPoint_Pad_D1.0mm
TP425: DIGITAL_OK; TestPoint_Pad_D1.0mm

Connections:
+3V3: C420.1, C421.1, D423.2 (IO2), J420.4 (VDD), R424.1, R425.1, R426.1, R427.1, R428.1, R430.1, TP420.1; also elsewhere on the board
/microSD SPI and shutdown test access/CARD_CLK: D420.1 (IO1), J420.5 (CLK), R420.2
/microSD SPI and shutdown test access/CARD_CS_N: D421.1 (IO1), J420.2 (DAT3_CS_N), R422.2, R425.2
/microSD SPI and shutdown test access/CARD_DAT1: D422.1 (IO1), J420.8 (DAT1), R427.2
/microSD SPI and shutdown test access/CARD_DAT2: D422.2 (IO2), J420.1 (DAT2), R428.2
/microSD SPI and shutdown test access/CARD_DETECT_RAW_N: D423.1 (IO1), J420.9 (CD_B), R430.2, R431.1
/microSD SPI and shutdown test access/CARD_DI: D420.2 (IO2), J420.3 (CMD_DI), R421.2, R424.2
/microSD SPI and shutdown test access/CARD_DO: D421.2 (IO2), J420.7 (DAT0_DO), R423.2, R426.2
BAT_WARN_OK: TP422.1; also elsewhere on the board
DIGITAL_OK: TP425.1; also elsewhere on the board
GND: C420.2, C421.2, C422.2, D420.3 (GND), D421.3 (GND), D422.3 (GND), D423.3 (GND), J420.6 (VSS), J420.10 (CD_A), J420.SH (SHELL_x4), R429.2, TP421.1; also elsewhere on the board
PACK_OK: TP424.1; also elsewhere on the board
SD_CS_N: R422.1; also elsewhere on the board
SD_DETECT_N: C422.1, R431.2; also elsewhere on the board
SD_MISO: R423.1; also elsewhere on the board
SD_MOSI: R421.1; also elsewhere on the board
SD_SCLK: R420.1, R429.1; also elsewhere on the board
SYS_OK: TP423.1; also elsewhere on the board

Notes on the sheet:
microSD STORAGE (SPI, 3V3) - REMOVE CARD ONLY WITH BOARD POWER OFF
microSD socket and supply
DM3AT socket on the shared 3V3 rail; 22 uF bulk plus 100 nF. Remove the card only with power off.
SPI series resistors
33R damping between module and card; 100k keeps SCLK low at reset.
Card line pull-ups
10k on CMD/DAT lines as required by the SD SPI-mode start-up.
Card detect
Switch to GND, 10k pull-up and 100R/10 nF filter to SD_DETECT_N; software debounce.
Card-side ESD
TPD2E2U06 pairs at the socket on every card line and card detect.
Supply and status test points
Bench access to rails and supervisor outputs for shutdown testing.
Sheet notes
No load switch or hold-up reservoir; SD_POWER_EN is reserved. All card pull-ups use the shared 3V3 rail.
BAT_WARN_OK low: stop capture, drain queue, wait for card ready, sync best effort. No guaranteed flush interval.
