MariusFauteux/EEG-PCB/hardware/EEG_RevC.kicad_pcb

## KiCad design hardware/EEG_RevC.kicad_pcb (continued)

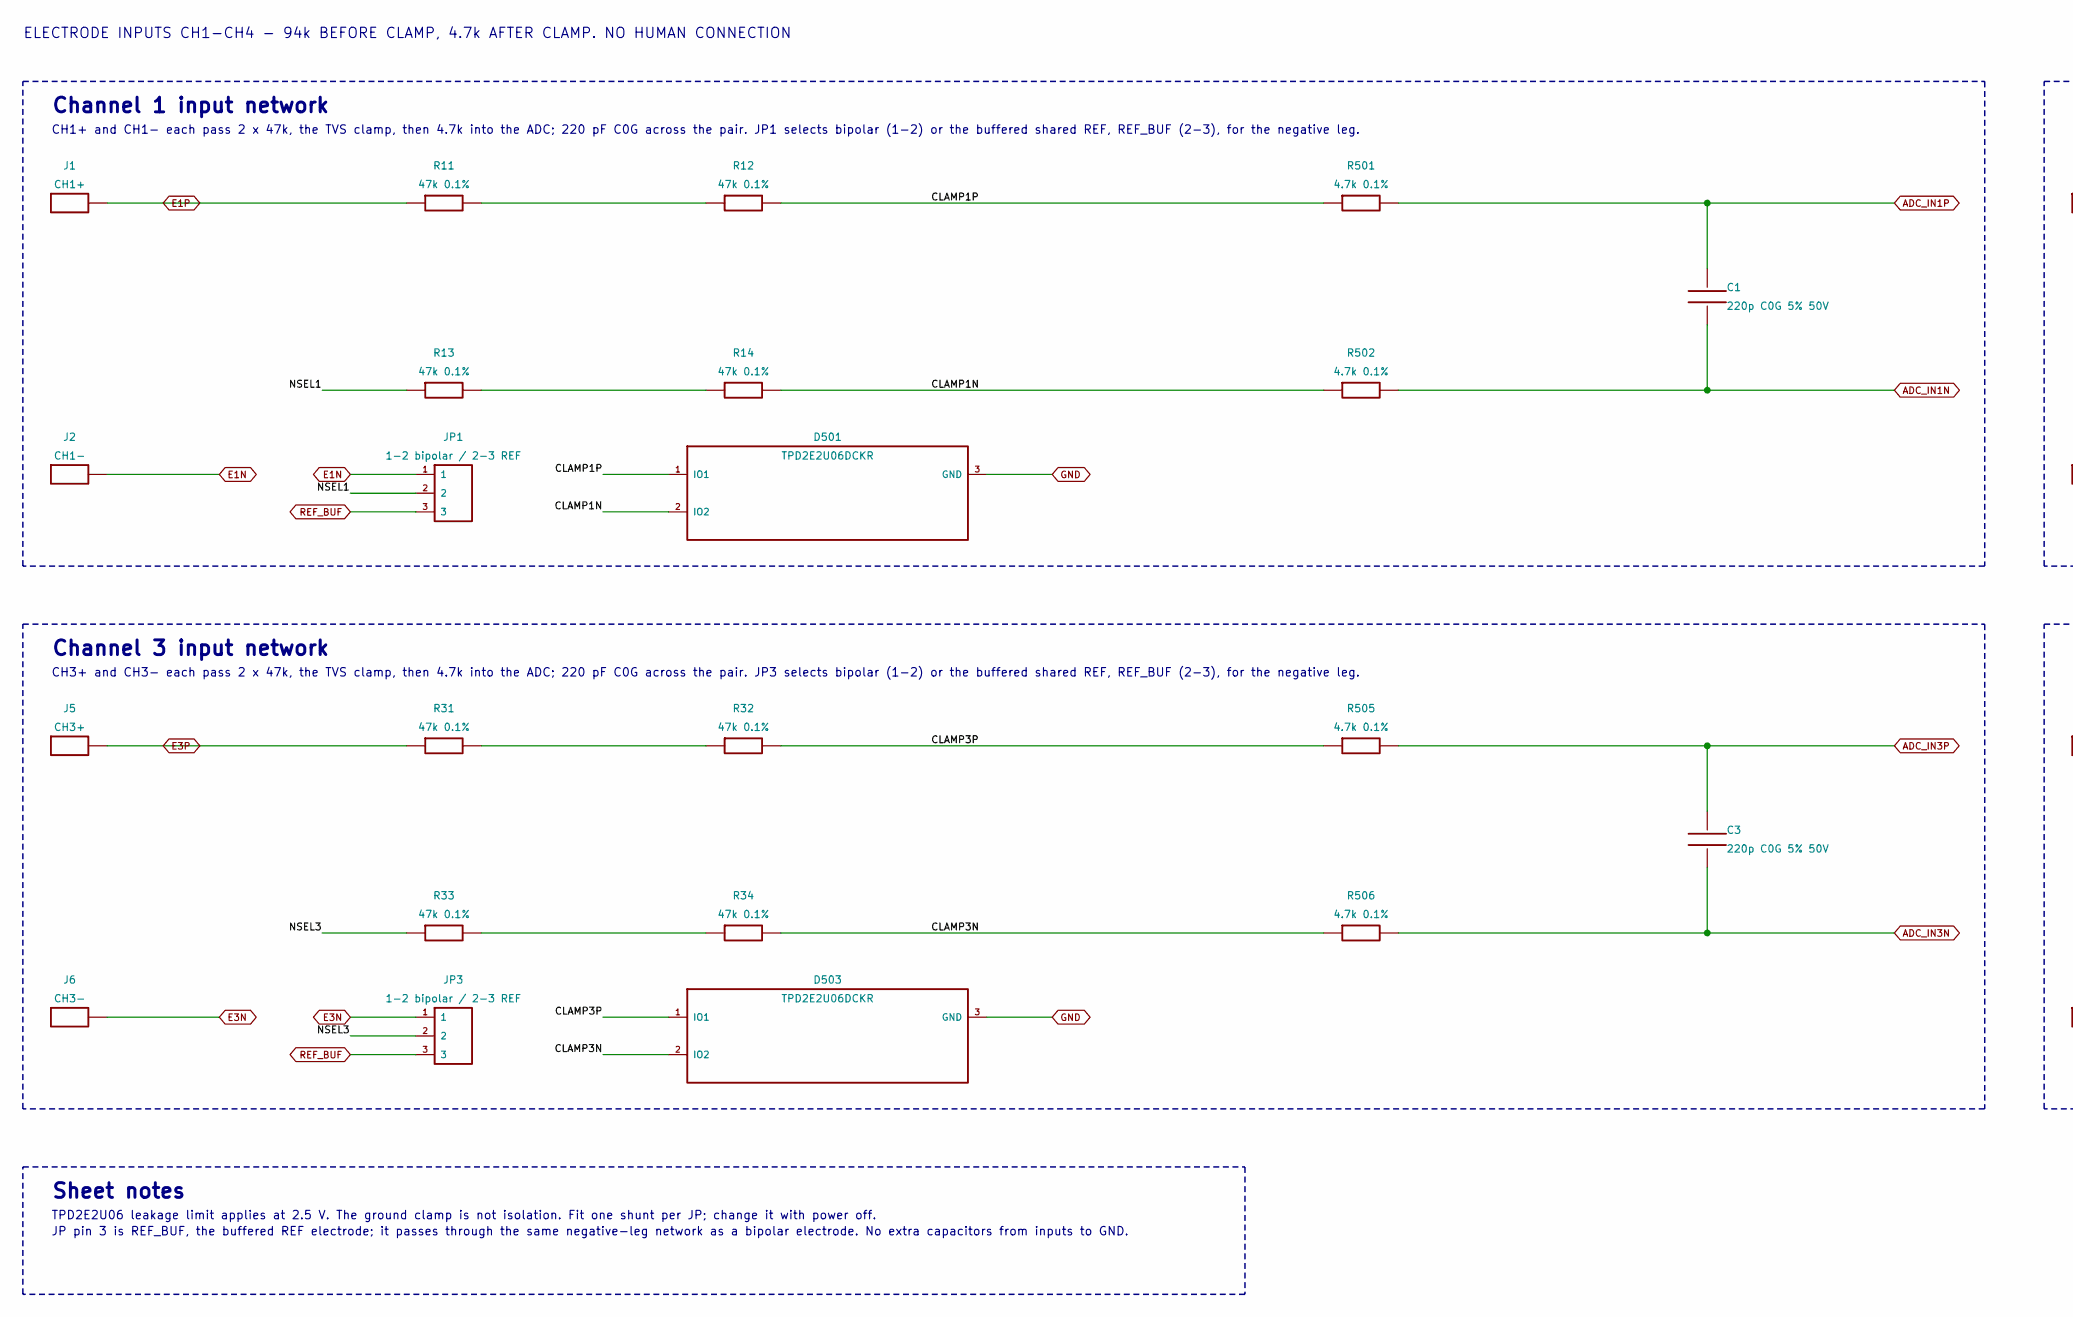
[picture p24: schematic inputs_1_4.kicad_sch, Electrode inputs 1-4 - protected bench candidate, part in row 1, column 1]

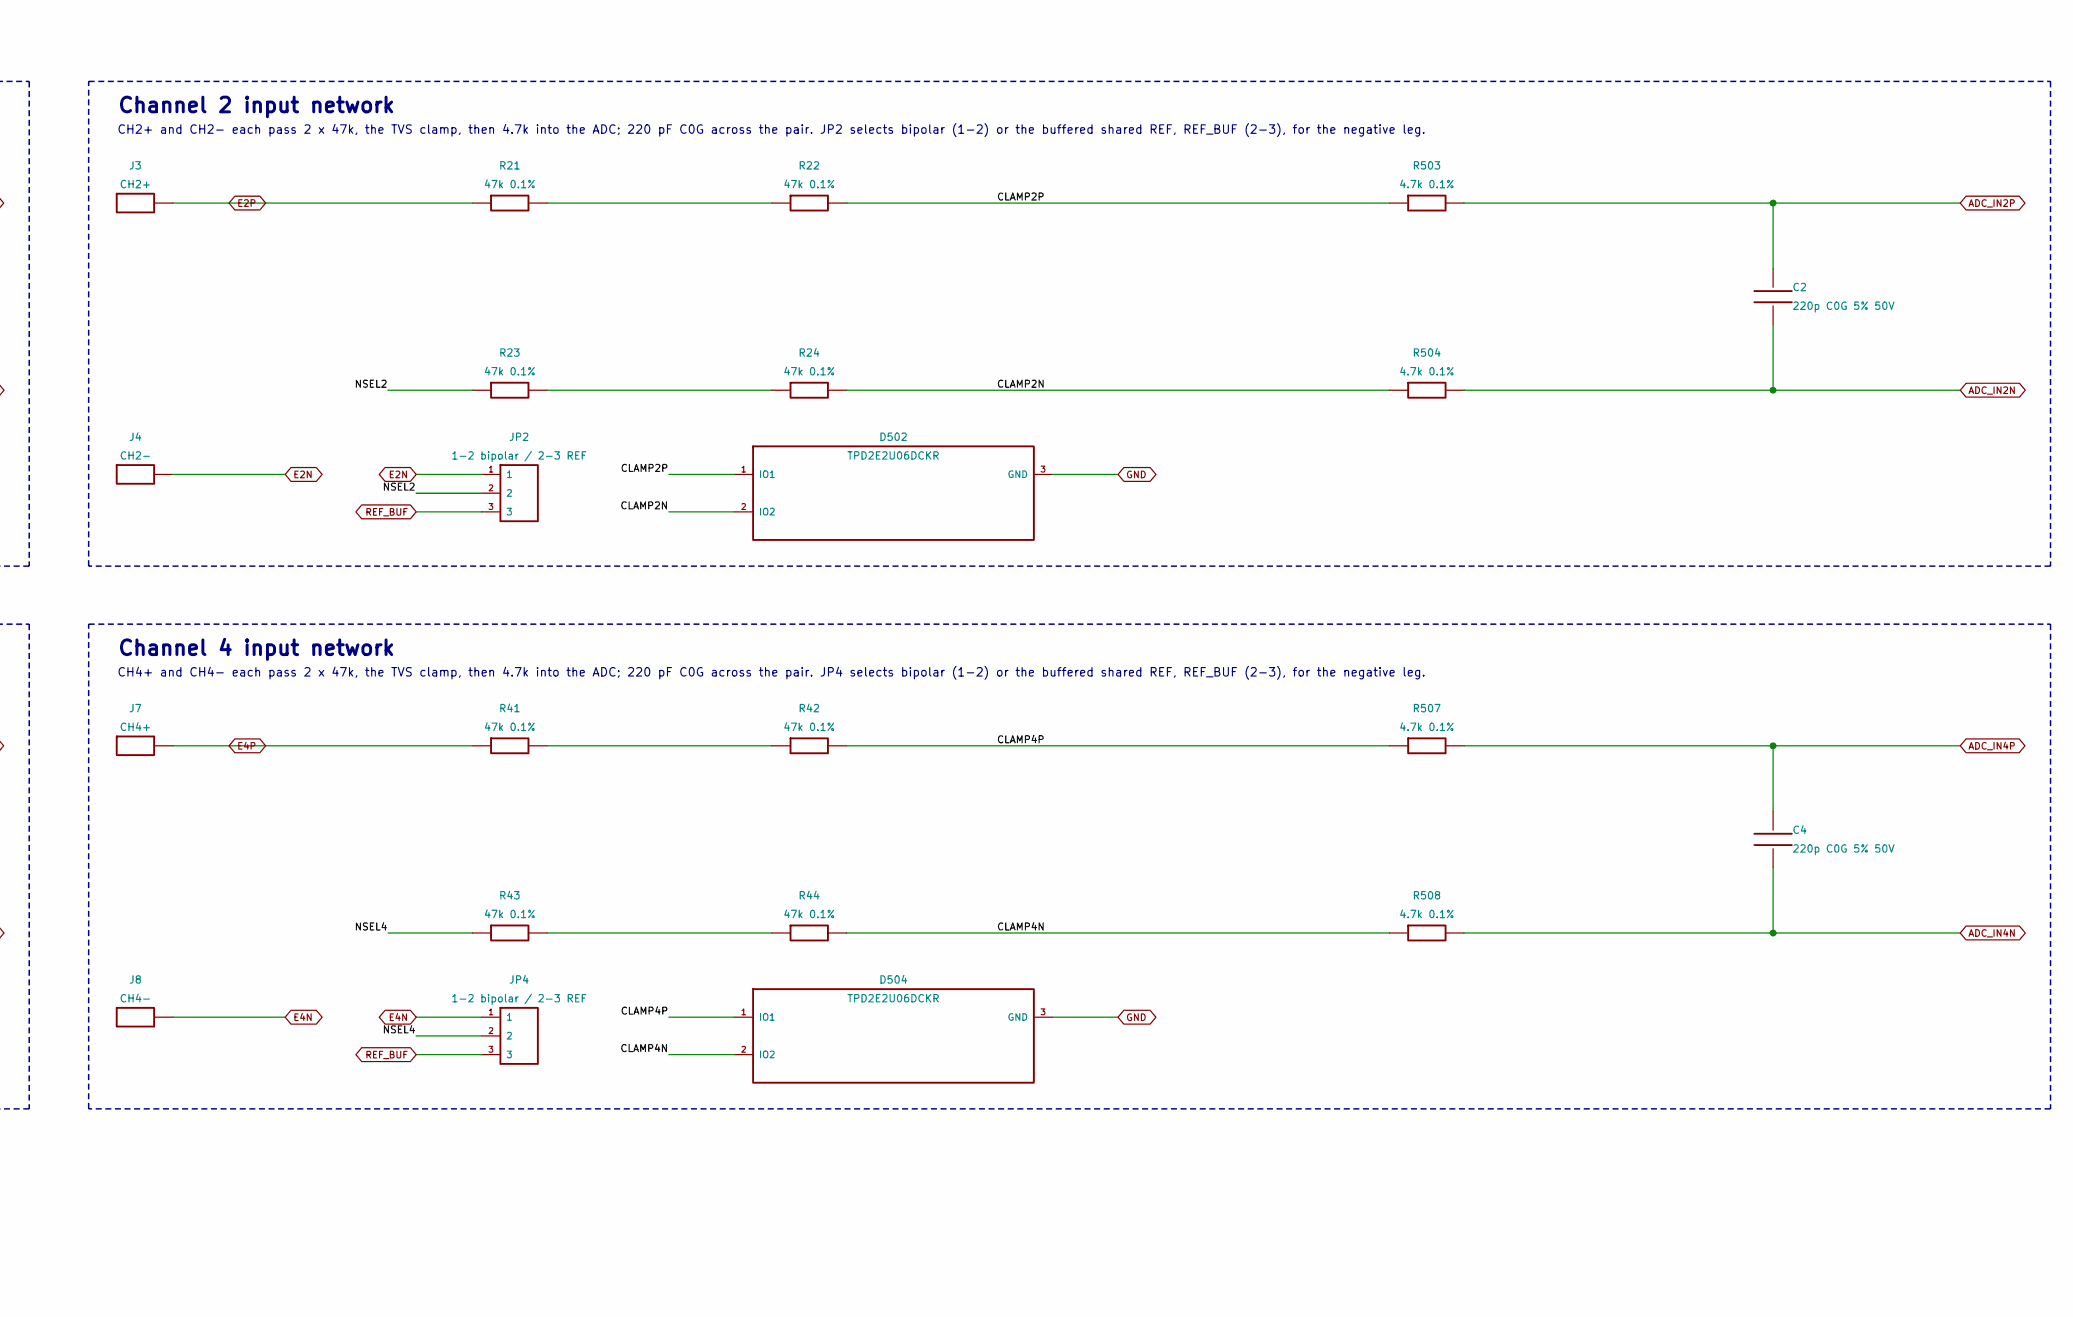
[picture p25: schematic inputs_1_4.kicad_sch, Electrode inputs 1-4 - protected bench candidate, part in row 1, column 2]

Parts:
C1, C2, C3, C4: 220p C0G 5% 50V; C_0603_1608Metric; MPN GCM1885C1H221JA16D
D501, D502, D503, D504: TPD2E2U06DCKR; SOT-323_SC-70; MPN TPD2E2U06DCKR
J1: CH1+
J2: CH1-
J3: CH2+
J4: CH2-
J5: CH3+
J6: CH3-
J7: CH4+
J8: CH4-
JP1, JP2, JP3, JP4: 1-2 bipolar / 2-3 REF; PinHeader_1x03_P2.54mm_Vertical; MPN 61300311121
R11, R12, R13, R14, R21, R22, R23, R24, R31, R32, R33, R34, R41, R42, R43, R44: 47k 0.1%; R_0805_2012Metric; MPN ERJ-PB6B4702V
R501, R502, R503, R504, R505, R506, R507, R508: 4.7k 0.1%; R_0805_2012Metric; MPN ERJ-PB6B4701V

Connections:
/Electrode inputs 1-4 - protected bench candidate/CLAMP1N: D501.2 (IO2), R14.2, R502.1
/Electrode inputs 1-4 - protected bench candidate/CLAMP1P: D501.1 (IO1), R12.2, R501.1
/Electrode inputs 1-4 - protected bench candidate/CLAMP2N: D502.2 (IO2), R24.2, R504.1
/Electrode inputs 1-4 - protected bench candidate/CLAMP2P: D502.1 (IO1), R22.2, R503.1
/Electrode inputs 1-4 - protected bench candidate/CLAMP3N: D503.2 (IO2), R34.2, R506.1
/Electrode inputs 1-4 - protected bench candidate/CLAMP3P: D503.1 (IO1), R32.2, R505.1
/Electrode inputs 1-4 - protected bench candidate/CLAMP4N: D504.2 (IO2), R44.2, R508.1
/Electrode inputs 1-4 - protected bench candidate/CLAMP4P: D504.1 (IO1), R42.2, R507.1
/Electrode inputs 1-4 - protected bench candidate/NSEL1: JP1.2, R13.1
/Electrode inputs 1-4 - protected bench candidate/NSEL2: JP2.2, R23.1
/Electrode inputs 1-4 - protected bench candidate/NSEL3: JP3.2, R33.1
/Electrode inputs 1-4 - protected bench candidate/NSEL4: JP4.2, R43.1
ADC_IN1N: C1.2, R502.2; also elsewhere on the board
ADC_IN1P: C1.1, R501.2; also elsewhere on the board
ADC_IN2N: C2.2, R504.2; also elsewhere on the board
ADC_IN2P: C2.1, R503.2; also elsewhere on the board
ADC_IN3N: C3.2, R506.2; also elsewhere on the board
ADC_IN3P: C3.1, R505.2; also elsewhere on the board
ADC_IN4N: C4.2, R508.2; also elsewhere on the board
ADC_IN4P: C4.1, R507.2; also elsewhere on the board
E1N: J2.1, JP1.1; also elsewhere on the board
E1P: J1.1, R11.1; also elsewhere on the board
E2N: J4.1, JP2.1; also elsewhere on the board
E2P: J3.1, R21.1; also elsewhere on the board
E3N: J6.1, JP3.1; also elsewhere on the board
E3P: J5.1, R31.1; also elsewhere on the board
E4N: J8.1, JP4.1; also elsewhere on the board
E4P: J7.1, R41.1; also elsewhere on the board
GND: D501.3 (GND), D502.3 (GND), D503.3 (GND), D504.3 (GND); also elsewhere on the board
unnamed: R11.2, R12.1
unnamed: R13.2, R14.1
unnamed: R21.2, R22.1
unnamed: R23.2, R24.1
unnamed: R31.2, R32.1
unnamed: R33.2, R34.1
unnamed: R41.2, R42.1
unnamed: R43.2, R44.1
REF_BUF: JP1.3, JP2.3, JP3.3, JP4.3; also elsewhere on the board

Notes on the sheet:
ELECTRODE INPUTS CH1-CH4 - 94k BEFORE CLAMP, 4.7k AFTER CLAMP. NO HUMAN CONNECTION
Channel 1 input network
CH1+ and CH1- each pass 2 x 47k, the TVS clamp, then 4.7k into the ADC; 220 pF C0G across the pair. JP1 selects bipolar (1-2) or the buffered shared REF, REF_BUF (2-3), for the negative leg.
Channel 2 input network
CH2+ and CH2- each pass 2 x 47k, the TVS clamp, then 4.7k into the ADC; 220 pF C0G across the pair. JP2 selects bipolar (1-2) or the buffered shared REF, REF_BUF (2-3), for the negative leg.
Channel 3 input network
CH3+ and CH3- each pass 2 x 47k, the TVS clamp, then 4.7k into the ADC; 220 pF C0G across the pair. JP3 selects bipolar (1-2) or the buffered shared REF, REF_BUF (2-3), for the negative leg.
Channel 4 input network
CH4+ and CH4- each pass 2 x 47k, the TVS clamp, then 4.7k into the ADC; 220 pF C0G across the pair. JP4 selects bipolar (1-2) or the buffered shared REF, REF_BUF (2-3), for the negative leg.
Sheet notes
TPD2E2U06 leakage limit applies at 2.5 V. The ground clamp is not isolation. Fit one shunt per JP; change it with power off.
JP pin 3 is REF_BUF, the buffered REF electrode; it passes through the same negative-leg network as a bipolar electrode. No extra capacitors from inputs to GND.

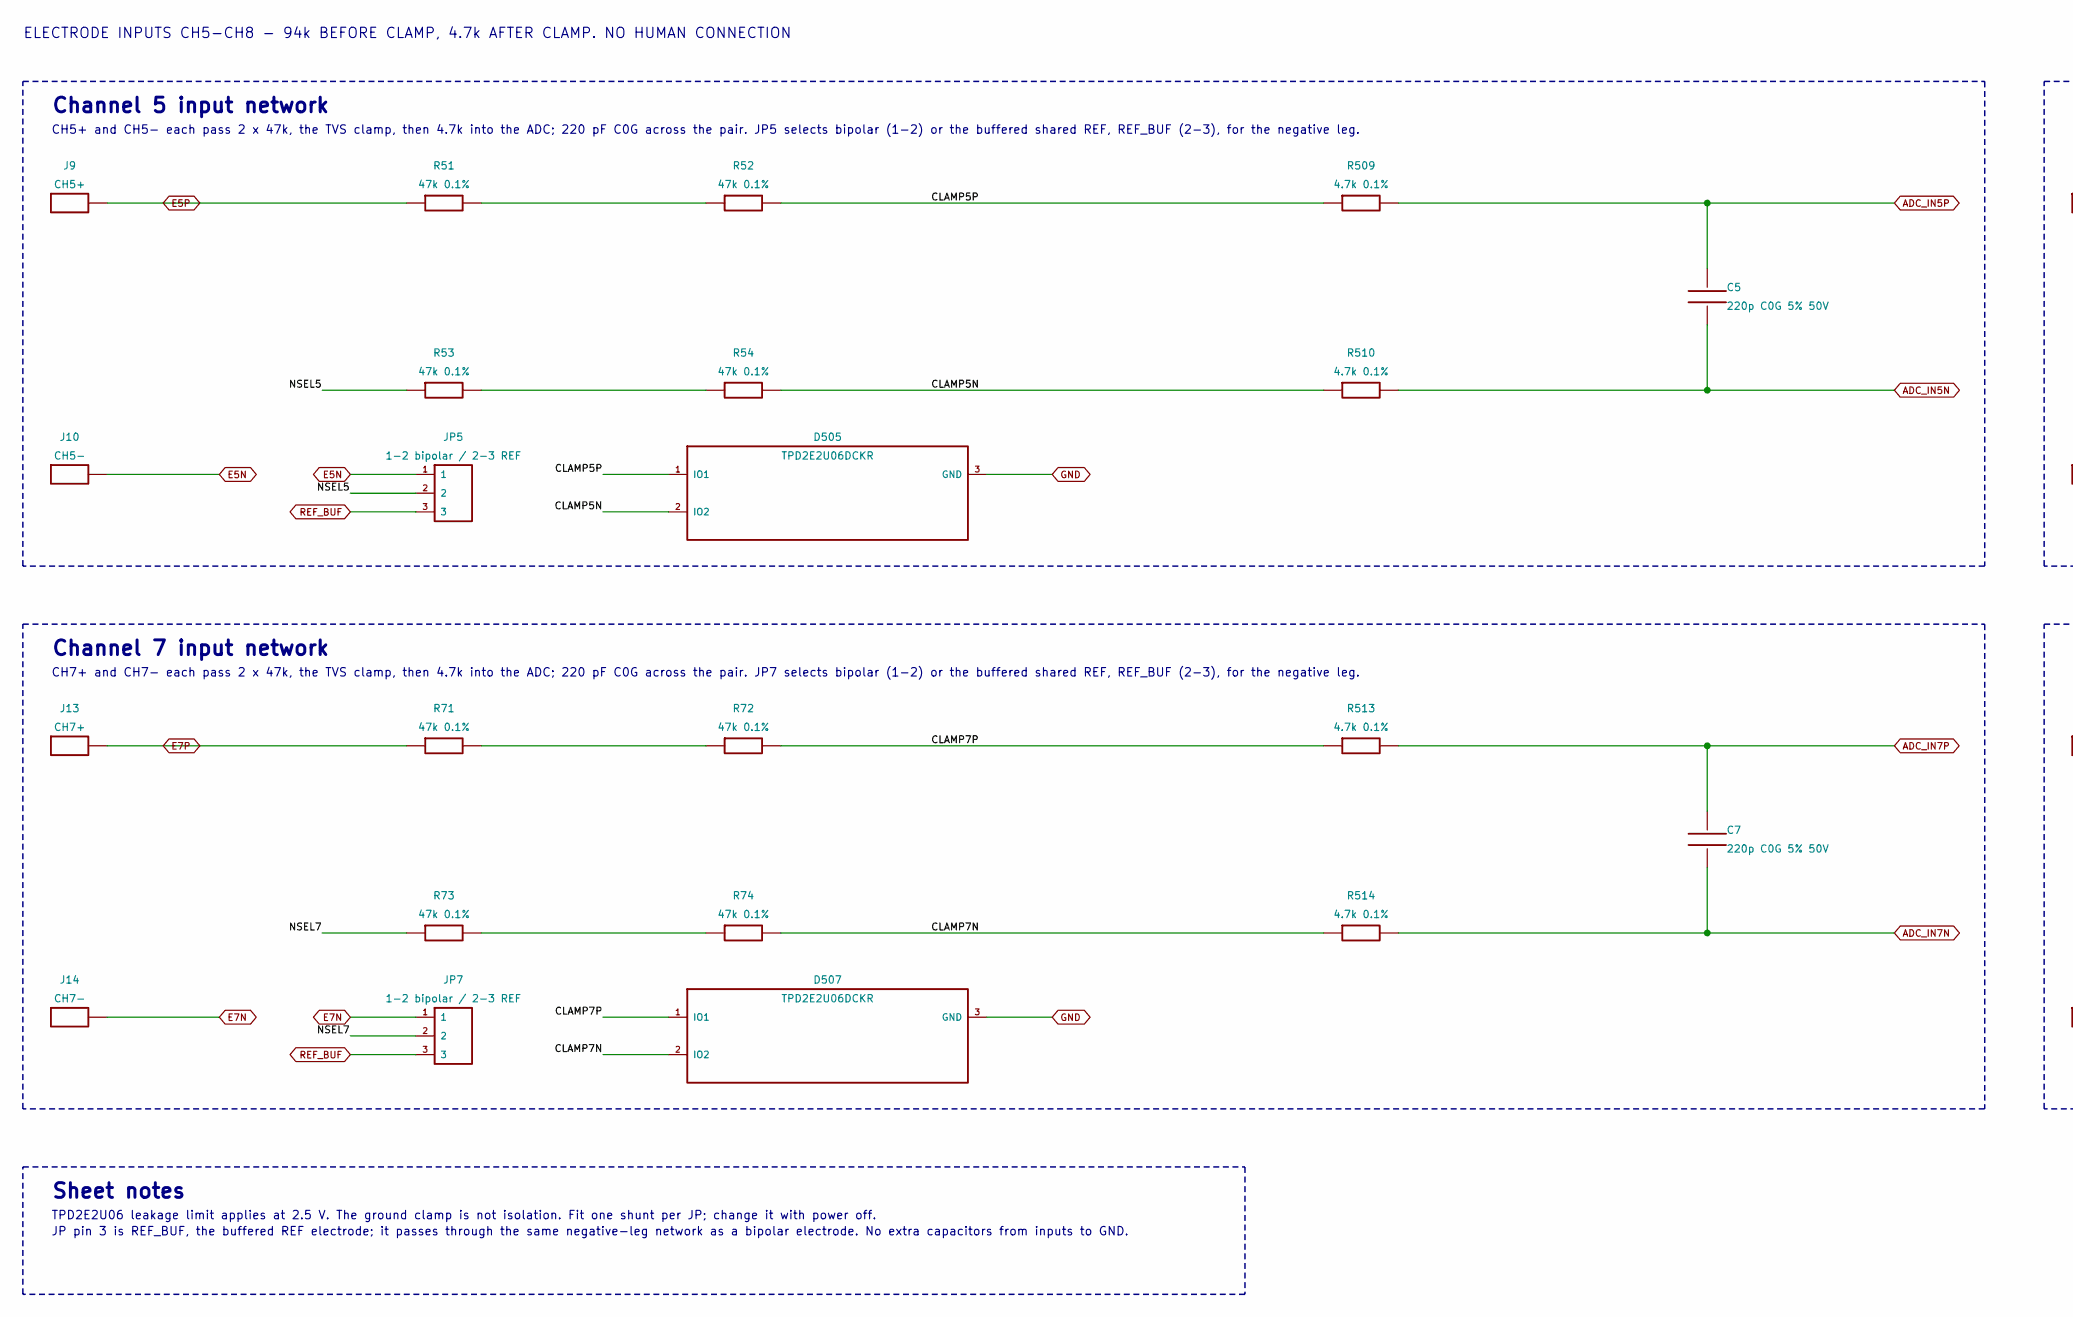
[picture p26: schematic inputs_5_8.kicad_sch, Electrode inputs 5-8 - protected bench candidate, part in row 1, column 1]

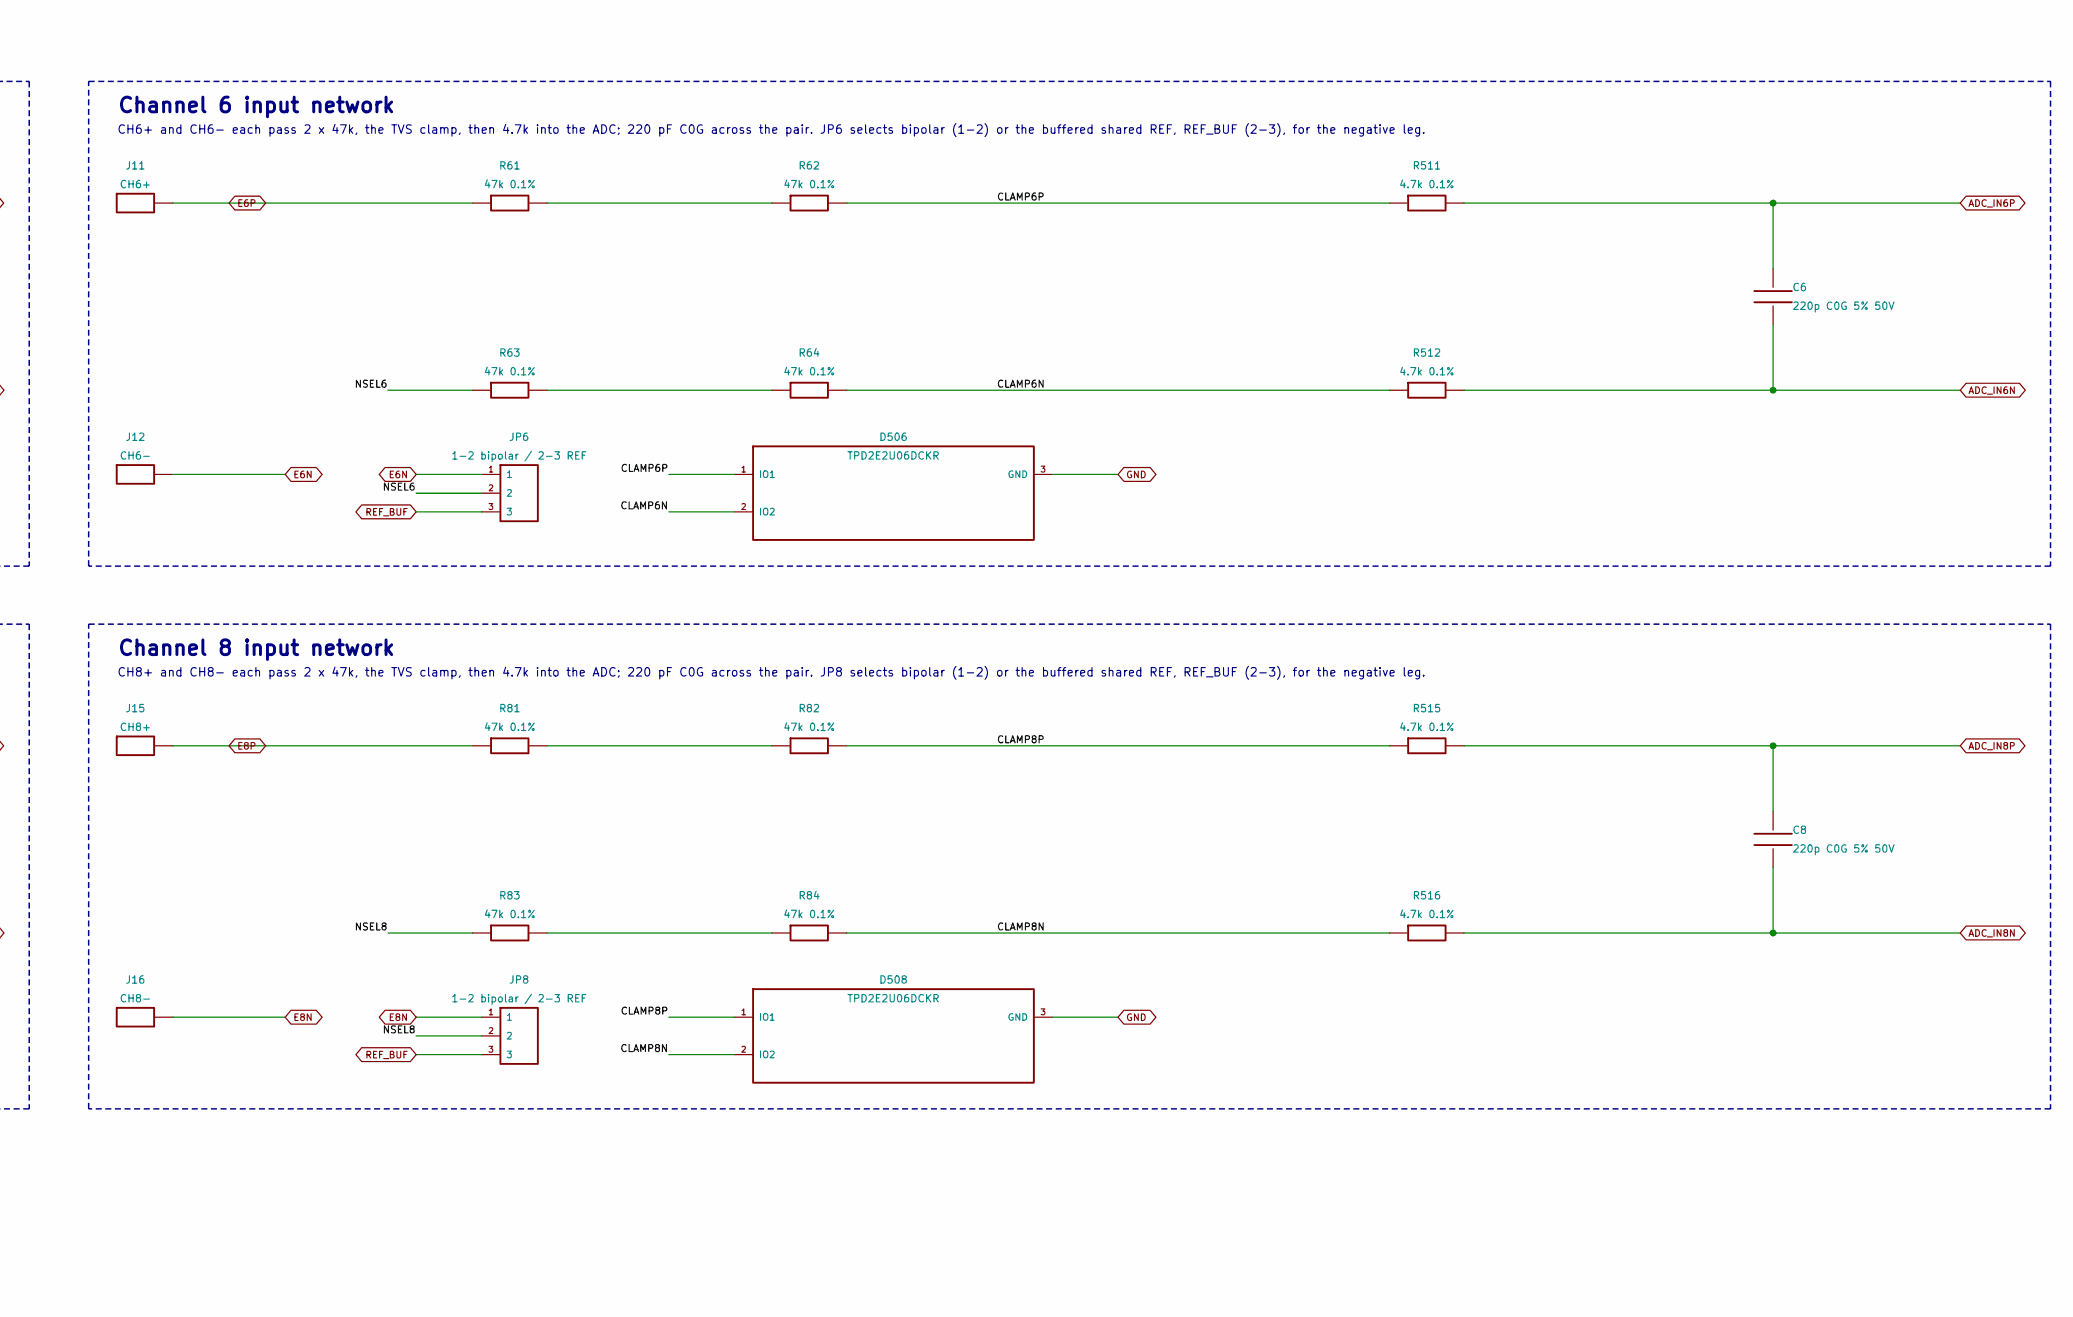
[picture p27: schematic inputs_5_8.kicad_sch, Electrode inputs 5-8 - protected bench candidate, part in row 1, column 2]

Parts:
C5, C6, C7, C8: 220p C0G 5% 50V; C_0603_1608Metric; MPN GCM1885C1H221JA16D
D505, D506, D507, D508: TPD2E2U06DCKR; SOT-323_SC-70; MPN TPD2E2U06DCKR
J9: CH5+
J10: CH5-
J11: CH6+
J12: CH6-
J13: CH7+
J14: CH7-
J15: CH8+
J16: CH8-
JP5, JP6, JP7, JP8: 1-2 bipolar / 2-3 REF; PinHeader_1x03_P2.54mm_Vertical; MPN 61300311121
R51, R52, R53, R54, R61, R62, R63, R64, R71, R72, R73, R74, R81, R82, R83, R84: 47k 0.1%; R_0805_2012Metric; MPN ERJ-PB6B4702V
R509, R510, R511, R512, R513, R514, R515, R516: 4.7k 0.1%; R_0805_2012Metric; MPN ERJ-PB6B4701V

Connections:
/Electrode inputs 5-8 - protected bench candidate/CLAMP5N: D505.2 (IO2), R54.2, R510.1
/Electrode inputs 5-8 - protected bench candidate/CLAMP5P: D505.1 (IO1), R52.2, R509.1
/Electrode inputs 5-8 - protected bench candidate/CLAMP6N: D506.2 (IO2), R64.2, R512.1
/Electrode inputs 5-8 - protected bench candidate/CLAMP6P: D506.1 (IO1), R62.2, R511.1
/Electrode inputs 5-8 - protected bench candidate/CLAMP7N: D507.2 (IO2), R74.2, R514.1
/Electrode inputs 5-8 - protected bench candidate/CLAMP7P: D507.1 (IO1), R72.2, R513.1
/Electrode inputs 5-8 - protected bench candidate/CLAMP8N: D508.2 (IO2), R84.2, R516.1
/Electrode inputs 5-8 - protected bench candidate/CLAMP8P: D508.1 (IO1), R82.2, R515.1
/Electrode inputs 5-8 - protected bench candidate/NSEL5: JP5.2, R53.1
/Electrode inputs 5-8 - protected bench candidate/NSEL6: JP6.2, R63.1
/Electrode inputs 5-8 - protected bench candidate/NSEL7: JP7.2, R73.1
/Electrode inputs 5-8 - protected bench candidate/NSEL8: JP8.2, R83.1
ADC_IN5N: C5.2, R510.2; also elsewhere on the board
ADC_IN5P: C5.1, R509.2; also elsewhere on the board
ADC_IN6N: C6.2, R512.2; also elsewhere on the board
ADC_IN6P: C6.1, R511.2; also elsewhere on the board
ADC_IN7N: C7.2, R514.2; also elsewhere on the board
ADC_IN7P: C7.1, R513.2; also elsewhere on the board
ADC_IN8N: C8.2, R516.2; also elsewhere on the board
ADC_IN8P: C8.1, R515.2; also elsewhere on the board
E5N: J10.1, JP5.1; also elsewhere on the board
E5P: J9.1, R51.1; also elsewhere on the board
E6N: J12.1, JP6.1; also elsewhere on the board
E6P: J11.1, R61.1; also elsewhere on the board
E7N: J14.1, JP7.1; also elsewhere on the board
E7P: J13.1, R71.1; also elsewhere on the board
E8N: J16.1, JP8.1; also elsewhere on the board
E8P: J15.1, R81.1; also elsewhere on the board
GND: D505.3 (GND), D506.3 (GND), D507.3 (GND), D508.3 (GND); also elsewhere on the board
unnamed: R51.2, R52.1
unnamed: R53.2, R54.1
unnamed: R61.2, R62.1
unnamed: R63.2, R64.1
unnamed: R71.2, R72.1
unnamed: R73.2, R74.1
unnamed: R81.2, R82.1
unnamed: R83.2, R84.1
REF_BUF: JP5.3, JP6.3, JP7.3, JP8.3; also elsewhere on the board

Notes on the sheet:
ELECTRODE INPUTS CH5-CH8 - 94k BEFORE CLAMP, 4.7k AFTER CLAMP. NO HUMAN CONNECTION
Channel 5 input network
CH5+ and CH5- each pass 2 x 47k, the TVS clamp, then 4.7k into the ADC; 220 pF C0G across the pair. JP5 selects bipolar (1-2) or the buffered shared REF, REF_BUF (2-3), for the negative leg.
Channel 6 input network
CH6+ and CH6- each pass 2 x 47k, the TVS clamp, then 4.7k into the ADC; 220 pF C0G across the pair. JP6 selects bipolar (1-2) or the buffered shared REF, REF_BUF (2-3), for the negative leg.
Channel 7 input network
CH7+ and CH7- each pass 2 x 47k, the TVS clamp, then 4.7k into the ADC; 220 pF C0G across the pair. JP7 selects bipolar (1-2) or the buffered shared REF, REF_BUF (2-3), for the negative leg.
Channel 8 input network
CH8+ and CH8- each pass 2 x 47k, the TVS clamp, then 4.7k into the ADC; 220 pF C0G across the pair. JP8 selects bipolar (1-2) or the buffered shared REF, REF_BUF (2-3), for the negative leg.
Sheet notes
TPD2E2U06 leakage limit applies at 2.5 V. The ground clamp is not isolation. Fit one shunt per JP; change it with power off.
JP pin 3 is REF_BUF, the buffered REF electrode; it passes through the same negative-leg network as a bipolar electrode. No extra capacitors from inputs to GND.

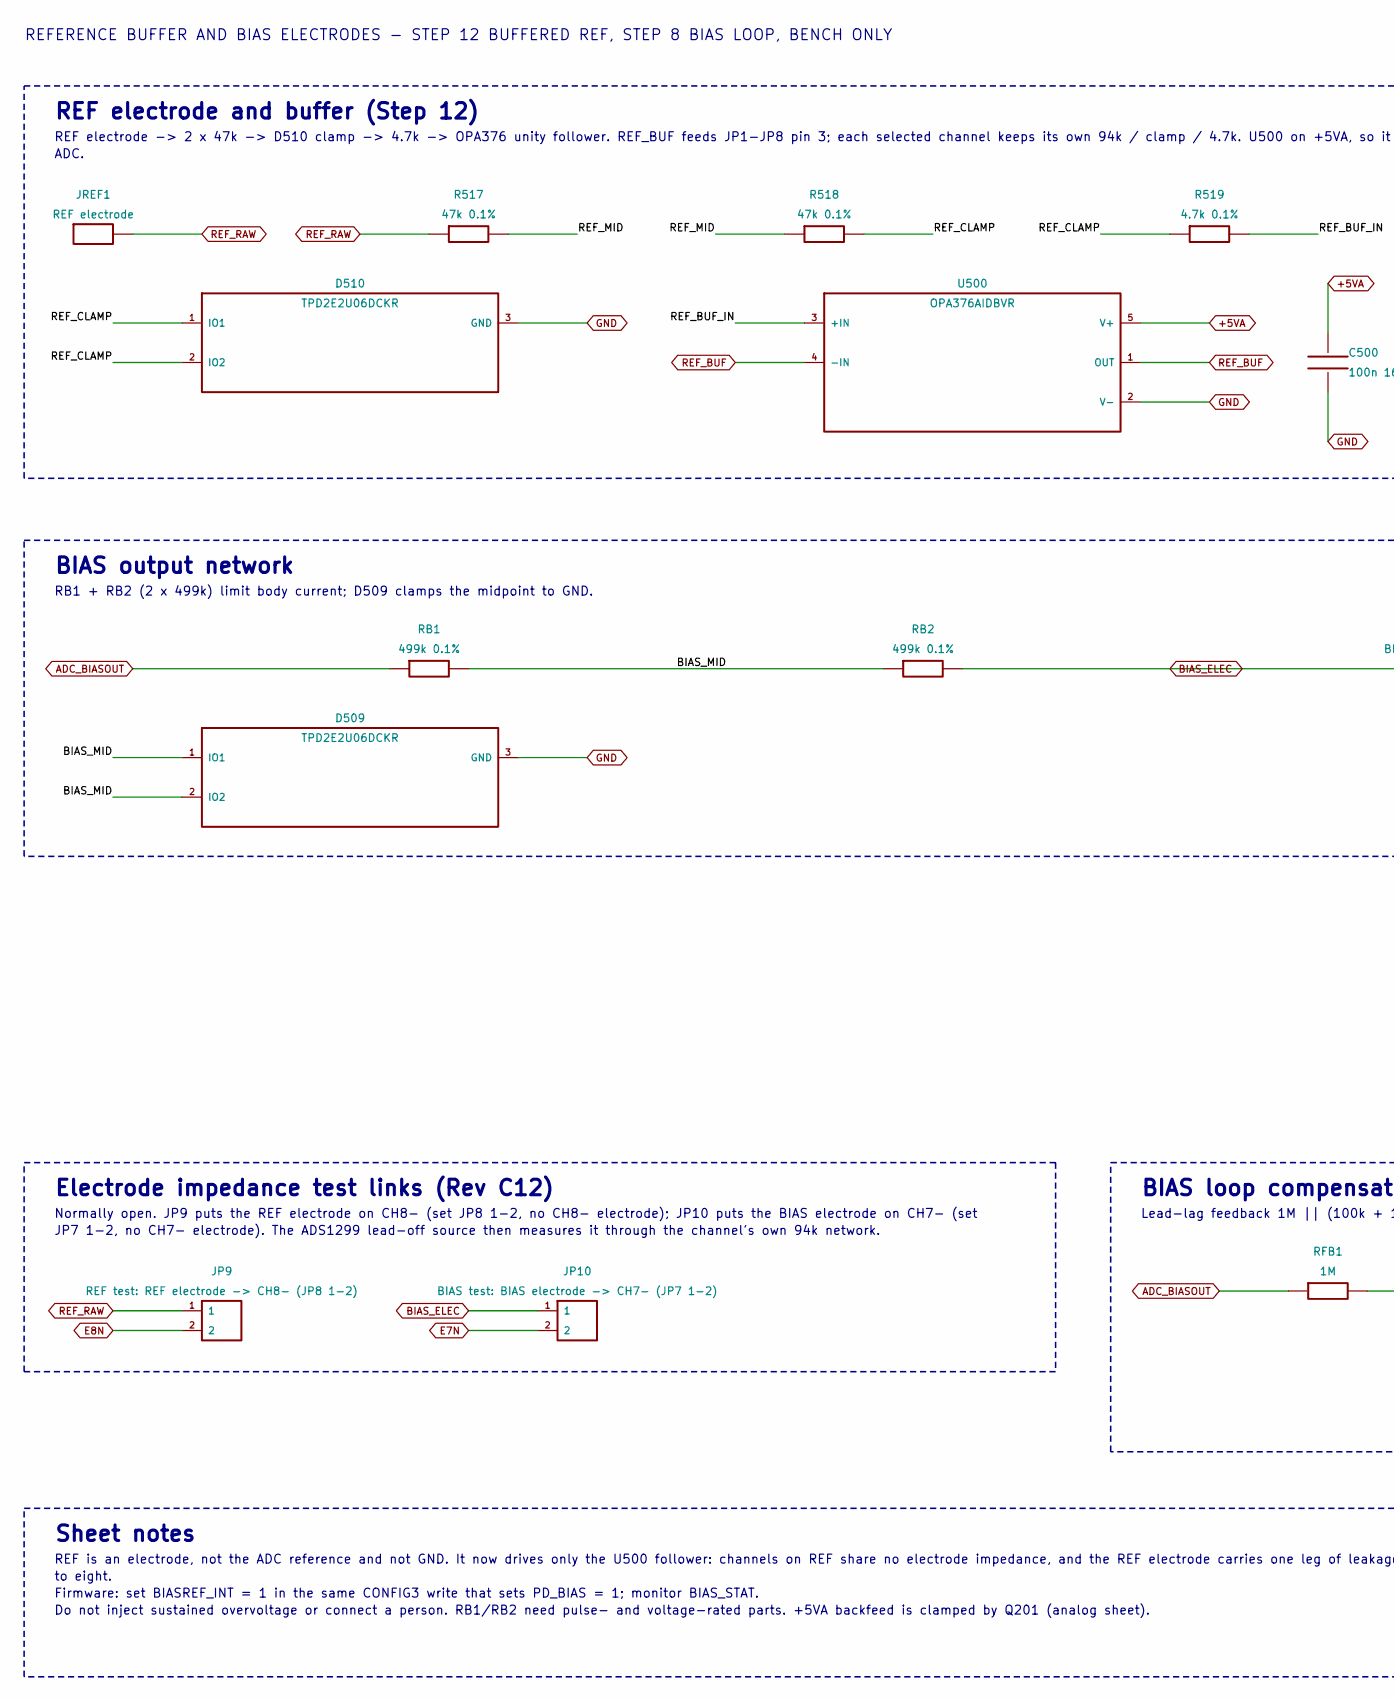
[picture p28: schematic ref_bias.kicad_sch, Reference buffer and BIAS drive network, part in row 1, column 1]

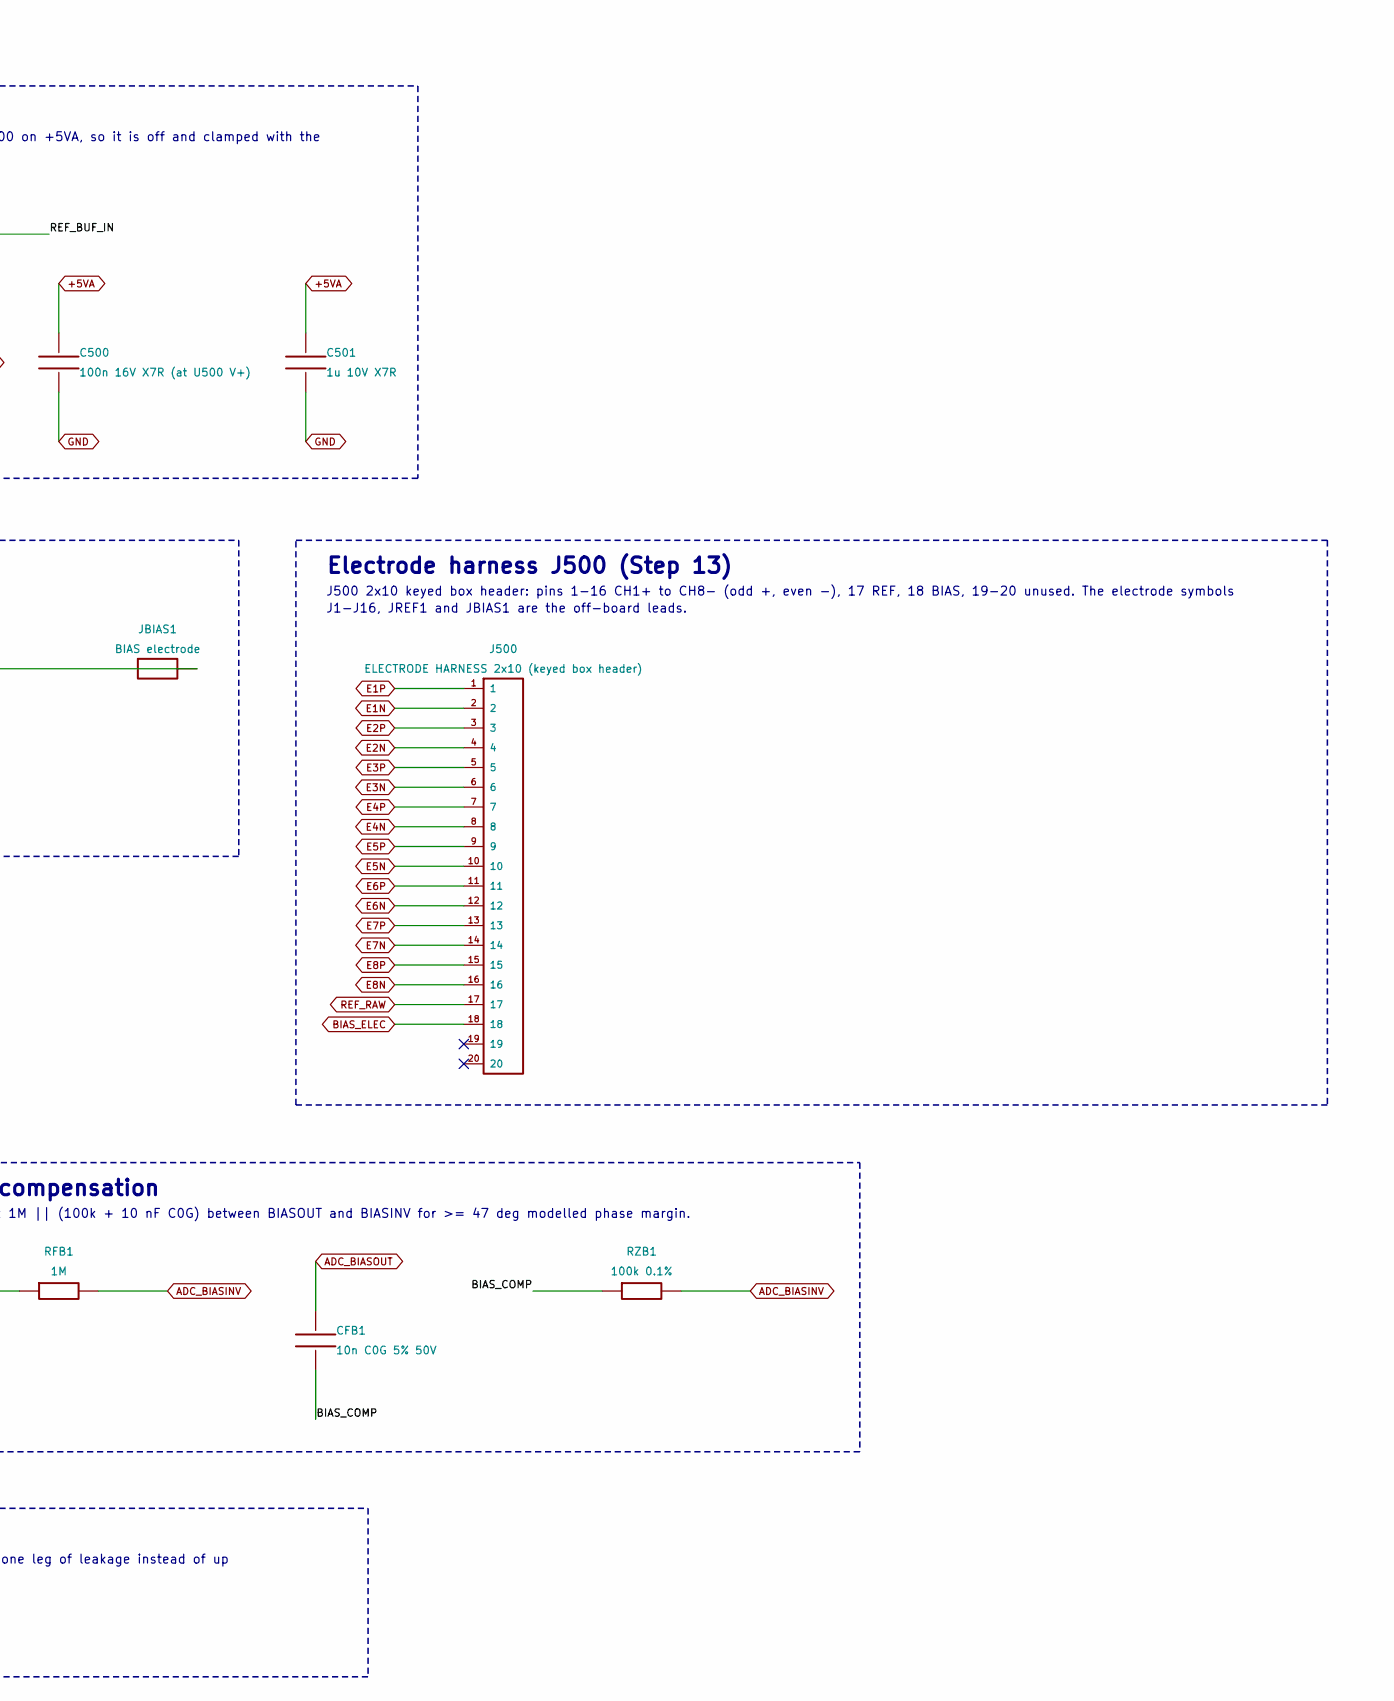
[picture p29: schematic ref_bias.kicad_sch, Reference buffer and BIAS drive network, part in row 1, column 2]

Parts:
C500: 100n 16V X7R (at U500 V+); C_0603_1608Metric; MPN GCM188R71H104KA57D
C501: 1u 10V X7R; C_0805_2012Metric; MPN GCM21BR71E105KA56L
CFB1: 10n C0G 5% 50V; C_0603_1608Metric; MPN GCM1885C1H103JA16D
D509, D510: TPD2E2U06DCKR; SOT-323_SC-70; MPN TPD2E2U06DCKR
J500: ELECTRODE HARNESS 2x10 (keyed box header); IDC-Header_2x10_P2.54mm_Vertical; MPN 61202021621
JBIAS1: BIAS electrode
JP9: REF test: REF electrode -> CH8- (JP8 1-2); PinHeader_1x02_P2.54mm_Vertical; MPN 61300211121
JP10: BIAS test: BIAS electrode -> CH7- (JP7 1-2); PinHeader_1x02_P2.54mm_Vertical; MPN 61300211121
JREF1: REF electrode
R517, R518: 47k 0.1%; R_0805_2012Metric; MPN ERJ-PB6B4702V
R519: 4.7k 0.1%; R_0805_2012Metric; MPN ERJ-PB6B4701V
RB1, RB2: 499k 0.1%; R_0805_2012Metric; MPN ERJ-PB6B4993V
RFB1: 1M; R_0805_2012Metric; MPN ERJ-PB6B1004V
RZB1: 100k 0.1%; R_0805_2012Metric; MPN ERJ-PB6B1003V
U500: OPA376AIDBVR; SOT-23-5; MPN OPA376AIDBVR

Connections:
+5VA: C500.1, C501.1, U500.5 (V+); also elsewhere on the board
/Reference buffer and BIAS drive network/BIAS_COMP: CFB1.2, RZB1.1
/Reference buffer and BIAS drive network/BIAS_MID: D509.1 (IO1), D509.2 (IO2), RB1.2, RB2.1
/Reference buffer and BIAS drive network/REF_BUF_IN: R519.2, U500.3 (+IN)
/Reference buffer and BIAS drive network/REF_CLAMP: D510.1 (IO1), D510.2 (IO2), R518.2, R519.1
/Reference buffer and BIAS drive network/REF_MID: R517.2, R518.1
ADC_BIASINV: RFB1.2, RZB1.2; also elsewhere on the board
ADC_BIASOUT: CFB1.1, RB1.1, RFB1.1; also elsewhere on the board
BIAS_ELEC: J500.18, JBIAS1.1, JP10.1, RB2.2
E1N: J500.2; also elsewhere on the board
E1P: J500.1; also elsewhere on the board
E2N: J500.4; also elsewhere on the board
E2P: J500.3; also elsewhere on the board
E3N: J500.6; also elsewhere on the board
E3P: J500.5; also elsewhere on the board
E4N: J500.8; also elsewhere on the board
E4P: J500.7; also elsewhere on the board
E5N: J500.10; also elsewhere on the board
E5P: J500.9; also elsewhere on the board
E6N: J500.12; also elsewhere on the board
E6P: J500.11; also elsewhere on the board
E7N: J500.14, JP10.2; also elsewhere on the board
E7P: J500.13; also elsewhere on the board
E8N: J500.16, JP9.2; also elsewhere on the board
E8P: J500.15; also elsewhere on the board
GND: C500.2, C501.2, D509.3 (GND), D510.3 (GND), U500.2 (V-); also elsewhere on the board
REF_BUF: U500.1 (OUT), U500.4 (-IN); also elsewhere on the board
REF_RAW: J500.17, JP9.1, JREF1.1, R517.1

Notes on the sheet:
REFERENCE BUFFER AND BIAS ELECTRODES - STEP 12 BUFFERED REF, STEP 8 BIAS LOOP, BENCH ONLY
REF electrode and buffer (Step 12)
REF electrode -> 2 x 47k -> D510 clamp -> 4.7k -> OPA376 unity follower. REF_BUF feeds JP1-JP8 pin 3; each selected channel keeps its own 94k / clamp / 4.7k. U500 on +5VA, so it is off and clamped with the
ADC.
BIAS output network
RB1 + RB2 (2 x 499k) limit body current; D509 clamps the midpoint to GND.
Electrode harness J500 (Step 13)
J500 2x10 keyed box header: pins 1-16 CH1+ to CH8- (odd +, even -), 17 REF, 18 BIAS, 19-20 unused. The electrode symbols
J1-J16, JREF1 and JBIAS1 are the off-board leads.
Electrode impedance test links (Rev C12)
Normally open. JP9 puts the REF electrode on CH8- (set JP8 1-2, no CH8- electrode); JP10 puts the BIAS electrode on CH7- (set
JP7 1-2, no CH7- electrode). The ADS1299 lead-off source then measures it through the channel's own 94k network.
BIAS loop compensation
Lead-lag feedback 1M || (100k + 10 nF C0G) between BIASOUT and BIASINV for >= 47 deg modelled phase margin.
Sheet notes
REF is an electrode, not the ADC reference and not GND. It now drives only the U500 follower: channels on REF share no electrode impedance, and the REF electrode carries one leg of leakage instead of up
to eight.
Firmware: set BIASREF_INT = 1 in the same CONFIG3 write that sets PD_BIAS = 1; monitor BIAS_STAT.
Do not inject sustained overvoltage or connect a person. RB1/RB2 need pulse- and voltage-rated parts. +5VA backfeed is clamped by Q201 (analog sheet).
