MariusFauteux/EEG-PCB/hardware/EEG_RevC.kicad_pcb

## KiCad design hardware/EEG_RevC.kicad_pcb (continued)

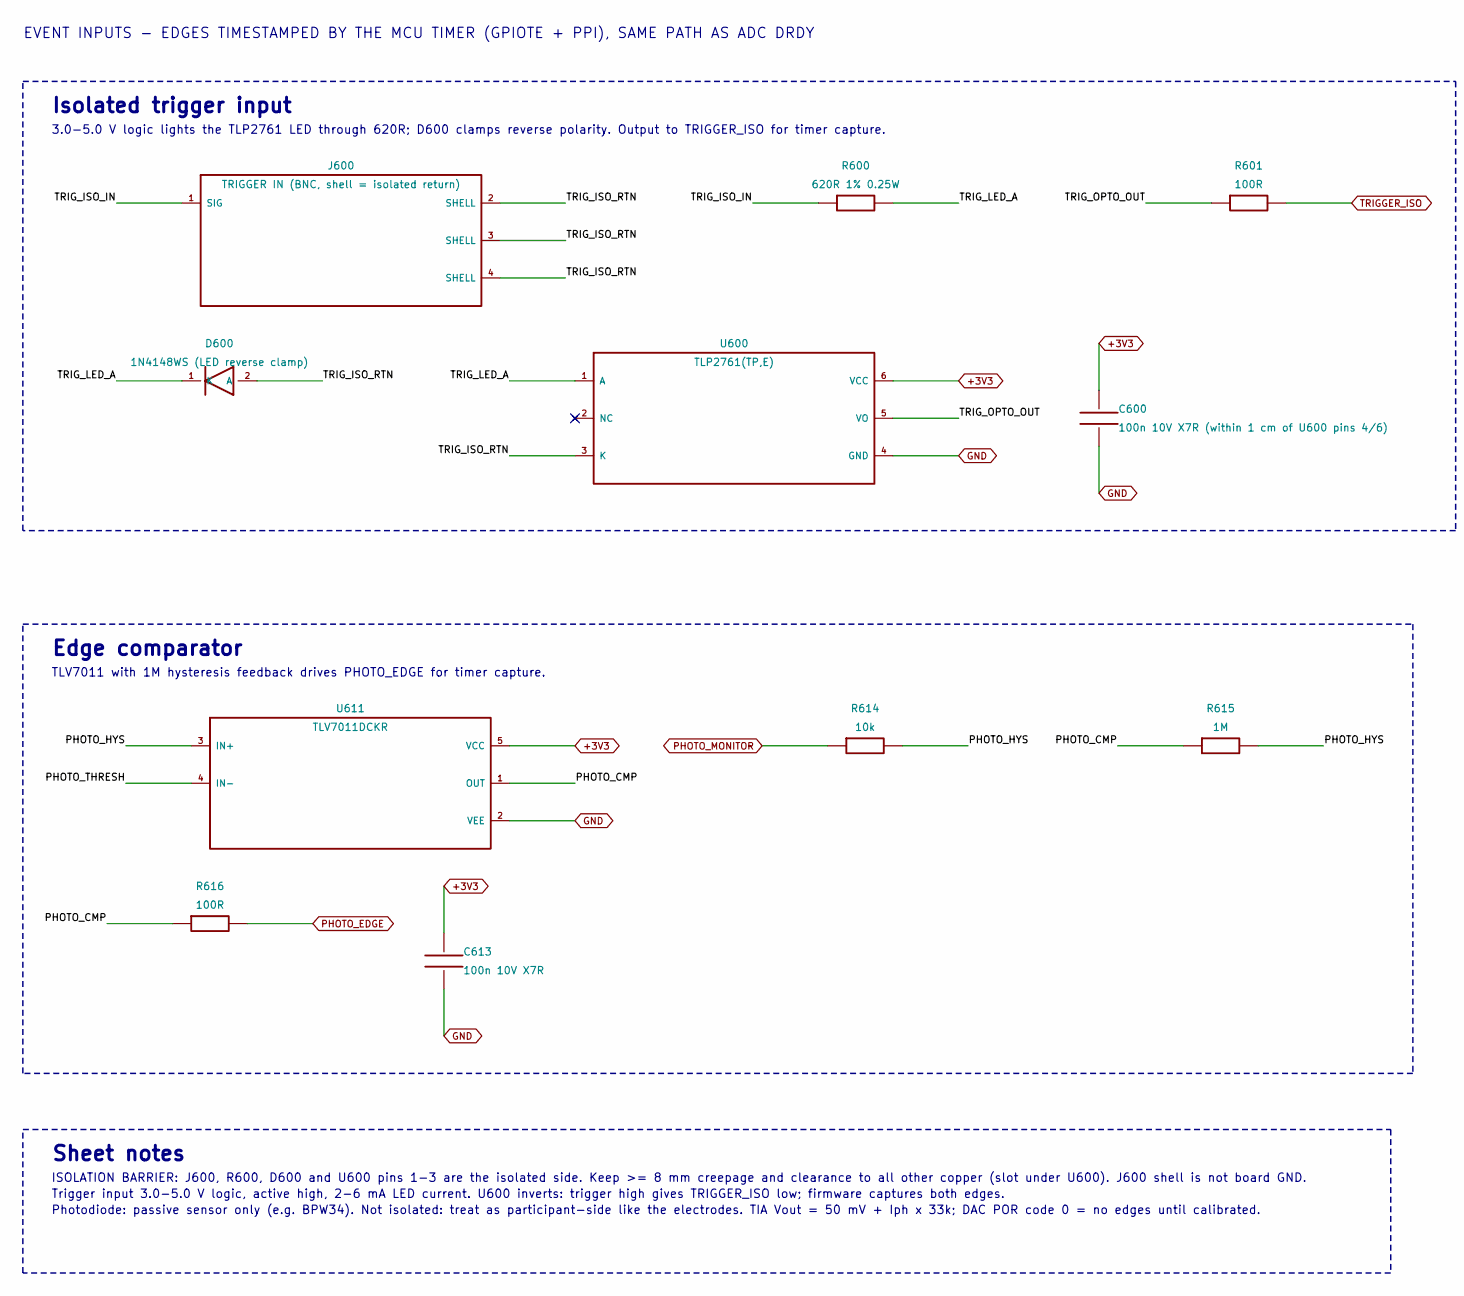
[picture p30: schematic event_inputs.kicad_sch, Isolated trigger input and photodiode front end, part in row 1, column 1]

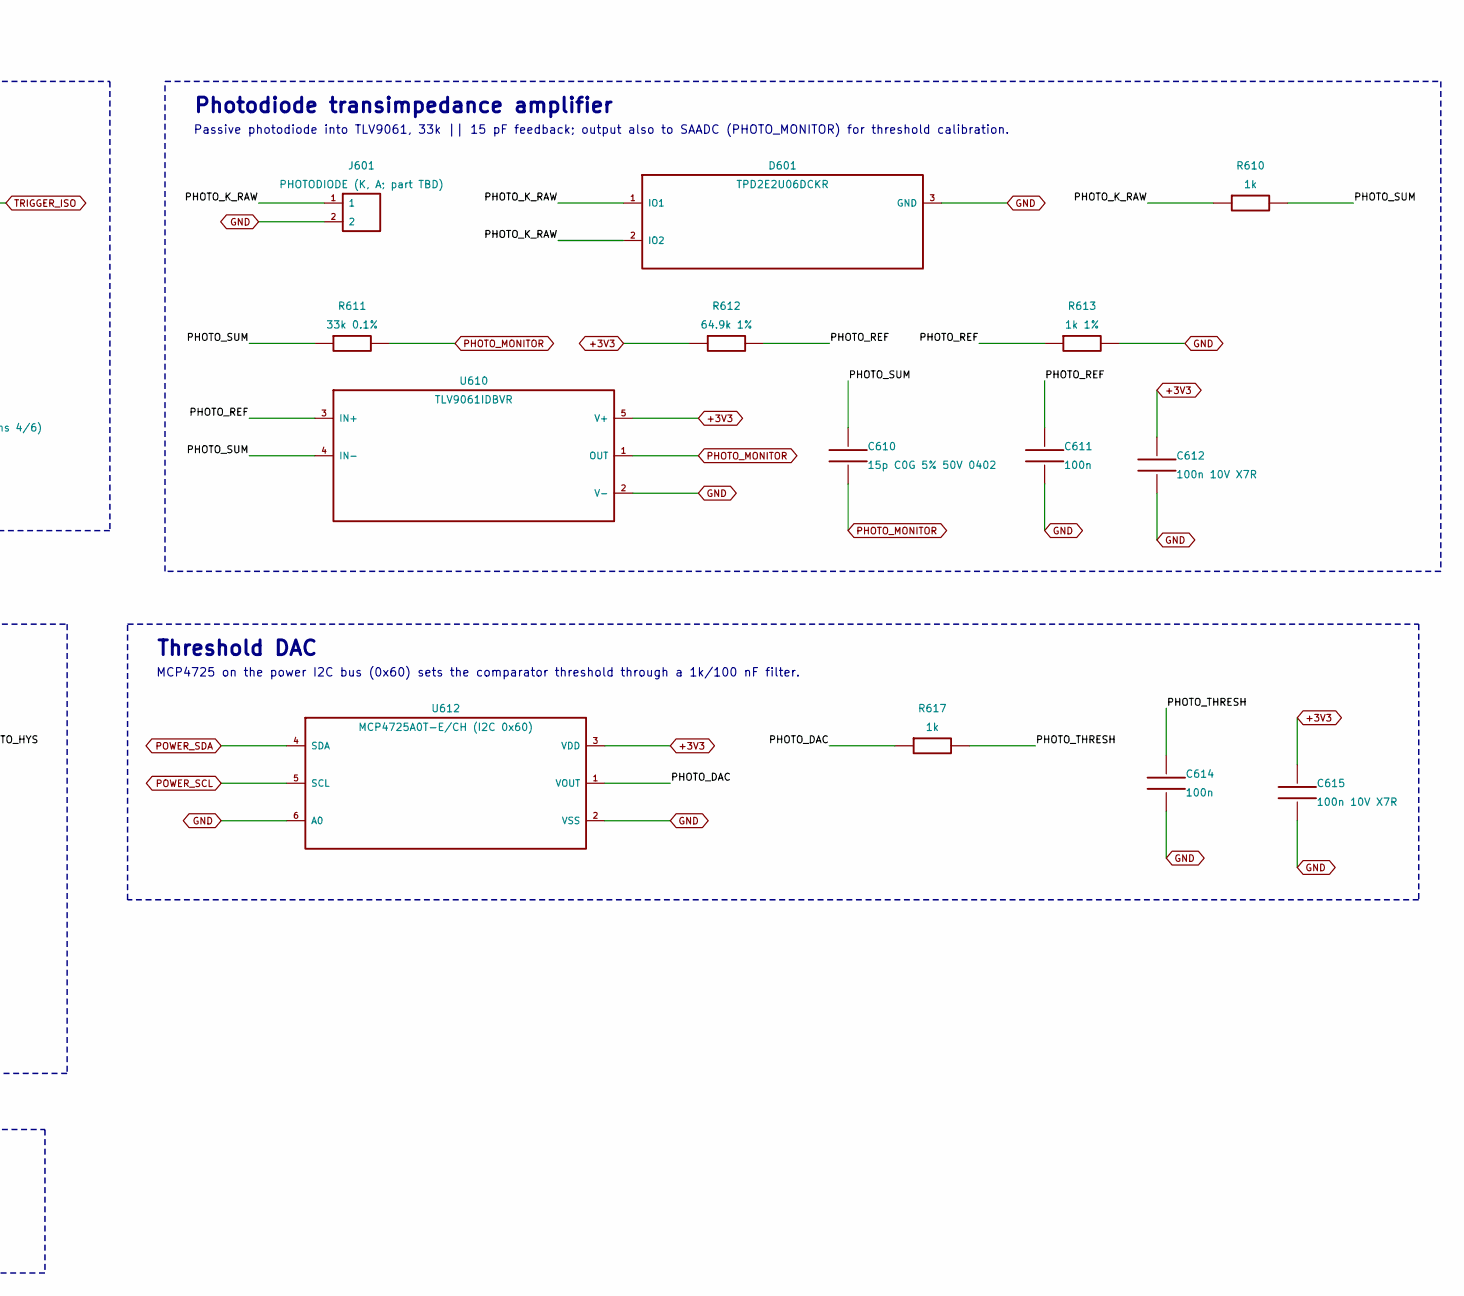
[picture p31: schematic event_inputs.kicad_sch, Isolated trigger input and photodiode front end, part in row 1, column 2]

Parts:
C600: 100n 10V X7R (within 1 cm of U600 pins 4/6); C_0603_1608Metric; MPN GCM188R71H104KA57D
C610: 15p C0G 5% 50V 0402; C_0402_1005Metric; MPN GCM1555C1H150JA16D
C611, C614: 100n; C_0603_1608Metric; MPN GCM188R71H104KA57D
C612, C613, C615: 100n 10V X7R; C_0603_1608Metric; MPN GCM188R71H104KA57D
D600: 1N4148WS (LED reverse clamp); D_SOD-323; MPN 1N4148WS-7-F
D601: TPD2E2U06DCKR; SOT-323_SC-70; MPN TPD2E2U06DCKR
J600: TRIGGER IN (BNC, shell = isolated return); BNC_Amphenol_031-6575_Horizontal; MPN 031-6575
J601: PHOTODIODE (K, A; part TBD); JST_PH_S2B-PH-K_1x02_P2.00mm_Horizontal; MPN S2B-PH-K-S
R600: 620R 1% 0.25W; R_1206_3216Metric; MPN ERJ-8ENF6200V
R601, R616: 100R; R_0603_1608Metric; MPN ERJ-3EKF1000V
R610, R617: 1k; R_0603_1608Metric; MPN ERJ-3EKF1001V
R611: 33k 0.1%; R_0603_1608Metric; MPN ERA-3ARB333V
R612: 64.9k 1%; R_0603_1608Metric; MPN ERJ-3EKF6492V
R613: 1k 1%; R_0603_1608Metric; MPN ERJ-3EKF1001V
R614: 10k; R_0603_1608Metric; MPN ERJ-3EKF1002V
R615: 1M; R_0603_1608Metric; MPN ERJ-3EKF1004V
U600: TLP2761(TP,E); SO-6L_10x3.84mm_P1.27mm; MPN TLP2761(TP,E)
U610: TLV9061IDBVR; SOT-23-5; MPN TLV9061IDBVR
U611: TLV7011DCKR; SOT-353_SC-70-5; MPN TLV7011DCKR
U612: MCP4725A0T-E/CH (I2C 0x60); SOT-23-6; MPN MCP4725A0T-E/CH

Connections:
+3V3: C600.1, C612.1, C613.1, C615.1, R612.1, U600.6 (VCC), U610.5 (V+), U611.5 (VCC), U612.3 (VDD); also elsewhere on the board
/Isolated trigger input and photodiode front end/PHOTO_CMP: R615.1, R616.1, U611.1 (OUT)
/Isolated trigger input and photodiode front end/PHOTO_DAC: R617.1, U612.1 (VOUT)
/Isolated trigger input and photodiode front end/PHOTO_HYS: R614.2, R615.2, U611.3 (IN+)
/Isolated trigger input and photodiode front end/PHOTO_K_RAW: D601.1 (IO1), D601.2 (IO2), J601.1, R610.1
/Isolated trigger input and photodiode front end/PHOTO_REF: C611.1, R612.2, R613.1, U610.3 (IN+)
/Isolated trigger input and photodiode front end/PHOTO_SUM: C610.1, R610.2, R611.1, U610.4 (IN-)
/Isolated trigger input and photodiode front end/PHOTO_THRESH: C614.1, R617.2, U611.4 (IN-)
/Isolated trigger input and photodiode front end/TRIG_ISO_IN: J600.1 (SIG), R600.1
/Isolated trigger input and photodiode front end/TRIG_ISO_RTN: D600.2 (A), J600.2 (SHELL), J600.3 (SHELL), J600.4 (SHELL), U600.3 (K)
/Isolated trigger input and photodiode front end/TRIG_LED_A: D600.1 (K), R600.2, U600.1 (A)
/Isolated trigger input and photodiode front end/TRIG_OPTO_OUT: R601.1, U600.5 (VO)
GND: C600.2, C611.2, C612.2, C613.2, C614.2, C615.2, D601.3 (GND), J601.2, R613.2, U600.4 (GND), U610.2 (V-), U611.2 (VEE), U612.2 (VSS), U612.6 (A0); also elsewhere on the board
PHOTO_EDGE: R616.2; also elsewhere on the board
PHOTO_MONITOR: C610.2, R611.2, R614.1, U610.1 (OUT); also elsewhere on the board
POWER_SCL: U612.5 (SCL); also elsewhere on the board
POWER_SDA: U612.4 (SDA); also elsewhere on the board
TRIGGER_ISO: R601.2; also elsewhere on the board

Notes on the sheet:
EVENT INPUTS - EDGES TIMESTAMPED BY THE MCU TIMER (GPIOTE + PPI), SAME PATH AS ADC DRDY
Isolated trigger input
3.0-5.0 V logic lights the TLP2761 LED through 620R; D600 clamps reverse polarity. Output to TRIGGER_ISO for timer capture.
Photodiode transimpedance amplifier
Passive photodiode into TLV9061, 33k || 15 pF feedback; output also to SAADC (PHOTO_MONITOR) for threshold calibration.
Edge comparator
TLV7011 with 1M hysteresis feedback drives PHOTO_EDGE for timer capture.
Threshold DAC
MCP4725 on the power I2C bus (0x60) sets the comparator threshold through a 1k/100 nF filter.
Sheet notes
ISOLATION BARRIER: J600, R600, D600 and U600 pins 1-3 are the isolated side. Keep >= 8 mm creepage and clearance to all other copper (slot under U600). J600 shell is not board GND.
Trigger input 3.0-5.0 V logic, active high, 2-6 mA LED current. U600 inverts: trigger high gives TRIGGER_ISO low; firmware captures both edges.
Photodiode: passive sensor only (e.g. BPW34). Not isolated: treat as participant-side like the electrodes. TIA Vout = 50 mV + Iph x 33k; DAC POR code 0 = no edges until calibrated.

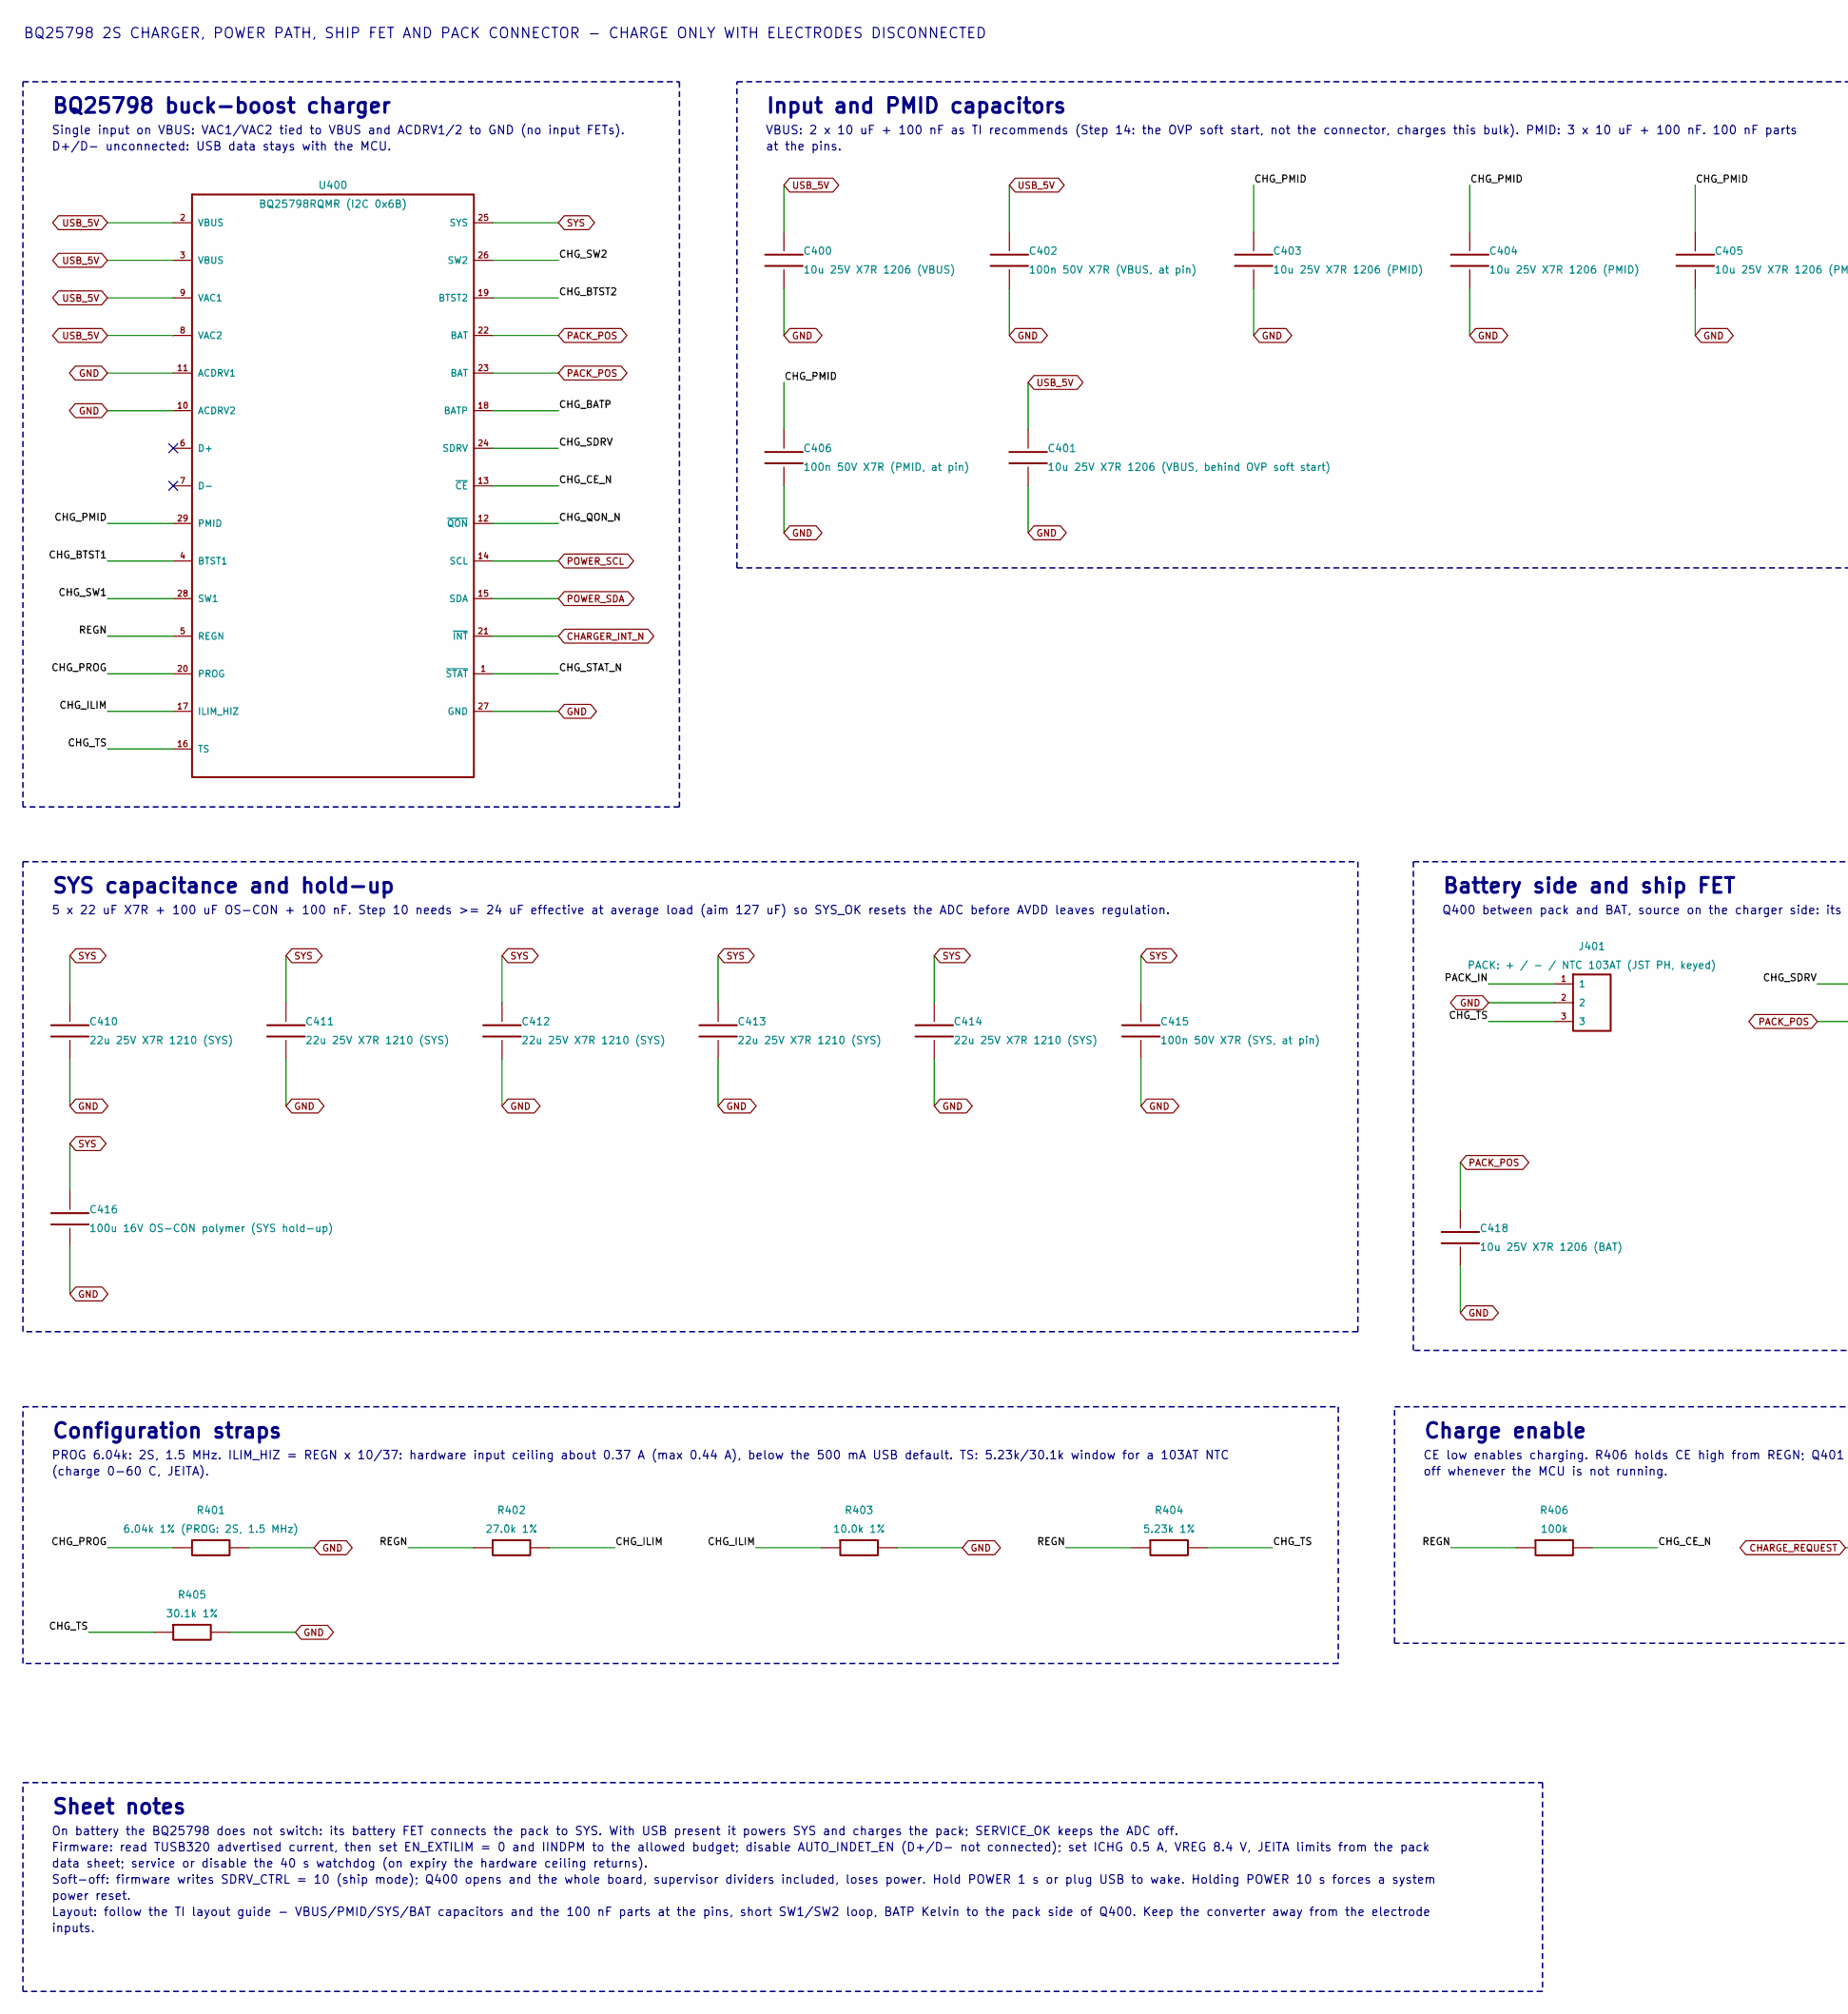
[picture p32: schematic charger.kicad_sch, BQ25798 charger, power path and pack connector, part in row 1, column 1]

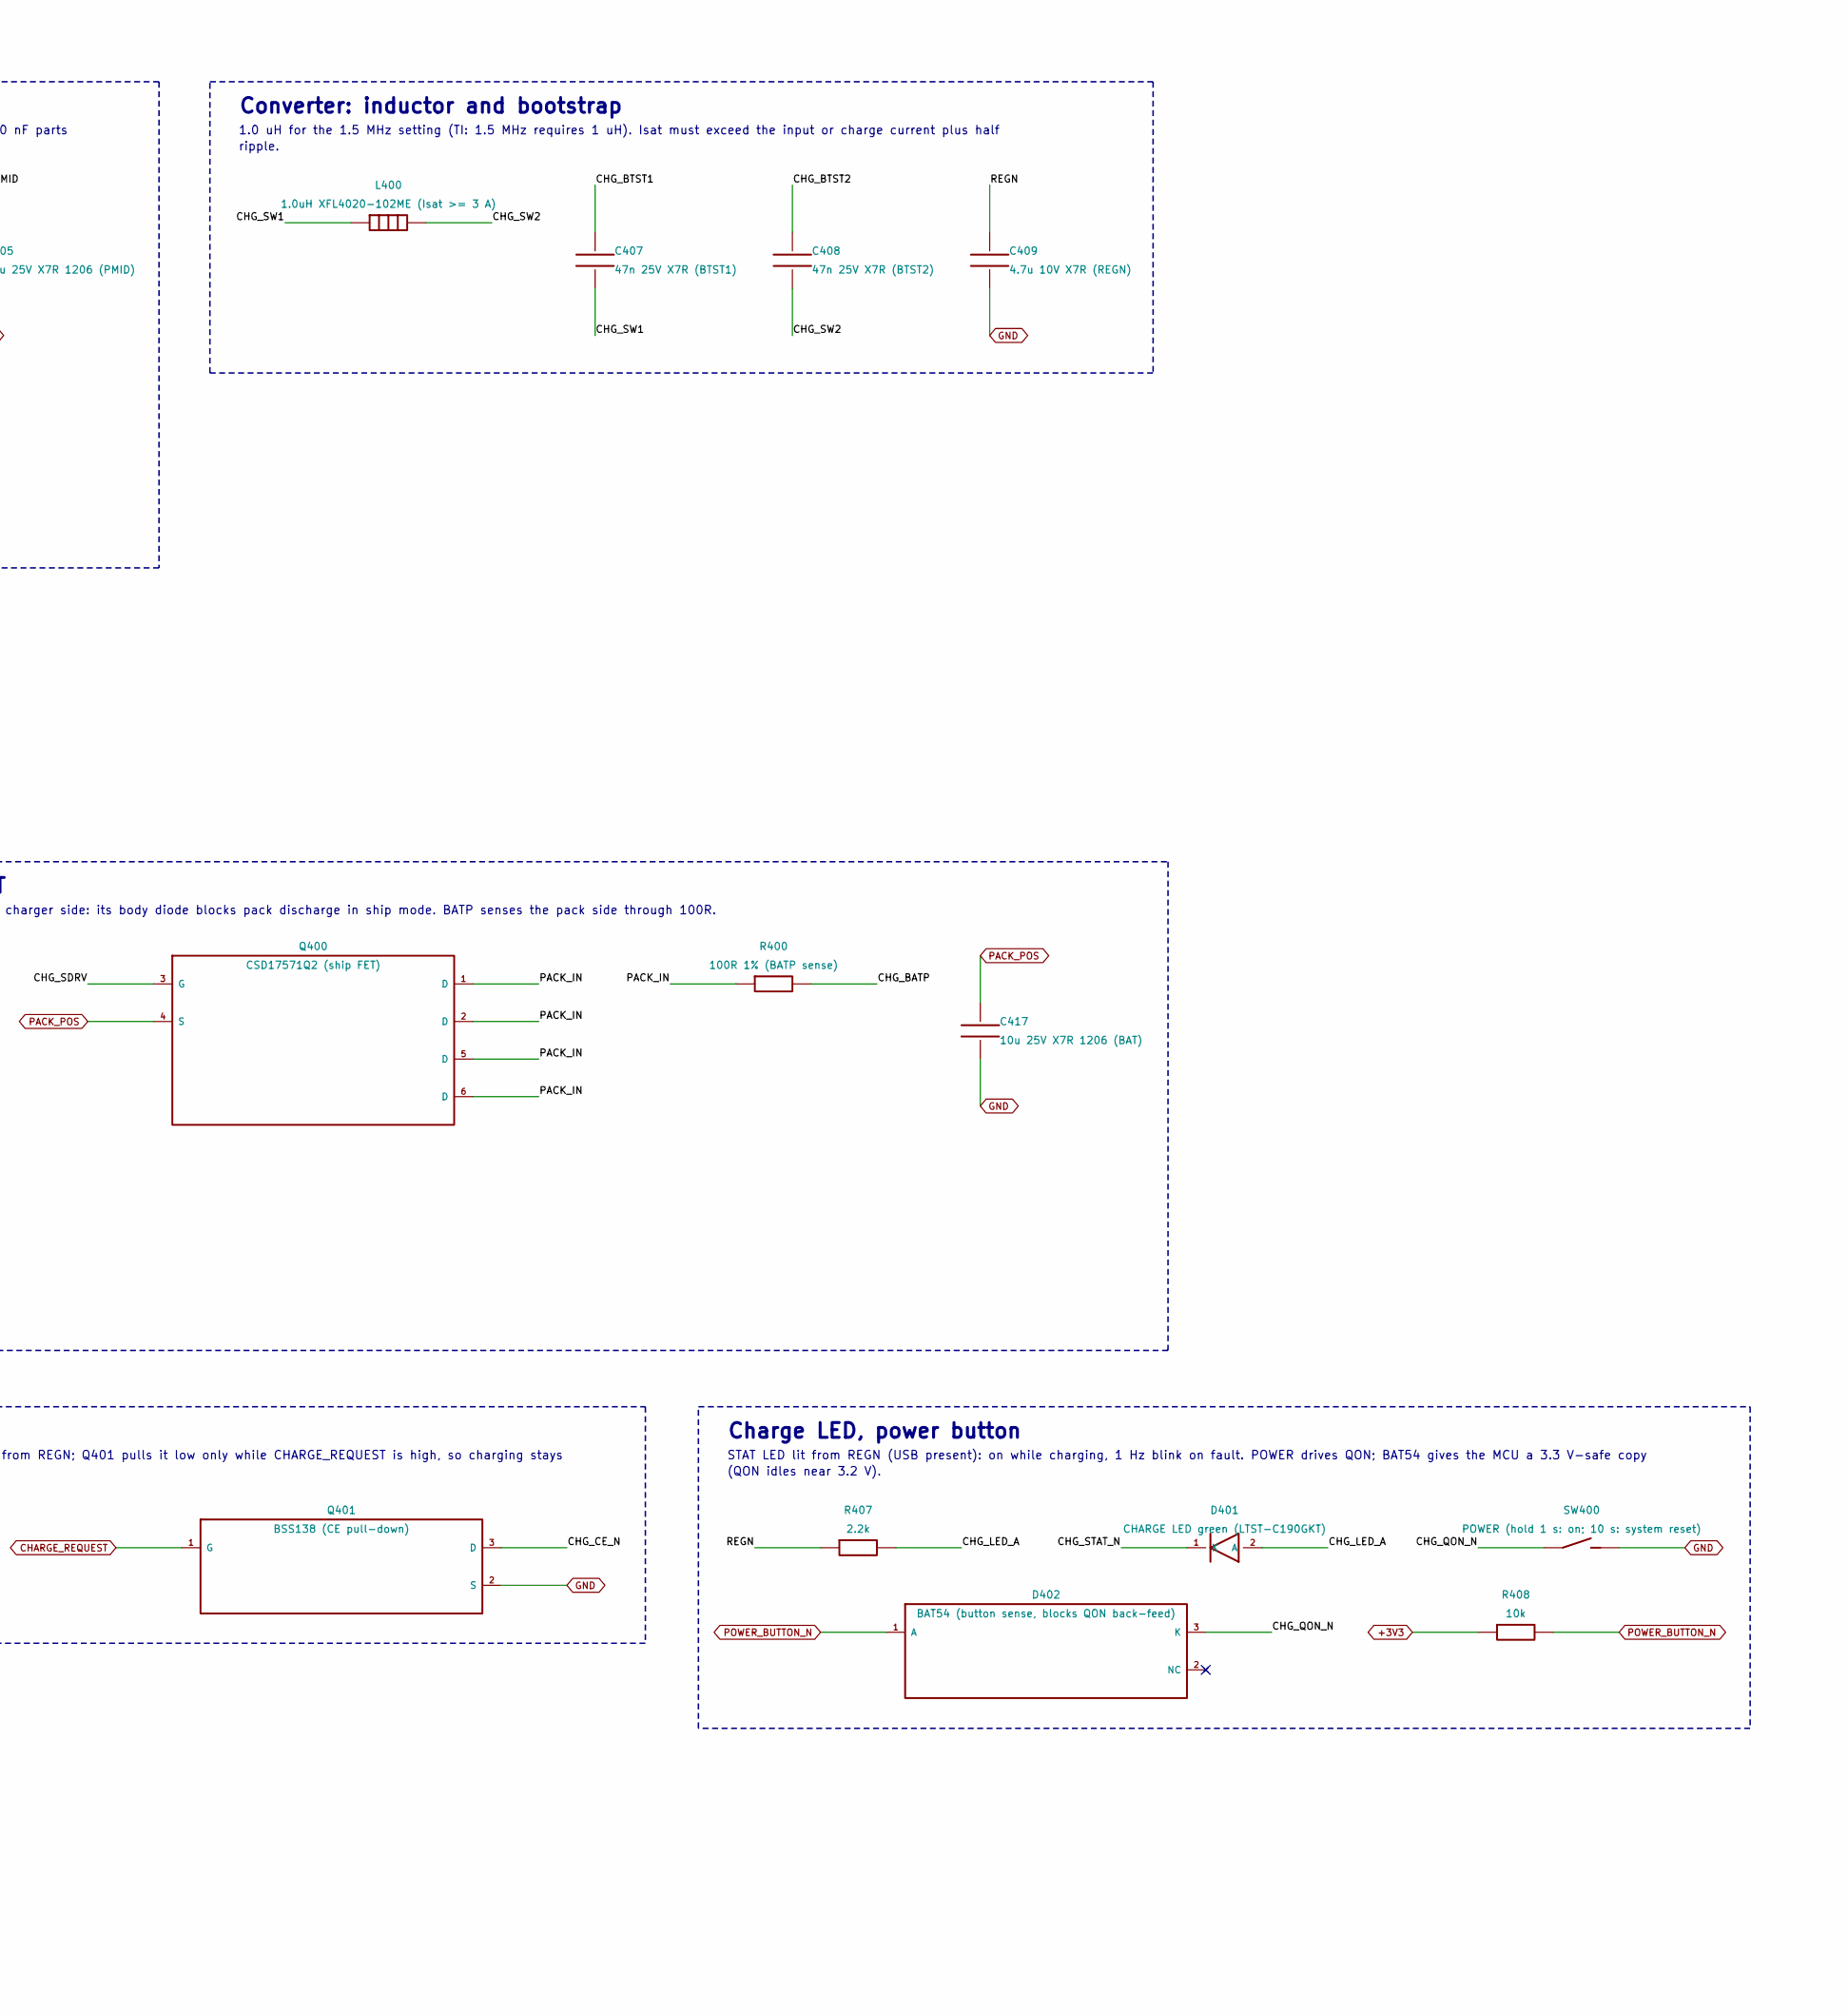
[picture p33: schematic charger.kicad_sch, BQ25798 charger, power path and pack connector, part in row 1, column 2]

Parts:
C400: 10u 25V X7R 1206 (VBUS); C_1206_3216Metric; MPN GRM31CR71E106KA12L
C401: 10u 25V X7R 1206 (VBUS, behind OVP soft start); C_1206_3216Metric; MPN GRM31CR71E106KA12L
C402: 100n 50V X7R (VBUS, at pin); C_0603_1608Metric; MPN GCM188R71H104KA57D
C403, C404, C405: 10u 25V X7R 1206 (PMID); C_1206_3216Metric; MPN GRM31CR71E106KA12L
C406: 100n 50V X7R (PMID, at pin); C_0603_1608Metric; MPN GCM188R71H104KA57D
C407: 47n 25V X7R (BTST1); C_0603_1608Metric; MPN GCM188R71H473KA55D
C408: 47n 25V X7R (BTST2); C_0603_1608Metric; MPN GCM188R71H473KA55D
C409: 4.7u 10V X7R (REGN); C_0805_2012Metric; MPN GRM21BR71C475KE51L
C410, C411, C412, C413, C414: 22u 25V X7R 1210 (SYS); C_1210_3225Metric; MPN GRM32ER71E226KE15L
C415: 100n 50V X7R (SYS, at pin); C_0603_1608Metric; MPN GCM188R71H104KA57D
C416: 100u 16V OS-CON polymer (SYS hold-up); CP_Elec_10x7.9; MPN 16SVP100M
C417, C418: 10u 25V X7R 1206 (BAT); C_1206_3216Metric; MPN GRM31CR71E106KA12L
D401: CHARGE LED green (LTST-C190GKT); LED_0603_1608Metric; MPN LTST-C190GKT
D402: BAT54 (button sense, blocks QON back-feed); SOT-23; MPN BAT54,215
J401: PACK: + / - / NTC 103AT (JST PH, keyed); JST_PH_S3B-PH-K_1x03_P2.00mm_Horizontal; MPN S3B-PH-K-S
L400: 1.0uH XFL4020-102ME (Isat >= 3 A); L_Coilcraft_XxL4020; MPN XFL4020-102MEC
Q400: CSD17571Q2 (ship FET); Texas_DQK_SON-6_2x2mm_CSD17571Q2; MPN CSD17571Q2
Q401: BSS138 (CE pull-down); SOT-23; MPN BSS138
R400: 100R 1% (BATP sense); R_0603_1608Metric; MPN ERJ-3EKF1000V
R401: 6.04k 1% (PROG: 2S, 1.5 MHz); R_0603_1608Metric; MPN ERJ-3EKF6041V
R402: 27.0k 1%; R_0603_1608Metric; MPN ERJ-3EKF2702V
R403: 10.0k 1%; R_0603_1608Metric; MPN ERJ-3EKF1002V
R404: 5.23k 1%; R_0603_1608Metric; MPN ERJ-3EKF5231V
R405: 30.1k 1%; R_0603_1608Metric; MPN ERJ-3EKF3012V
R406: 100k; R_0603_1608Metric; MPN ERJ-3EKF1003V
R407: 2.2k; R_0603_1608Metric; MPN ERJ-3EKF2201V
R408: 10k; R_0603_1608Metric; MPN ERJ-3EKF1002V
SW400: POWER (hold 1 s: on; 10 s: system reset); SW_SPST_TL3342; MPN TL3342F160QG
U400: BQ25798RQMR (I2C 0x6B); Texas_RQM0029A_VQFN-HR-29_4x4mm; MPN BQ25798RQMR

Connections:
+3V3: R408.1; also elsewhere on the board
/BQ25798 charger, power path and pack connector/CHG_BATP: R400.2, U400.18 (BATP)
/BQ25798 charger, power path and pack connector/CHG_BTST1: C407.1, U400.4 (BTST1)
/BQ25798 charger, power path and pack connector/CHG_BTST2: C408.1, U400.19 (BTST2)
/BQ25798 charger, power path and pack connector/CHG_CE_N: Q401.3 (D), R406.2, U400.13 (~CE)
/BQ25798 charger, power path and pack connector/CHG_ILIM: R402.2, R403.1, U400.17 (ILIM_HIZ)
/BQ25798 charger, power path and pack connector/CHG_LED_A: D401.2 (A), R407.2
/BQ25798 charger, power path and pack connector/CHG_PMID: C403.1, C404.1, C405.1, C406.1, U400.29 (PMID)
/BQ25798 charger, power path and pack connector/CHG_PROG: R401.1, U400.20 (PROG)
/BQ25798 charger, power path and pack connector/CHG_QON_N: D402.3 (K), SW400.1, U400.12 (~QON)
/BQ25798 charger, power path and pack connector/CHG_SDRV: Q400.3 (G), U400.24 (SDRV)
/BQ25798 charger, power path and pack connector/CHG_STAT_N: D401.1 (K), U400.1 (~STAT)
/BQ25798 charger, power path and pack connector/CHG_SW1: C407.2, L400.1, U400.28 (SW1)
/BQ25798 charger, power path and pack connector/CHG_SW2: C408.2, L400.2, U400.26 (SW2)
/BQ25798 charger, power path and pack connector/CHG_TS: J401.3, R404.2, R405.1, U400.16 (TS)
/BQ25798 charger, power path and pack connector/PACK_IN: J401.1, Q400.1 (D), Q400.2 (D), Q400.5 (D), Q400.6 (D), R400.1
/BQ25798 charger, power path and pack connector/REGN: C409.1, R402.1, R404.1, R406.1, R407.1, U400.5 (REGN)
CHARGER_INT_N: U400.21 (~INT); also elsewhere on the board
CHARGE_REQUEST: Q401.1 (G); also elsewhere on the board
GND: C400.2, C401.2, C402.2, C403.2, C404.2, C405.2, C406.2, C409.2, C410.2, C411.2, C412.2, C413.2, C414.2, C415.2, C416.2, C417.2, C418.2, J401.2, Q401.2 (S), R401.2, R403.2, R405.2, SW400.2, U400.10 (ACDRV2), U400.11 (ACDRV1), U400.27 (GND); also elsewhere on the board
PACK_POS: C417.1, C418.1, Q400.4 (S), U400.22 (BAT), U400.23 (BAT); also elsewhere on the board
POWER_BUTTON_N: D402.1 (A), R408.2; also elsewhere on the board
POWER_SCL: U400.14 (SCL); also elsewhere on the board
POWER_SDA: U400.15 (SDA); also elsewhere on the board
SYS: C410.1, C411.1, C412.1, C413.1, C414.1, C415.1, C416.1, U400.25 (SYS); also elsewhere on the board
USB_5V: C400.1, C401.1, C402.1, U400.2 (VBUS), U400.3 (VBUS), U400.8 (VAC2), U400.9 (VAC1); also elsewhere on the board

Notes on the sheet:
BQ25798 2S CHARGER, POWER PATH, SHIP FET AND PACK CONNECTOR - CHARGE ONLY WITH ELECTRODES DISCONNECTED
BQ25798 buck-boost charger
Single input on VBUS: VAC1/VAC2 tied to VBUS and ACDRV1/2 to GND (no input FETs).
D+/D- unconnected: USB data stays with the MCU.
Input and PMID capacitors
VBUS: 2 x 10 uF + 100 nF as TI recommends (Step 14: the OVP soft start, not the connector, charges this bulk). PMID: 3 x 10 uF + 100 nF. 100 nF parts
at the pins.
Converter: inductor and bootstrap
1.0 uH for the 1.5 MHz setting (TI: 1.5 MHz requires 1 uH). Isat must exceed the input or charge current plus half
ripple.
SYS capacitance and hold-up
5 x 22 uF X7R + 100 uF OS-CON + 100 nF. Step 10 needs >= 24 uF effective at average load (aim 127 uF) so SYS_OK resets the ADC before AVDD leaves regulation.
Battery side and ship FET
Q400 between pack and BAT, source on the charger side: its body diode blocks pack discharge in ship mode. BATP senses the pack side through 100R.
Configuration straps
PROG 6.04k: 2S, 1.5 MHz. ILIM_HIZ = REGN x 10/37: hardware input ceiling about 0.37 A (max 0.44 A), below the 500 mA USB default. TS: 5.23k/30.1k window for a 103AT NTC
(charge 0-60 C, JEITA).
Charge enable
CE low enables charging. R406 holds CE high from REGN; Q401 pulls it low only while CHARGE_REQUEST is high, so charging stays
off whenever the MCU is not running.
Charge LED, power button
STAT LED lit from REGN (USB present): on while charging, 1 Hz blink on fault. POWER drives QON; BAT54 gives the MCU a 3.3 V-safe copy
(QON idles near 3.2 V).
Sheet notes
On battery the BQ25798 does not switch: its battery FET connects the pack to SYS. With USB present it powers SYS and charges the pack; SERVICE_OK keeps the ADC off.
Firmware: read TUSB320 advertised current, then set EN_EXTILIM = 0 and IINDPM to the allowed budget; disable AUTO_INDET_EN (D+/D- not connected); set ICHG 0.5 A, VREG 8.4 V, JEITA limits from the pack
data sheet; service or disable the 40 s watchdog (on expiry the hardware ceiling returns).
Soft-off: firmware writes SDRV_CTRL = 10 (ship mode); Q400 opens and the whole board, supervisor dividers included, loses power. Hold POWER 1 s or plug USB to wake. Holding POWER 10 s forces a system
power reset.
Layout: follow the TI layout guide - VBUS/PMID/SYS/BAT capacitors and the 100 nF parts at the pins, short SW1/SW2 loop, BATP Kelvin to the pack side of Q400. Keep the converter away from the electrode
inputs.

Board: 4 copper layers, 381 parts (0 on the bottom side), 235 nets, no tracks yet.

Other parts of the board:
H1, H2, H3, H4: M3; MountingHole_3.2mm_M3
