MariusFauteux/EEG-PCB/hardware/scripts/pcb_place.py

"""Step 14 (Rev C11): generate hardware/EEG_RevC.kicad_pcb from checks/netlist.xml - outline, stack-up, rules,
netclasses, keep-outs, plane zones and the placement of every on-board part. No tracks (routing is Step 15).

Run with KiCad's own Python (it needs the pcbnew module), as hardware/rebuild.sh does:
  /Applications/KiCad/KiCad.app/Contents/Frameworks/Python.framework/Versions/Current/bin/python3 scripts/pcb_place.py

Every footprint comes from the netlist (the audited footprint of Step 13/14) and carries the symbol's KIID path, so
"Update PCB from Schematic" in KiCad matches every part without re-association. Writes the board, the project's
board and net settings (EEG_RevC.kicad_pro), custom rules (EEG_RevC.kicad_dru) and checks/placement.json.

Sources for the rules (read 2026-11-08; details in docs/reviews/step14_ovp_placement_review.md):
  JLCPCB PCB capabilities (jlcpcb.com/capabilities/pcb-capabilities) and 4-layer stack-up JLC04161H-3313
  (jlcpcb.com/impedance); u-blox UBX-17056748 R15 section 3.3.3 (NINA-B3x6 antenna placement); TI SLUSDV2C (BQ25798),
  SLVSAM3 (TPS62162), SLVSCF6F (TPD1S514), SBAS499C (ADS1299) layout sections; Analog Devices LT3045 layout notes as
  recorded in the Step 4 review (data sheet not re-downloadable).
"""
from pathlib import Path
import xml.etree.ElementTree as ET
import json, math, os, re, sys
import pcbnew

HW = Path(__file__).resolve().parents[1]; CHECKS = HW / 'checks'
PCB = HW / 'EEG_RevC.kicad_pcb'; PRO = HW / 'EEG_RevC.kicad_pro'; DRU = HW / 'EEG_RevC.kicad_dru'
STOCK = Path(os.environ.get('KICAD10_FOOTPRINT_DIR', '/Applications/KiCad/KiCad.app/Contents/SharedSupport/footprints'))
OX, OY = 50.0, 40.0                 # board origin on the page (mm); all coordinates below are board-local
W, H, R_CORNER = 110.0, 85.0, 3.0   # D56: one-sided 110 x 85 mm board
mm = pcbnew.FromMM
def V(x, y): return pcbnew.VECTOR2I(mm(OX + x), mm(OY + y))
def L(v): return (pcbnew.ToMM(v.x) - OX, pcbnew.ToMM(v.y) - OY)

# ------------------------------------------------------------------ netlist
root = ET.parse(CHECKS / 'netlist.xml').getroot()
comps = {}
for c in root.findall('.//components/comp'):
    props = {p.get('name'): p.get('value') for p in c.findall('property')}
    if 'exclude_from_board' in props:
        continue
    sp = c.find('sheetpath')
    comps[c.get('ref')] = dict(value=c.findtext('value') or '', fp=c.findtext('footprint') or '', sheet=props.get('Sheetfile', '').replace('.kicad_sch', ''),
                               path=sp.get('tstamps') + (c.findtext('tstamps') or '').split()[0] if sp is not None else '', bom='exclude_from_bom' not in props,
                               mpn=(c.find("fields/field[@name='MPN']").text if c.find("fields/field[@name='MPN']") is not None else '') or '',
                               fields={f.get('name'): f.text or '' for f in c.findall('fields/field') if f.get('name') in ('MPN', 'Manufacturer', 'Description')})
# KiCad writes a '/' inside a sheet name as '{slash}' in board net names; the XML netlist does not escape it.
titles = sorted({sp.get('names') for sp in root.findall('.//components/comp/sheetpath')} - {'/'}, key=len, reverse=True)
def board_net(name):
    for t in titles:
        if name.startswith(t) and t.count('/') > 2:
            return '/' + t[1:-1].replace('/', '{slash}') + '/' + name[len(t):]
    return name
nets = {}; pinnet = {}; pintype = {}
for n in root.findall('.//nets/net'):
    name = board_net(n.get('name')); nets[name] = [(x.get('ref'), x.get('pin')) for x in n.findall('node')]
    pintype.update({(x.get('ref'), x.get('pin')): x.get('pintype') or '' for x in n.findall('node')})
    for r, p in nets[name]:
        pinnet[(r, p)] = name
short = lambda n: n.split('/')[-1]

# ------------------------------------------------------------------ board, layers, stack-up placeholder
board = pcbnew.NewBoard(str(PCB))
board.SetCopperLayerCount(4)
for lay, name, kind in [(pcbnew.F_Cu, 'F.Cu', pcbnew.LT_SIGNAL), (pcbnew.In1_Cu, 'In1.Cu', pcbnew.LT_POWER), (pcbnew.In2_Cu, 'In2.Cu', pcbnew.LT_POWER), (pcbnew.B_Cu, 'B.Cu', pcbnew.LT_SIGNAL)]:
    board.SetLayerType(lay, kind)
tb = board.GetTitleBlock(); tb.SetTitle('EEG recorder Rev C12 - placement (Step 14)'); tb.SetRevision('C12'); tb.SetDate('2026-11-08')
tb.SetComment(0, '8-channel ADS1299, NINA-B306, microSD, USB-C charging. Bench draft, no human connection.'); tb.SetComment(1, 'Placed, not routed. Generated by scripts/pcb_place.py.')
ds = board.GetDesignSettings()
# JLCPCB multilayer capabilities: 0.09/0.09 mm track/space (0.10 used), via 0.15/0.25 mm minimum (0.25/0.5 standard),
# via hole to track 0.2 mm, via hole-to-hole 0.2 mm, copper to routed edge 0.2 mm (0.3 used), soldermask bridge
# 0.10 mm (green), legend line >= 0.15 mm and text >= 1.0 mm, pad to silkscreen 0.15 mm.
ds.m_MinClearance = mm(0.10); ds.m_TrackMinWidth = mm(0.10); ds.m_ViasMinSize = mm(0.25); ds.m_MinThroughDrill = mm(0.15)
ds.m_ViasMinAnnularWidth = mm(0.05); ds.m_HoleClearance = mm(0.20); ds.m_HoleToHoleMin = mm(0.25); ds.m_CopperEdgeClearance = mm(0.30)
ds.m_SilkClearance = mm(0.15); ds.m_MinSilkTextHeight = mm(1.0); ds.m_MinSilkTextThickness = mm(0.15)
ds.m_SolderMaskExpansion = mm(0.0); ds.m_SolderMaskMinWidth = mm(0.10); ds.m_SolderMaskToCopperClearance = mm(0.0)
ds.m_AllowSoldermaskBridgesInFPs = True    # 0.4 mm pitch WCSP/X2QFN webs fall below 0.10 mm; JLCPCB gangs them (review 4.3)
ds.SetBoardThickness(mm(1.6))

# ------------------------------------------------------------------ nets and footprints
netinfo = {}
for name in sorted(nets):
    ni = pcbnew.NETINFO_ITEM(board, name); board.Add(ni); netinfo[name] = ni
FP, CRT = {}, {}                      # ref -> footprint; ref -> local courtyard box at the current rotation
def lib_path(lib): return str(HW / 'EEG.pretty') if lib == 'EEG' else str(STOCK / f'{lib}.pretty')
for ref, c in sorted(comps.items()):
    lib, name = c['fp'].split(':')
    f = pcbnew.FootprintLoad(lib_path(lib), name)
    assert f is not None, (ref, c['fp'])
    f.SetFPID(pcbnew.LIB_ID(lib, name)); f.SetReference(ref); f.SetValue(c['value'])
    if c['path']:
        f.SetPath(pcbnew.KIID_PATH(c['path']))
    f.SetSheetfile(c['sheet'] + '.kicad_sch')
    for k, v in c['fields'].items():                  # symbol fields, so a schematic-parity DRC finds no field mismatch
        f.SetField(k, v)
        if f.GetField(k): f.GetField(k).SetVisible(False)
    if not c['bom']:
        f.SetExcludedFromBOM(True)
    for p in f.Pads():
        n = pinnet.get((ref, p.GetNumber()))
        if n:
            p.SetNet(netinfo[n])
    # Dense board: reference designators go to the assembly (F.Fab) layer; the silkscreen keeps footprint outlines,
    # pin-1 marks and free-standing labels for connectors and buttons, placed clear of every courtyard.
    rt = f.Reference()
    rt.SetLayer(pcbnew.F_Fab)                     # all designators on the assembly layer; silk labels added after placement
    rt.SetTextSize(pcbnew.VECTOR2I(mm(1.0), mm(1.0))); rt.SetTextThickness(mm(0.15))
    f.Value().SetVisible(False)
    board.Add(f); FP[ref] = f
for i, (x, y) in enumerate([(3.5, 3.5), (W - 3.5, 3.5), (3.5, H - 3.5), (W - 3.5, H - 3.5)], 1):
    f = pcbnew.FootprintLoad(lib_path('MountingHole'), 'MountingHole_3.2mm_M3')
    f.SetFPID(pcbnew.LIB_ID('MountingHole', 'MountingHole_3.2mm_M3')); f.SetReference(f'H{i}'); f.SetValue('M3')
    f.SetBoardOnly(True); f.SetExcludedFromBOM(True); f.SetExcludedFromPosFiles(True); f.Value().SetVisible(False); f.Reference().SetLayer(pcbnew.F_Fab)
    board.Add(f); FP[f'H{i}'] = f; comps[f'H{i}'] = dict(value='M3', fp='MountingHole:MountingHole_3.2mm_M3', sheet='board', path='', bom=False, mpn='')

def courtyard_local(ref):
    """Courtyard bounding box relative to the footprint origin, at its current orientation."""
    f = FP[ref]; pos = f.GetPosition(); xs, ys = [], []
    for g in f.GraphicalItems():
        if g.GetLayer() == pcbnew.F_CrtYd:
            bb = g.GetBoundingBox(); xs += [bb.GetLeft(), bb.GetRight()]; ys += [bb.GetTop(), bb.GetBottom()]
    if not xs:
        for p in f.Pads():
            bb = p.GetBoundingBox(); xs += [bb.GetLeft() - mm(0.25), bb.GetRight() + mm(0.25)]; ys += [bb.GetTop() - mm(0.25), bb.GetBottom() + mm(0.25)]
    return (pcbnew.ToMM(min(xs) - pos.x), pcbnew.ToMM(min(ys) - pos.y), pcbnew.ToMM(max(xs) - pos.x), pcbnew.ToMM(max(ys) - pos.y))

# ------------------------------------------------------------------ floor plan (board-local mm, x right, y down)
ISO = (26.25, 0.0, 41.75, 20.0)                    # isolated trigger side: J600, R600, D600, U600 pins 1-3
BARRIER = 8.0                                     # D36: 8 mm creepage and clearance
ISO_OUT = (ISO[0] - BARRIER, 0.0, ISO[2] + BARRIER, ISO[3] + BARRIER)
ANT = (105.7, 37.5, 110.0, 47.5)                  # NINA-B306 antenna section after placement (checked below)
ANT_ZONE = (ANT[0] - 10.0, ANT[1] - 10.0, W, ANT[3] + 10.0)   # UBX-17056748 3.3.3: no high/large metal parts within 10 mm
ZONES = {   # name: (rect, purpose)
    'analogue': ((0.0, 29.0, 62.0, 85.0), 'Electrode inputs, REF/BIAS, ADS1299 and its decoupling, LT3045 +5VA'),
    'digital': ((46.0, 0.0, 95.0, 62.0), 'microSD, supervisors and logic, ADC interface, clock, buck'),
    'module': ((92.0, 18.0, W, 60.0), 'NINA-B306 at the centre of the right edge, antenna outwards'),
    'power': ((60.0, 60.0, W, H), 'USB-C, overvoltage switch, BQ25798 charger, pack connector, SYS hold-up'),
    'event': ((0.0, 0.0, ISO_OUT[0], 29.0), 'Photodiode connector and TIA, outside the trigger barrier'),
}
LARGE = re.compile(r'^(J\d+|SW\d+|L\d+|C416|C116|Y\d+|H\d)$')   # parts kept out of the antenna zone
ISO_PARTS = {'J600', 'R600', 'D600'}

placed = {}                        # ref -> absolute courtyard box
def box_at(ref, x, y):
    a = CRT[ref]; return (x + a[0], y + a[1], x + a[2], y + a[3])
def overlap(a, b, gap=0.05):
    return not (a[2] + gap <= b[0] or b[2] + gap <= a[0] or a[3] + gap <= b[1] or b[3] + gap <= a[1])
def inside(a, r): return a[0] >= r[0] and a[1] >= r[1] and a[2] <= r[2] and a[3] <= r[3]
def legal(ref, b, edge=True):
    if edge and not inside(b, (0.3, 0.3, W - 0.3, H - 0.3)):
        return False
    if ref not in ISO_PARTS and ref != 'U600' and overlap(b, ISO_OUT, 0.0):
        return False
    if LARGE.match(ref) and overlap(b, ANT_ZONE, 0.0) and ref != 'U300':
        return False
    return not any(overlap(b, o, 0.15) for r, o in placed.items() if r != ref)   # 0.15 mm keeps neighbouring silk outlines apart

def orient(ref, rot):
    f = FP[ref]; f.SetPosition(V(0, 0)); f.SetOrientationDegrees(rot); CRT[ref] = courtyard_local(ref)
def commit(ref, x, y):
    FP[ref].SetPosition(V(x, y)); placed[ref] = box_at(ref, x, y)
def put(ref, x, y, rot=0, force=False):
    """Fixed placement (connectors, ICs). force=True allows a courtyard outside the board (edge connectors)."""
    orient(ref, rot); b = box_at(ref, x, y)
    hits = [r for r, o in placed.items() if overlap(b, o)]
    if not force:
        assert legal(ref, b), f'{ref} fixed placement at ({x}, {y}) box {[round(v, 2) for v in b]} is not legal (overlaps {hits})'
    else:
        assert not hits, f'{ref} fixed placement box {[round(v, 2) for v in b]} overlaps {hits}'
    commit(ref, x, y)

def spiral(ref, x0, y0, region=None, rmax=14.0, step=0.25):
    """Nearest legal position to (x0, y0), searched on a 0.25 mm grid outward to rmax, inside region if given."""
    best = None
    n = int(rmax / step)
    cand = sorted(((i * step) ** 2 + (j * step) ** 2, i, j) for i in range(-n, n + 1) for j in range(-n, n + 1) if (i * i + j * j) * step * step <= rmax * rmax)
    for _, i, j in cand:
        x, y = x0 + i * step, y0 + j * step; b = box_at(ref, x, y)
        if region and not inside(b, region):
            continue
        if legal(ref, b):
            return x, y
    return best
FALLBACK = []
def place_near_point(ref, x0, y0, rots=(0, 90, 180, 270), region=None, anchor_pad=None, rmax=14.0):
    """Try each rotation, pick the legal position closest to the target; ties go to the rotation that puts the pad
    sharing anchor_pad's net nearest to that pad."""
    best = None
    for rot in rots:
        orient(ref, rot)
        p = spiral(ref, x0, y0, region, rmax)
        if p is None:
            continue
        d = math.hypot(p[0] - x0, p[1] - y0)
        if anchor_pad is not None:
            FP[ref].SetPosition(V(*p))
            mine = [q for q in FP[ref].Pads() if q.GetNetname() == anchor_pad.GetNetname()]
            if mine:
                d += 0.5 * min(math.dist(L(q.GetPosition()), L(anchor_pad.GetPosition())) for q in mine)
        if best is None or d < best[0] - 1e-9:
            best = (d, rot, p)
    if best is None:
        if region is not None or rmax < 30:          # fall back: any legal spot within 30 mm, recorded in the report
            FALLBACK.append(ref)
            return place_near_point(ref, x0, y0, rots, None, anchor_pad, 30.0)
        raise SystemExit(f'placement failed for {ref} near ({x0:.1f}, {y0:.1f})')
    orient(ref, best[1]); commit(ref, *best[2])

def pad(ref, num):
    return next(p for p in FP[ref].Pads() if p.GetNumber() == str(num))
def near_pad(ref, anchor, num, out=1.6, region=None, rmax=14.0):
    """Place ref just outside anchor's pad num, on the side the pad faces (decoupling 'at the pin')."""
    p = pad(anchor, num); px, py = L(p.GetPosition()); cx, cy = L(FP[anchor].GetPosition())
    dx, dy = px - cx, py - cy
    if abs(dx) >= abs(dy): ux, uy = (1 if dx > 0 else -1), 0
    else: ux, uy = 0, (1 if dy > 0 else -1)
    place_near_point(ref, px + ux * out, py + uy * out, region=region, anchor_pad=p, rmax=rmax)

# ------------------------------------------------------------------ 1. mounting holes and edge connectors
for i, (x, y) in enumerate([(3.5, 3.5), (W - 3.5, 3.5), (3.5, H - 3.5), (W - 3.5, H - 3.5)], 1):
    orient(f'H{i}', 0); commit(f'H{i}', x, y)
put('J500', 9.5, 67.0, 180)                       # electrode harness, left edge; pin 1 (CH1+) at the bottom
put('J600', 34.0, 14.5, 0, force=True)            # BNC trigger, top edge; body front (Fab -14.5) on the edge
put('J601', 13.0, 6.3, 180, force=True)           # photodiode JST PH, top edge, wire entry outwards
put('J420', 60.0, 8.8, 180, force=True)           # microSD, top edge; card slot outwards, shell pad 0.47 mm from edge
for ref, x in [('SW300', 75.5), ('SW301', 85.0), ('SW302', 94.5)]:
    put(ref, x, 3.5, 0)                           # RESET, RECOVERY, RECORD along the top edge
put('J301', 103.7, 13.0, 90, force=True)          # service interlock JST PH, right edge, above the antenna zone
put('U300', 102.2, 42.5, 90, force=True)                      # NINA-B306, centre of the right edge, antenna (+y in the footprint) outwards
eagp = [L(p.GetPosition()) for p in FP['U300'].Pads() if p.GetNumber() == 'EAGP']
assert min(x for x, _ in eagp) > 105.5 and max(x for x, _ in eagp) < W - 0.5, ('antenna end not at the right edge', eagp)
put('J310', 106.27, 72.0, 90, force=True)         # USB-C, right edge
put('J401', 88.0, 78.7, 0, force=True)            # pack JST PH 3-pin, bottom edge
put('SW400', 80.0, 81.5, 0)                       # POWER, bottom edge
put('J300', 88.0, 22.0, 0)                        # SWD header next to the module
put('U323', 97.0, 70.0, 0)                        # TPD1S514-1 at the J310 VBUS contacts (TI: as close to the connector as possible)
put('U400', 85.0, 66.5, 180)                      # BQ25798 rotated: PMID/SW1/GND/SW2/SYS row (top of the TI land pattern) faces L400, VBUS faces the USB side
put('L400', 85.0, 73.0, 0)                        # SW1-SW2 inductor straight below the switch-node pins
put('C416', 67.5, 79.0, 0)                        # SYS OS-CON hold-up between the charger and the LT3045
put('Q400', 92.5, 74.5, 0)                        # ship FET between the pack connector and BAT
for ref, num in [('C406', 29), ('C415', 25), ('C402', 2)]:
    near_pad(ref, 'U400', num, out=0.6, region=(60.0, 60.0, 101.0, H), rmax=6)   # TI: 100 nF parts at the PMID, SYS and VBUS pins first
for ref, x, y in [('C410', 80.4, 69.8), ('C411', 80.4, 75.0), ('C412', 76.9, 69.8), ('C413', 76.9, 75.0)]:
    place_near_point(ref, x, y, rots=(90,), region=(74.0, 60.0, 101.0, H), rmax=4)   # SYS bulk beside L400, on the side away from the ADC
place_near_point('C414', 76.9, 65.5, region=(74.0, 60.0, 101.0, H))
near_pad('R400', 'Q400', 1, out=1.2, region=(60.0, 60.0, 101.0, H), rmax=6)   # BATP Kelvin to the pack side of the ship FET
put('U240', 86.0, 55.0, 0)                        # TPS62162 buck: VIN/EN/AGND left, SW/VOS/FB/PG right
put('L240', 90.5, 55.0, 90)                       # TI SLVSAM3: inductor next to SW, output capacitor at the inductor

RAIL_NETS = ('+3V3', '+5VA', '+3V3_ADC', 'SYS', 'USB_5V', 'MCU_VBUS', 'REGN', 'USB_VPWR')
def gnd_caps_on(net):
    return [r for r in comps if r.startswith('C') and {short(pinnet.get((r, '1'), '')), short(pinnet.get((r, '2'), ''))} == {'GND', short(net)}]
def decouple_ic(ic, rmax=10):
    """Put one same-sheet GND capacitor at every supply pin of ic that has none within 3 mm (closest ref number first)."""
    for q in FP[ic].Pads():
        n = q.GetNetname()
        if short(n) not in RAIL_NETS or not pintype.get((ic, q.GetNumber()), '').startswith('power_in'): continue
        if [r for r in gnd_caps_on(n) if r in placed and min(math.dist(L(x.GetPosition()), L(q.GetPosition())) for x in FP[r].Pads()) <= 3.0]: continue
        free = [r for r in gnd_caps_on(n) if r not in placed and comps[r]['sheet'] == comps[ic]['sheet']]
        if not free: continue
        k = int(re.sub(r'\D', '', ic)); cap = min(free, key=lambda r: (abs(int(re.sub(r'\D', '', r)) - k), r))
        near_pad(cap, ic, q.GetNumber(), out=1.2, region=None, rmax=rmax)

# ------------------------------------------------------------------ 2. analogue: ADC, input networks, REF/BIAS
put('U1', 52.0, 58.0, 0)                          # ADS1299: inputs left, SPI right, AVDD/VCAP bottom, BIAS top-left
for ch in range(1, 9):
    y = 77.0 - 4.4 * (ch - 1)                     # CH1 band at the bottom, CH8 at the top (matches J500 and ADC pin order)
    put(f'JP{ch}', 17.0, y, 90)                   # pin 1 electrode, 2 network, 3 REF_BUF (vertical bus at x = 22.1)
    put(f'R{ch}1', 26.3, y - 1.1, 0); put(f'R{ch}2', 29.9, y - 1.1, 0)
    put(f'R{ch}3', 26.3, y + 1.1, 0); put(f'R{ch}4', 29.9, y + 1.1, 0)
    pn, nn = f'R{501 + 2 * (ch - 1)}', f'R{502 + 2 * (ch - 1)}'
    put(pn, 37.6, y - 1.1, 0); put(nn, 37.6, y + 1.1, 0)
    d = f'D{500 + ch}'
    best = None
    for rot in (0, 90, 180, 270):                 # clamp: IO1 towards the P node, IO2 towards the N node
        orient(d, rot); FP[d].SetPosition(V(33.8, y))
        s = math.dist(L(pad(d, 1).GetPosition()), (31.6, y - 1.1)) + math.dist(L(pad(d, 2).GetPosition()), (31.6, y + 1.1))
        if legal(d, box_at(d, 33.8, y)) and (best is None or s < best[0]): best = (s, rot)
    put(d, 33.8, y, best[1])
    put(f'C{ch}', 41.4, y, 90)                    # 220 pF across the pair, after the 4.7k, nearest the ADC
# REF electrode front end and buffer (row above CH8), BIAS output network (row above that).
for ref, x in [('R517', 17.0), ('R518', 20.6), ('R519', 28.4)]:
    put(ref, x, 42.6, 0)
place_near_point('D510', 24.5, 42.6)
put('U500', 33.0, 41.5, 0)
for ref, x in [('RB2', 17.0), ('RB1', 25.0)]:
    put(ref, x, 37.4, 0)
place_near_point('D509', 21.0, 37.4)
# Rev C12 impedance test links beside the J500 REF/BIAS/CH7-/CH8- pins (electrode side of the networks, short stubs).
for ref in ('JP9', 'JP10'):
    p17 = L(pad('J500', 17).GetPosition()); place_near_point(ref, p17[0], p17[1] - 14.0, region=ZONES['analogue'][0], rmax=20)
for ref in ('C500', 'C501'):
    near_pad(ref, 'U500', 5, region=ZONES['analogue'][0])
# BIAS feedback at BIASOUT/BIASINV (pins 63/61, top-left of the ADC).
for ref, num in [('RFB1', 61), ('CFB1', 63), ('RZB1', 61)]:
    near_pad(ref, 'U1', num, out=2.2, region=ZONES['analogue'][0])

# ADC decoupling and reference capacitors at their pins (TI SBAS499C layout: each pair at its pin, short return).
def pins_on(ref, net):
    return [p.GetNumber() for p in FP[ref].Pads() if p.GetNetname() == net]
used_pin = {}
def decouple(cap, ic, region, out=1.6, rmax=14.0, prefer=None):
    n1 = pinnet.get((cap, '1')); n2 = pinnet.get((cap, '2'))
    rail = n1 if short(n2 or '') == 'GND' else n2
    cands = prefer or pins_on(ic, rail)
    if not cands:
        cands = [p.GetNumber() for p in FP[ic].Pads() if any(q.GetNetname() == rail for q in FP[cap].Pads())]
    num = min(cands, key=lambda k: (used_pin.get((ic, k), 0), cands.index(k)))
    used_pin[(ic, num)] = used_pin.get((ic, num), 0) + 1
    near_pad(cap, ic, num, out=out, region=region, rmax=rmax)
    return num
A = ZONES['analogue'][0]
adc_caps = sorted([r for r, c in comps.items() if c['sheet'] == 'ads1299_core' and r.startswith('C')], key=lambda r: int(r[1:]))
small_first = [r for r in adc_caps if '0603' in comps[r]['fp']] + [r for r in adc_caps if '0603' not in comps[r]['fp']]
for cap in small_first:
    decouple(cap, 'U1', A, out=1.4 if '0603' in comps[cap]['fp'] else 2.6, rmax=16.0)
for ref, num in [('R100', 54), ('R101', 48)]:
    near_pad(ref, 'U1', num, out=3.5, region=A, rmax=16)

# LT3045 analogue regulator below the ADC, at the analogue zone edge facing the power zone.
put('U201', 52.0, 78.0, 0)
for ref in ['C203', 'C202', 'C201', 'R201', 'R207', 'C204', 'R202', 'R203', 'R204', 'R205', 'R206', 'R208', 'R209', 'Q201', 'Q202']:
    n = [p for p in FP[ref].Pads() if p.GetNetname() and short(p.GetNetname()) != 'GND']
    ups = [q for q in FP['U201'].Pads() if n and q.GetNetname() in {p.GetNetname() for p in n}]
    if ups:
        num = ups[0].GetNumber(); near_pad(ref, 'U201', num, out=1.8, region=(40.0, 66.0, 62.0, H), rmax=12)
    else:
        place_near_point(ref, 56.0, 82.0, region=(40.0, 66.0, 62.0, H))

# ------------------------------------------------------------------ 3. isolated trigger and photodiode
put('U600', 34.0, 24.0, 270)                      # TLP2761: LED pins 1-3 up (isolated side), output 4-6 down
for ref, target in [('R600', (30.5, 17.6)), ('D600', (37.5, 17.6))]:
    place_near_point(ref, *target, region=ISO)
near_pad('C600', 'U600', 6, out=1.6, region=(18.0, ISO_OUT[3], 50.0, 36.0))
near_pad('R601', 'U600', 5, out=1.6, region=(18.0, ISO_OUT[3], 50.0, 36.0))
EV = ZONES['event'][0]
place_near_point('U610', 9.0, 16.0, region=EV); place_near_point('U611', 9.0, 23.5, region=EV); place_near_point('U612', 3.5, 21.0, region=EV)
for ic in ('U610', 'U611', 'U612'): decouple_ic(ic)
for ref in ['D601', 'R610', 'R611', 'C610', 'R612', 'R613', 'C611', 'R614', 'R615', 'R616', 'R617', 'C614']:
    sigs = [p for p in FP[ref].Pads() if p.GetNetname() and short(p.GetNetname()) not in ('GND', '+3V3')]
    tgt = None
    for s in sigs:
        for (r, pnum) in nets[s.GetNetname()]:
            if r in ('U610', 'U611', 'U612', 'J601') and r in placed:
                tgt = (r, pnum); break
        if tgt: break
    if tgt is None:
        rail = [p for p in FP[ref].Pads() if short(p.GetNetname()) == '+3V3']
        tgt = next(((r, pn) for r in ('U610', 'U611', 'U612') for pn in pins_on(r, rail[0].GetNetname())), None) if rail else None
    near_pad(ref, *tgt, out=1.6, region=EV, rmax=12)

# ------------------------------------------------------------------ 4. digital: SD, logic, ADC interface, clock, buck
DG = ZONES['digital'][0]
logic = ['U210', 'U211', 'U212', 'U213', 'U214', 'U220', 'U221', 'U222', 'U223', 'U224', 'U225', 'U226', 'U227', 'U228', 'U330', 'U331', 'U332', 'U333']
slots = [(55.0, 29.0), (55.0, 36.0), (55.0, 43.0)] + [(x, y) for y in (29.0, 36.0, 43.0) for x in (63.0, 70.5, 78.0)] + [(85.0, 32.0), (85.0, 39.0), (63.0, 21.5), (70.5, 21.5), (78.0, 21.5), (85.0, 45.5)]
for ref, (x, y) in zip(logic, slots):
    place_near_point(ref, x, y, rots=(0,), region=DG); decouple_ic(ref)
for i, ref in enumerate(['U310', 'U311', 'U312', 'U313', 'U314']):
    place_near_point(ref, 70.0, 49.0 + 5.0 * i, rots=(0,), region=(59.0, 44.0, 92.0, 62.0)); decouple_ic(ref)
place_near_point('Y340', 62.0, 61.0, region=(59.0, 52.0, 70.0, 66.0))
near_pad('C340', 'Y340', 4, out=1.2, region=(56.0, 48.0, 76.0, 70.0), rmax=8)
for ref, num, out in [('C240', 2, 1.2), ('C241', 6, 2.6), ('C242', 6, 1.8), ('R240', 8, 1.6)]:
    near_pad(ref, 'U240', num, out=out, region=(78.0, 46.0, 96.0, 62.0), rmax=10)

# ------------------------------------------------------------------ 5. power: USB-C, OVP, charger, pack, hold-up
PW = ZONES['power'][0]
CH = (60.0, 60.0, 101.0, H)
for ref, num, out in [('C409', 5, 1.6), ('C407', 4, 1.6), ('C408', 19, 1.6),
                      ('C403', 29, 3.2), ('C404', 29, 3.2), ('C405', 29, 3.2), ('C400', 2, 3.0), ('C401', 2, 3.0),
                      ('C417', 22, 2.8), ('C418', 23, 2.8), ('R401', 20, 1.6), ('R402', 17, 1.6), ('R403', 17, 1.6),
                      ('R404', 16, 1.6), ('R405', 16, 1.6), ('R406', 13, 1.6), ('Q401', 13, 2.5), ('R407', 1, 1.6), ('D401', 1, 2.5)]:
    near_pad(ref, 'U400', num, out=out, region=CH, rmax=14)
near_pad('D402', 'SW400', 1, out=2.0, region=CH); near_pad('R408', 'D402', 1, out=1.4, region=CH)
US = (88.0, 58.0, W, H)
for ref, num, out in [('C324', 'B3', 0.9), ('C325', 'B1', 0.9), ('C321', 'A2', 0.9)]:
    near_pad(ref, 'U323', num, out=out, region=US, rmax=8)
for ref, anchor, num in [('D310', 'J310', 'A6'), ('D311', 'J310', 'A5'), ('D312', 'U323', 'A2'), ('U320', 'J310', 'B5')]:
    near_pad(ref, anchor, num, out=3.5, region=US, rmax=12)
for ref in ['C320', 'R360', 'R361']:
    near_pad(ref, 'U320', {'R360': 4, 'R361': 6, 'C320': 12}[ref], out=1.4, region=US, rmax=10)
place_near_point('U321', 95.0, 79.5, rots=(0,), region=US); decouple_ic('U321'); place_near_point('U322', 95.0, 64.0, rots=(0,), region=US); decouple_ic('U322')
for ref, anchor, num in [('R362', 'U321', 2), ('R363', 'U321', 2), ('C322', 'U321', 5), ('C323', 'U322', 5)]:
    near_pad(ref, anchor, num, out=1.4, region=US, rmax=10)
place_near_point('U324', 97.5, 58.5, rots=(0, 180), region=(88.0, 50.0, W, 66.0))   # module VBUS LDO, between USB and pad 31
for ref, num in [('C326', 1), ('C327', 5), ('D324', 5)]:
    near_pad(ref, 'U324', num, out=1.4, region=(88.0, 50.0, W, 66.0), rmax=8)

# ------------------------------------------------------------------ 5b. one decoupling capacitor at every IC supply pin
for ic in sorted(r for r in placed if re.match(r'^(U|Y)\d', r) and r != 'U300'):
    for q in FP[ic].Pads():
        n = q.GetNetname()
        if short(n) not in RAIL_NETS: continue
        have = [r for r in gnd_caps_on(n) if r in placed and min(math.dist(L(x.GetPosition()), L(q.GetPosition())) for x in FP[r].Pads()) <= 3.0]
        if have: continue
        free = [r for r in gnd_caps_on(n) if r not in placed and comps[r]['sheet'] == comps[ic]['sheet']]
        if not free: continue
        k = int(re.sub(r'\D', '', ic)); cap = min(free, key=lambda r: (abs(int(re.sub(r'\D', '', r)) - k), r))
        near_pad(cap, ic, q.GetNumber(), out=1.2, region=None, rmax=10)

# ------------------------------------------------------------------ 6. everything else: next to the part it serves
home_sheet_ics = {}
for r, c in comps.items():
    if r[0] in 'UJYQ' or r.startswith('SW'):
        home_sheet_ics.setdefault(c['sheet'], []).append(r)
RAILS = {'GND', '+3V3', '+5VA', 'SYS', '+3V3_ADC', 'USB_5V', 'PACK_POS', 'REGN', 'POWER_SDA', 'POWER_SCL'}
REGION_OF = {'supervision': DG, 'reset_logic': DG, 'restart_latch': DG, 'debug_service': DG, 'storage': DG, 'controller': (60.0, 18.0, W, 62.0),
             'adc_interface': (44.0, 40.0, 95.0, 66.0), 'digital_power': DG, 'charger': CH, 'usb_c': US, 'analog': (40.0, 62.0, 64.0, H),
             'ads1299_core': A, 'ref_bias': A, 'event_inputs': EV}
near_adc = {'R310': 40, 'R313': 34, 'R316': 39, 'R319': 38, 'R322': 35, 'R330': 43, 'R331': 47, 'R332': 36, 'R333': 36,
            'R311': 40, 'R314': 34, 'R317': 39, 'R320': 38, 'R323': 35, 'R340': 52, 'R341': 37, 'R342': 41, 'R343': 42, 'R344': 44, 'R345': 45, 'R346': 46}
for ref, num in near_adc.items():                 # 'place near ADC' series resistors and straps at the ADS1299 pins
    near_pad(ref, 'U1', num, out=2.6, region=(44.0, 40.0, 72.0, 70.0), rmax=12)
for ref, num in [('R349', 3), ('R348', 1)]:
    near_pad(ref, 'Y340', num, out=1.4, region=(56.0, 50.0, 74.0, 70.0), rmax=10)
for ref, num in [('C300', 10), ('C301', 9), ('C302', 10), ('C303', 31)]:
    near_pad(ref, 'U300', num, out=1.4, region=(80.0, 20.0, W, 62.0), rmax=12)
rest = sorted(r for r in comps if r not in placed)
def rank(r):   # decoupling capacitors first, then resistors, then the rest
    return (0 if r.startswith('C') else 1 if r.startswith('R') else 2, r)
for ref in sorted(rest, key=rank):
    c = comps[ref]; region = REGION_OF.get(c['sheet'], (0.0, 0.0, W, H))
    sig = [p for p in FP[ref].Pads() if p.GetNetname() and short(p.GetNetname()) not in RAILS and not p.GetNetname().startswith('unconnected')]
    tgt = None
    for s in sig:                                 # prefer an IC or connector of the same sheet on a signal net
        cands = [(r, pn) for r, pn in nets[s.GetNetname()] if r in placed and r != ref and (r[0] in 'UJYQ' or r.startswith('SW'))]
        cands.sort(key=lambda rp: (comps.get(rp[0], {}).get('sheet') != c['sheet'], rp[0]))
        if cands: tgt = cands[0]; break
    if tgt is None:                               # a rail capacitor: the same-sheet IC on that rail with the fewest caps so far
        rails = [p.GetNetname() for p in FP[ref].Pads() if short(p.GetNetname()) not in ('GND',)]
        ics = [r for r in home_sheet_ics.get(c['sheet'], []) if r in placed and rails and pins_on(r, rails[0])]
        if ics:
            ic = min(ics, key=lambda r: (used_pin.get((r, 'cap'), 0), abs(int(re.sub(r'\D', '', r) or 0) - int(re.sub(r'\D', '', ref) or 0))))
            used_pin[(ic, 'cap')] = used_pin.get((ic, 'cap'), 0) + 1
            tgt = (ic, pins_on(ic, rails[0])[0])
    if tgt is None:                               # test pads and leftovers: centre of their region
        place_near_point(ref, (region[0] + region[2]) / 2, (region[1] + region[3]) / 2, region=region, rmax=40); continue
    near_pad(ref, tgt[0], tgt[1], out=1.6, region=region, rmax=14)
missing = sorted(set(comps) - set(placed))
assert not missing, missing

# ------------------------------------------------------------------ outline, slot, keep-outs, zones, drawings
def shape_rect(layer, x0, y0, x1, y1, w=0.1, radius=0.0):
    s = pcbnew.PCB_SHAPE(board); s.SetShape(pcbnew.SHAPE_T_RECT); s.SetStart(V(x0, y0)); s.SetEnd(V(x1, y1))
    if radius: s.SetCornerRadius(mm(radius))
    s.SetLayer(layer); s.SetWidth(mm(w)); board.Add(s); return s
shape_rect(pcbnew.Edge_Cuts, 0, 0, W, H, 0.1, R_CORNER)
u6 = L(FP['U600'].GetPosition())
SLOT = (u6[0] - 4.0, u6[1] - 0.6, u6[0] + 4.0, u6[1] + 0.6)    # 8 x 1.2 mm milled slot under U600 (JLCPCB NPTH slot >= 1.0 mm)
shape_rect(pcbnew.Edge_Cuts, *SLOT, 0.1, 0.6)
def text(layer, s, x, y, size=1.2, thick=0.15, justify_left=True):
    t = pcbnew.PCB_TEXT(board); t.SetText(s); t.SetPosition(V(x, y)); t.SetLayer(layer)
    t.SetTextSize(pcbnew.VECTOR2I(mm(size), mm(size))); t.SetTextThickness(mm(thick))
    if justify_left: t.SetHorizJustify(pcbnew.GR_TEXT_H_ALIGN_LEFT)
    board.Add(t)
def zone(layers, pts, net=None, name='', rule=None, priority=0):
    z = pcbnew.ZONE(board)
    ls = pcbnew.LSET()
    for l in layers: ls.AddLayer(l)
    z.SetLayerSet(ls)
    if net: z.SetNet(netinfo[net])
    o = z.Outline(); o.NewOutline()
    for x, y in pts: o.Append(mm(OX + x), mm(OY + y))
    z.SetZoneName(name); z.SetAssignedPriority(priority)
    if rule:
        z.SetIsRuleArea(True)
        z.SetDoNotAllowTracks('tracks' in rule); z.SetDoNotAllowVias('vias' in rule); z.SetDoNotAllowPads('pads' in rule)
        z.SetDoNotAllowFootprints('footprints' in rule); z.SetDoNotAllowZoneFills('pour' in rule)
    else:
        z.SetMinThickness(mm(0.2)); z.SetThermalReliefGap(mm(0.3)); z.SetThermalReliefSpokeWidth(mm(0.3))
        z.SetLocalClearance(mm(0.3)); z.SetIslandRemovalMode(pcbnew.ISLAND_REMOVAL_MODE_NEVER)
    board.Add(z); return z
def rect_pts(r): return [(r[0], r[1]), (r[2], r[1]), (r[2], r[3]), (r[0], r[3])]
CU = [pcbnew.F_Cu, pcbnew.In1_Cu, pcbnew.In2_Cu, pcbnew.B_Cu]
# Trigger barrier (D36): U-shaped ring 8 mm wide around the isolated area; no tracks, vias or pours of any net.
ix0, iy0, ix1, iy1 = ISO; ox0, _, ox1, oy1 = ISO_OUT
zone(CU, [(ox0, 0.3), (ix0, 0.3), (ix0, iy1), (ix1, iy1), (ix1, 0.3), (ox1, 0.3), (ox1, oy1), (ox0, oy1)], name='Trigger isolation barrier 8 mm (D36)', rule='tracks vias pour')
zone(CU, rect_pts(ISO), name='Trigger isolated side: no plane pour', rule='pour')
# Planes. In1: continuous GND. In2: +5VA under the analogue core, +3V3 under the digital zone, SYS under the power zone,
# GND everywhere else (under the electrode inputs, the module and its antenna surroundings).
def rounded(x0, y0, x1, y1, r, n=8):
    pts = []
    for cx, cy, a0 in [(x1 - r, y0 + r, -90), (x1 - r, y1 - r, 0), (x0 + r, y1 - r, 90), (x0 + r, y0 + r, 180)]:
        pts += [(cx + r * math.cos(math.radians(a0 + 90 * k / n)), cy + r * math.sin(math.radians(a0 + 90 * k / n))) for k in range(n + 1)]
    return pts
inset = rounded(0.5, 0.5, W - 0.5, H - 0.5, R_CORNER)   # follows the rounded outline 0.5 mm inside the edge
zone([pcbnew.In1_Cu], inset, 'GND', 'In1 GND plane', priority=0)
zone([pcbnew.In2_Cu], inset, 'GND', 'In2 GND fill', priority=0)
P5VA = (43.0, 44.0, 62.0, 84.0); P3V3 = (46.0, 0.5, 92.0, 62.0); PSYS = (62.0, 62.0, 101.0, 84.0)
zone([pcbnew.In2_Cu], rect_pts(P5VA), '+5VA', 'In2 +5VA (ADS1299, LT3045 output)', priority=2)
zone([pcbnew.In2_Cu], rect_pts(P3V3), '+3V3', 'In2 +3V3 (digital zone)', priority=1)
zone([pcbnew.In2_Cu], rect_pts(PSYS), 'SYS', 'In2 SYS (power zone)', priority=1)
# Floor-plan outlines and labels on Dwgs.User (documentation only).
for name, (r, purpose) in ZONES.items():
    shape_rect(pcbnew.Dwgs_User, *r, 0.15)
    text(pcbnew.Dwgs_User, f'{name.upper()}: {purpose}', r[0] + 0.8, r[1] + 1.2, 0.9, 0.12)
shape_rect(pcbnew.Dwgs_User, *ANT_ZONE, 0.15); text(pcbnew.Dwgs_User, 'ANTENNA 10 mm: no high or large metal parts (UBX-17056748 3.3.3)', ANT_ZONE[0] + 0.5, ANT_ZONE[3] - 1.0, 0.8, 0.1)
shape_rect(pcbnew.Dwgs_User, *ISO_OUT, 0.2); text(pcbnew.Dwgs_User, 'ISOLATION BARRIER 8 mm (D36)', ISO_OUT[0] + 0.5, ISO_OUT[3] - 1.0, 0.9, 0.12)
labels = []
def free_label(s_, near, size=1.0, region=(0.6, 0.6, W - 0.6, H - 0.6), iso=False):
    """Silkscreen text on the first spot near 'near' that is clear of every courtyard, label, keep-out and edge."""
    w, h = 0.9 * size * len(s_) + 0.4, 1.3 * size + 0.3
    if isinstance(near, str):
        b = placed[near]; x0, y0 = (b[0] + b[2]) / 2, (b[1] + b[3]) / 2
    else:
        x0, y0 = near
    for d2, i, j in sorted(((i * i + j * j), i, j) for i in range(-120, 121) for j in range(-120, 121)):
        x, y = x0 + i * 0.25, y0 + j * 0.25; bb = (x - w / 2, y - h / 2, x + w / 2, y + h / 2)
        if not inside(bb, region): continue
        if not iso and overlap(bb, ISO_OUT, 0.0): continue
        if overlap(bb, SLOT, 0.5): continue
        if any(overlap(bb, o, 0.15) for o in placed.values()) or any(overlap(bb, o, 0.3) for o in labels): continue
        labels.append(bb); text(pcbnew.F_SilkS, s_, x, y, size, 0.15, justify_left=False); return (x, y)
    return None
lab_main = free_label('REV C12 - NO HUMAN CONNECTION', (25.0, 82.0), 1.0)
lab_iso = free_label('ISOLATED', (22.0, 14.0), 1.0, region=ISO_OUT, iso=True)
for ref, name in [('J500', 'ELECTRODES J500'), ('J600', 'TRIGGER J600'), ('J601', 'PHOTO J601'), ('J420', 'microSD'), ('J310', 'USB-C'),
                  ('J401', 'PACK J401'), ('J300', 'SWD'), ('J301', 'INTERLOCK'), ('SW300', 'RESET'), ('SW301', 'RECOVERY'), ('SW302', 'RECORD'), ('SW400', 'POWER')]:
    free_label(name, ref, 1.0, iso=ref == 'J600')

pcbnew.ZONE_FILLER(board).Fill(board.Zones())
pcbnew.SaveBoard(str(PCB), board)

# ------------------------------------------------------------------ stack-up (JLC04161H-3313) into the board file
STACK = '''	(stackup
		(layer "F.SilkS" (type "Top Silk Screen"))
		(layer "F.Paste" (type "Top Solder Paste"))
		(layer "F.Mask" (type "Top Solder Mask") (thickness 0.01))
		(layer "F.Cu" (type "copper") (thickness 0.035))
		(layer "dielectric 1" (type "prepreg") (thickness 0.0994) (material "3313") (epsilon_r 4.1) (loss_tangent 0.02))
		(layer "In1.Cu" (type "copper") (thickness 0.0152))
		(layer "dielectric 2" (type "core") (thickness 1.265) (material "FR4") (epsilon_r 4.6) (loss_tangent 0.02))
		(layer "In2.Cu" (type "copper") (thickness 0.0152))
		(layer "dielectric 3" (type "prepreg") (thickness 0.0994) (material "3313") (epsilon_r 4.1) (loss_tangent 0.02))
		(layer "B.Cu" (type "copper") (thickness 0.035))
		(layer "B.Mask" (type "Bottom Solder Mask") (thickness 0.01))
		(layer "B.Paste" (type "Bottom Solder Paste"))
		(layer "B.SilkS" (type "Bottom Silk Screen"))
		(copper_finish "ENIG")
		(dielectric_constraints no)
	)
'''
txt = PCB.read_text()
txt = re.sub(r'\t\(stackup\n.*?\n\t\)\n', '', txt, flags=re.S)
txt = txt.replace('\t(setup\n', '\t(setup\n' + STACK, 1)
PCB.write_text(txt)

# ------------------------------------------------------------------ project file: rules and netclasses; custom rules
pro = json.loads(PRO.read_text()) if PRO.exists() and PRO.read_text().strip() not in ('', '{}') else {}
def nc(name, track, clearance, via=(0.5, 0.25), dp=None, colour='rgba(0, 0, 0, 0.000)'):
    d = dict(name=name, bus_width=12, clearance=clearance, track_width=track, via_diameter=via[0], via_drill=via[1],
             microvia_diameter=0.3, microvia_drill=0.1, diff_pair_width=dp[0] if dp else 0.2, diff_pair_gap=dp[1] if dp else 0.25,
             diff_pair_via_gap=0.25, line_style=0, wire_width=6, pcb_color=colour, schematic_color='rgba(0, 0, 0, 0.000)', priority=0, tuning_profile='')
    return d
classes = [nc('Default', 0.20, 0.15), nc('Power', 0.80, 0.20, (0.6, 0.3)), nc('Supply', 0.40, 0.20), nc('USB_90R', 0.15, 0.20, dp=(0.15, 0.18)),
           nc('Analog_in', 0.20, 0.20, dp=(0.20, 0.20)), nc('Trigger_iso', 0.30, 0.30)]
for i, k in enumerate(classes): k['priority'] = 2147483647 if k['name'] == 'Default' else i
POWER = {'SYS', 'PACK_POS', 'PACK_IN', 'USB_5V', 'VBUS_CON', 'CHG_PMID', 'CHG_SW1', 'CHG_SW2', 'SW_DIG'}
SUPPLY = {'+3V3', '+5VA', '+3V3_ADC', 'MCU_VBUS', 'USB_VPWR', 'REGN', 'CHG_BTST1', 'CHG_BTST2'}
assign = {}
for n, members in nets.items():
    s = short(n); refs = {r for r, _ in members}
    if s in POWER: assign[n] = 'Power'
    elif s in SUPPLY: assign[n] = 'Supply'
    elif s in ('USB_DP', 'USB_DM'): assign[n] = 'USB_90R'
    elif s.startswith('TRIG_ISO') or s == 'TRIG_LED_A' or refs & {'U600'} and any(r == 'U600' and p in ('1', '2', '3') for r, p in members): assign[n] = 'Trigger_iso'
    elif s.startswith('ADC_IN') or s.startswith('ADC_BIAS') or s in ('REF_BUF',) or any(re.fullmatch(r'(R\d[1-4]|R5\d\d|J500|JP\d+|RB[12]|D50\d|D510|RFB1|RZB1|CFB1)', r) for r in refs) and s != 'GND' and not s.startswith('+'):
        assign[n] = 'Analog_in'
pro.setdefault('board', {})
dsj = pro['board'].setdefault('design_settings', {})
rules = dsj.setdefault('rules', {})
rules.update(dict(min_clearance=0.10, min_track_width=0.10, min_via_diameter=0.25, min_through_hole_diameter=0.15, min_via_annular_width=0.05,
                  min_hole_clearance=0.20, min_hole_to_hole=0.25, min_copper_edge_clearance=0.30, min_silk_clearance=0.15, min_text_height=1.0,
                  min_text_thickness=0.15, solder_mask_to_copper_clearance=0.0, allow_soldermask_bridges_in_footprints=True))
pro['net_settings'] = dict(classes=classes, meta=dict(version=5), net_colors={}, netclass_assignments={n: [c] for n, c in sorted(assign.items())}, netclass_patterns=[])
pro.setdefault('meta', {})['filename'] = 'EEG_RevC.kicad_pro'
PRO.write_text(json.dumps(pro, indent=2) + '\n')
DRU.write_text('''(version 1)
# Step 14 custom rules (generated by scripts/pcb_place.py). Later rules take precedence over earlier ones.
# Pads of one land pattern keep the spacing of the manufacturer drawing (0.10 mm on the TI FemtoFET, 0.175 mm on the
# 0.4 mm WCSP); JLCPCB multilayer minimum is 0.09 mm. Pads of different parts are kept far apart by the courtyards.
(rule "Land-pattern pad spacing"
	(constraint clearance (min 0.09mm))
	(condition "A.Type == 'Pad' && B.Type == 'Pad'"))
# USB 2.0 pair: 90 ohm differential on F.Cu over In1 GND (JLC04161H-3313, estimate in the Step 14 review).
# GCT USB4105 land pattern (KiCad stock, per GCT drawing): GND pads A1/A12/B1/B12 sit 0.194 mm from the NPTH
# alignment pegs, 6 um under the 0.20 mm hole clearance used elsewhere. Accepted for this footprint only (review 4.3).
(rule "USB4105 peg clearance"
	(constraint hole_clearance (min 0.19mm))
	(condition "A.memberOfFootprint('J310') && B.memberOfFootprint('J310')"))
(rule "USB 90 ohm pair"
	(condition "A.NetClass == 'USB_90R'")
	(constraint track_width (opt 0.15mm))
	(constraint diff_pair_gap (opt 0.18mm))
	(constraint skew (max 0.15mm)))
# Electrode inputs: wider clearance to everything else (leakage and 100 V fault margin, Step 7/13).
(rule "Analogue input clearance"
	(condition "A.NetClass == 'Analog_in' && B.NetClass != 'Analog_in' && !(A.Type == 'Pad' && B.Type == 'Pad')")
	(constraint clearance (min 0.3mm)))
# D36: isolated trigger side keeps 8 mm clearance and creepage to every other net. Items without a net (the BNC
# mounting pegs, mounting holes) are covered by the barrier rule area instead.
(rule "Trigger isolation 8 mm clearance"
	(constraint clearance (min 8mm))
	(condition "A.NetClass == 'Trigger_iso' && B.NetClass != 'Trigger_iso' && B.NetName != ''"))
(rule "Trigger isolation 8 mm creepage"
	(constraint creepage (min 8mm))
	(condition "A.NetClass == 'Trigger_iso' && B.NetClass != 'Trigger_iso' && B.NetName != ''"))
''')

# ------------------------------------------------------------------ placement report
def centre(ref): return L(FP[ref].GetPosition())
def dist_pad(a, an, b):
    return min(math.dist(L(p.GetPosition()), L(pad(b, an).GetPosition())) for p in FP[a].Pads())
report = dict(board_mm=[W, H], parts=len([r for r in FP if not r.startswith('H')]), holes=4, zones={k: dict(rect=v[0], purpose=v[1]) for k, v in ZONES.items()},
              iso=ISO, iso_with_barrier=ISO_OUT, slot=SLOT, antenna=ANT, antenna_zone=ANT_ZONE,
              positions={r: dict(x=round(centre(r)[0], 2), y=round(centre(r)[1], 2), rot=round(FP[r].GetOrientationDegrees()), box=[round(v, 2) for v in placed[r]]) for r in sorted(FP)},
              netclasses={k: sum(1 for v in assign.values() if v == k) for k in ('Power', 'Supply', 'USB_90R', 'Analog_in', 'Trigger_iso')}, fallback=sorted(set(FALLBACK)))
# Placement rules (datasheet layout guidance turned into distances; pad-to-pad, mm).
checks = []
def chk(ok, msg): checks.append(dict(ok=bool(ok), rule=msg))
def pd(a, an, b, bn): return math.dist(L(pad(a, an).GetPosition()), L(pad(b, bn).GetPosition()))
def nearest_on_net(ref, num, cand_refs):
    n = pad(ref, num).GetNetname(); best = (99.0, None)
    for r in cand_refs:
        for q in FP[r].Pads():
            if q.GetNetname() == n:
                best = min(best, (math.dist(L(q.GetPosition()), L(pad(ref, num).GetPosition())), r))
    return best
caps = [r for r in FP if r.startswith('C') and any(short(q.GetNetname()) == 'GND' for q in FP[r].Pads())]
undec = []
for r in sorted(FP):
    if not re.match(r'^(U|Y)\d', r): continue
    for q in FP[r].Pads():
        n = short(q.GetNetname())
        if n in ('+3V3', '+5VA', '+3V3_ADC', 'SYS', 'USB_5V', 'MCU_VBUS', 'REGN', 'USB_VPWR') and r not in ('U300',) and pintype.get((r, q.GetNumber()), '').startswith(('power_in', 'passive')):
            d, c = nearest_on_net(r, q.GetNumber(), caps)
            if d > 5.0: undec.append(f'{r}.{q.GetNumber()} {n} {d:.1f} mm ({c})')
chk(not undec, f'Every IC supply pin has a GND-referenced capacitor pad on its net within 5 mm ({len(undec)} exceptions: {undec})')
mod = [nearest_on_net('U300', k, caps)[0] for k in ('9', '10')]
chk(max(mod) <= 4.0, f'NINA-B306 VCC/VCC_IO pads 9/10: nearest capacitor {max(mod):.1f} mm (<= 4)')
for ref, num, lim, what in [('U400', '29', 3.0, 'BQ25798 PMID 100 nF (C406) at pin 29'), ('U400', '25', 3.0, 'BQ25798 SYS 100 nF (C415) at pin 25'),
                            ('U400', '2', 3.0, 'BQ25798 VBUS 100 nF (C402) at pins 2-3'), ('U240', '2', 3.0, 'TPS62162 VIN capacitor (C240) at pin 2')]:
    d, c = nearest_on_net(ref, num, caps); chk(d <= lim, f'{what}: {d:.2f} mm to {c} (<= {lim})')
for a, an, b, bn, lim, what in [('L400', '1', 'U400', '28', 6.0, 'L400 to BQ25798 SW1 (pin 28)'), ('L400', '2', 'U400', '26', 6.0, 'L400 to BQ25798 SW2 (pin 26)'),
                                ('L240', '1', 'U240', '7', 4.0, 'L240 to TPS62162 SW (pin 7)'), ('R400', '1', 'Q400', '1', 3.0, 'BATP sense R400 at the pack side of Q400 (Kelvin)'),
                                ('R201', '1', 'U201', '7', 4.0, 'RSET (R201) at the LT3045 SET pin'), ('C201', '1', 'U201', '7', 4.0, 'CSET (C201) at the LT3045 SET pin'),
                                ('C203', '1', 'U201', '10', 5.0, 'LT3045 output capacitor C203 at OUT/OUTS'), ('C324', '1', 'U323', 'B3', 3.0, 'C324 at the TPD1S514 VBUS_CON balls'),
                                ('J310', 'A4', 'U323', 'C2', 8.0, 'TPD1S514 within 8 mm of the J310 VBUS contacts'), ('Y340', '3', 'U1', '37', 12.0, 'ADC clock oscillator within 12 mm of CLK (pin 37)')]:
    d = pd(a, an, b, bn); chk(d <= lim, f'{what}: {d:.2f} mm (<= {lim})')
far = [(r, num) for r, num in near_adc.items() if r in ('R310', 'R313', 'R316', 'R319', 'R322', 'R330', 'R331', 'R332')]   # the 33R/100R series parts; straps and 10k pull-downs are DC
worst = max((min(math.dist(L(q.GetPosition()), L(pad('U1', n).GetPosition())) for q in FP[r].Pads()), r) for r, n in far)
chk(worst[0] <= 7.0, f"'Near ADC' series resistors and straps within 7 mm of their ADS1299 pins (worst {worst[1]} {worst[0]:.1f} mm)")
for ch in range(1, 9):
    d = min(math.dist(L(q.GetPosition()), L(pad('U1', 16 - 2 * (ch - 1)).GetPosition())) for q in FP[f'C{ch}'].Pads())
    if d > 20: chk(False, f'C{ch} far from its ADC pins ({d:.1f} mm)')
chk(True, 'Differential 220 pF capacitors C1-C8 sit at the end of each channel network, nearest the ADC')
analog_parts = [r for r, c in comps.items() if c['sheet'] in ('inputs_1_4', 'inputs_5_8', 'ref_bias', 'ads1299_core')]
outside = [r for r in analog_parts if not inside(placed[r], ZONES['analogue'][0])]
chk(not outside, f'Electrode inputs, REF/BIAS and ADS1299 parts inside the analogue zone ({outside})')
hot = ['U400', 'L400', 'C403', 'C404', 'C405', 'C406', 'C410', 'C411', 'C412', 'C413', 'C414', 'C415', 'U240', 'L240', 'C240', 'C241']
def gap(a, b): return math.hypot(max(b[0] - a[2], a[0] - b[2], 0), max(b[1] - a[3], a[1] - b[3], 0))
g_adc = min((gap(placed[h], placed['U1']), h) for h in hot); g_in = min((gap(placed[h], placed[a]), h, a) for h in hot for a in analog_parts)
chk(g_adc[0] >= 15.0, f'Charger hot loop and TPS62162 at least 15 mm from the ADS1299 courtyard ({g_adc[0]:.1f} mm, {g_adc[1]})')
chk(g_in[0] >= 10.0, f'Charger hot loop and TPS62162 at least 10 mm from every analogue-front-end part ({g_in[0]:.1f} mm, {g_in[1]} to {g_in[2]})')
iso_in = [r for r in placed if r not in ISO_PARTS | {'U600'} and overlap(placed[r], ISO_OUT, 0.0)]
chk(not iso_in, f'Nothing but the isolated trigger parts inside the isolation area plus 8 mm barrier ({iso_in})')
chk(all(inside(placed[r], (ISO[0], -30.0, ISO[2], ISO[3])) for r in ISO_PARTS), 'J600, R600 and D600 inside the isolated area')
ant_hits = [r for r in placed if LARGE.match(r) and overlap(placed[r], ANT_ZONE, 0.0)]
chk(not ant_hits, f'No connector, switch, inductor, bulk electrolytic, oscillator or mounting hole within 10 mm of the antenna ({ant_hits})')
ex = max(x for x, _ in eagp)
chk(W - ex <= 1.5 and abs(centre('U300')[1] - H / 2) <= 1.0, f'NINA-B306 at the centre of the right edge (y {centre("U300")[1]:.1f} of {H / 2}), antenna pads {W - ex:.2f} mm from the edge')
for ref, side in [('J500', 'left'), ('J600', 'top'), ('J601', 'top'), ('J420', 'top'), ('J310', 'right'), ('J401', 'bottom'), ('J301', 'right')]:
    b = placed[ref]; d = {'left': b[0], 'top': b[1], 'right': W - b[2], 'bottom': H - b[3]}[side]
    chk(d <= 4.0, f'{ref} at the {side} edge (courtyard {d:.2f} mm from it)')
chk(lab_main and lab_iso, f'Silkscreen warning and isolation labels placed clear of every part ({lab_main}, {lab_iso})')
report['checks'] = checks
(CHECKS / 'placement.json').write_text(json.dumps(report, indent=1))
for c in checks:
    print(('PASS ' if c['ok'] else 'FAIL ') + c['rule'])
print(f'Placed {report["parts"]} parts and 4 mounting holes on {W:g} x {H:g} mm; netclasses {report["netclasses"]}; outside their region: {sorted(set(FALLBACK)) or "none"}')
