MariusFauteux/EEG-PCB/hardware/scripts/event_inputs.py

# Step 9: isolated trigger input and photodiode front end. Executed by build.py with shared helpers in scope.
# Part numbers and pinouts checked against manufacturer data sheets; see docs/reviews/step9_event_timing_review.md.
chip('TLP2761',[([(1,'A','passive'),(2,'NC','no_connect'),(3,'K','passive')],[(6,'VCC','power_in'),(5,'VO','output'),(4,'GND','power_in')])])
chip('TLV9061',[([(3,'IN+','input'),(4,'IN-','input')],[(5,'V+','power_in'),(1,'OUT','output'),(2,'V-','power_in')])])
chip('TLV7011',[([(3,'IN+','input'),(4,'IN-','input')],[(5,'VCC','power_in'),(1,'OUT','output'),(2,'VEE','power_in')])])
chip('MCP4725',[([(4,'SDA','bidirectional'),(5,'SCL','input'),(6,'A0','input')],[(3,'VDD','power_in'),(1,'VOUT','output'),(2,'VSS','power_in')])])
globalnets.update(['TRIGGER_ISO','PHOTO_EDGE','PHOTO_MONITOR','POWER_SDA','POWER_SCL'])
sod='Diode_SMD:D_SOD-323'; sot5='Package_TO_SOT_SMD:SOT-23-5'
ev=Sheet('event_inputs','Isolated trigger input and photodiode front end')
ev.txt('C6 STEP 9 / EVENT INPUTS / EDGES TIMESTAMPED BY MCU TIMER (GPIOTE+PPI), SAME PATH AS ADC DRDY',10,12,1.4)
# --- Isolated trigger: LED side powered only by the external source; no copper of this group may approach board GND.
ev.txt('ISOLATION BARRIER: J600, R600, D600 and U600 pins 1-3 form the isolated side. Keep >= 8 mm creepage and clearance',10,24,1.0)
ev.txt('to all other copper (slot under U600). J600 shell is NOT board GND. Input: 3.0-5.0 V logic, active HIGH, 2-6 mA LED current.',10,30,1.0)
# Step 13: BNC with its three shell pins (Amphenol 031-6575 footprint pads 2-4); the shell is the isolated return, not board GND.
chip('BNC',[([(1,'SIG','passive')],[(2,'SHELL','passive'),(3,'SHELL','passive'),(4,'SHELL','passive')])])
ev.symbol('BNC','J600','TRIGGER IN (BNC, shell = isolated return)',25,60);ev.connect('J600',1,{1:'TRIG_ISO_IN',2:'TRIG_ISO_RTN',3:'TRIG_ISO_RTN',4:'TRIG_ISO_RTN'})
ev.r('R600','620R 1% 0.25W',70,52,'TRIG_ISO_IN','TRIG_LED_A',fp='Resistor_SMD:R_1206_3216Metric')
ev.symbol('D','D600','1N4148WS (LED reverse clamp)',70,75,fp=sod,mpn='1N4148WS');ev.connect('D600',1,{1:'TRIG_LED_A',2:'TRIG_ISO_RTN'})
ev.symbol('TLP2761','U600','TLP2761(TP,E)',140,62,fp='Package_SO:SO-6L_10x3.84mm_P1.27mm',mpn='TLP2761(TP,E)')
ev.connect('U600',1,{1:'TRIG_LED_A',2:None,3:'TRIG_ISO_RTN',6:'+3V3',5:'TRIG_OPTO_OUT',4:'GND'})
ev.cap('C600','100n 10V X7R (within 1 cm of U600 pins 4/6)',200,52,'+3V3')
ev.r('R601','100R',200,75,'TRIG_OPTO_OUT','TRIGGER_ISO')
ev.txt('U600 output is inverting: trigger HIGH -> TRIGGER_ISO LOW. Firmware captures both edges.',10,95,1.0)
# --- Photodiode: passive sensor on the participant side of the system (no isolation); TIA, comparator with I2C-set threshold.
ev.txt('PHOTODIODE: passive sensor only (e.g. BPW34 on screen). Not isolated: participant-side circuit like the electrodes.',10,112,1.0)
ev.symbol('J2','J601','PHOTODIODE (K, A; part TBD)',25,140);ev.connect('J601',1,{1:'PHOTO_K_RAW',2:'GND'})
ev.symbol('ESD2','D601','TPD2E2U06DCKR',60,165,fp='Package_TO_SOT_SMD:SOT-323_SC-70',mpn='TPD2E2U06DCKR');ev.connect('D601',1,{1:'PHOTO_K_RAW',2:'PHOTO_K_RAW',3:'GND'})
ev.r('R610','1k',75,132,'PHOTO_K_RAW','PHOTO_SUM')
ev.symbol('TLV9061','U610','TLV9061IDBVR',130,145,fp=sot5,mpn='TLV9061IDBVR')
ev.connect('U610',1,{3:'PHOTO_REF',4:'PHOTO_SUM',5:'+3V3',1:'PHOTO_MONITOR',2:'GND'})
ev.r('R611','33k 0.1%',130,118,'PHOTO_SUM','PHOTO_MONITOR');ev.cap('C610','15p C0G',165,118,'PHOTO_SUM','PHOTO_MONITOR')
ev.r('R612','64.9k 1%',95,180,'+3V3','PHOTO_REF');ev.r('R613','1k 1%',130,180,'PHOTO_REF','GND');ev.cap('C611','100n',165,180,'PHOTO_REF')
ev.cap('C612','100n 10V X7R',200,180,'+3V3')
# Step 13: TI orderable code is TLV7011DCKR (SLVSDM5F); 'TLV7011IDCKR' does not exist. DCK pinout 1 OUT, 2 VEE, 3 IN+, 4 IN-, 5 VCC.
ev.symbol('TLV7011','U611','TLV7011DCKR',250,145,fp='Package_TO_SOT_SMD:SOT-353_SC-70-5',mpn='TLV7011DCKR')
ev.connect('U611',1,{3:'PHOTO_HYS',4:'PHOTO_THRESH',5:'+3V3',1:'PHOTO_CMP',2:'GND'})
ev.r('R614','10k',215,132,'PHOTO_MONITOR','PHOTO_HYS');ev.r('R615','1M',250,118,'PHOTO_CMP','PHOTO_HYS');ev.r('R616','100R',295,132,'PHOTO_CMP','PHOTO_EDGE')
ev.cap('C613','100n 10V X7R',290,180,'+3V3')
ev.symbol('MCP4725','U612','MCP4725A0T-E/CH (I2C 0x60)',250,205,fp='Package_TO_SOT_SMD:SOT-23-6',mpn='MCP4725A0T-E/CH')
ev.connect('U612',1,{4:'POWER_SDA',5:'POWER_SCL',6:'GND',3:'+3V3',1:'PHOTO_DAC',2:'GND'})
ev.r('R617','1k',300,200,'PHOTO_DAC','PHOTO_THRESH');ev.cap('C614','100n',320,215,'PHOTO_THRESH');ev.cap('C615','100n 10V X7R',200,215,'+3V3')
ev.txt('TIA: Vout = 50 mV + Iph x 33k, BW ~320 kHz. Threshold set by DAC after SAADC calibration on PHOTO_MONITOR; POR code 0 = no edges.',10,232,1.0)
