MariusFauteux/EEG-PCB/(commit log)

2026-11-08 Tidy project layout and documentation at Rev C4 (Step 7)
    Reorganise into docs/, hardware/ and host/. Rename the KiCad project
    to EEG_RevC and the generator/check scripts to build.py, validate.py
    and validate_controller.py; add hardware/rebuild.sh to regenerate the
    schematic and run all checks. Rewrite project.md for Rev C4 and add a
    current register to the decision log. Rebuilt netlist is identical in
    connectivity, values and footprints to the Step 7 export.
    [EEG_RevC.kicad_sch, adc_interface.kicad_sch, ads1299_core.kicad_sch, analog.kicad_sch, bom.csv, controller.kicad_sch, controller_pinmap.csv, debug_service.kicad_sch]
2026-11-08 Rev C6: compensate BIAS loop (Step 8) and add event timing (Step 9)
    Step 8 (Rev C5): replace the ADS1299 example BIAS feedback (1M || 1.5n)
    with lead-lag compensation 1M || (100k + 10n), raising the modelled
    phase margin from ~14 deg nominal to ~84 deg (>= 47 deg over 324 swept
    cases), and clamp the RB1/RB2 midpoint with a TPD2E2U06. Adds
    analyze_bias.py and the Step 8 review.
    Step 9 (Rev C6): clock the ADC from an external 2.048 MHz +/-20 ppm
    SiT8008 (internal oscillator is +/-0.5-2.5 %), add a TLP2761 optically
    isolated trigger input and a photodiode TIA/comparator front end with
    I2C-set threshold, and define single-timer timestamp capture with the
    event/1 EVENT schema. Adds analyze_timin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
    [EEG_RevC.kicad_sch, adc_interface.kicad_sch, ads1299_core.kicad_sch, analog.kicad_sch, bom.csv, controller.kicad_sch, controller_pinmap.csv, debug_service.kicad_sch]
2026-11-08 Rev C7: close deferred Step 4 power review (Step 10)
    - Raise analogue rail to 5.088 V (RSET 50.5k + 383R): release margin
    8.5 -> 45.9 mV, 47.6 mV below the ADS1299 5.25 V ceiling
    - Add persistent restart latch (U226-U228): SYS, pack or service fault
    clears RUN_ARMED; restart needs a new RUN_REQUEST rising edge
    - Replace reset/service AND gates with Schmitt-input SN74AUP1G08 and
    use 4.7k pull-ups so open-drain edges meet input transition limits
    - Select power capacitors: 22u 25V X7R 1210 LDO output, C0G delay caps
    - Add analyze_power.py (rail, threshold, delay, collapse and edge-rate
    envelope) to rebuild.sh; Step 10 netlist assertions against a
    Step 9 baseline; review doc and decisi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
    [EEG_RevC.kicad_sch, adc_interface.kicad_sch, ads1299_core.kicad_sch, analog.kicad_sch, bom.csv, controller.kicad_sch, debug_service.kicad_sch, digital_power.kicad_sch]
2026-11-08 Group schematic sheets into titled, annotated frames
    - Add layout pass (hardware/scripts/layout.py) run at the end of
    build.py: packs each sheet's parts into dashed frames per functional
    block with a title and purpose note, orients labels away from pins,
    and places capacitor values beside the body
    - Define groups, headings and curated sheet notes per sheet in
    layout_groups.py; build fails if a part has no group
    - Replace stale sheet notes (restart latch, integration status)
    - Arrange root sheet into acquisition, power and controller columns
    - Update README, project guide and decision log
    No circuit change: netlist identical before and after (230 nets),
    348 assertions pass, ERC 0 err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
    [EEG_RevC.kicad_sch, adc_interface.kicad_sch, ads1299_core.kicad_sch, analog.kicad_sch, controller.kicad_sch, debug_service.kicad_sch, digital_power.kicad_sch, event_inputs.kicad_sch]
2026-11-08 Untrack KiCad local history repository
    hardware/.history is KiCad 10's per-user editing history, created by
    the GUI. It was picked up as an embedded repository in 37ffac9; ignore
    it like the other per-user KiCad files.
2026-11-08 Rev C8: BQ25798 charger, power path and soft-off (Step 11)
    - New charger sheet: BQ25798 in VBUS-only configuration (2S, 1.5 MHz,
    1.0 uH), D+/D- unconnected, I2C 0x6B on the power bus
    - ILIM_HIZ hardware input ceiling 0.28-0.46 A (< 500 mA USB default);
    CE held high from REGN unless the MCU drives CHARGE_REQUEST
    - CSD17571Q2 ship FET for soft-off; POWER button on QON with BAT54
    sense to module pad 37 (POWER_HOLD repurposed as POWER_BUTTON_N)
    - Pack connector J401 (+, -, 103AT NTC) with TS window 1-60 C
    - SYS hold-up 5 x 22 uF + 100 uF OS-CON (~124 uF effective est.);
    VBUS bulk limited to one 10 uF for the USB Type-C sink limit
    - Remove J400 bench input and R381; pack monitors behind t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
    [EEG_RevC.kicad_sch, adc_interface.kicad_sch, ads1299_core.kicad_sch, analog.kicad_sch, bom.csv, charger.kicad_sch, controller.kicad_sch, controller_pinmap.csv]
2026-11-08 Rev C9: buffered shared REF and +5VA backfeed clamp (Step 12)
    Closes README open items 5 and 6 at schematic and calculation level.
    - D46: REF electrode drives an OPA376 follower (U500) through its own
    2 x 47k / TPD2E2U06 / 4.7k network; REF_BUF feeds JP1-JP8 pin 3.
    Modelled coupling -37.3 dB -> below -150 dB (8 ch, 100k, 100 Hz);
    SRB1 route evaluated and rejected (-31.5 dB).
    - D47: self-biased CSD17381F4 clamp (Q201/Q202, R208/R209) holds +5VA
    <= 1.3 V when the rail is off, including ship mode (was up to 6.9 V
    at 100 V between electrodes).
    - analyze_inputs.py extended with reference options and rules;
    new analyze_backfeed.py; both run from rebuild.sh.
    - validate.py: Step 12 asse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
    [EEG_RevC.kicad_sch, adc_interface.kicad_sch, ads1299_core.kicad_sch, analog.kicad_sch, bom.csv, charger.kicad_sch, controller.kicad_sch, debug_service.kicad_sch]
2026-11-08 Rev C10: exact BOM, footprint audit and corner review (Step 13)
    - Exact manufacturer part numbers for all 360 fitted parts (bom_parts.py);
    BOM gains manufacturer, MPN, description, DNP and population columns.
    - Project footprint library EEG.pretty generated from manufacturer drawings:
    BQ25798 RQM, TUSB320 RWB, CSD17381F4 YJC, CSD17571Q2 DQK, NINA-B306.
    - check_footprints.py: every symbol pin has a pad and every pad a pin;
    fixes USB-C and microSD shell pins (now SH) and Q400 exposed pads.
    - E96 values for RSET (49.9k + 1.00k, 5.090 V), ANALOG_OK and PACK_OK
    dividers; 10 uF/22 uF bulk caps to 25 V 1206/1210; TLV7011DCKR.
    - J500 electrode harness connector; J600 BNC shell pins on isolat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
    [EEG_RevC.kicad_sch, adc_interface.kicad_sch, ads1299_core.kicad_sch, analog.kicad_sch, bom.csv, bom_cost.csv, charger.kicad_sch, controller.kicad_sch]
2026-11-08 Rev C11: VBUS overvoltage protection and board placement (Step 14)
    Part A (closes D54): TPD1S514-1 OVP switch between the USB-C VBUS
    contacts and USB_5V, TPS7A2050 5.0 V LDO with BAT54 bypass for the
    module VBUS pad, USB sense from VBUS_POWER, second 10 uF on VBUS.
    Adds analyze_ovp.py, a Step 14 validate block and the WCSP footprint.
    Part B (resolves D55, revises D15): generated 110 x 85 mm one-sided
    4-layer board (JLC04161H-3313), JLCPCB rules and netclasses, antenna
    and 8 mm trigger keep-outs, planes and placement of all 375 parts.
    DRC clean apart from unrouted nets; schematic parity 0 differences.
    Schematic UUIDs are now deterministic. Decisions D56-D60.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
    [EEG_RevC.kicad_pcb, EEG_RevC.kicad_sch, adc_interface.kicad_sch, ads1299_core.kicad_sch, analog.kicad_sch, bom.csv, bom_cost.csv, charger.kicad_sch]
2026-11-09 Rev C12: datasheet review and electrode impedance test links
    Pin-by-pin review of the ADS1299 (SBAS499C), OPA376 (SBOS406G) and
    TPD2E2U06 (SLLSEG9C) connections; all pass. The ADS1299 lead-off
    excitation acts only at INxP/INxN, so the REF and BIAS electrodes could
    not be measured in Rev C11.
    D61: two normally open 2-pin links on the electrode side of the input
    networks. JP9 joins REF_RAW to E8N and JP10 joins BIAS_ELEC to E7N, so
    with JP8/JP7 at 1-2 either electrode is measured through that channel's
    own 94k / clamp / 4.7k network. No shunt combination joins REF_RAW to
    REF_BUF or bypasses a 94k network.
    validate.py adds a Step 14 netlist baseline comparison (only JP9/JP10
    added, no existin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
    [EEG_RevC.kicad_pcb, EEG_RevC.kicad_sch, adc_interface.kicad_sch, ads1299_core.kicad_sch, analog.kicad_sch, bom.csv, bom_cost.csv, charger.kicad_sch]
